Jack0468/ball_balance_video_controlled/host_software/ml_control/README.md

# ML Control

This directory contains experimental Machine Learning control policies, specifically focusing on Reinforcement Learning (RL) agents designed to balance the ball dynamically.

## Structure
- **`stm32_ctrl/`**: Work-in-progress code related to running inference or control loops on an STM32 microcontroller for ultra-low latency response.
