Jack0468/ball_balance_video_controlled/host_software/ml_jetson_vla/deployment/requirements-jetson-arm2-common.txt

# Arm 2 sweep, Jetson AGX Orin -- packages common to BOTH Arm 2 container images (2026-09-22, container
# pivot). Installed inside Dockerfile.arm2-transformers5 and Dockerfile.arm2-transformers4 (this
# directory), not a bare-metal venv -- see host_software/ml_jetson_vla/docs/JETSON_ARM2_SWEEP_LOCAL.md
# section 2. The earlier venv-based plan this file was originally written for is superseded: bare-metal
# wheel resolution failed repeatedly on-device this session (wrong wheel via --extra-index-url, a 20-30GB
# NGC image that exhausted disk), while `dustynv/l4t-pytorch:r36.4.0` gave a confirmed-working CUDA torch
# in one `docker run` with no bare-metal install at all. NOT a replacement for the root requirements.txt
# (never install that verbatim on the Jetson, see JETSON_ENV_SETUP.md); these packages are container-scoped
# and are not added to the root file either.
#
# NOT in this file, on purpose (each is handled by the Dockerfile itself, not a package list):
#   numpy              comes from the base image and is left exactly as it ships it. Each Dockerfile
#                      captures `pip freeze` of the base image as its first layer, BEFORE installing
#                      anything else, and installs everything below under that as a `-c` constraints file --
#                      pip can then only ADD packages, never silently upgrade numpy/torch/torchvision the
#                      way the bare-metal `lerobot` install once did (the ABI break in JETSON_ENV_SETUP.md).
#                      The old rule ("apt's python3-opencv needs numpy<2") was protecting a SHARED bare-metal
#                      host environment (Track 1's own numpy pin); that shared-environment risk does not
#                      exist inside an isolated container, so it is not reapplied verbatim here -- the real
#                      constraint, checked directly rather than assumed, is simply "don't move whatever
#                      numpy the base image already validated its CUDA torch build against."
#   torch/torchvision  already in the base image (confirmed: torch 2.4.0, `cuda.is_available()==True`, on
#                      this exact Jetson AGX Orin p3730, JetPack 6.2.3 / L4T r36.4). Neither this file nor
#                      either Dockerfile installs them.
#   opencv             NOT confirmed present in l4t-pytorch (a PyTorch-only image in the jetson-containers
#                      family; opencv is normally a separate stacked package there). Each Dockerfile checks
#                      for `cv2.aruco` first and pip-installs `opencv-contrib-python-headless` (under the
#                      base image's frozen numpy constraint, `--only-binary=:all:`) only if it's missing --
#                      see the Dockerfiles, not this file, for that step.
#
# HOW TO INSTALL: see Dockerfile.arm2-transformers5 / Dockerfile.arm2-transformers4 (this directory) and
# JETSON_ARM2_SWEEP_LOCAL.md section 2 for the exact build commands. Both Dockerfiles use the same
# `pip install -c <base image's own pip freeze> --only-binary=:all: -r <this file + the version-specific
# file>` form the old venv plan used -- the safety mechanism is unchanged, only the delivery vehicle is.
#
# Wheel availability, checked 2026-09-22 with `pip install --dry-run --report --python-version 3.10
# --implementation cp --abi cp310 --platform manylinux_2_17/2_28_aarch64 --only-binary=:all:` against PyPI
# (Ubuntu 22.04 = glibc 2.35): every package below, and every transitive dependency, resolves to a binary
# wheel for cp310 aarch64 -- av 17.x (manylinux_2_28, bundles ffmpeg), pandas 2.3.x (pandas 3 needs
# Python >= 3.11, so pip picks 2.3.x), pillow (manylinux_2_27/2_28), sentencepiece (manylinux_2_27),
# tokenizers / safetensors (abi3), psutil, PyYAML, regex, MarkupSafe. No --only-binary exception and no apt
# package is needed for any of them. (Wheel availability is not the same as "runs on the Orin": that is what
# the driver's probe/smoke stages are for.) Still expected to hold inside the container -- same aarch64
# cp310 target, same PyPI -- but not re-verified against the base image's exact pip/base-image date;
# `docker build` will fail loudly (not silently) if any wheel has since disappeared.

accelerate          # from_pretrained(device_map=...) for every candidate
qwen-vl-utils       # Qwen2.5-VL vision preprocessing (imports av + pillow + requests)
sentencepiece       # precautionary: Gemma tokenizer for PaliGemma2 (not proven strictly required)
av                  # PyAV: sequential rgb_video.mp4 decode (score_minimal_baseline_offline.read_frames_at_indices)
pandas              # telemetry.csv + result tables
pillow              # PIL.Image.fromarray in every backend

# torch's own runtime dependencies. The base image's torch build is expected to already carry these, but
# they are listed explicitly as a no-cost safety net (pip confirms-and-skips if already satisfied under the
# frozen constraints, installs from PyPI if genuinely missing). `pip check` at the end of each Dockerfile's
# install layer proves nothing is missing.
filelock
typing_extensions
sympy
networkx
jinja2
fsspec
