Jack0468/ball_balance_video_controlled/hardware/platform_templates/aruco_markers_00.pdf

Print at EXACTLY 100% scale. Do not ”Fit to Page”.

Cut along the outer black boundary (187.5 mm × 142.0 mm) and tape to the platform.
