Jack0468/ball_balance_video_controlled/host_software/ml_jetson_vla/docs/dependency_on_jetson_notes.md

## dependices on jetson download notes 

  Downloading transformers-5.3.0-py3-none-any.whl (10.7 MB)
     ━━━━━━━━━━━━━━━━━━━━━━━━━━━━━━━━━━━━━━━━ 10.7/10.7 MB 10.7 MB/s eta 0:00:00
  Downloading transformers-5.2.0-py3-none-any.whl (10.4 MB)
     ━━━━━━━━━━━━━━━━━━━━━━━━━━━━━━━━━━━━━━━━ 10.4/10.4 MB 11.9 MB/s eta 0:00:00
Collecting typer-slim
  Downloading typer_slim-0.24.0-py3-none-any.whl (3.4 kB)
Collecting transformers
  Downloading transformers-5.1.0-py3-none-any.whl (10.3 MB)
     ━━━━━━━━━━━━━━━━━━━━━━━━━━━━━━━━━━━━━━━━ 10.3/10.3 MB 8.3 MB/s eta 0:00:00
  Downloading transformers-5.0.0-py3-none-any.whl (10.1 MB)
     ━━━━━━━━━━━━━━━━━━━━━━━━━━━━━━━━━━━━━━━━ 10.1/10.1 MB 11.4 MB/s eta 0:00:00
  Downloading transformers-4.57.6-py3-none-any.whl (12.0 MB)
     ━━━━━━━━━━━━━━━━━━━━━━━━━━━━━━━━━━━━━━━━ 12.0/12.0 MB 11.8 MB/s eta 0:00:00
Collecting traitlets>=5.1
  Using cached traitlets-5.16.1-py3-none-any.whl (86 kB)
Collecting fastjsonschema>=2.15

  Downloading aiobotocore-2.6.0-py3-none-any.whl (73 kB)
     ━━━━━━━━━━━━━━━━━━━━━━━━━━━━━━━━━━━━━━━━ 73.4/73.4 KB 6.6 MB/s eta 0:00:00
  Downloading aiobotocore-2.5.4-py3-none-any.whl (73 kB)
     ━━━━━━━━━━━━━━━━━━━━━━━━━━━━━━━━━━━━━━━━ 73.4/73.4 KB 7.0 MB/s eta 0:00:00
INFO: pip is looking at multiple versions of s3fs to determine which version is compatible with other requirements. This could take a while.
Collecting s3fs>=2024.12.0
  Downloading s3fs-2025.10.0-py3-none-any.whl (30 kB)
  Downloading s3fs-2025.9.0-py3-none-any.whl (30 kB)

    Downloading s3fs-2025.2.0-py3-none-any.whl (30 kB)
  Downloading s3fs-2024.12.0-py3-none-any.whl (30 kB)
INFO: pip is looking at multiple versions of pyyaml-include to determine which version is compatible with other requirements. This could take a while.
INFO: pip is looking at multiple versions of python-xlib to determine which version is compatible with other requirements. This could take a while.
Collecting python-xlib>=0.17
  Downloading python_xlib-0.32-py2.py3-none-any.whl (181 kB)
     ━━━━━━━━━━━━━━━━━━━━━━━━━━━━━━━━━━━━━━━━ 181.9/181.9 KB 4.7 MB/s eta 0:00:00
  Downloading python_xlib-0.31-py2.py3-none-any.whl (179 kB)
     ━━━━━━━━━━━━━━━━━━━━━━━━━━━━━━━━━━━━━━━━ 179.0/179.0 KB 917.0 kB/s eta 0:00:00
INFO: pip is looking at multiple versions of python-multipart to determine which version is compatible with other requirements. This could take a while.
Collecting python-multipart>=0.0.26
  Downloading python_multipart-0.0.31-py3-none-any.whl (29 kB)
  Downloading python_multipart-0.0.30-py3-none-any.whl (29 kB)
INFO: pip is looking at multiple versions of pyperclip to determine which version is compatible with other requirements. This could take a while.
Collecting pyperclip>=1.9.0
  Downloading pyperclip-1.10.0-py3-none-any.whl (11 kB)
  Downloading pyperclip-1.9.0.tar.gz (20 kB)
  Preparing metadata (setup.py) ... done
INFO: pip is looking at multiple versions of pygments to determine which version is compatible with other requirements. This could take a while.
Collecting pygments>=2.7.2
  Downloading pygments-2.20.0-py3-none-any.whl (1.2 MB)
     ━━━━━━━━━━━━━━━━━━━━━━━━━━━━━━━━━━━━━━━━ 1.2/1.2 MB 1.6 MB/s eta 0:00:00
  Downloading pygments-2.19.2-py3-none-any.whl (1.2 MB)
     ━━━━━━━━━━━━━━━━━━━━━━━━━━━━━━━━━━━━━━━━ 1.2/1.2 MB 1.8 MB/s eta 0:00:00
INFO: pip is looking at multiple versions of pygit2 to determine which version is compatible with other requirements. This could take a while.
Collecting pygit2>=1.14.0
  Downloading pygit2-1.18.1-cp310-cp310-manylinux_2_27_aarch64.manylinux_2_28_aarch64.whl (5.8 MB)
     ━━━━━━━━━━━━━━━━━━━━━━━━━━━━━━━━━━━━━━━━ 5.8/5.8 MB 3.2 MB/s eta 0:00:00
  Downloading pygit2-1.18.0-cp310-cp310-manylinux_2_28_aarch64.whl (5.7 MB)
     ━━━━━━━━━━━━━━━━━━━━━━━━━━━━━━━━━━━━━━━━ 5.7/5.7 MB 3.5 MB/s eta 0:00:00
INFO: pip is looking at multiple versions of pydantic[email] to determine which version is compatible with other requirements. This could take a while.
Collecting pydantic[email]>=2.12.0
  Downloading pydantic-2.13.4-py3-none-any.whl (472 kB)
     ━━━━━━━━━━━━━━━━━━━━━━━━━━━━━━━━━━━━━━━━ 472.3/472.3 KB 12.4 MB/s eta 0:00:00
  Downloading pydantic-2.13.3-py3-none-any.whl (471 kB)
     ━━━━━━━━━━━━━━━━━━━━━━━━━━━━━━━━━━━━━━━━ 472.0/472.0 KB 12.4 MB/s eta 0:00:00
  Downloading pydantic-2.13.2-py3-none-any.whl (471 kB)
     ━━━━━━━━━━━━━━━━━━━━━━━━━━━━━━━━━━━━━━━━ 471.9/471.9 KB 12.6 MB/s eta 0:00:00
  Downloading pydantic-2.13.1-py3-none-any.whl (471 kB)
     ━━━━━━━━━━━━━━━━━━━━━━━━━━━━━━━━━━━━━━━━ 471.9/471.9 KB 12.2 MB/s eta 0:00:00
  Downloading pydantic-2.13.0-py3-none-any.whl (471 kB)
     ━━━━━━━━━━━━━━━━━━━━━━━━━━━━━━━━━━━━━━━━ 471.9/471.9 KB 14.4 MB/s eta 0:00:00
  Downloading pydantic-2.12.5-py3-none-any.whl (463 kB)
     ━━━━━━━━━━━━━━━━━━━━━━━━━━━━━━━━━━━━━━━━ 463.6/463.6 KB 13.4 MB/s eta 0:00:00
  Downloading pydantic-2.12.4-py3-none-any.whl (463 kB)
     ━━━━━━━━━━━━━━━━━━━━━━━━━━━━━━━━━━━━━━━━ 463.4/463.4 KB 13.5 MB/s eta 0:00:00
  Downloading pydantic-2.12.3-py3-none-any.whl (462 kB)
     ━━━━━━━━━━━━━━━━━━━━━━━━━━━━━━━━━━━━━━━━ 462.4/462.4 KB 14.6 MB/s eta 0:00:00
  Downloading pydantic-2.12.2-py3-none-any.whl (460 kB)
     ━━━━━━━━━━━━━━━━━━━━━━━━━━━━━━━━━━━━━━━━ 460.6/460.6 KB 14.3 MB/s eta 0:00:00
  Downloading pydantic-2.12.0-py3-none-any.whl (459 kB)
     ━━━━━━━━━━━━━━━━━━━━━━━━━━━━━━━━━━━━━━━━ 459.7/459.7 KB 12.3 MB/s eta 0:00:00
INFO: pip is looking at multiple versions of pydantic-settings to determine which version is compatible with other requirements. This could take a while.
Collecting pydantic-settings>=2.0.0
  Downloading pydantic_settings-2.14.2-py3-none-any.whl (61 kB)
     ━━━━━━━━━━━━━━━━━━━━━━━━━━━━━━━━━━━━━━━━ 61.7/61.7 KB 7.9 MB/s eta 0:00:00
INFO: pip is looking at multiple versions of s3fs to determine which version is compatible with other requirements. This could take a while.
INFO: pip is looking at multiple versions of pyyaml-include to determine which version is compatible with other requirements. This could take a while.
INFO: pip is looking at multiple versions of python-xlib to determine which version is compatible with other requirements. This could take a while.
INFO: pip is looking at multiple versions of python-multipart to determine which version is compatible with other requirements. This could take a while.
INFO: This is taking longer than usual. You might need to provide the dependency resolver with stricter constraints to reduce runtime. See https://pip.pypa.io/warnings/backtracking for guidance. If you want to abort this run, press Ctrl + C.
INFO: pip is looking at multiple versions of pyperclip to determine which version is compatible with other requirements. This could take a while.
  Downloading pydantic_settings-2.14.1-py3-none-any.whl (60 kB)
     ━━━━━━━━━━━━━━━━━━━━━━━━━━━━━━━━━━━━━━━━ 61.0/61.0 KB 5.1 MB/s eta 0:00:00
INFO: This is taking longer than usual. You might need to provide the dependency resolver with stricter constraints to reduce runtime. See https://pip.pypa.io/warnings/backtracking for guidance. If you want to abort this run, press Ctrl + C.
INFO: This is taking longer than usual. You might need to provide the dependency resolver with stricter constraints to reduce runtime. See https://pip.pypa.io/warnings/backtracking for guidance. If you want to abort this run, press Ctrl + C.
INFO: This is taking longer than usual. You might need to provide the dependency resolver with stricter constraints to reduce runtime. See https://pip.pypa.io/warnings/backtracking for guidance. If you want to abort this run, press Ctrl + C.
INFO: pip is looking at multiple versions of pygments to determine which version is compatible with other requirements. This could take a while.
  Downloading pydantic_settings-2.14.0-py3-none-any.whl (60 kB)
     ━━━━━━━━━━━━━━━━━━━━━━━━━━━━━━━━━━━━━━━━ 60.9/60.9 KB 5.2 MB/s eta 0:00:00
INFO: This is taking longer than usual. You might need to provide the dependency resolver with stricter constraints to reduce runtime. See https://pip.pypa.io/warnings/backtracking for guidance. If you want to abort this run, press Ctrl + C.
INFO: pip is looking at multiple versions of pygit2 to determine which version is compatible with other requirements. This could take a while.
  Downloading pydantic_settings-2.13.1-py3-none-any.whl (58 kB)
     ━━━━━━━━━━━━━━━━━━━━━━━━━━━━━━━━━━━━━━━━ 58.9/58.9 KB 5.5 MB/s eta 0:00:00
INFO: This is taking longer than usual. You might need to provide the dependency resolver with stricter constraints to reduce runtime. See https://pip.pypa.io/warnings/backtracking for guidance. If you want to abort this run, press Ctrl + C.
  Downloading pydantic_settings-2.13.0-py3-none-any.whl (58 kB)
     ━━━━━━━━━━━━━━━━━━━━━━━━━━━━━━━━━━━━━━━━ 58.4/58.4 KB 5.2 MB/s eta 0:00:00
  Downloading pydantic_settings-2.12.0-py3-none-any.whl (51 kB)
     ━━━━━━━━━━━━━━━━━━━━━━━━━━━━━━━━━━━━━━━━ 51.9/51.9 KB 4.3 MB/s eta 0:00:00
INFO: This is taking longer than usual. You might need to provide the dependency resolver with stricter constraints to reduce runtime. See https://pip.pypa.io/warnings/backtracking for guidance. If you want to abort this run, press Ctrl + C.
  Downloading pydantic_settings-2.11.0-py3-none-any.whl (48 kB)
     ━━━━━━━━━━━━━━━━━━━━━━━━━━━━━━━━━━━━━━━━ 48.6/48.6 KB 4.3 MB/s eta 0:00:00
INFO: pip is looking at multiple versions of pydantic[email] to determine which version is compatible with other requirements. This could take a while.
INFO: pip is looking at multiple versions of pydantic-settings to determine which version is compatible with other requirements. This could take a while.
  Downloading pydantic_settings-2.10.1-py3-none-any.whl (45 kB)
     ━━━━━━━━━━━━━━━━━━━━━━━━━━━━━━━━━━━━━━━━ 45.2/45.2 KB 3.9 MB/s eta 0:00:00
  Downloading pydantic_settings-2.10.0-py3-none-any.whl (45 kB)
     ━━━━━━━━━━━━━━━━━━━━━━━━━━━━━━━━━━━━━━━━ 45.2/45.2 KB 3.7 MB/s eta 0:00:00
  Downloading pydantic_settings-2.9.1-py3-none-any.whl (44 kB)
     ━━━━━━━━━━━━━━━━━━━━━━━━━━━━━━━━━━━━━━━━ 44.4/44.4 KB 3.6 MB/s eta 0:00:00
  Downloading pydantic_settings-2.9.0-py3-none-any.whl (44 kB)
     ━━━━━━━━━━━━━━━━━━━━━━━━━━━━━━━━━━━━━━━━ 44.3/44.3 KB 3.8 MB/s eta 0:00:00
  Downloading pydantic_settings-2.8.1-py3-none-any.whl (30 kB)
INFO: This is taking longer than usual. You might need to provide the dependency resolver with stricter constraints to reduce runtime. See https://pip.pypa.io/warnings/backtracking for guidance. If you want to abort this run, press Ctrl + C.
INFO: This is taking longer than usual. You might need to provide the dependency resolver with stricter constraints to reduce runtime. See https://pip.pypa.io/warnings/backtracking for guidance. If you want to abort this run, press Ctrl + C.
  Downloading pydantic_settings-2.8.0-py3-none-any.whl (30 kB)
  Downloading pydantic_settings-2.7.1-py3-none-any.whl (29 kB)
  Downloading pydantic_settings-2.7.0-py3-none-any.whl (29 kB)
  Downloading pydantic_settings-2.6.1-py3-none-any.whl (28 kB)
  Downloading pydantic_settings-2.6.0-py3-none-any.whl (28 kB)
  Downloading pydantic_settings-2.5.2-py3-none-any.whl (26 kB)
  Downloading pydantic_settings-2.5.1-py3-none-any.whl (26 kB)
  Downloading pydantic_settings-2.5.0-py3-none-any.whl (26 kB)
  Downloading pydantic_settings-2.4.0-py3-none-any.whl (23 kB)
  Downloading pydantic_settings-2.3.4-py3-none-any.whl (22 kB)
  Downloading pydantic_settings-2.3.3-py3-none-any.whl (22 kB)
  Downloading pydantic_settings-2.3.2-py3-none-any.whl (21 kB)
  Downloading pydantic_settings-2.3.1-py3-none-any.whl (21 kB)
  Downloading pydantic_settings-2.3.0-py3-none-any.whl (21 kB)
  Downloading pydantic_settings-2.2.1-py3-none-any.whl (13 kB)
  Downloading pydantic_settings-2.2.0-py3-none-any.whl (13 kB)
  Downloading pydantic_settings-2.1.0-py3-none-any.whl (11 kB)
  Downloading pydantic_settings-2.0.3-py3-none-any.whl (11 kB)
  Downloading pydantic_settings-2.0.2-py3-none-any.whl (11 kB)
  Downloading pydantic_settings-2.0.1-py3-none-any.whl (11 kB)
  Downloading pydantic_settings-2.0.0-py3-none-any.whl (11 kB)
Collecting pydantic>=2.9.2
  Downloading pydantic-2.14.0b2-py3-none-any.whl (484 kB)
     ━━━━━━━━━━━━━━━━━━━━━━━━━━━━━━━━━━━━━━━━ 484.6/484.6 KB 5.0 MB/s eta 0:00:00
INFO: pip is looking at multiple versions of pyasn1-modules to determine which version is compatible with other requirements. This could take a while.
Collecting pyasn1-modules>=0.2.1
  Downloading pyasn1_modules-0.4.1-py3-none-any.whl (181 kB)
     ━━━━━━━━━━━━━━━━━━━━━━━━━━━━━━━━━━━━━━━━ 181.5/181.5 KB 7.8 MB/s eta 0:00:00
  Downloading pyasn1_modules-0.4.0-py3-none-any.whl (181 kB)
     ━━━━━━━━━━━━━━━━━━━━━━━━━━━━━━━━━━━━━━━━ 181.2/181.2 KB 11.5 MB/s eta 0:00:00
  Downloading pyasn1_modules-0.3.0-py2.py3-none-any.whl (181 kB)
     ━━━━━━━━━━━━━━━━━━━━━━━━━━━━━━━━━━━━━━━━ 181.3/181.3 KB 11.2 MB/s eta 0:00:00
INFO: pip is looking at multiple versions of pyasn1-modules to determine which version is compatible with other requirements. This could take a while.
INFO: This is taking longer than usual. You might need to provide the dependency resolver with stricter constraints to reduce runtime. See https://pip.pypa.io/warnings/backtracking for guidance. If you want to abort this run, press Ctrl + C.
