Jack0468/ball_balance_video_controlled/host_software/ml_audio/docs/dataset_info_audio.md

## NOTES ON the SYNTHETIC+Real_image_dataset

OBSERVATION:
the dataset is corrupted

the following samples do not contain a full command:

e.g. "go"

en_US-lessac-medium__go_red__00071

e.g. does not have the completed signal of a label

"go re"
en_US-lessac-medium__go_red__00199
en_US-libritts_r-medium__go_red__00089
en_US-ryan-medium__go_red__00021
en_US-ryan-medium__go_red__00063

"red"

en_US-lessac-medium__go_red__00535
en_US-lessac-medium__go_red__00580

"empty clip"

real_speaker02__go_red__speaker02__go_red__001_018
real_speaker02__go_red__speaker02__go_red__002_002
real_speaker02__go_red__speaker02__go_red__002_006
