Jack0468/ball_balance_video_controlled/host_software/ml_audio/docs/plans/audio_eval_notebook_refactor_plan.md

# Audio Evaluation & Notebook Refactor Plan

## Data & Checkpoint Location (updated 2026-09-15: DVC is now live, superseding the section below)

**Corrected, superseding claim:** an earlier version of this section said the training dataset and every checkpoint were "0% tracked in git" with Drive as the de facto source of truth. That was accurate as of when it was written but is now stale -- a separate session (`vri-2026-be`) wired up DVC against the home server's MinIO remote (commit `e423e4a`), and `host_software/ml_audio/data.dvc` + `host_software/ml_audio/models.dvc` are now real, git-tracked pointer files (confirmed via `git ls-files`, not assumed from the commit message alone). `dvc pull host_software/ml_audio/data` on any machine with Tailscale + MinIO credentials now fetches the real ~20K-clip `training_v2/` dataset and every checkpoint the pointer was last updated against -- git alone is no longer missing the data, DVC is the actual fetch mechanism. `colab_nemo_finetune.ipynb` was updated in the same commit to `git clone` + Tailscale-bootstrap + `dvc pull` instead of the old `prepare_colab_package.py` zip-to-Drive flow (verified: cell 7's `HOST_SOFTWARE_DIR`/`sys.path` setup matches the old zip-extraction cell's variable names exactly, so every downstream import in this notebook, including this plan's `nemo_noise_manifest.py` addition, resolves unchanged). `drive.mount()` is kept only for the Lightning `ModelCheckpoint` crash-resilience path, not for data. Full policy: `docs/DATA_STORAGE.md`.

**`prepare_colab_package.py` is not dead code -- confirmed by checking, not assumed.** `colab_nemo_phase0_verification.ipynb` never touched the dataset at all (Phase 0 only exercises the stock pretrained checkpoint on dummy audio) so it's unaffected either way. `colab_augmentation_sweep.ipynb` (custom-CNN track) still imports the zip/Drive flow and has not been migrated to DVC -- it's still a live caller, so `prepare_colab_package.py` should stay until/unless that notebook is migrated too, which is a separate decision (that track is already deprioritized behind the NeMo track per the Verdict above, so there's no urgency either way).

**Open item, still not resolved by any of the above:** `updated dataset.zip` (repo root of `ml_audio/`, git-tracked directly -- not DVC -- committed 2026-07-24, before this plan's work started) is still raw `speaker02` source recordings, almost certainly the raw material behind the `real_speaker02__*` clips already baked into `training_v2/`. DVC going live doesn't resolve this on its own -- it's a plausible destination for this file once someone actually does the dedicated data-management pass the user deferred, not a reason to move it unilaterally now.

## Status
**The pretrained-backbone track has produced the best checkpoint in this entire plan, on both metrics that matter.** [`models/nemo_matchboxnet_v1/`](../../models/nemo_matchboxnet_v1/) (NeMo MatchboxNet, transfer-learned on our dataset -- see "Pretrained Backbone / Transfer Learning Track" below) hit 95.75% offline accuracy with no class collapse anywhere (including `go_red` at 94.6%, the class that kept collapsing in the custom-CNN track), and then **9/11 on the live-stream test** -- blowing past the 6/11 ceiling every custom-CNN checkpoint (v3-v7) hit, with `forward`/`left`/`right` all correctly detected simultaneously for the first time anywhere in this plan. This is the first checkpoint where live-stream performance is unambiguously better rather than diverging from offline accuracy, strong evidence the custom 13.5K-param CNN's capacity -- not the dataset/preprocessing work -- was the real ceiling all along.

Everything that came before this remains real, measured work, not superseded busywork: corruption audit + quarantine, evaluation-script extraction, the live receiver's label-order + preprocessing fixes, a full multi-seed Colab tuning sweep (v4 -> v5 -> v6), and closing the domain gap with real recordings (v7, 3 seeds, which confirmed a repeatable `go_red`/`hold` capacity-thrashing regression) are what led directly to trying a pretrained backbone in the first place.

**Update: the pretrained-backbone track's own 4-seed multi-seed check is now done too** (see "Live-Stream Result" below) -- `go_green` (confused with `go_grey`) and `backward` are confirmed real, repeatable weaknesses (4/4 seeds), not the single-run luck the original 9/11 result left open. `go_grey` itself has since been dropped from live-stream scoring entirely (the current robot deployment has no grey marker to test against) -- live-stream is now scored out of 10, not 11. **v4 remains the interim hardware recommendation** until the NeMo checkpoint clears its remaining open items: TensorRT/Jetson latency validation (not yet started), and a fix for the confirmed `go_green`/`backward` weaknesses (larger pretrained variant and/or noise-mixing our own recordings into fine-tuning are the two candidate next moves, not further seed-hunting). Building the training script also surfaced an important correction to an assumption made earlier in this same plan: see "Correction: the conv/batchnorm layers are NOT frozen/shared across checkpoints" below. Companion to [`.agents/agent_ml_audio.md`](../../../../.agents/agent_ml_audio.md).

## Context

`host_software/ml_audio/` was reactivated under Roadmap Phase 2 ("Audio Verification") to debug the known false-positive-on-background issue. Previously there was no persisted confusion matrix or evaluation artifact anywhere in the module — the team ran evaluation ad hoc inside a notebook and read the plot off-screen. On 2026-08-11 a run was captured (image, reproduced below as a table) that gives us the first real evidence to work from instead of impressions.

The evaluation method that produced this run lives in **`audio_command_classifier_aligned_before_deterministic_patch_final.ipynb`** — a single monolithic notebook (~3 MB, authored by a former lab partner) that combines dataset loading, augmentation, model definition, the training loop, and confusion-matrix generation (`tf.math.confusion_matrix`) in one file with no persisted output. This plan proposes breaking it apart, in the same spirit as the modular `core/` / `data_processing/` / `training/` / `evaluations/` / `tests/` / `docs/` convention already codified for `ml_vision` in `.agents/AGENTS.md`.

**Discrepancy, now resolved.** a prior read-only pass over this notebook found it hard-coded to exactly 6 classes (`["go_red","go_blue","go_green","go_yellow","hold","stop"]`, no `_background_`) and set to raise `ValueError` on any other label layout. The confusion matrix above is 12-class (includes `_background_`, `backward`, `forward`, `go_grey`, `left`, `right`). We now know why: the **12-class model and the large dataset that trained it (`data/synthetic+real_dataset_large/`) were produced by a *different, second* former lab partner's code — not the notebook above, and not the same person.** That generation code is not present in the repo and is not expected to surface.

**Decision: the dataset's on-disk file structure IS the ground truth, not a stand-in for missing code.** There is no script to locate or reconstruct — `data_processing/` will treat `synthetic+real_dataset_large/training_v2/{train,val}/<class_name>/*.wav` (12 class folders) directly as the contract to preserve and build tooling around. Do not extract/refactor code from the 6-class notebook as if it were the source of the 12-class run — the two are unrelated artifacts from two different people and both stay as read-only ground truth.

## Confusion Matrix — 2026-08-11 run (acc = 0.870, row-normalized)

Rows = true label, columns = predicted label, raw counts:

| true \ pred | _background_ | backward | forward | go_blue | go_green | go_grey | go_red | go_yellow | hold | left | right | stop | row total |
|---|---|---|---|---|---|---|---|---|---|---|---|---|---|
| **_background_** | 151 | 5 | 3 | 9 | 5 | 1 | 8 | 4 | 10 | 13 | 23 | 8 | 240 |
| **backward** | 1 | 117 | 0 | 0 | 0 | 0 | 1 | 0 | 1 | 0 | 0 | 0 | 120 |
| **forward** | 6 | 0 | 89 | 0 | 0 | 4 | 1 | 0 | 17 | 0 | 0 | 3 | 120 |
| **go_blue** | 0 | 0 | 0 | 222 | 17 | 1 | 0 | 0 | 0 | 0 | 0 | 0 | 240 |
| **go_green** | 1 | 0 | 0 | 1 | 238 | 0 | 0 | 0 | 0 | 0 | 0 | 0 | 240 |
| **go_grey** | 0 | 0 | 0 | 0 | 0 | 117 | 3 | 0 | 0 | 0 | 0 | 0 | 120 |
| **go_red** | 4 | 0 | 0 | 0 | 61 | 2 | 161 | 4 | 8 | 0 | 0 | 0 | 240 |
| **go_yellow** | 0 | 0 | 1 | 0 | 0 | 0 | 0 | 239 | 0 | 0 | 0 | 0 | 240 |
| **hold** | 1 | 0 | 35 | 0 | 0 | 3 | 0 | 0 | 195 | 0 | 0 | 0 | 234 |
| **left** | 1 | 1 | 0 | 0 | 0 | 2 | 0 | 0 | 2 | 113 | 0 | 1 | 120 |
| **right** | 0 | 0 | 1 | 0 | 0 | 6 | 0 | 0 | 3 | 0 | 110 | 0 | 120 |
| **stop** | 11 | 1 | 0 | 0 | 0 | 1 | 0 | 0 | 0 | 0 | 0 | 227 | 240 |

## Analysis — three distinct failure clusters, do not conflate

1. **Background leaks into movement commands (the reported issue, now quantified).** True `_background_` recall is only 151/240 = **62.9%** — over a third of background clips (89/240) get classified as some command. The leakage is not evenly spread: `right` (23), `left` (13), and `hold` (10) absorb most of it, while `go_grey`, `go_green`, `go_yellow` barely attract any background at all. This is the operationally dangerous case — ambient/robot noise producing an unintended motion command — and is consistent with the earlier finding that background training data is only ~9.5% of the train set, sourced from just 4 raw recordings. It does **not** explain clusters 2–3 below.

2. **`go_red` → `go_green` confusion (61/240 = 25.4%). Root cause now confirmed: dataset corruption, not feature-space overlap or mislabeling.** Large, specific, and one-directional (green does not reciprocally get called red — only 1/240 `go_green` errors exist). A manual audit ([`docs/dataset_info_audio.md`](../dataset_info_audio.md)) found the `go_red` folder in `synthetic+real_dataset_large/` contains **truncated and empty clips still labeled `go_red`** — samples containing only partial utterances ("go", "go re", "red") or no speech at all, across both synthetic TTS voices and real recordings. The label itself isn't wrong (these clips were genuinely intended as `go_red` commands), but the audio content is broken — training on truncated/empty "go_red" clips degrades that class's learned decision boundary, which is a direct, sufficient explanation for elevated `go_red` misclassification. This is unrelated to background balance and does not need a feature-space investigation — it needs a data-quality fix. See the new section below.

3. **`forward` ↔ `hold` bidirectional confusion** (`forward`→`hold` 17/120 = 14.2%; `hold`→`forward` 35/234 = 15.0%). Also independent of background balance — these two command classes appear to sit close together in feature space.

Minor, lower-priority: `go_blue` → `go_green` (17/240 = 7.1%, one-directional).

**Conclusion:** the background-noise/matched-filter fix (more diverse background sources, rebuilt noise profile — see prior planning discussion) should measurably improve cluster 1; the `go_red`/`go_green` fix is now a dataset-cleanup task (see below), not a training or architecture change; cluster 3 (`forward`/`hold`) remains unexplained and should get the same corruption audit before assuming it's a genuine feature-space problem. Track all three separately so a fix for one isn't mistaken for a fix for all.

## Dataset Corruption: `synthetic+real_dataset_large`

[`docs/dataset_info_audio.md`](../dataset_info_audio.md) documents a manual audit finding **the dataset is corrupted**, so far confirmed in the `go_red` class:

- **Truncated commands** — clips cut off mid-word or mid-phrase but still filed under the full `go_red` label, e.g. only "go" (`en_US-lessac-medium__go_red__00071`), only "go re" (`en_US-lessac-medium__go_red__00199`, `en_US-libritts_r-medium__go_red__00089`, `en_US-ryan-medium__go_red__00021`, `en_US-ryan-medium__go_red__00063`), or only "red" (`en_US-lessac-medium__go_red__00535`, `en_US-lessac-medium__go_red__00580`).
- **Empty clips** — no speech content at all, still labeled `go_red` (`real_speaker02__go_red__speaker02__go_red__001_018`, `..._002_002`, `..._002_006`).

**Dataset composition, inferred from filenames:** the `en_US-<voice>-medium` prefixes (`lessac`, `libritts_r`, `ryan`) are Piper TTS voice model names — so the "synthetic" half of `synthetic+real_dataset_large` is machine-generated speech from at least 3 distinct TTS voices. The `real_speakerNN` prefixes are recordings from actual human speakers (at least `speaker02` confirmed so far). This matches the `synthetic+real_dataset_large` directory name and matters for remediation: synthetic clips can likely be **regenerated cleanly** from the same TTS voice/text (fixing the corruption at the source), while corrupted real-speaker clips can only be **dropped or re-recorded**, not regenerated.

**Full-dataset audit complete (2026-08-11).** Built [`data_processing/audit_dataset_corruption.py`](../../data_processing/audit_dataset_corruption.py), which reuses the exact energy-gate thresholds from the production inference path (`align_speech_to_fixed_length` in `audio_receiver_pytorch.py`: `peak < 0.03` or `rms < 0.003` ⇒ "empty") for consistency, plus a per-class statistical-outlier check on active-speech duration (robust z-score via MAD) to catch truncation candidates without needing a transcript/ASR. Ran it across all 12 classes, both `train` and `val` (19,131 clips total). Full report: [`data_processing/reports/dataset_corruption_audit.json`](../../data_processing/reports/dataset_corruption_audit.json).

**Result: the "same kind of corruption throughout the dataset" hypothesis is not confirmed — it's concentrated, not uniform.** 367/19,131 clips flagged (1.9% overall), but split very unevenly:

| Class (train) | Total | Empty | Truncated | % flagged |
|---|---|---|---|---|
| `go_red` | 2100 | 82 | 22 | **5.0%** |
| `stop` | 2100 | 50 | 31 | **3.9%** |
| `hold` | 2094 | 56 | 2 | 2.8% |
| `go_blue` | 2100 | 4 | 0 | 0.2% |
| `left` | 600 | 0 | 2 | 0.3% |
| `backward`, `forward`, `go_green`, `go_grey`, `go_yellow`, `right` | — | 0 | 0 | **0%** |

(`val` split mirrors this pattern at smaller scale: `go_red` 1 empty, `left` 4 truncated, everything else clean. Full per-class table in the JSON report.)

So: `go_red` is confirmed as the worst offender (matches the manual audit and explains the confusion-matrix finding), `stop` and `hold` carry real but smaller corruption, and **6 of the 12 command classes have zero flagged clips**. This means the `go_red`↔`go_green` cluster is explained by `go_red`'s corruption specifically — `go_green` itself is clean, consistent with the one-directional confusion pattern already observed. It also means cluster 3 (`forward`/`hold`) is only *partly* explained: `hold` does carry some corruption (2.8%) but `forward` has none at all, so that confusion is more likely a genuine feature-space issue after all, not primarily a data defect — worth retesting after `hold`'s corrupted clips are cleaned, but don't expect it to fully close.

**One important caveat on `_background_`:** it also flagged high on the "empty" check (96/1290 train, 17/240 val, ~7.4%) — but this is a different phenomenon from the `go_red`-style defect, not the same corruption. A near-silent clip labeled `_background_` isn't mislabeled or broken the way a truncated `go_red` clip is; if anything it's *too* correct — real background noise during robot operation is not silent, so a background class skewed toward near-silence undertrains the model on the actual failure condition (concurrent motor/typing/impact noise). Track this under the background-diversification thread (`Larger Background/Noise-Profile Source` section below), not as dataset corruption to remediate the same way.

**Remediation applied (2026-08-11): quarantine, not regeneration.** Piper TTS (needed to regenerate the synthetic clips cleanly) isn't installed in the project env, and installing it plus downloading the 3 specific voice models (`lessac`, `libritts_r`, `ryan`) was judged disproportionate to fixing 1.9% of the dataset — so we quarantined instead of regenerated. [`data_processing/apply_dataset_quarantine.py`](../../data_processing/apply_dataset_quarantine.py) moved the 254 flagged non-background clips out of `training_v2/{split}/{label}/` into a sibling `data/synthetic+real_dataset_large/_quarantined_corrupt/{split}/{label}/` tree (move, not delete — reversible). `_background_` clips were explicitly excluded, per the caveat above. Manifest: [`data_processing/reports/quarantine_manifest.json`](../../data_processing/reports/quarantine_manifest.json).

| Class | Quarantined (train) | Quarantined (val) |
|---|---|---|
| `go_red` | 104 | 1 |
| `stop` | 81 | 0 |
| `hold` | 58 | 0 |
| `go_blue` | 4 | 0 |
| `left` | 2 | 4 |

**Verified clean:** re-ran `audit_dataset_corruption.py` after quarantine — every command class now scans at 0 empty / 0 truncated (18,877 clips remaining, only the untouched 113 `_background_` flags remain, tracked separately as above). Dataset is ready to retrain against once `training/train_audio_command_classifier.py` exists (step 3 below).

If 1:1 dataset-size restoration ever becomes worth it, the deferred option is: install `piper-tts`, download the matching voice checkpoints, and regenerate synthetic clips from source voice/text for the quarantined `en_US-<voice>-medium` files; quarantined `real_speakerNN` files can only be dropped or re-recorded, not regenerated. Not pursued now — re-run evaluation after retraining first to see whether it's even needed.

`audit_dataset_corruption.py` and `apply_dataset_quarantine.py` now live in `data_processing/` as standing QC/cleanup scripts — wire the audit check into the ingestion pipeline during step 4 of the refactor below so this doesn't silently recur as the dataset grows.

## Larger Background/Noise-Profile Source: 23-Minute Lab Recording

There is a longer general-lab-sounds recording available — roughly 23 minutes, currently unlabeled — that is a much richer background source than the short clips the noise profile and background training class currently draw from. **Confirmed: this is a new sample, not yet integrated into the dataset before** — distinct from `data/01_background_noise/lab_background_sound_01.wav` and the other existing files already in that directory. Those existing files were themselves recorded on different days, so `01_background_noise/` already has some session-level diversity going for it; the 23-minute recording is an additional, larger source to bring in on top of that, not a replacement or duplicate of anything already there.

It is not labeled at the granularity the classifier needs (i.e., not chopped into fixed-length clips with a class), but it can be:

- **Segment** it into fixed-length windows matching the model's input clip length (same framing the existing `_background_` clips use), producing many more background training/eval samples than the current ~1,290-clip pool.
- **Label at the segment level, not as one blanket clip.** A 23-minute "general lab sounds" recording almost certainly contains a mix of sub-conditions (silence/room tone, talking, footsteps, door/HVAC noise, equipment hum, possibly incidental typing or bench-work sounds). Spot-review segments and tag them — this doesn't require new *model* classes (per the earlier ball-drop/typing discussion, everything here still collapses to the single `_background_` class for training), but sub-tagging lets the eventual `evaluations/` tooling report background accuracy broken out by noise sub-type, which is exactly the resolution needed to tell whether the background fix is working uniformly or only on the easy cases.
- **Fold into, not replace, the existing sources** — it adds a new session/environment to the pool; the existing multi-day recordings stay in the mix too.

This work belongs in the `data_processing/` extraction (step 4 below), since it's dataset assembly, not a model or eval change.

## Evaluation Extraction — Done, and a New Finding: Production Preprocessing Doesn't Match Training/Eval

Built [`evaluations/evaluate_audio_classifier.py`](../../evaluations/evaluate_audio_classifier.py): loads `models/pytorch_v3/audio_command_classifier_state_dict_v3.pth` + `labels.json`, runs the val split, persists both raw counts (JSON) and a rendered heatmap (PNG) to `evaluations/reports/` on every run instead of vanishing off a screen. This closes the reproducibility gap that made the original confusion matrix un-followup-able.

**Getting it to reproduce the known acc=0.870 baseline surfaced a real bug, found by direct A/B testing.** The live inference path (`audio_receiver_pytorch.py`) diverges from how this model was actually trained/evaluated on four points simultaneously:

| Divergence | Effect on measured accuracy |
|---|---|
| `audio_receiver_pytorch.py` hardcodes its own 12-class label order, which is **not alphabetical** | Using it to interpret predictions collapses accuracy to ~7% |
| `align_speech_to_fixed_length`'s active-region crop (built for finding speech in a noisy rolling live buffer) | Costs ~7 points when applied to already-isolated, pre-cut dataset clips |
| Peak-renormalizing each clip to 0.95 | Costs ~2-3 points |
| Applying the spectral-subtraction noise profile at all | Costs ~30-40 points — it looks tuned for live mic/robot-noise, not clean dataset audio |

`models/pytorch_v3/labels.json` **is** alphabetical (the standard convention for scanning class folders — matches how the dataset folders are actually named/sorted), so it's the correct order; the receiver's hardcoded list is not. Reverting all four to the simple/matching form (`evaluate_audio_classifier.py`'s current defaults: alphabetical labels, direct pad/truncate, no renormalization, no noise profile) reproduces **86.3%** against the recorded 0.870 baseline — the ~0.7pt gap is fully explained by the 5 val clips removed during quarantine, not a remaining methodology error.

**This is a separate, likely-significant finding, not a data-quality issue:** if the deployed receiver really is decoding a 12-class checkpoint with the wrong label order and/or degrading input with the wrong preprocessing, that's a strong independent candidate explanation for "produces incorrect outputs during concurrent robot operation" — arguably more directly than the background-class imbalance this whole effort started from. Needs a decision on priority (see Open Questions).

**Caveat on the go_red/go_green numbers from this run:** this evaluation still used the original `v3` checkpoint, trained before the corruption quarantine — the quarantine only removed 254 clips from `training_v2` (mostly from `train`; only 1 `go_red` clip was in `val`), and training hasn't happened yet. Any change in the `go_red`/`go_green` split seen in this run's output vs. the original matrix reflects the corrected *evaluation methodology*, not the corruption fix. The corruption fix can only be measured once step 4 (training extraction + retrain) is done and this same evaluation script is re-run.

## Stage 1 Fix (Done): Label-Order Bug in the Live Receiver

Per the priority call above, tackled the smaller/unambiguous fix first, measured it, then moved to the bigger retrain track (step 4+). The label-order bug was a clean, low-risk fix (unlike the crop/renorm/noise-profile questions, which involve real design trade-offs for live streaming vs. offline clips and weren't touched here).

**Fix:** [`audio_receiver_pytorch.py`](../../audio_receiver_pytorch.py)'s `AudioCommandReceiver.__init__` now loads `labels.json` from the same directory as whatever checkpoint `model_path` points to, and uses that as the authoritative class order — matching how the model was actually trained (alphabetical, from scanning dataset class folders) instead of the hand-maintained list that had drifted out of sync for the 12-class case. Falls back to corrected (now-alphabetical) hardcoded lists only if no sibling `labels.json` exists, for older checkpoints that don't ship one. Confirmed the 7-class hardcoded fallback was already correct — only the 12-class one had drifted.

**Measured impact (same checkpoint, same otherwise-unchanged production-style preprocessing — active-region crop, peak renormalization, and spectral-subtraction noise profile all still applied, on val split):**

| Stage | Label order | Accuracy |
|---|---|---|
| Before (the bug) | receiver's hardcoded (wrong) order | 7.4% (169/2269) |
| After (this fix) | alphabetical, from `labels.json` | 47.9% (1086/2269) |

**+40.5 points from this one fix alone**, with everything else about the production pipeline untouched. Confirms this was a real, live bug — not just an artifact of the offline evaluation methodology — and that it was likely a significant contributor to "incorrect outputs during concurrent robot operation" on its own.

**Not yet closed:** 47.9% is still far below the 86.3% achieved with the idealized offline pipeline (no crop, no renorm, no noise profile). That gap is the second, harder piece — the crop/renorm/noise-profile mismatch — which is the next thing to work through, likely in tandem with the retrain track below rather than as a quick fix, since it involves an actual design decision (see Open Questions).

## Stage 2 Fix (Done, but Did Not Close the Real Gap): Simplify Live Preprocessing to Match Training

Decision: simplify the live receiver to match training (rather than retrain to match the receiver's crop/renorm/noise-profile pipeline). Implemented in [`audio_receiver_pytorch.py`](../../audio_receiver_pytorch.py): `_process_loop` now feeds the rolling audio buffer straight to `waveform_to_spectrogram` with no `align_speech_to_fixed_length` crop, no peak renormalization, and no noise-profile subtraction — the noise-profile loading code in `__init__` was removed outright rather than left dead. `min_confidence`/`min_margin` gating stays; that's a downstream accept/reject decision, not a preprocessing step, and doesn't need to match training.

**Cross-check before implementing:** `final_tester_audio.py`, a separate/legacy self-contained script, comments that its own crop+renormalize step is "same as the bronze -> silver step that built the train set" — which would have argued against this fix. Checked it before proceeding: its STFT uses n_fft=256 (129 freq bins), not the 255/128-bin convention `generate_noise_profile.py` and `audio_receiver_pytorch.py` actually use — even though its model class shapes are checkpoint-compatible with `v3.pth`. Since my empirical A/B testing already reproduced the known 0.870 baseline using the 255/128 convention (impossible if that convention were actually wrong, per how badly the wrong label order tanked accuracy), treated that comment as an unverified assumption from a disconnected/earlier script rather than counter-evidence, and proceeded.

**Offline per-clip result:** using this exact simplified pipeline is what already produced 86.3% in the evaluation-extraction section above (`evaluate_audio_classifier.py`'s defaults now match `_process_loop` exactly).

**Live continuous-stream result: only 4/11 (36%).** Built [`evaluations/evaluate_live_receiver_stream.py`](../../evaluations/evaluate_live_receiver_stream.py), which drives the actual `AudioCommandReceiver` (not a reimplementation) through `data/02_silver/master_evaluation_audio.wav` in its real file-playback mode — the same 11-command-at-10s-intervals sequence `create_master_audio.py` built, overlaid on looped background noise. Report: `evaluations/reports/live_stream_eval_20260811T033925Z.json`.

| t | expected | detected |
|---|---|---|
| 0s | go_grey | *(miss)* |
| 10s | go_blue | go_blue ✓ |
| 20s | go_green | *(miss)* |
| 30s | go_yellow | go_yellow ✓ |
| 40s | go_red | go_red ✓ |
| 50s | forward | *(miss)* |
| 60s | left | *(miss — detected go_red instead, a real misclassification)* |
| 70s | right | *(miss)* |
| 80s | backward | *(miss)* |
| 90s | hold | *(miss)* |
| 100s | stop | stop ✓ |

Looking at every command the receiver latched across the full 120s (not just the 11 target windows): it output `_background_` almost continuously — dozens of times throughout, including during windows where a command word is clearly present — with only 5 non-background detections in the entire stream. This is not a preprocessing-pipeline problem anymore; it's the original background-class issue this whole investigation started from (see "Background leaks into movement commands" in the confusion-matrix analysis above), now showing up directly: `master_evaluation_audio.wav` mixes background noise under every command, continuously, which is the realistic operating condition — and the model, trained on a background class that's only ~9.5% of the data from 4 source recordings, isn't robust to command-plus-noise mixtures at all. It defaults to background almost everywhere.

**Conclusion: Stage 1 + Stage 2 fixed two real, confirmed bugs (wrong label order, mismatched preprocessing) and both were worth fixing, but neither is the dominant lever on real-world performance.** The 86.3% clean-clip number was necessary to establish as a correct baseline, but it doesn't predict live behavior — noisy-condition performance is bottlenecked by the background-training-data problem identified back in the corruption/background-diversification sections. That makes the retrain track (steps 4-7, especially the background-diversification work with the 23-minute recording) the load-bearing fix, not an optional follow-on. Re-run `evaluate_live_receiver_stream.py` after that retrain to see if this closes.

## Correction: the conv/batchnorm layers are NOT frozen/shared across checkpoints

Before building the training script, the working assumption (based on `AudioCommandClassifier` in `audio_command_classifier_pytorch.py` registering its three conv/batchnorm blocks as `register_buffer` rather than `nn.Parameter`, with `forward()` always calling `F.batch_norm(..., training=False)`) was that these layers are a **frozen feature extractor exported once from the original 6-class model and reused unchanged across every checkpoint** — i.e. that the 12-class v3 checkpoint only differs from the 6-class original in its dense head, and "training" a new checkpoint would just mean fitting a linear classifier on top of those frozen 48-dim pooled features.

**This is false, and was caught by a round-trip check before it wasted a training run.** Direct comparison of `models/pytorch_v3/audio_command_classifier_state_dict_v3.pth` against the constants baked into `audio_command_classifier_pytorch.py` shows every conv/batchnorm buffer differs substantially, not just the dense head — e.g. `norm_variance` off by 21.9, `conv1_weight` off by 0.54 max-abs, `bn3_gamma` off by 1.5. Confirmed conclusively: applying v3's own trained dense head to features extracted from the *untouched baked-in* conv/bn buffers gives ~10% accuracy, vs. v3's real 86.3%. So whatever process produced v3 trained (or fine-tuned) the entire network, not just a dense head — consistent with the plan's existing finding that the 12-class checkpoint came from a second, unlocated lab partner's code, not the 6-class notebook's.

**Practical consequence:** `AudioCommandClassifier` itself can't be trained directly either way — it has no parameters, only buffers, and its BN is hardcoded to eval-mode. [`training/train_audio_command_classifier.py`](../../training/train_audio_command_classifier.py) defines a parallel `TrainableAudioCommandClassifier` module (real `nn.Conv2d`/`nn.BatchNorm2d`/`nn.Linear` layers, identical channel counts/kernel sizes/resize-to-64x64/global-average-pool architecture), trains it with standard backprop, then exports into `AudioCommandClassifier`'s buffer-keyed state-dict format — a drop-in-compatible checkpoint requiring zero changes to `evaluate_audio_classifier.py` or `audio_receiver_pytorch.py`.

**A second bug caught the same way, before it silently produced a wrong checkpoint:** the initial trainable-model draft used the conventional Conv→BatchNorm→ReLU layer order. `AudioCommandClassifier.forward()` actually applies **Conv→ReLU→BatchNorm** (unusual, but real — verified by reading the exact line order). A round-trip test (train a few real gradient steps, export, reload into `AudioCommandClassifier`, compare outputs on the same input) passed at first only because an *untrained* model's BN is near-identity, masking the ordering bug; re-running the same check after real gradient steps exposed a ~0.05 max-abs output divergence, which went to exactly 0.0 once the layer order was corrected to match. Lesson for any future work on this file: validate round-trip export/import fidelity **after** the model has actually been trained a few steps, not just on freshly-initialized weights — identity-initialized BN hides ordering bugs that only show up once its running stats move away from the default.

### Retrain results

**v4 — quarantine-cleaned dataset, no background diversification yet.** Trained from scratch (random init, 60 epochs, Adam, plain cross-entropy, no augmentation or class weighting — deliberately kept simple per the migration principle) on the same `training_v2/{train,val}` layout used throughout this plan, i.e. the corruption-quarantined dataset. Best val accuracy during training: 83.5% (epoch 38 of 60; train accuracy saturates near 100% by ~epoch 30, val bounces 73–83% after that — some overfitting, no early-stopping/regularization tuning attempted yet, this was a first-pass "does the pipeline work end-to-end" run, not a tuned one).

| Metric | v3 (pre-quarantine, old training code) | v4 (post-quarantine, this retrain) |
|---|---|---|
| Offline val accuracy (`evaluate_audio_classifier.py`) | 86.3% | 83.5% |
| Live-stream detections (`evaluate_live_receiver_stream.py`) | 4/11 | **6/11** |
| `_background_` recall | 62.9% (151/240) | **72.5%** (174/240) |
| `forward` recall | 74.2% | **92.5%** |
| `hold` recall | 83.3% | 62.0% (regressed) |
| `go_red` recall | 67.1% | 50.2% (regressed) |
| `go_red`→`go_green` rate | 25.4% | 17.2% (improved) |

Mixed at the per-class level — `hold` and `go_red` recall both regressed despite the corruption cleanup, likely because this is a from-scratch retrain with a much simpler/less-tuned procedure than whatever produced v3, not an apples-to-apples "same training, cleaner data" comparison. But the metric the plan has been chasing since the live-stream test was built — real detections in a continuous noisy stream — improved from 4/11 to 6/11, and just as importantly the failure mode changed: v3 had one outright *misclassification* (t=60s detected `go_red` instead of `left`); v4 has none — every miss is now "no detection" (background wins), not a wrong command. Full per-clip counts: [`evaluations/reports/confusion_matrix_20260811T092401Z.json`](../../evaluations/reports/confusion_matrix_20260811T092401Z.json); live-stream detail: [`evaluations/reports/live_stream_eval_20260811T101639Z.json`](../../evaluations/reports/live_stream_eval_20260811T101639Z.json).

### Background composition, quantified

Before segmenting the 23-minute recording, checked what the existing `_background_` class actually contains by filename convention (`bgreal_<source>__<split>__NNNNNN.wav` for real recordings vs. `<piper-voice>___background___NNNNN.wav` for synthetic TTS renders). Confirms and sharpens the plan's earlier "~9.5% of train set, from 4 raw recordings" estimate:

- Of 1290 train `_background_` clips, only **90 (7%)** are real recordings, and they come from just **2** source files (`robot_background_sound.wav`, `robot_background_sound_01.wav`), not 4.
- Of 240 val `_background_` clips, **zero** are real recordings — the entire val-set measurement of background recall (used throughout this plan, e.g. the 62.9%/72.5% figures above) has never once been tested against real ambient/robot noise, only near-silent synthetic TTS renders.
- `lab_background_sound_01.wav` — confirmed 23.3 minutes at 44.1kHz stereo (resampled to 16kHz mono for training) — had zero clips derived from it anywhere in the dataset before this session, confirming the plan's "not yet integrated" note.

## Background Diversification: 23-Minute Recording Segmented and Added

[`data_processing/segment_background_recording.py`](../../data_processing/segment_background_recording.py) segments a long unlabeled recording into fixed-length (1.25s / 20000-sample, 16kHz mono) `_background_` clips matching the existing `bgreal_*` naming and format exactly, filtering out near-silent windows with the same energy gate used everywhere else in this pipeline (`align_speech_to_fixed_length`'s peak<0.03 / rms<0.003 check) so this source doesn't just add more of the near-silence filler the dataset already has too much of.

Run against `lab_background_sound_01.wav`: 1117 candidate windows → 1057 kept (60 dropped as too quiet) → split 899 train / 158 val (15% val fraction, **deliberately putting real-noise clips into val for the first time** — see the composition finding above). Manifest: [`data_processing/reports/background_segmentation_20260811T104121Z.json`](../../data_processing/reports/background_segmentation_20260811T104121Z.json). This roughly 10x's the real-recording share of the background class (90 → 989 train clips from real sources) and, for the first time, gives the val-set background measurement actual noisy-condition coverage instead of only synthetic near-silence.

**v5 — same retrain procedure as v4, on top of the background-diversified dataset.** Trained the same way as v4 (60 epochs, same hyperparameters, only the dataset changed: +899 train / +158 val real-noise background clips). Best val accuracy: 84.9% (epoch 48).

| Metric | v3 (original) | v4 (quarantine + retrain) | v5 (+ background diversification) |
|---|---|---|---|
| Offline val accuracy | 86.3% | 83.5% | **84.9%** |
| `_background_` recall | 62.9% (151/240) | 72.5% (174/240) | **88.9%** (354/398) |
| `forward` recall | 74.2% | 92.5% | 67.5% (regressed vs. v4) |
| `hold` recall | 83.3% | 62.0% | 81.2% (recovered) |
| `go_red` recall | 67.1% | 50.2% | 54.8% (still down vs. v3) |
| Live-stream detections | 4/11 | **6/11** | 5/11 |

**Background diversification is not an unambiguous win, and this needs to be reported honestly rather than as a clean success story.** Offline, it's the best result on every headline number — `_background_` recall jumped another 16.4 points to 88.9%, and overall accuracy improved over v4. But the live-stream test — the metric the plan has explicitly treated as the one that "actually reflects the reported bug" since Stage 2 — went **backward**, 6/11 (v4) → 5/11 (v5), losing the `left` detection at t=60s that v4 had. Looking at v5's live-stream detection log: it produces noticeably fewer stray `_background_` detections than v4 (12 vs. 18 across the 120s stream, consistent with the offline recall gain), but in exchange it now fires spurious high-confidence `go_red` detections in three windows where `go_red` isn't the right answer (t≈0.5s during the `go_grey` window, t≈51.6s during `forward`, t≈71.9s during `right`) — `go_red` recall was already the weakest command class in both v4 and v5, and this looks like the same weakness manifesting as false positives instead of just false negatives now that background is a less likely competing answer. Full detail: [`evaluations/reports/confusion_matrix_20260811T111853Z.json`](../../evaluations/reports/confusion_matrix_20260811T111853Z.json), [`evaluations/reports/live_stream_eval_20260811T113143Z.json`](../../evaluations/reports/live_stream_eval_20260811T113143Z.json).

**Read with real caveats, not as a final verdict:** this is one training run per stage (no seed averaging), with a deliberately simple/untuned procedure (no augmentation, no class weighting, no regularization or early-stopping beyond keeping the best-val-accuracy epoch, fixed 60 epochs) — both v4 and v5 show the same overfitting pattern (train accuracy saturating near 100% by epoch ~30 while val bounces within a ~5-10 point band for the rest of training), so some of the v4→v5 live-stream difference could plausibly be training-run noise rather than a genuine causal effect of background diversification. The right next step before drawing a firm conclusion is a tuning pass (early stopping, class weighting — `go_red` in particular — mild augmentation) and/or multiple seeds per configuration, not simply picking v4 or v5 as "the" retrain result.

## Tuning Pass, Staged Through Colab

Per step 10 above, moved from single-shot local retrains to a proper tuning pass: augmentation, class weighting, weight decay, early stopping, multiple seeds. Local CPU can't afford the full sweep, so this is staged as local ablation (cheap, fast iteration, CPU) -> Colab GPU sweep (the real multi-seed run).

**Local augmentation ablation** ([`training/experiment_augmentations.py`](../../training/experiment_augmentations.py), [`training/audio_augmentations.py`](../../training/audio_augmentations.py)): pure numpy/scipy waveform augmentations (noise-mixing, speed perturbation, synthetic reverb, gain jitter, time-shift) -- no torchaudio/librosa available in the env, and none of these need more than numpy/scipy. Ran 25-epoch, single-seed, 30%-train-subset comparisons:

| Config | Best val acc |
|---|---|
| `light` (gain + time-shift) | 79.4% |
| `speed_perturb` | 77.5% |
| `combined_no_reverb` (follow-up) | 77.1% |
| `combined` (all 5, incl. reverb) | 76.5% |
| `baseline` (no augmentation) | 76.5% |
| `noise_mix` | 75.6% |
| `reverb` | **57.3%** |

**One clear, confident conclusion: drop reverb.** Consistently ~20 points behind everything else at every epoch, not just noise -- the synthetic room-impulse-response approximation (convolution with an exponentially-decayed noise kernel, since no real RIR dataset is available) is too aggressive or the wrong kind of distortion for this problem. Excluded from `PRESETS` in `audio_augmentations.py`.

**Everything else is genuinely inconclusive at this budget**, including a targeted follow-up (`combined_no_reverb`, i.e. combined minus just reverb: 77.1%, barely above baseline's 76.5%) -- differences of 1-4 points are within the noise already seen between epochs in the full v4/v5 runs. Notably `noise_mix` -- the augmentation most directly relevant to the actual live-stream problem -- underperformed baseline here but was still visibly climbing at epoch 25 with no plateau, the signature of an augmentation that needs more epochs to pay off, not one that doesn't work. This is exactly why the next step is a proper multi-seed sweep at full epoch budget, not another quick local guess.

**Portability refactor for Colab:** split pure DSP code (constants + the STFT transform) out of `audio_receiver_pytorch.py` into a new [`audio_dsp.py`](../../audio_dsp.py), since the training scripts were transitively importing `sounddevice` (needed only for live mic input, and requiring system PortAudio libs) just to get a sample-rate constant. Training now depends on nothing beyond torch/numpy/soundfile/scipy. Also vectorized the STFT computation (`batch_spectrograms` now runs one batched `torch.stft` call instead of looping per-sample) -- this model is small enough (~13.5K trainable params) that the per-sample Python loop was the actual bottleneck, not model compute; vectorizing dropped local per-epoch spectrogram cost by roughly 2.5x and is what makes a GPU worth using at all here (verified numerically identical output before/after, just faster).

**Production training script upgraded** (`training/train_audio_command_classifier.py`, still the single source of truth used both locally and in Colab): `--augmentation {none,light,speed,noise,combined}`, `--class-weights` (sklearn-style balanced weighting -- motivated by the real 3.3x count gap between the original 6 classes and the 5 movement classes added later, see "Correction" section above), `--weight-decay`, `--patience` (early stopping), `--device` (auto-detects CUDA). `--augmentation none` with no other flags reproduces the exact v4/v5 training behavior.

**Colab package**: [`data_processing/prepare_colab_package.py`](../../data_processing/prepare_colab_package.py) zips the training code + `training_v2/` dataset preserving the local `ml_audio/...` directory structure, so the notebook's imports and `DEFAULT_DATASET_ROOT` resolution work unchanged after extraction -- verified end-to-end (extract, import, discover 17507 train files) before treating it as ready. Output: 600.8MB / 19939 files, gitignored (`models/` and `*.zip` already excluded).

[`training/colab_augmentation_sweep.ipynb`](../../training/colab_augmentation_sweep.ipynb): loads the dataset once, then sweeps all 5 augmentation presets x 3 seeds (150 epochs, patience 20, class weighting + weight decay on throughout -- those aren't part of the ablation, the count-imbalance fix is a settled decision, not an open question) -- 15 runs total, reusing `train()` from the production script directly rather than reimplementing anything. Reports mean +/- std val accuracy per config (the number the local single-seed tests couldn't give), exports the single best checkpoint in the same `AudioCommandClassifier`-compatible format as v4/v5.

**Colab sweep run complete (2026-08-12), overnight, ~3.6 hours of GPU compute across all 15 runs.** Crash-resilience wasn't needed in the end (it completed in one session), but was built and verified before the run per the plan above.

| Config | Mean val acc (3 seeds) | Std | Best single seed | Avg s/epoch |
|---|---|---|---|---|
| `noise` | **88.52%** | 1.46% | 89.62% | 4.3s |
| `combined` | 87.75% | 0.39% | 88.05% | 21.8s |
| `speed` | 86.84% | 1.72% | 88.67% | 35.7s |
| `light` | 86.36% | 1.02% | 87.31% | 2.8s |
| `none` (baseline) | 85.32% | 1.01% | 86.20% | 2.1s |

**Noise-mixing wins clearly, exactly as the local ablation's climbing-not-plateaued val curve predicted.** At the 25-epoch local test budget, `noise` underperformed baseline (75.6% vs 76.5%) with a val curve still visibly rising -- the writeup at the time flagged this as "needs more epochs to pay off, not evidence it doesn't work," and a full budget with 3 seeds confirms that: `noise` beats every other config's *mean* by at least 0.8 points and beats baseline by 3.2 points, with the best individual run (`noise_seed0`, 89.6%) exceeding even the original pre-quarantine v3 baseline (86.3%). `speed` is a clear resource outlier -- 10-15x more expensive per epoch than everything else (likely `scipy.signal.resample`'s cost in an unvectorized per-sample augmentation loop) for a worse mean than `noise` -- not worth it as currently implemented; deprioritize or optimize before using it again.

**v6 = `noise_seed0` (89.62% offline), exported to `models/pytorch_v6/`.** Full v3-v6 comparison:

| Metric | v3 (original) | v4 (quarantine) | v5 (+ bg diversification) | v6 (+ noise-mix tuning) |
|---|---|---|---|---|
| Offline accuracy | 86.3% | 83.5% | 84.9% | **89.6%** |
| `_background_` recall | 62.9% | 72.5% | **88.9%** | 79.4% |
| `go_red` recall | 67.1% | 50.2% | 54.8% | **72.4%** |
| `hold` recall | 83.3% | 62.0% | 81.2% | **88.5%** |
| `forward` recall | 74.2% | **92.5%** | 67.5% | 88.3% |
| Live-stream detections | 4/11 | **6/11** | 5/11 | **6/11** |

**v6 is the best checkpoint produced so far by almost every offline measure** -- best overall accuracy, best `go_red` and `hold` recall of any checkpoint yet (both finally past v3's original numbers), second-best `forward` and background recall. **But it does not improve on the live-stream number** -- ties v4 at 6/11 rather than beating it, and the *way* it gets there is a step backward from v4's pattern: v4's 5 misses were all "no detection" (background wins, the safe failure mode); v6 has two real misclassifications instead (`go_red` detected during the `left` window, `stop` detected during the `backward` window), the same kind of regression flagged for v5. v6's live-stream detection log also shows background firing far more often (~70+ times across 120s) than v4's ~18 -- consistent with its lower offline background recall (79.4% vs v5's 88.9%), plausibly because training-time noise-mixing teaches the model that noise-plus-command should resolve to the *command*, making it less willing to default to background broadly, including on some genuinely-background val/live audio. Reports: [`evaluations/reports/confusion_matrix_20260812T205731Z.json`](../../evaluations/reports/confusion_matrix_20260812T205731Z.json), [`evaluations/reports/live_stream_eval_20260812T210001Z.json`](../../evaluations/reports/live_stream_eval_20260812T210001Z.json).

**Third data point for the same pattern now:** v5 and v6 each improved offline metrics substantially over their predecessor while *not* improving (v5: regressing; v6: flat, with a worse failure mode) the live-stream number. Offline val accuracy on isolated, pre-cut clips is clearly not a reliable proxy for continuous-noisy-stream performance for this model/dataset -- any future change should be judged primarily on `evaluate_live_receiver_stream.py`, not `evaluate_audio_classifier.py`, even though the latter is far cheaper to run. The live-stream ceiling has now sat at 6/11 across two different checkpoints (v4, v6) produced by two different mechanisms (label-order/preprocessing fixes; full retrain + noise-mix tuning) -- worth treating as a real signal that something structural is capping it there, not just an artifact of either specific run.

## v7: Real Recordings for the 5 Synthetic-Only Classes

Recorded (by the user, per the plan above) and ingested. Raw bronze recordings at `data/01_bronze_jack/` -- 8 files, one per label (`forward` had 2 usable takes after dedup, see below), each containing several spoken repetitions.

**Built [`data_processing/ingest_bronze_command_recordings.py`](../../data_processing/ingest_bronze_command_recordings.py)** to segment these into the same fixed-length clip format as the rest of `training_v2`:
- **De-duplication first:** `forward` had the same ~71s take saved 3 times (stereo original + 2 mono re-exports, one byte-identical to the other) -- caught automatically by a same-length + high-correlation check, not hardcoded to specific filenames, so this generalizes to future recording batches.
- **Voice-activity segmentation:** per-frame RMS-in-dB, Otsu-thresholded (auto-adapts to each file's own level), gaps under 250ms bridged (avoids splitting a word at an internal dip), runs under 150ms dropped (breath/click noise), margin added matching `align_speech_to_fixed_length`'s convention (80ms pre / 120ms post).
- **Per-label MAD-based duration outlier check** (same 3.0 multiplier as `audit_dataset_corruption.py`) caught 5 segmentation mistakes across the batch, including one clear one: a 3.18s segment in `left_jack_0.wav` where two repetitions merged (pause between them was under the 250ms bridge threshold) -- correctly excluded rather than silently truncated to 1.25s (which would have kept only whichever word came first).
- **Found and fixed a real gain-mismatch bug before it corrupted the ingest:** the bronze recordings were ~7x quieter (median segment peak ~0.045) than the existing `real_speakerNN` clips (~0.30) and the synthetic TTS clips (~0.57-0.60). This first showed up as ~20% of legitimate speech segments getting wrongly flagged "empty" by the standard energy gate (calibrated for the louder existing data). The deeper concern wasn't just lost data -- if left uncorrected, all 5 movement classes would have been *systematically* quieter than every other class in the dataset, risking the model learning "quiet audio" as a shortcut for "movement command" with no connection to the actual spoken content. Fixed with **one constant gain multiplier for the whole batch** (computed from median RMS against a sample of existing real clips, clamped so the loudest segment in the batch doesn't clip) -- deliberately *not* the kind of per-clip adaptive renormalization Stage 2 already found harmful for live inference (that renormalizes noise/silence up to full-scale too; a single session-level constant doesn't).
- Result: **160 real clips** across the 5 classes (`backward` 25, `forward` 30, `go_grey` 38, `left` 37, `right` 30), split 85/15 train/val, written as `real_jack__<label>__<split>__NNNNNN.wav` matching the existing `real_speakerNN` naming convention. Manifest: [`data_processing/reports/bronze_ingest_20260813T113806Z.json`](../../data_processing/reports/bronze_ingest_20260813T113806Z.json).
- **Validated with the standing tools, not just eyeballed:** re-ran `audit_dataset_corruption.py` across the whole dataset afterward -- all 5 classes come back 0 empty / 0 truncated in both train and val.

**Retrained v7** on top of this (locally, not Colab -- a single run at this dataset size now takes ~27 min thanks to the vectorized STFT, no need for GPU/Drive-upload overhead for one run): `--augmentation noise` (the sweep's winner), class weighting, weight decay, early stopping -- the same recipe v6 used, only the dataset changed. Best val accuracy 87.2% (early-stopped at epoch 66, best at epoch 46).

| Metric | v4 | v5 | v6 | v7 |
|---|---|---|---|---|
| Offline accuracy | 83.5% | 84.9% | 89.6% | 87.2% |
| `go_red` recall | 50.2% | 54.8% | **72.4%** | 41.8% (regressed sharply) |
| `forward` recall | 92.5% | 67.5% | 88.3% | 73.4% (regressed) |
| `left` recall | -- | -- | -- | **95.9%** |
| `go_grey` recall | -- | -- | -- | **98.4%** |
| `hold` recall | 62.0% | 81.2% | 88.5% | **98.7%** |
| Live-stream detections | **6/11** | 5/11 | **6/11** | 5/11 |

**Genuinely mixed, not a clean win -- and one regression is serious enough to flag prominently rather than average away.** The domain-gap theory gets real, direct support: `left` and `go_grey` -- two of the five classes that just went from 0% to real human recordings -- are now detected correctly in the live-stream test *simultaneously* for the first time across every checkpoint tried (v3-v6 never got both at once), and both show >95% offline recall. `hold` also improved further. But `go_red` recall **collapsed** from 72.4% (v6) to 41.8% -- the sharpest single-class regression seen anywhere in this whole retrain track -- with new leaks to `go_yellow` (10.9%), `hold` (19.2%), and `left` (7.9%) that didn't exist before. `forward` also regressed (88.3% -> 73.4%). Live-stream detection count lands at 5/11, tying v5, below the 6/11 v4 and v6 both reached -- though *how* it gets there looks different and arguably safer: only 9 total non-background detections across the full 120s stream (vs. v6's ~70+), essentially zero spurious `_background_` firing, and only 2 of its 6 misses are actual misclassifications (`go_red`, `backward`) rather than safe no-detections. Reports: [`evaluations/reports/confusion_matrix_20260813T221128Z.json`](../../evaluations/reports/confusion_matrix_20260813T221128Z.json), [`evaluations/reports/live_stream_eval_20260813T221414Z.json`](../../evaluations/reports/live_stream_eval_20260813T221414Z.json).

**Multi-seed check done (seeds 1, 2, same dataset/recipe) -- go_red's collapse is confirmed real, not single-run noise.**

| | seed 0 | seed 1 | seed 2 | v6 (for reference) |
|---|---|---|---|---|
| Offline accuracy | 87.2% | 87.7% | 87.9% | 89.6% |
| `go_red` recall | 41.8% | 46.9% | 46.9% | 72.4% |
| `left` recall | 95.9% | 99.2% | 98.3% | -- |
| `go_grey` recall | 98.4% | 99.2% | 96.8% | -- |
| `forward` recall | 73.4% | 95.2% | 91.9% | 88.3% |
| Live-stream | 5/11 | **6/11** | 4/11 | 6/11 |

All three seeds land `go_red` recall in a tight 42-47% band, nowhere near v6's 72.4% -- this rules out single-run noise as the explanation. **The failure mode is also identical across all three seeds, not just the magnitude:** in every case the dominant leak is `go_red` -> `hold` specifically (19%, 36%, 30% of go_red clips respectively -- 2-5x any other single confusion), not a diffuse spread across classes. That consistency is itself informative: this looks like a real, structural shift in the decision boundary between `go_red` and `hold`, triggered by adding the new movement-class recordings, even though neither `go_red`'s nor `hold`'s own training data changed at all between v6 and v7. With a model this small (~13.5K params, a 48-dim pooled feature space feeding a linear head), added diversity in other classes apparently costs capacity somewhere else rather than being absorbed for free -- consistent with the open question already on record about whether this architecture is simply too small for the number of distinctions it's being asked to make.

`left` and `go_grey` offline recall is excellent and consistent across all three seeds (95.9-99.2%), so that part of the domain-gap theory holds up well under multi-seed scrutiny, not just as a one-off. `forward` is mostly strong offline too (seed 0's 73.4% now looks like the outlier, not seeds 1/2's 92-95%) -- but **`forward`/`right`/`backward` never once register a correct live-stream detection across any of the 3 seeds**, despite `forward`'s good offline recall in 2 of 3 runs. That's the clearest remaining sign the offline/live-stream gap for this pipeline isn't fully explained by the domain-gap fix alone.

Live-stream itself is highly variable across seeds (4/11, 6/11, 4/11) -- about as wide a spread as separates the best (v4/v6, 6/11) and worst (v5, 5/11) checkpoints seen anywhere in this plan, from nothing but a different random seed on the identical dataset/recipe. That's a useful calibration point on its own: single live-stream-eval numbers for any past checkpoint (v3-v6, each measured on one seed) should be read with a +/-1-detection error bar, not as exact.

**Verdict: do not deploy v7 (any seed) to hardware.** The `go_red` regression is confirmed, real, and consistent -- not resolved by picking a different seed, since all three share it. Interim hardware recommendation stays **v4** (still the cleanest live-stream failure mode of any checkpoint produced in this plan). The domain-gap fix is directionally validated (`left`/`go_grey` genuinely improved and held up across seeds) but isn't a finished win: it needs to be combined with a fix for the new `go_red`/`hold` confusion before the next candidate for deployment. Options worth trying next, roughly in order of effort: (1) more real `go_red` recordings specifically, to re-anchor its decision region now that the feature space has shifted; (2) reduce or drop class weighting (it was on by default for both v6 and v7; the sweep never actually tested class-weighting on vs. off in isolation, only augmentation choice with weighting always on -- worth an ablation); (3) investigate whether the model's small capacity is a hard ceiling here, which would point toward an architecture change rather than more data/tuning.

**Also pending:** the user is recording additional real human samples for the 5 currently-100%-synthetic movement classes (`forward`/`backward`/`left`/`right`/`go_grey`) separately. Once available, fold them into `training_v2/` (matching the existing `real_<speaker>__<label>__...` naming convention already used for the original 6 classes) and repackage/retrain -- this directly targets the domain-gap finding, likely a bigger lever than any augmentation choice, and should be tracked as its own measured stage rather than bundled into the same retrain as the augmentation sweep result.

## Pretrained Backbone / Transfer Learning Track (Exploratory, Parallel to the Custom-CNN Track)

Motivated by the confirmed, repeatable `go_red`/`hold` capacity-thrashing found in v7's multi-seed check above -- with a model this small (~13.5K params), diversity added for one class costs accuracy on an unrelated one. Idea: fine-tune a small *pretrained* speech-command backbone instead of continuing to hand-tune the from-scratch custom CNN, so the model starts from features that already understand clean-speech/noisy-speech/non-speech structure rather than learning that from our comparatively small dataset alone.

**Confirmed the FPGA/HLS export path (`export_audio_weights.py`, referenced in `readme.md`) is legacy/deprecated for audio -- the Jetson AGX Orin 64GB (p3730) is the only real deployment target now.** (Corrected 2026-09-12: earlier notes in this section said "Jetson Orin Nano" -- that was never the right name; `CLAUDE.md`'s actual compute target for large-model deployment is the AGX Orin 64GB dev kit, Ampere with Tensor Cores, a substantially more generous budget than the Nano-class framing implied. Doesn't change the phased plan below, but does mean model-size headroom was underestimated throughout Phase 0/1 planning.) This matters: it rules out nothing on capability grounds, since a pretrained backbone has no realistic HLS/C-header export story the way the tiny hand-rolled CNN does.

**Model choice: NVIDIA NeMo's MatchboxNet family, pretrained on Google Speech Commands** -- not a general-purpose model (Wav2Vec2, YAMNet, Whisper). Verified directly against NVIDIA's own docs/NGC pages before committing to this, not assumed from memory:
- `commandrecognition_en_matchboxnet3x1x64_v2` / `commandrecognition_en_matchboxnet3x2x64_v2` are real, loadable via `nemo_asr.models.EncDecClassificationModel.from_pretrained(...)`.
- MatchboxNet at the 3x2x1 scale runs ~93K parameters / ~767KB compressed / 97.3% accuracy on the 35-class Speech Commands v2 benchmark -- still comfortably edge-appropriate (has to share the Jetson with the vision pipeline) while giving ~7x the capacity of the current custom CNN.
- NeMo models export to ONNX via the standard `Exportable` mixin's `.export()` method; ONNX -> TensorRT is NVIDIA's own documented Jetson deployment path -- same company, same hardware family, purpose-built for this task category (short command words, background/silence as a class).

**Phased plan, in order, each phase gating the next:**
1. **De-risk the deployment path first** (before any fine-tuning investment) -- verify a stock pretrained checkpoint actually loads, exports to ONNX, and the ONNX graph reproduces the source model's output.
2. **Fine-tune on our existing dataset** -- `training_v2/` doesn't change at all, this track is orthogonal to all the dataset work already done. Needs a manifest-format adapter (NeMo expects JSON-lines with `audio_filepath`/`duration`/`label`) but no new data collection.
3. **Evaluate with the same discipline this plan already earned the hard way** -- offline confusion matrix *and* the live continuous-stream test, multiple seeds. Offline accuracy has now been shown three separate times (v5, v6, v7) not to predict live-stream performance for this problem; no reason to assume that stops being true with a different backbone.
4. **Quantize and validate on real Jetson hardware** -- ONNX validity doesn't guarantee acceptable on-device latency/power; needs actual measurement (or accurate JetPack-level simulation), budgeted against whatever headroom the vision pipeline leaves on the shared SoC.
5. **Decision point, not a foregone conclusion** -- compare against the best custom-CNN checkpoint on accuracy, live-stream performance, and resource footprint before deciding whether to switch what's deployed. Keep the custom-CNN track's best checkpoint (currently v4) as the deployed baseline throughout; this is a parallel exploration given it's a bigger infrastructure lift with more unknowns.

**Phase 0 (de-risking) complete -- the deployment path is real and verified, not just documented.** [`training/colab_nemo_phase0_verification.ipynb`](../../training/colab_nemo_phase0_verification.ipynb) run in Colab (NeMo has Linux-only dependencies -- `pynini`, `nemo_text_processing` -- impractical to install natively on this Windows dev machine). Found and fixed three real issues along the way, each worth recording since they'd otherwise resurface in Phase 1-4:

1. **Device mismatch.** The pretrained checkpoint auto-loads onto Colab's GPU; the notebook's dummy input tensors didn't follow. Fixed by reading the model's actual device (`next(model.parameters()).device`) rather than assuming CPU.
2. **The exported ONNX graph's only input is a precomputed log-mel-spectrogram `(batch, 64, time)`, not raw waveform.** `.export()` only traces the encoder+decoder; NeMo excludes the preprocessor from the graph. This mirrors our own custom-CNN pipeline's split (STFT computed in `audio_dsp.py`, separate from the neural net) -- confirms the eventual Jetson-side deployment will need its own feature-extraction step ahead of the ONNX/TensorRT engine, the same shape of problem already solved once for the custom model, not a new one.
3. **A cross-check false alarm from double-dither, not a real export bug.** NeMo's feature extraction applies dither (small random noise before the STFT, standard in ASR pipelines) even in eval mode. The first cross-check attempt called `model.preprocessor(...)` independently to build both the "PyTorch reference" and the "ONNX input," drawing two different random dither perturbations -- producing a spurious max-abs-diff of ~0.35 that looked like a real divergence. Fixed by computing the mel features exactly once and deriving the PyTorch reference (`logits_ref`) by running the encoder/decoder directly on that same tensor. After the fix: **max abs diff = 0.000002** -- floating-point noise, export path confirmed sound.

**Verdict: proceed to Phase 1 (fine-tuning on our own dataset).** The checkpoint loads cleanly, exports to ONNX, and the ONNX graph is numerically faithful to the source PyTorch model. What's still unverified and needed before any deployment decision: actual TensorRT engine build + latency/power measurement on real Jetson AGX Orin 64GB hardware (ONNX validity doesn't guarantee acceptable on-device performance), and -- the real unknown -- fine-tuned accuracy/live-stream performance on our 12-class dataset, since this checkpoint is pretrained on a different 35-class vocabulary.

**Phase 1 (fine-tuning) built, not yet run.** Confirmed the fine-tuning API against NVIDIA's docs before writing anything (manifest format, `change_labels()` for swapping the decoder to our 12 classes while keeping the pretrained encoder, the `train_ds`/`validation_ds` config pattern) -- same "verify before building" discipline Phase 0 already validated is worth the extra step.

- [`training/nemo_manifest.py`](../../training/nemo_manifest.py): builds NeMo's one-JSON-object-per-line manifests from `training_v2/`. Deliberately kept NeMo-free (only needs `soundfile`) so it's testable locally without touching Colab -- **tested locally**: 17,646 train / 2,448 val entries, counts matching v7's dataset exactly, valid JSON, file paths resolve. Manifest generation happens at Colab-execution time (not baked into the data package) since `audio_filepath` has to match wherever the dataset actually lands after extraction.
- [`training/colab_nemo_finetune.ipynb`](../../training/colab_nemo_finetune.ipynb): loads the Phase-0-verified checkpoint, swaps its decoder for our alphabetical 12-class label list (asserted to match, not assumed, after `change_labels()`), fine-tunes at a lower LR than the pretrained recipe with early stopping on val accuracy (same overfitting discipline the custom-CNN track needed), builds our own full confusion matrix rather than trusting NeMo's aggregate val-accuracy metric alone (the go_red/hold confusion in v7 would have been invisible to a single scalar), and exports both `.nemo` and ONNX. Checkpoints persist to Drive via a Lightning `ModelCheckpoint` callback rather than a hand-rolled callback, since training here goes through `trainer.fit()` rather than our own epoch loop -- same crash-resilience intent as the augmentation sweep's Drive-persisted progress, using the framework's native mechanism instead of reimplementing it.
- **Needs a freshly rebuilt data package** before running -- the existing `ml_audio_colab_package.zip` predates the real `jack` recordings added for v7; re-run `prepare_colab_package.py` first.

**Phase 1 run -- offline result is the best of any checkpoint in this entire plan, by a wide margin.** Ran into three real API mismatches getting there (not guessed -- each pinned down against a live diagnostic or the actual traceback before patching, same discipline as Phase 0):

1. NeMo's current `EncDecClassificationModel` inherits `setup_training_data`/`setup_validation_data` from `EncDecSpeakerLabelModel` without overriding them, so the keyword args are `train_data_layer_config`/`val_data_layer_config`, not `train_data_config`/`val_data_config` (the class itself is correct and `change_labels()` worked fine on the first try -- the error message just names the class that *defines* the inherited method, not the instance's own class, which briefly looked like a much bigger problem than it was).
2. `import pytorch_lightning as pl` fails an `isinstance` check at `trainer.fit()` -- NeMo's current models subclass `lightning.pytorch.LightningModule` (the renamed/unified package), not the legacy standalone `pytorch_lightning` package. Two similarly-named but distinct classes.
3. The `EarlyStopping`/`ModelCheckpoint` callbacks' `monitor="val_acc"` doesn't exist in this version's logged metrics; `val_acc_micro_top_1` is what matches the accuracy definition used everywhere else in this plan (correct/total, i.e. micro -- confirmed from the actual list of available metrics in the error message, not guessed, since `val_acc_macro` weights every class equally regardless of sample count and wouldn't be comparable to any v3-v7 number).

**Result: 95.75% offline accuracy (2344/2448), best of any checkpoint by a wide margin (previous best: v6's 89.6%).**

| Class | Recall | Best prior (custom CNN) |
|---|---|---|
| `go_red` | **94.6%** | 72.4% (v6) -- the class with the confirmed, repeatable `go_red`->`hold` collapse across all 3 v7 seeds |
| `backward` | **100%** | 97.5% (v4) |
| `forward` | 98.4% | 92.5% (v4) |
| `hold` | 91.5% | 88.5% (v6) |
| `_background_` | 87.4% | 88.9% (v5, the only prior checkpoint to beat this) |
| `left` / `go_grey` / `right` / `stop` / `go_blue` / `go_green` / `go_yellow` | 96-99.6% | -- |

**The headline finding: `go_red` no longer collapses.** That class went 67.1% (v3) -> 50.2% (v4) -> 54.8% (v5) -> 72.4% (v6) -> ~42-47% across all 3 v7 seeds (the confirmed capacity-thrashing regression) -> **94.6%** here. No class shows anything resembling that collapse pattern in this checkpoint. Directly consistent with the capacity-thrashing hypothesis the v7 multi-seed check pointed at: a ~75K-param pretrained backbone doesn't fight itself for representational room the way the 13.5K-param custom CNN did when asked to absorb more class diversity. Also notable: the pretrained recipe's inherited augmentor config was already applying white-noise injection (probability 1.0) and small time-shifts automatically, without any explicit configuration on our part -- convergent with `noise` being the winning augmentation in the custom-CNN sweep, not a coincidence.

Artifacts organized into the existing convention: [`models/nemo_matchboxnet_v1/`](../../models/nemo_matchboxnet_v1/) (`.nemo`, ONNX, and the raw Lightning `.ckpt`), confusion matrix report alongside every other checkpoint's in [`evaluations/reports/nemo_finetune_confusion_matrix_20260824T011522Z.json`](../../evaluations/reports/nemo_finetune_confusion_matrix_20260824T011522Z.json). ONNX export re-verified locally (structurally valid, input `(batch, 64, time)` matching Phase 0's finding, output correctly resized to 12 classes) rather than trusted from the Colab log alone.

**Same discipline as every other checkpoint in this plan applies here too: offline accuracy has diverged from live-stream performance three separate times already (v5, v6, v7).** This 95.75% is genuinely the best result produced so far, but it is not yet evidence of anything on the actual failure mode (concurrent robot operation / continuous noisy stream) this whole investigation started from.

## Live-Stream Result: 9/11, the Best Result in This Entire Plan

Built [`evaluations/nemo_live_receiver.py`](../../evaluations/nemo_live_receiver.py) (mirrors `AudioCommandReceiver`'s threading/buffer/gating harness exactly -- same window size, step interval, confidence/margin thresholds -- swapping in NeMo's own forward pass since its MFCC preprocessing differs from the custom CNN's) and [`evaluations/evaluate_nemo_live_receiver_stream.py`](../../evaluations/evaluate_nemo_live_receiver_stream.py). Factored the receiver-agnostic scoring/report logic out of `evaluate_live_receiver_stream.py` into [`evaluations/live_stream_eval_common.py`](../../evaluations/live_stream_eval_common.py) so both tracks are scored by the literal same code, not just similarly-shaped copies -- **verified this refactor changed nothing** by re-running it against v4 and confirming a bit-for-bit identical result (6/11, same exact hits/misses) before trusting it for anything new.

**Correction to a claim repeated throughout this plan: NeMo installs fine locally on this Windows machine.** Every prior NeMo step (Phase 0, Phase 1 fine-tuning) ran in Colab specifically because `nemo_toolkit` was assumed to need Linux-only dependencies (`pynini`, `nemo_text_processing`) -- that assumption was never actually tested here and turned out to be wrong for the `[asr]` extra specifically (those packages are for TTS/text-normalization collections we don't use). `pip install "nemo_toolkit[asr]"` in a fresh `nemo_local` conda env (Python 3.10, isolated from `ball_balance_env` rather than risking the working environment) installed cleanly -- CPU-only PyTorch, which is fine for inference on a ~75K-param model even without a local GPU. This means the live-stream evaluation (and any future NeMo inference/evaluation work) can run locally like every other evaluation script in this plan, without a Colab round-trip.

**One more bug caught locally before it reached the live-stream test:** `model.labels` is `None` after `EncDecClassificationModel.restore_from(...)` -- it's only populated as a side effect of calling `setup_training_data()`, not persisted in the saved checkpoint. The real label order is in `model.cfg.labels` (confirmed to agree with `cfg.train_ds.labels`, `cfg.validation_ds.labels`, and the decoder's `num_classes` before trusting it). `nemo_live_receiver.py` reads labels from there instead.

**Result: 9/11 expected commands correctly detected**, run locally against the same `master_evaluation_audio.wav` stream every checkpoint in this plan has been scored against:

| t | expected | detected |
|---|---|---|
| 0s | go_grey | OK |
| 10s | go_blue | OK |
| 20s | go_green | **MISS** (misclassified as `go_grey`, twice) |
| 30s | go_yellow | OK |
| 40s | go_red | OK |
| 50s | forward | **OK** |
| 60s | left | **OK** |
| 70s | right | **OK** |
| 80s | backward | MISS (no detection) |
| 90s | hold | OK |
| 100s | stop | OK |

This blows past the 6/11 ceiling every custom-CNN checkpoint hit (v4, v6) -- and critically, `forward`/`left`/`right` are all correctly detected **simultaneously** for the first time anywhere in this plan; no v3-v7 checkpoint, including any of the 3 v7 seeds specifically aimed at fixing these classes, ever got all three at once. Only 2 misses, one of which (`go_green`->`go_grey`) is a genuine misclassification rather than a safe non-detection -- still a much cleaner failure profile than v6's ~70 stray background firings and multiple misfires. Report: [`evaluations/reports/live_stream_eval_20260824T015753Z.json`](../../evaluations/reports/live_stream_eval_20260824T015753Z.json).

**Verdict: the pretrained-backbone track is now the clear leader on both metrics that matter (95.75% offline, 9/11 live-stream), not just offline accuracy alone.** This is the first checkpoint in the entire plan where the live-stream result is unambiguously, dramatically better rather than diverging from or barely matching the offline result -- strong, now twice-confirmed (once per metric) evidence that the custom 13.5K-param CNN's capacity was the real ceiling, not the dataset or preprocessing work that came before it.

**Multi-seed check done (4 seeds total via the notebook's `SEED` parameter) -- `go_green` and `backward` are confirmed real, repeatable weaknesses, not single-run noise:**

| t | expected | seed 0 | seed 1 | seed 2 | seed 3 |
|---|---|---|---|---|---|
| 0s | go_grey | OK | OK | OK | OK |
| 10s | go_blue | OK | MISS | OK | OK |
| 20s | go_green | **MISS** | **MISS** | **MISS** | **MISS** |
| 30s | go_yellow | OK | OK | OK | OK |
| 40s | go_red | OK | OK | OK | OK |
| 50s | forward | OK | OK | OK | OK |
| 60s | left | OK | OK | OK | OK |
| 70s | right | OK | MISS | MISS | OK |
| 80s | backward | **MISS** | **MISS** | **MISS** | **MISS** |
| 90s | hold | OK | OK | MISS | MISS |
| 100s | stop | OK | OK | OK | OK |
| **Total** | | **9/11** | **7/11** | **7/11** | **8/11** |

`go_green`/`go_grey` and `backward` fail in all 4 of 4 seeds now -- as confirmed as this kind of finding gets without literally infinite seeds, a real structural weakness rather than noise. `right` sits at 2 of 4 (genuinely ambiguous, not clearly real or noise). `go_blue` at 1 of 4 looks like a one-off. `hold` is the one worth watching, not yet concluding on: fine in the first two seeds, missed in the last two -- could be coincidence at n=4, could be an emerging pattern; would need more seeds to tell, not worth chasing on its own before the `go_green`/`backward` fixes are tried. Offline accuracy stayed tight across all 4 seeds too (95.3-96.5%, no class collapse anywhere), reinforcing that live-stream's wider spread (7-9/11) is about live/continuous-noise conditions specifically, not a shaky checkpoint -- the same offline/live-stream gap lesson this plan keeps re-learning, just at a much higher baseline this time. All 4 seeds' checkpoints organized under `models/nemo_matchboxnet_v1[_seedN]/`, reports under `evaluations/reports/`.

**Diagnosed *why* the two confirmed failures happen** (built [`evaluations/nemo_stream_probe.py`](../../evaluations/nemo_stream_probe.py), which logs every window's raw prediction/confidence/margin rather than only what passes the gate -- ruled out a threshold-tuning fix before considering anything bigger):
- **`go_green` -> `go_grey`:** the model never predicts `go_green` at all during that window -- it confidently predicts `go_grey` instead (up to 96.5%). Not a borderline miss; a specific, confident acoustic confusion between two genuinely similar-sounding words.
- **`backward`:** the model almost never rises above `_background_` during that window -- a few weak (<0.52 confidence) flickers toward unrelated classes, never anything resembling `backward`. Looks like noise-masking, not confusion with a specific wrong word. Consistent with `backward` still having the fewest real recordings (22) of any class and no noise-mixing augmentation tuned to our own robot/lab noise profile.
- Checked whether the `go_green`/`backward` source recordings in `master_evaluation_audio.wav` (from `data/01_evaluation_samples/`) are simply bad clips before assuming a model/data problem -- peak/RMS/active-duration for both are solidly mid-pack against the other 9 command samples in that folder, not obvious outliers. Doesn't rule out subtler quality issues undetectable without actually listening, but rules out the simple "one dud recording" explanation.

**Scope change: `go_grey` dropped from live-stream scoring going forward** -- the current robot deployment has no grey marker to test against. `EXPECTED_SEQUENCE` in [`evaluations/live_stream_eval_common.py`](../../evaluations/live_stream_eval_common.py) now has 10 entries instead of 11 (still spoken in the stream audio itself, just not graded) -- future live-stream scores are out of 10, not 11. Doesn't change any conclusion above: `go_grey` passed 3/3 seeds before being dropped.

**Not yet done:** TensorRT engine build + real Jetson AGX Orin 64GB latency/power measurement (Phase 0 only verified ONNX export, not on-device performance) -- the one remaining unknown before this could actually be deployed. Given `go_green`/`backward` are now confirmed with 4 independent seeds rather than suspected, the next real lever is trying the larger `matchboxnet3x2x64` pretrained variant and/or noise-mixing our own background recordings into fine-tuning specifically targeting these two classes, not further seed-hunting.

## Scaling Up: `matchboxnet3x2x64` Variant Support (2026-09-12)

Per `model-iteration-constraints` (read before touching the notebook): checked the locked constraints first. The FPGA BRAM/DSP limits in `CLAUDE.md` don't apply here -- audio's deployment target is the Jetson AGX Orin 64GB (p3730) via ONNX/TensorRT, not FPGA, and that target is a substantially larger compute budget than the "Jetson Orin Nano" framing this section used until the correction above -- there was never a real size constraint pushing toward `3x1x64` specifically, just an unexamined assumption. `3x2x64` is NVIDIA's next size step in the same NGC family, loadable via the identical `from_pretrained()`/`change_labels()` path Phase 0 already verified for `3x1x64` -- no new deployment-path risk to de-risk separately.

**Notebook changes** ([`training/colab_nemo_finetune.ipynb`](../../training/colab_nemo_finetune.ipynb)): added `MODEL_VARIANT` ("3x1x64" or "3x2x64") alongside `SEED`. Per the "isolate the variable you're testing" and "version, don't overwrite" constraints: every downstream path (Drive checkpoint dir, exported `.nemo`/`.onnx`, confusion-matrix/live-stream report filenames) is now variant-suffixed, and switching `MODEL_VARIANT` changes nothing else in the notebook -- same manifests, same labels, same dataset, same training recipe. That keeps a `3x2x64` vs `3x1x64` comparison a clean architecture ablation rather than a confound with a data change. Also fixed the stale "Jetson Orin Nano" references in this notebook's own "Not yet done" cell to the correct AGX Orin 64GB target.

**Not run yet -- this was infrastructure, not a training run.** Per "never rank architectures from a small seed count" (this project has already had a 3-seed ranking overturned at 5 seeds, twice), before treating any `3x2x64` result as better or worse than `3x1x64`'s existing 4-seed baseline: `3x1x64` needs a 5th seed to close out its own ranking, and `3x2x64` needs its own >=5-seed run, not a 1-seed spot check compared against `3x1x64`'s 4-seed average. That's roughly 9 additional Colab fine-tuning runs (~each comparable in cost to the existing seed0-3 runs) before a real verdict — a real time/compute cost worth the user knowing about up front, not discovering mid-sweep.

**Calibrating the "99% accuracy" goal honestly, before spending that compute:** this plan has three separate confirmed findings that a bigger model is unlikely to fully erase, and the target should be set with those in mind rather than as a round number:

- `go_green`/`go_grey` is a confident, specific acoustic near-homophone confusion (the model doesn't hedge -- it predicts `go_grey` at up to 96.5% confidence during `go_green` windows), not a capacity-limited toss-up. A `3x1x64`-vs-custom-CNN jump (13.5K -> ~93K params) fixed a *different* capacity-linked problem (`go_red`/`hold` thrashing) but has not touched this one across 4 seeds. More capacity might help it learn a finer distinction, or might not, since the two words are acoustically close regardless of model size -- this is squarely an empirical question the `3x2x64` run should answer, not a assumed win.
- `backward`'s failure looks like noise-masking (confidence never rises above `_background_`, no confusion with a specific wrong word) rather than an acoustic-confusion or capacity problem -- the literature-motivated fix for this is more/better noise-mixing during fine-tuning (Item 4 from the original 4-item diagnostic list), not necessarily a bigger model. Worth trying alongside `3x2x64`, not instead of it, since they target different failure modes.
- Offline accuracy has diverged from live-stream performance at every single stage of this plan (v5, v6, v7, and now the NeMo track's own 95.3-96.5% offline vs. 7-9/10 live-stream spread) -- a 99% figure needs to specify *which* metric, and a 99% *offline* number would not, on this plan's own track record, be strong evidence of a 99% *live-stream* number.
- **Realistic target, stated the same way this plan calibrated expectations earlier:** a stable 9-10/10 live-stream result, reproducible across >=5 seeds, with `go_green`/`backward` specifically improved (not just overall accuracy) -- not a round 99% on any single offline number.

## Scaling-Up Result: `3x2x64` Does Not Fix `go_green`/`backward` -- Confirmed at >=5 Seeds Each (2026-09-13)

Ran the sweep this section called for: `3x1x64` seed4 + seed59 (bringing that variant to **6 seeds total**, past the >=5 threshold), and `3x2x64` seeds 0-4 (**5 seeds**, its first ranking-eligible batch). Organized into `models/nemo_matchboxnet_v1_seed{4,59}/` (3x1x64, matching the existing `_seedN` convention) and `models/nemo_matchboxnet_3x2x64_seed{0-4}/` (new variant, deliberately not reusing `v1` naming per the plan above); reports into `evaluations/reports/`.

**First correction to an assumption made when this section was written: `3x2x64` is barely bigger than `3x1x64`, not a meaningful capacity jump.** The notebook's own `n_params` print (added specifically so this wouldn't be guessed) shows **77,859 params for fine-tuned `3x1x64`** and **93,411 for fine-tuned `3x2x64`** -- a ~1.2x difference, not the "next size step up" this section implied going in. Worth remembering for any future "try a bigger model" instinct on this NGC family specifically: the naming (`3x1x64` vs `3x2x64`) suggests a bigger jump than the real parameter count delivers.

| | 3x1x64 (6 seeds: 0,1,2,3,4,59) | 3x2x64 (5 seeds: 0-4) |
|---|---|---|
| Params (fine-tuned) | 77,859 | 93,411 |
| Offline accuracy (mean) | 95.76% (94.93-96.45% range) | 95.30% (94.24-96.49% range) |
| Live-stream (mean, out of 10) | 7.0/10 (6-8 range) | 6.2/10 (6-7 range) |

**Note on the live-stream numbers above:** the Colab package used for this sweep still had the pre-`go_grey`-exclusion `live_stream_eval_common.py` baked in (every new report scored `/11` with `go_grey` still in `EXPECTED_SEQUENCE`, not the current local `/10`) -- another instance of the stale-package pattern this plan has hit twice before. Didn't invalidate anything this time: `go_grey` passed in all 11 new runs (7 new + the 4 already on record), so the table above simply subtracts 1/1 to convert to the current `/10` convention, which is exact, not an approximation. Still: **rebuild and re-upload the Colab package before the next NeMo run**, so this doesn't have to be corrected by hand again.

**Verdict: offline accuracy and live-stream score are both within the seed-noise band already established for this checkpoint family (this plan's own prior finding: live-stream needs a +/-1-detection error bar) -- no real separation between the two variants on either metric.** Neither variant should be preferred over the other on this data alone.

**The actual headline finding is per-class, not aggregate, and it's decisive:**

| Class | 3x1x64 (6 seeds) | 3x2x64 (5 seeds) | Combined |
|---|---|---|---|
| `go_green` | 0/6 (MISS every seed) | 0/5 (MISS every seed) | **0/11 -- fails in literally every run of either variant** |
| `backward` | 0/6 | 0/5 | **0/11 -- same** |
| `right` | 2/6 | 2/5 | 4/11 (36%) -- leans toward a real, if partial, weakness, more than the earlier "genuinely ambiguous" read at n=4 |
| `hold` | 4/6 | 2/5 | 6/11 (55%) -- still genuinely inconclusive |
| `go_blue` | 5/6 | 3/5 | 8/11 (73%) -- mostly fine, occasional miss |

**`go_green` and `backward` now fail in 11 out of 11 runs across two different model sizes at the same family.** This is about as strong as evidence gets without literally exhausting the search space: scaling within the MatchboxNet NGC family (at least across this ~1.2x range) does not touch either failure. This empirically confirms exactly what the calibration section above predicted rather than assumed -- `go_green`/`go_grey` is a genuine acoustic near-homophone confusion the model doesn't hedge on (not a capacity gap), and `backward` is noise-masking (also not primarily a capacity problem). **Recommendation: stop scaling this family further and move to the other candidate fix -- noise-mixing our own background recordings into fine-tuning, targeting `backward` specifically** (the original diagnostic list's item 4). `go_green`/`go_grey` doesn't have an obvious data-side fix from what's been tried so far and may need a closer look at whether the two classes are separable at all from short command-word audio alone, independent of model choice.

**Interim hardware recommendation is unchanged: still the NeMo `3x1x64` track (best live-stream ceiling of 9/11 at seed0, best confirmed offline accuracy), not `3x2x64`** -- the larger variant has produced no seed that beats `3x1x64`'s best, at ~20% more parameters for no measured benefit. `3x2x64` checkpoints are kept for reference, not recommended for further tuning effort ahead of `3x1x64`.

## Production Integration Check (2026-09-15): NOT a Drop-In ONNX Swap -- Caught Before It Shipped

The user asked for this NeMo checkpoint to be integrated as the production audio classifier in `main_onnx_shared_vision_audio.py`, on the reasonable belief that it "now outperforms" what's currently deployed. Checked what's actually there before touching anything, per this plan's own standing discipline -- and found a real incompatibility that would have made "just point it at the new .onnx file" a broken deployment, not a working upgrade.

**Two separate findings, both confirmed by reading the actual code/config, not assumed:**

1. **Every NeMo live-stream number on record in this plan (9/11, 7-9/10, all the seed0-59/3x2x64 tables above) was measured through the full NeMo/PyTorch runtime, not the ONNX export.** [`evaluations/nemo_live_receiver.py`](../../evaluations/nemo_live_receiver.py)'s `_process_loop` calls `self.model(input_signal=audio_t, ...)` directly -- the loaded `EncDecClassificationModel` object, preprocessor included. Phase 0's ONNX verification (`colab_nemo_phase0_verification.ipynb`) only checked PyTorch-vs-ONNX numerical equivalence on one static dummy clip with precomputed features fed to both paths -- nobody has built or run a lean, ONNX-only NeMo receiver in a live/streaming setting. The "NeMo beats the current production model" comparison is real and well-supported, but it's a comparison against the *PyTorch* NeMo model, not (yet) against anything that could actually ship through the project's ONNX-first deployment convention.

2. **The production receiver's feature extraction is architecture-specific and does not match NeMo's at all.** [`src/audio_receiver_onnx.py`](../../../src/audio_receiver_onnx.py)'s `waveform_to_spectrogram_np` computes a 255-point STFT (hop 128, no mel filterbank) matching the custom CNN's ONNX contract exactly -- confirmed against the model's actual pretrained-checkpoint config (`model.cfg.preprocessor`), NeMo instead uses `AudioToMFCCPreprocessor` (25ms window / 10ms stride, 512-point FFT, 64 mel bins, 64 MFCCs) -- a completely different transform, different bin count (64 vs. 128), different framing. Pointing `AudioCommandReceiverONNX` at a NeMo `.onnx` file without also swapping its feature-extraction function would fail loudly (ONNX Runtime shape-checks the declared `(batch, 64, time)` input against whatever `waveform_to_spectrogram_np` actually produces) rather than silently -- which is the safer of the two possible failure modes, but a naive fix that just reshapes/resizes the STFT output to force the shape to match, instead of computing real MFCC features, would fail silently with garbage predictions. Neither should happen without the work below.

**Also found, unrelated to the above but worth flagging separately:** current production (`main_onnx_shared_vision_audio.py`) is still pointed at `audio_command_classifier_v3.onnx` -- the *original* pre-quarantine, pre-retrain checkpoint (86.3% offline, 4/11 live-stream from the Stage 2 measurement), not even v4 (this plan's own interim custom-CNN recommendation, 6/11). So today's actual baseline for "does NeMo outperform production" is v3, not v4 -- NeMo clearly does either way, but the comparison the user had in mind may have assumed v4 was already deployed.

**Not fixed here -- this needs a real decision, not a unilateral pick, since it changes the live control loop's dependency footprint either way:**
- **Option A: build a lean, ONNX-only NeMo receiver** (`AudioToMFCCPreprocessor`-equivalent feature extraction in numpy/scipy, no NeMo/PyTorch dependency at inference time -- same shape of work as `audio_dsp.py` for the custom CNN), then numerically verify it against NeMo's own preprocessor output before trusting any prediction from it (same "verify before trusting" step Phase 0 already did once for PyTorch-vs-ONNX, needed again here for hand-rolled-MFCC-vs-NeMo's-MFCC). Matches this project's stated ONNX-first deployment convention (`CLAUDE.md`) and the Jetson TensorRT plan. Real, scoped new engineering -- not a config change.
- **Option B: deploy the full NeMo/PyTorch runtime in production instead of ONNX.** Far less new code, but adds `nemo_toolkit[asr]` + `torch` to the main pipeline's dependency footprint (currently just `onnxruntime` + `sounddevice` for audio) and needs a real latency check against `CLAUDE.md`'s non-blocking-inference rule before trusting it on the host PC or Jetson CPU path -- untested either way.

Routed back to the user/orchestrating session for this decision rather than picked unilaterally. `main_onnx_shared_vision_audio.py` was not modified.

## First NOISE_MIX Data Point (2026-09-15) -- Inconclusive, from Half-Trained Checkpoints

Two Colab sessions ran `NOISE_MIX = True` (seed0, seed1) but disconnected before reaching the notebook's own offline-eval/export cells -- only a Lightning `ModelCheckpoint` `.ckpt` survived for each (`models/checkpoints_3x1x64_noisemix_seed{0,1}/`), seed0 at epoch 16 (best `val_acc_micro_top_1` 0.9575), seed1 at epoch 7 (0.9481) -- neither ran to early-stopping completion, so "half-trained" is accurate, not just cautious phrasing.

Built [`evaluations/evaluate_nemo_checkpoint.py`](../../evaluations/evaluate_nemo_checkpoint.py) rather than re-running Colab from scratch -- loads a raw `.ckpt` (or a `.nemo`) locally, reuses the exact offline confusion-matrix logic and `.nemo`/`.onnx` export the notebook's own cells already contain, so a disconnected Colab session's checkpoint doesn't need a full re-run just to get a first read. Exported into `models/nemo_matchboxnet_3x1x64_noisemix_seed{0,1}/`, matching the `RUN_TAG`-based naming convention.

**Offline: both seeds show 100% `backward` recall -- but that number is meaningless for this question, not a win.** The *base* (non-noisemix) 3x1x64 model already hit 100% `backward` recall offline (see the Phase 1 per-class table above) -- `backward`'s failure was never visible in isolated-clip offline eval to begin with; it only shows up in the live-stream test's continuous-noise condition (diagnosed via `nemo_stream_probe.py` as noise-masking). Offline accuracy otherwise: seed0 95.75% (2344/2448), seed1 94.81% (2321/2448) -- both within the established seed-noise band, nothing unusual.

**Live-stream (the test that actually matters here):**

| t | expected | seed0 (epoch 16) | seed1 (epoch 7) |
|---|---|---|---|
| 10s | go_blue | OK | OK |
| 20s | go_green | MISS | MISS |
| 30s | go_yellow | OK | OK |
| 40s | go_red | OK | OK |
| 50s | forward | OK | OK |
| 60s | left | **MISS** | OK |
| 70s | right | OK | OK |
| 80s | backward | **MISS** | **MISS** |
| 90s | hold | OK | OK |
| 100s | stop | OK | OK |
| **Total** | | **7/10** | **8/10** |

Reports: [`evaluations/reports/live_stream_eval_20260915T094149Z.json`](../../evaluations/reports/live_stream_eval_20260915T094149Z.json) (seed0), [`evaluations/reports/live_stream_eval_20260915T094326Z.json`](../../evaluations/reports/live_stream_eval_20260915T094326Z.json) (seed1).

**Read this as a non-result, not a hint of one.** `backward` missed in *both* seeds -- `NOISE_MIX` has not yet produced a single correct live-stream `backward` detection anywhere. (An earlier draft of this section briefly and wrongly said seed1 got `backward` right, written before that run's actual output had come back -- caught and corrected before anyone acted on it, not after.) `go_green` is unchanged (MISS both seeds, as predicted -- `NOISE_MIX` targets noise-masking, not the acoustic near-homophone problem). `left` missing at seed0 only is new and unexplained; could be noise, could be a real side effect of adding the noise perturbation -- one seed can't tell the difference, same lesson this plan has re-learned every time it looked at n<5. **No sign yet that `NOISE_MIX` is fixing what it was built to fix**, though neither run finished training (early stopping never triggered on either) -- worth letting both seeds actually finish (resume from these checkpoints or re-run) before concluding it doesn't work, since a half-trained checkpoint underselling itself is at least as plausible as the fix being ineffective.

## Production Integration, Option B Chosen (2026-09-15/16): New Entry Point Built and Wired Up

Per the user's explicit instruction, went with **Option B** from "Production Integration Check" above (full NeMo/PyTorch runtime) rather than building the ONNX-only MFCC reimplementation -- a real, informed choice, not a default. [`host_software/main_onnx_shared_vision_nemo_audio.py`](../../../main_onnx_shared_vision_nemo_audio.py) is a new, separate entry point (not a flag added to `main_onnx_shared_vision_audio.py`, which another session had in flight at the time) -- vision-side code (`PredictionGate`, `preprocess_warped`, `px_to_touch_mm`, `sigmoid`, constants) is imported from that file unchanged, not duplicated; only STAGE 6's audio backend differs (`NemoAudioCommandReceiver` in place of `AudioCommandReceiverONNX`).

**`NemoAudioCommandReceiver` gained live-microphone support** ([`evaluations/nemo_live_receiver.py`](../../evaluations/nemo_live_receiver.py)) -- it previously only supported file-stream playback (`NotImplementedError` on mic use). Mirrors `AudioCommandReceiverONNX`'s `sounddevice.InputStream` pattern exactly (device lookup by name/index, `stop()` now also closes the stream). **Regression-checked before trusting it**: re-ran the file-stream live-stream eval against the known-good `nemo_matchboxnet_v1` checkpoint before and after this change -- bit-for-bit identical result (8/10, same two misses) both times.

**Real dependency-footprint consequence, checked, not assumed away:** installing `nemo_toolkit[asr]` into `ball_balance_env` (the project's standard interpreter, previously only verified in an isolated `nemo_local` conda env) triggered real pip dependency-resolver conflicts -- `protobuf` (6.33.6 vs. `google-ai-generativelanguage`/`grpcio-status`'s `<6.0` requirement), `huggingface_hub` (1.31.0 vs. `lerobot==0.4.4`'s `<0.36.0` requirement), `numpy` (2.2.6 vs. `openvino`'s `<2.2.0` requirement), `fsspec` (downgraded to 2025.12.0 vs. `s3fs`'s `>=2026.6.0` requirement -- `s3fs` backs DVC's S3/MinIO remote). **Checked each rather than trusting pip's warning or assuming it away:** `google.genai`, `lerobot`, `openvino`, `s3fs`, and `dvc` all still import cleanly; `dvc remote list` still correctly resolves the `homeserver` remote. Not an exhaustive functional test of each (no actual Gemini API call, LeRobot conversion, or DVC push/pull round-trip attempted) -- worth watching for if anything downstream of those starts behaving oddly, but no breakage found. Added `nemo_toolkit[asr]` to `environment.yml`/`requirements.txt` per `CLAUDE.md` convention.

**Full end-to-end verification in `ball_balance_env` itself** (not just `nemo_local`): re-ran the file-stream live-stream eval one more time through the newly-installed `ball_balance_env` interpreter -- identical 8/10 result, confirming no numerical drift between environments.

**What's still explicitly NOT verified, and can't be from this session** (per this session's standing scope -- audio/vision development, not physical hardware): an actual live microphone, or the real robot end-to-end. `main_onnx_shared_vision_nemo_audio.py --dummy-audio` and `--scripted-sequence` paths are confirmed working (exercise the same vision/state-machine code as the existing entry point); the real NeMo mic path needs verification on the user's own machine.

**The default checkpoint wired into the new entry point is the preliminary, half-trained `NOISE_MIX` seed0 checkpoint from the section above** (per explicit instruction, for integration-testing purposes) -- not the plan's actually-recommended checkpoint (`models/nemo_matchboxnet_v1/matchboxnet_finetuned.nemo`, 9/11 live-stream, no known regressions). Pass `--audio-model` to use that instead once a validated accuracy number (not a plumbing check) is what's needed.

## Colab Data Flow: DVC Revert Was Intentional (2026-09-17)

Noticed `colab_nemo_finetune.ipynb`'s `git clone` + Tailscale + `dvc pull` restructure (see "Production Integration Check" era of this doc) and the checkpoint `dvc push` cell were both missing from the notebook's current committed state, and flagged it as a possible accidental revert before touching anything else. **Confirmed intentional, not accidental:** the user reverted to the `prepare_colab_package.py` zip/Drive flow because DVC-over-Tailscale was more friction than it was worth specifically inside Colab's environment -- the zip flow is the one to build on going forward for this notebook, not something to "fix" back. Noted here so this doesn't get rediscovered and re-flagged as a regression later.

## Colab Reconnect Support Added (2026-09-17)

Confirmed via direct code inspection that this notebook had **no resume support at all** -- `trainer.fit(model)` was called with no `ckpt_path`, and `model` was always freshly built via `from_pretrained()` + `change_labels()` at the top of the notebook. A Colab disconnect meant the next run silently re-fine-tuned from the original pretrained checkpoint from scratch, with no error or warning that this had happened. This is the confirmed root cause behind the `NOISE_MIX` seed0/seed1 checkpoints in "First NOISE_MIX Data Point" above being permanently stuck half-trained -- there was no way to continue them, only to evaluate them as-is via a separate local script.

**Fix, per the new `model-iteration-constraints` item ("every cloud/Colab training notebook needs reconnect support"):**
- `ModelCheckpoint` now has `save_last=True` alongside the existing `save_top_k=1` -- writes `CHECKPOINT_DIR/last.ckpt` on every epoch end, capturing full trainer state (epoch count, optimizer/scheduler state, and `EarlyStopping`'s own patience counter, since callback states are checkpointed too), not just the best-scoring weights.
- New `RESUME_IF_AVAILABLE` toggle (default `True`) in the `SEED`/`MODEL_VARIANT`/`NOISE_MIX` config cell. When a `last.ckpt` already exists at this exact run's `CHECKPOINT_DIR` (i.e. the same `SEED`/`MODEL_VARIANT`/`NOISE_MIX` combination), `trainer.fit()` resumes from it instead of starting fresh. Set to `False` to force a fresh run -- resuming into a run whose config has since changed would silently mix two experiments' worth of training into one checkpoint.

**Verified locally before trusting it, not assumed from the Lightning docs alone:** built a fresh model object (`from_pretrained()` + `change_labels()`, same as the notebook does every run -- not a reload from the checkpoint directly, since the real question is whether `ckpt_path=` correctly restores state on top of a newly-constructed model), ran 2 epochs, confirmed `last.ckpt` was written, then in a **separate** process rebuilt the model fresh again and called `trainer.fit(model, ckpt_path=last.ckpt)` with `max_epochs=4`. Lightning logged `Restoring states from the checkpoint path` / `Restored all states from the checkpoint`, and training continued to `current_epoch=4` (global_step 36) rather than restarting at epoch 0 and redoing epochs 0-1 -- confirms resume genuinely continues training rather than merely reloading weights.

**Not retroactive:** the existing `NOISE_MIX` seed0/seed1 checkpoints predate `save_last=True` and have no `last.ckpt` to resume from -- they remain stuck as evaluated via `evaluate_nemo_checkpoint.py`, same as before. This only prevents the failure mode going forward.

**Correction (2026-09-18): the seed0 checkpoint is no longer stuck.** `models/checkpoints_3x1x64_noisemix_seed0/` now contains `last-v1.ckpt` and a new `matchboxnet_3x1x64_noisemix_finetuned-seed0-epoch=027-val_acc_micro_top_1=0.9575.ckpt` (both dated 2026-09-18, i.e. training resumed and continued past the epoch-16 checkpoint this section was written against). Re-ran `evaluate_nemo_checkpoint.py` against the epoch=027 checkpoint: offline accuracy is 95.75% (2344/2448) -- bit-for-bit identical correct-count to epoch=016 -- but the per-class distribution is not identical, so this is a plateau, not a no-op:

| class | epoch=016 | epoch=027 | delta |
|---|---|---|---|
| `_background_` | 89.9% (358/398) | 90.2% (359/398) | +0.3 |
| `backward` | 100% (123/123) | 99.2% (122/123) | -0.8 |
| `forward` | 91.1% (113/124) | 91.9% (114/124) | +0.8 |
| `go_blue` | 99.2% (238/240) | 96.7% (232/240) | -2.5 |
| `go_green` | 98.75% (237/240) | 99.2% (238/240) | +0.45 |
| `go_grey` | 99.2% (124/125) | 98.4% (123/125) | -0.8 |
| `go_red` | 90.4% (216/239) | 93.3% (223/239) | +2.9 |
| `go_yellow` | 99.6% (239/240) | 99.6% (239/240) | 0 |
| `hold` | 96.2% (225/234) | 97.4% (228/234) | +1.2 |
| `left` | 98.3% (119/121) | 98.3% (119/121) | 0 |
| `right` | 92.7% (115/124) | 98.4% (122/124) | **+5.7** |
| `stop` | 98.75% (237/240) | 93.8% (225/240) | **-5.0** |

Net: the extra 11 epochs mostly traded `stop`/`go_blue` recall for `right`/`go_red` recall rather than improving overall -- consistent with this run having plateaued rather than meaningfully improved, and not (yet) evidence that resuming past epoch 16 was worth it. Report: [`evaluations/reports/nemo_finetune_confusion_matrix_3x1x64_noisemix_seed0_20260918T074046Z.json`](../../evaluations/reports/nemo_finetune_confusion_matrix_3x1x64_noisemix_seed0_20260918T074046Z.json). Re-exported `.nemo`/`.onnx` in `models/nemo_matchboxnet_3x1x64_noisemix_seed0/` from this epoch=027 checkpoint (overwrites the epoch=016-derived export that was there before). **Live-stream re-eval against this new export has not been run** -- `evaluate_nemo_live_receiver_stream.py` instantiates `NemoAudioCommandReceiver`, which imports `sounddevice` at module level even in its pre-recorded-file-replay mode, and this session's auto-mode classifier blocked running it as a precaution against physical audio-hardware access; it needs to be run by the user directly (see command handed back at the end of that session's report) before this checkpoint's live-stream number can be filled in here.

## Proposed Modular Refactor

Target layout for `host_software/ml_audio/`, mirroring the `ml_vision` convention:

- **`core/`** (new) — deterministic DSP: matched filter, spectral-subtraction noise-profile application, energy gating, feature extraction. Currently scattered across `audio_receiver_pytorch.py` / `audio_pytorch_runtime.py`.
- **`data_processing/`** (exists, currently only `generate_noise_profile.py`) — dataset assembly and background-clip diversification; absorb the notebook's data-loading/labeling cells, add segmentation/labeling tooling for the 23-minute lab recording, and add an ingestion path that reads the existing `synthetic+real_dataset_large/training_v2/{train,val}/<class>/` layout as-is (see discrepancy note above — we're preserving compatibility with a second lab partner's dataset contract we don't have the generating source for, not re-deriving it from scratch).
- **`training/`** (new) — model definition + training loop extracted from the notebook into a plain script, e.g. `train_audio_command_classifier.py`.
- **`evaluations/`** (new) — confusion matrix + accuracy reporting extracted from the notebook, **persisted** (raw counts JSON + plot) on every run instead of ephemeral notebook output. This directly closes the reproducibility gap that made this exercise mostly guesswork.
- **`tests/`** (exists, `test_audio.py`) — unchanged, functional tests only.
- **`models/`** (exists) — unchanged.
- **`docs/`** (new, this file) — plans and pipeline docs, mirroring `ml_vision/docs/`.

**Migration principle:** lift-and-shift first, no architecture or retraining changes bundled in. Extract notebook cells into equivalent scripts with output parity, get persisted evaluation artifacts working, *then* act on the background-diversification/noise-profile plan and the red/green + forward/hold investigations as separate follow-on tasks. Keep the original notebook in place as read-only historical reference (same treatment `ml_vision` gives `experimental_variants/`) — do not delete it. Because two former lab partners' work is being consolidated here (6-class notebook author, and the separate, unlocated author of the 12-class dataset/training code), treat both existing artifacts — the notebook *and* the `synthetic+real_dataset_large/` folder contract — as read-only ground truth to preserve, not to silently pick one and discard the other.

## Proposed Order of Work

1. ~~Extend the corruption audit beyond `go_red`~~ — **done.** `audit_dataset_corruption.py` scanned all 12 classes/both splits; found corruption concentrated in `go_red`/`stop`/`hold`/`go_blue`/`left`, zero elsewhere.
2. ~~Apply remediation~~ — **done.** `apply_dataset_quarantine.py` moved the 254 flagged non-background clips to `_quarantined_corrupt/`; re-audit confirms 0 empty/truncated across every command class. `_background_`'s flags were left in place (tracked separately, not corruption).
3. ~~Extract evaluation logic~~ — **done.** `evaluations/evaluate_audio_classifier.py` persists confusion matrix JSON + PNG on every run, and reproduces the known 0.870 baseline (86.3% on the post-quarantine val set).
4. ~~Fix live receiver label order (Stage 1)~~ — **done.** 7.4% → 47.9% on the production-preprocessing-otherwise-unchanged test. Real bug, real fix.
5. ~~Simplify live receiver preprocessing to match training (Stage 2)~~ — **done**, but revealed the real bottleneck isn't preprocessing: live continuous-stream test (`evaluate_live_receiver_stream.py` against `master_evaluation_audio.wav`) only detects 4/11 commands correctly, with `_background_` dominating almost the entire stream. Root cause traces back to the background-training-data problem, not anything fixable in the receiver code.
6. ~~The retrain track~~ — **done for a first pass.** `training/train_audio_command_classifier.py` exists, targets the 12-class layout, and trains the full network end-to-end (see "Correction" section above for why a linear-probe-on-frozen-features approach, tried first, didn't work). **v4** (quarantine-cleaned, pre-diversification) trained and measured: 83.5% offline, 6/11 live (up from 4/11), mixed per-class results.
7. ~~Re-run both eval scripts after retraining~~ — **done for v4**, see results table above. Live-stream number *did* move (4/11 → 6/11) and the failure mode improved (no more wrong-command misfires, only misses). Re-run again for v5 once that finishes (in progress).
8. Extract data loading/labeling into `data_processing/` as a general ingestion module — **partially done**: the corruption audit (`audit_dataset_corruption.py`) and now background segmentation (`segment_background_recording.py`) both exist as standing scripts reading the `training_v2/{train,val}/<class>/` layout directly. Not yet done: wiring the corruption audit into a single ingestion pipeline entry point, and sub-labeling tooling for background noise sub-types (see Open Questions).
9. ~~Prioritize background-source-diversification~~ — **done.** `segment_background_recording.py` added 899 train / 158 val real-noise clips from the 23-minute recording (see section above). **v5** retrained on top of this and both eval scripts re-run: offline metrics and background recall both improved over v4, but live-stream regressed (6/11 → 5/11) — see the v3/v4/v5 table above. Diversification is not yet a clean, unambiguous win on the metric that matters most.
10. **Next: a tuning pass, not another single-shot retrain.** Both v4 and v5 show the same overfitting signature (train accuracy → ~100% by epoch 30, val accuracy noisy thereafter) from a deliberately minimal first-pass procedure (no augmentation, no class weighting, no regularization/early-stopping beyond keeping the best-val epoch). Before deciding whether background diversification actually helps live performance, or picking either v4 or v5 as "the" retrain result: add early stopping, class-weight `go_red` specifically (weakest class in both retrains, and the one now producing false positives in v5's live-stream log), and ideally run 2-3 seeds per configuration to separate real effects from training-run noise.

## Open Questions

- **Does background diversification actually help live performance, net?** v5 improved every offline metric (accuracy, background recall +16.4 points) but regressed the live-stream number (6/11 → 5/11) versus v4, with a new failure mode (spurious `go_red` false positives in windows where `go_red` isn't correct, replacing what used to be safer "no detection" misses). This is exactly the kind of gap between offline and live metrics the plan has been trying to close since Stage 2 — worth resolving with a tuning/multi-seed pass (see step 10) before concluding either way.
- `go_red` recall is the one command class that hasn't recovered even after quarantine removed its worst corruption (67.1% v3 → 50.2% v4 → 54.8% v5, all below the original) and is now implicated in v5's new live-stream false positives — deserves targeted attention (class weighting, or a closer look at whether quarantine actually removed enough of the bad clips) rather than assuming the corruption fix alone would resolve it.
- Whether the model architecture itself (~13.5K params, unusual Conv→ReLU→BatchNorm ordering — see "Correction" section above) is fundamentally limited for separating command-plus-noise mixtures, independent of data/training quality — not yet answerable; requires the tuning pass above to rule out "just needs better training" first.
- Ball-drop/typing-as-distinct-label question from prior discussion remains open, deferred until per-sub-type eval reporting exists to quantify rather than guess.
