Jack0468/ball_balance_video_controlled/host_software/ml_audio/evaluations/reports/confusion_matrix_20260811T031039Z.png

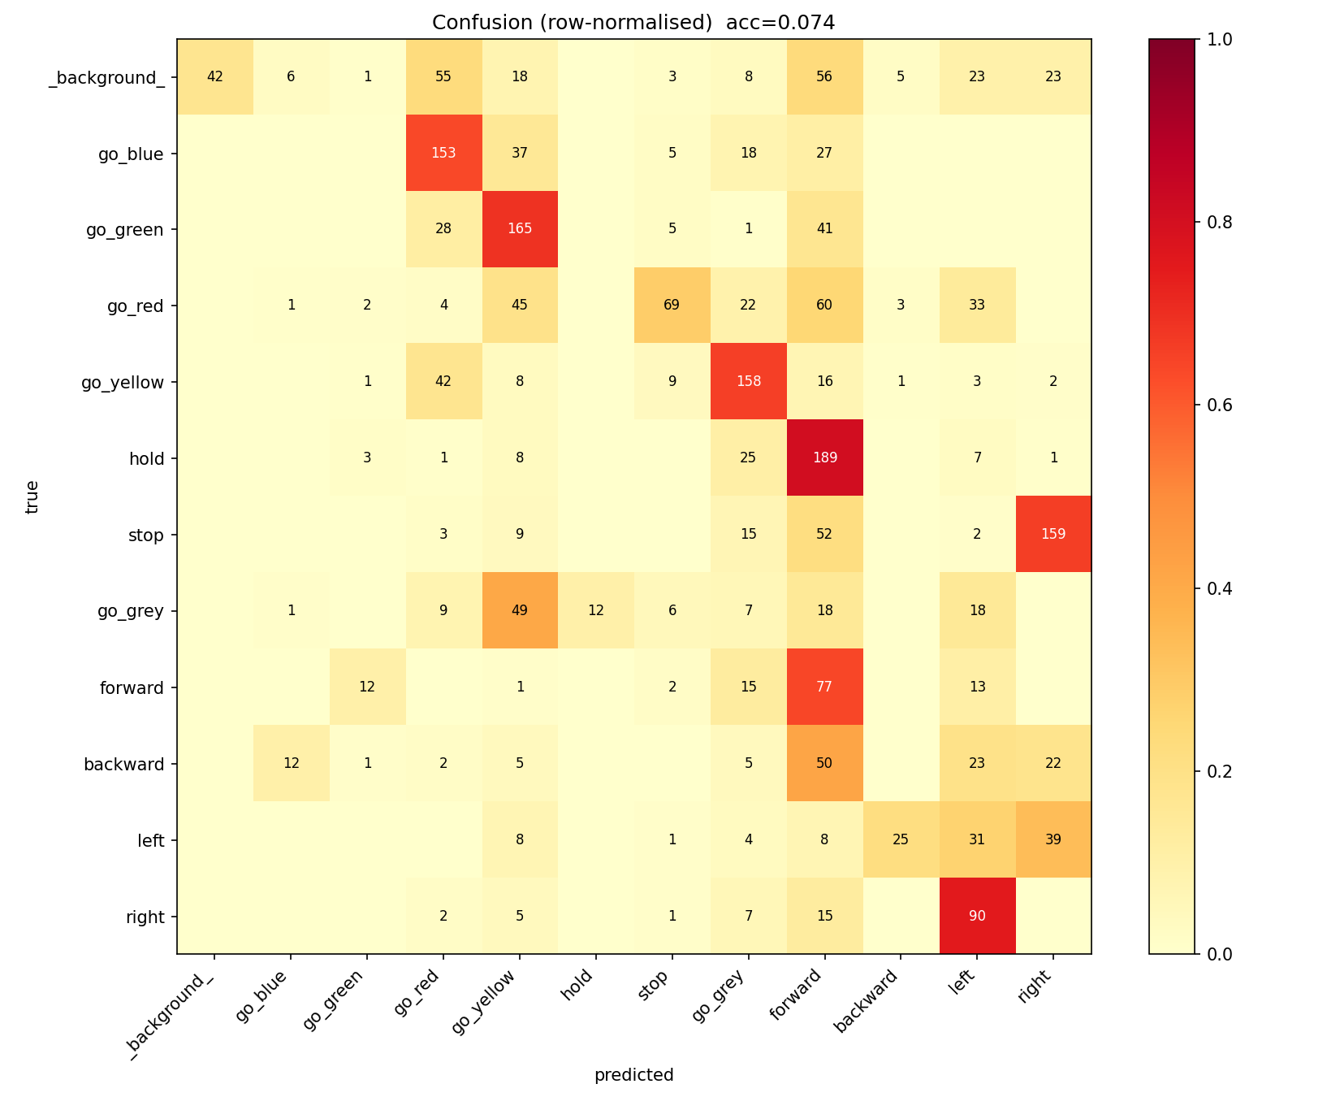
host_software/ml_audio/evaluations/reports/confusion_matrix_20260811T031039Z.png
