Jack0468/ball_balance_video_controlled/hardware/cad/Parts/ov7670-cuiisw-1.snapshot.2/OV7670 cuiisw.png

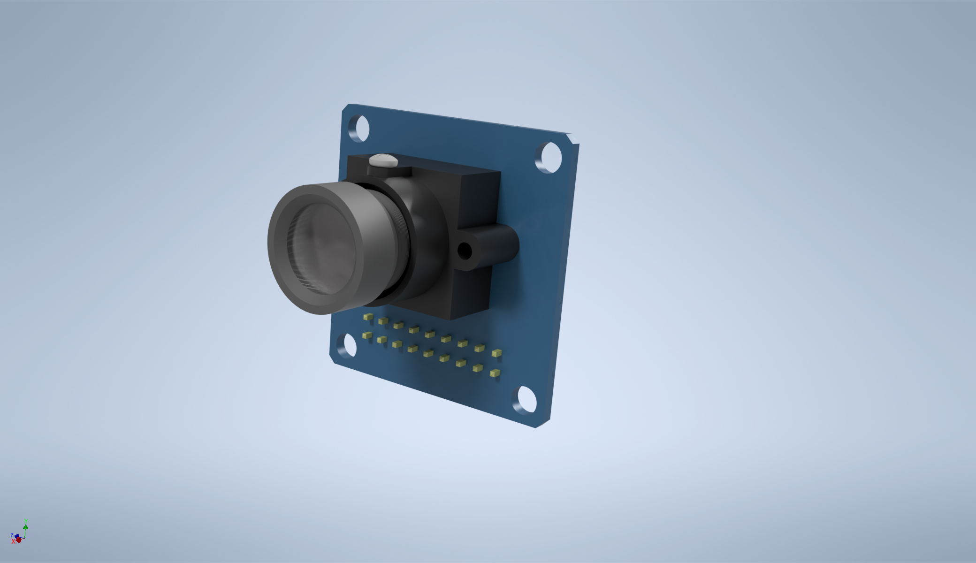
hardware/cad/Parts/ov7670-cuiisw-1.snapshot.2/OV7670 cuiisw.png
