Jack0468/ball_balance_video_controlled/hardware/cad/parts_labeled/1.png

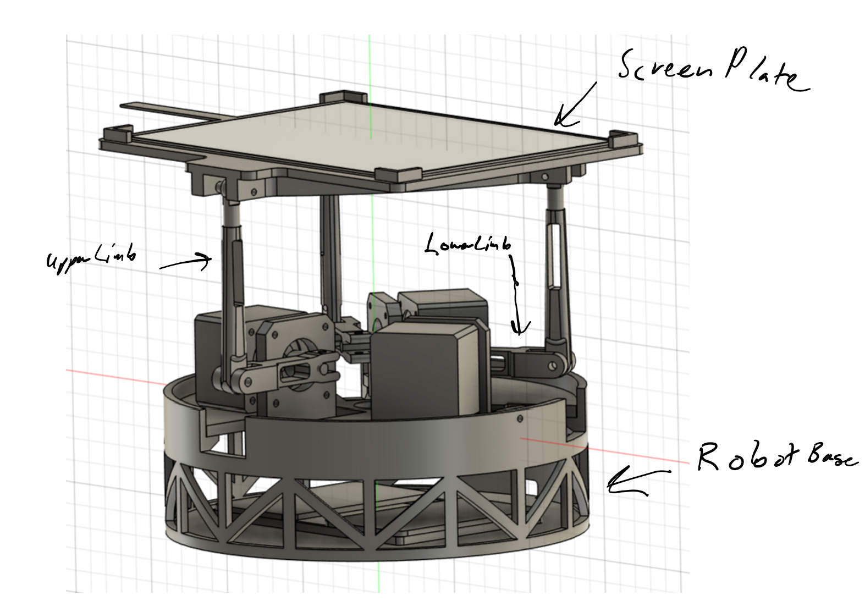
hardware/cad/parts_labeled/1.png
