Jack0468/ball_balance_video_controlled/hardware/cad/parts_labeled/Screenshot 2026-06-26 093134.png

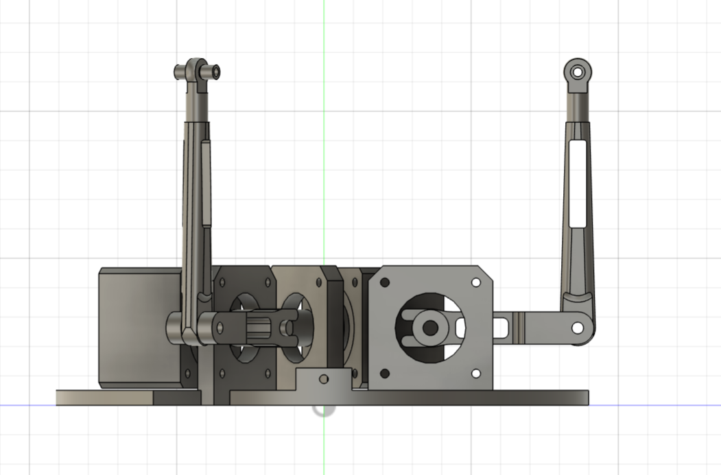
hardware/cad/parts_labeled/Screenshot 2026-06-26 093134.png
