Jack0468/ball_balance_video_controlled/hardware/cad/Robot Full Assem.SLDASM

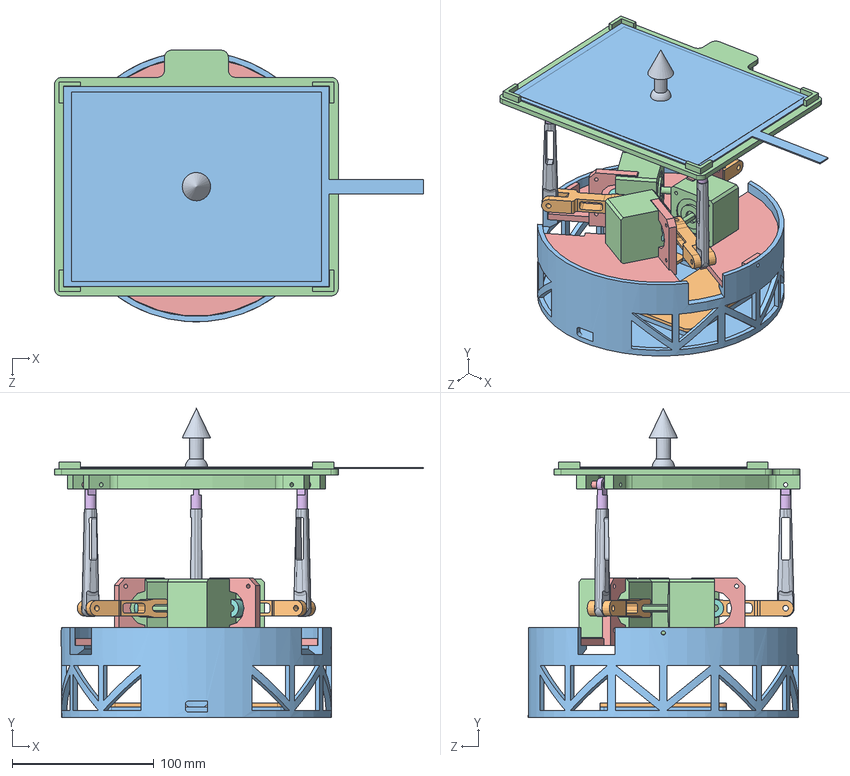
[picture p20: CAD file, 2026-07-02]
hardware/cad/Robot Full Assem.SLDASM
260.0 x 217.9 x 191.5 mm
Redesigned MotorPlate
6627T91_Stepper Motor x 3
RobotBase
LowerLimbNew x 3
UpperLimb x 3
Shaft Spacer x 3
TieRod Ball x 3
TieRod Base x 3
M3 Spacer x 6
ScreenPlate
LCD Screen
template_breadboard x 2
NormalVector
