Jack0468/ball_balance_video_controlled/hardware/cad/Parts/LowerLimb.SLDPRT

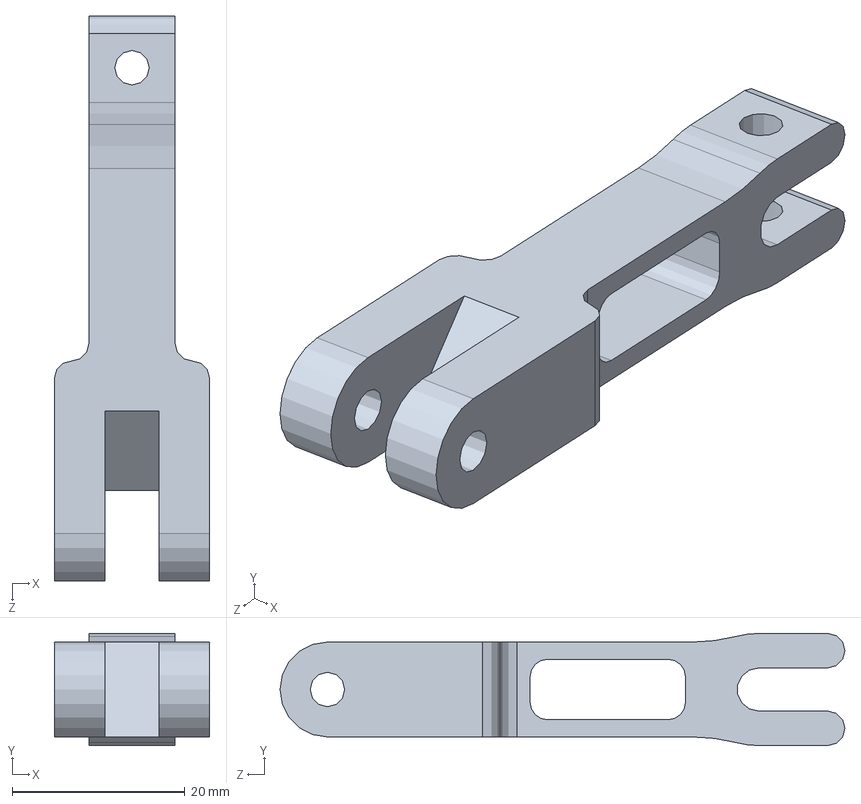
[picture p21: CAD file, 2026-07-13]
hardware/cad/Parts/LowerLimb.SLDPRT
18.0 x 13.0 x 65.5 mm
