Jack0468/ball_balance_video_controlled/hardware/cad/Parts/ov7670-cuiisw-1.snapshot.2/OV7670 CUIISW.stp

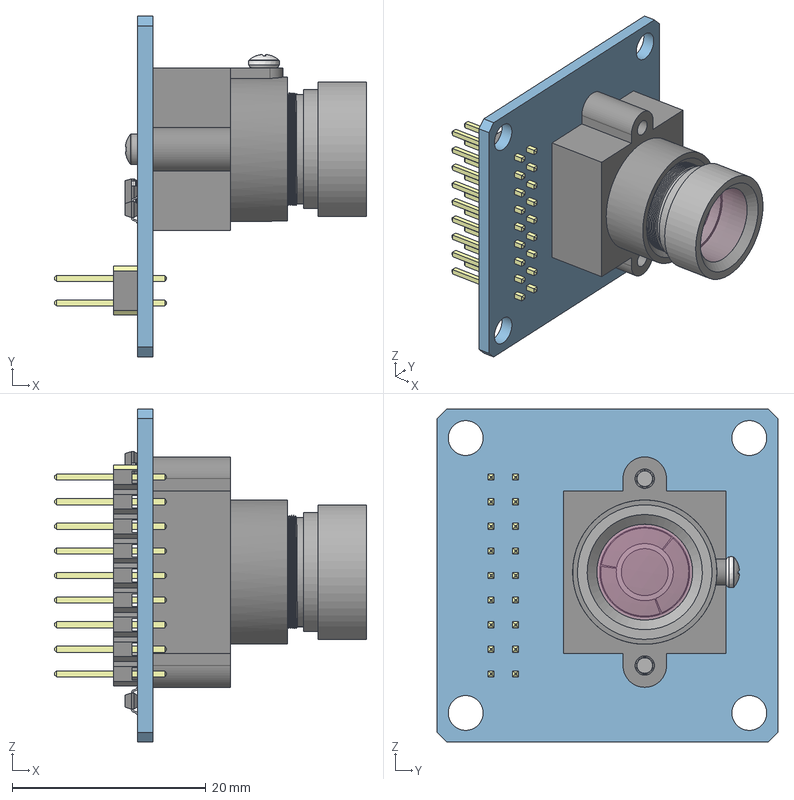
[picture p22: CAD file, 2026-07-13]
hardware/cad/Parts/ov7670-cuiisw-1.snapshot.2/OV7670 CUIISW.stp
32.2 x 35.2 x 34.4 mm
OV7670 cuiisw house
OV7670 cuiisw pcb
OV7670 cuiisw lens unit
92000A001_Passivated 18-8 Stainless Steel Pan Head Phillips Screws
pan head cross recess screw_iso x 2
PLS (DS1021-2xN)
TRANS_2SB852K_ROM x 2
