Jack0468/ball_balance_video_controlled/hardware/cad/STLs/ScreenPlate (1) updated version final.stl

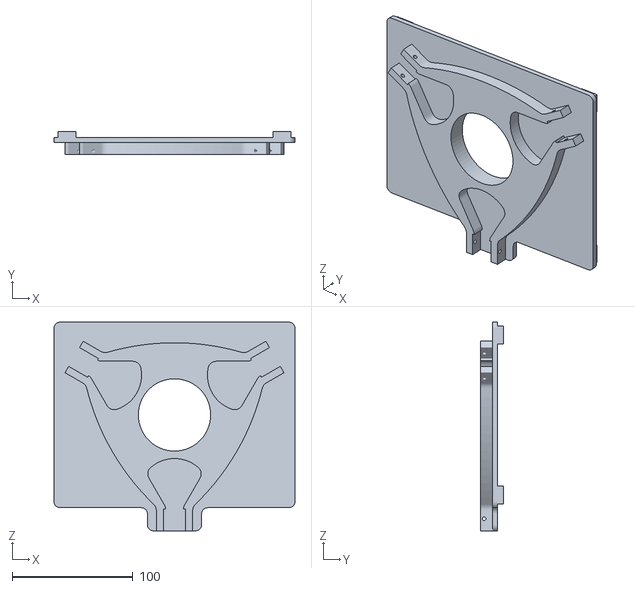
[picture p23: CAD file, 2026-07-13]
hardware/cad/STLs/ScreenPlate (1) updated version final.stl
200.0 x 19.0 x 173.2
