Jack0468/ball_balance_video_controlled/hardware/cad/Parts/StepperMotor.SLDPRT

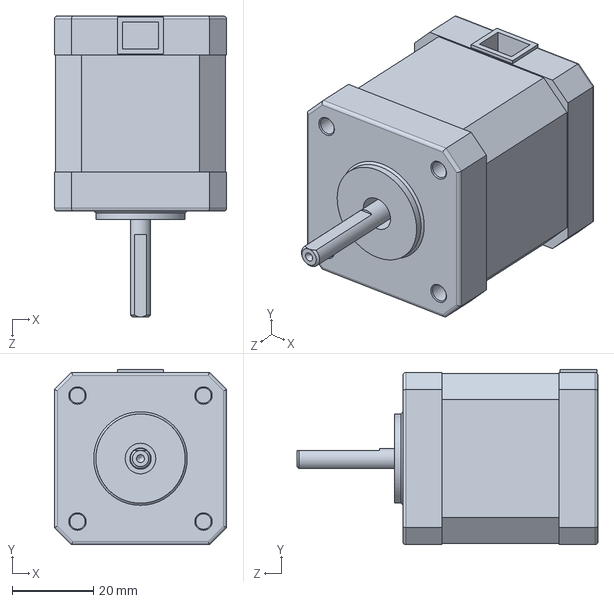
[picture p24: CAD file, 2026-07-13]
hardware/cad/Parts/StepperMotor.SLDPRT
42.4 x 43.2 x 74.0 mm
