Jack0468/ball_balance_video_controlled/hardware/cad/STLs/ball_balance_USYDthinkspace.3mf

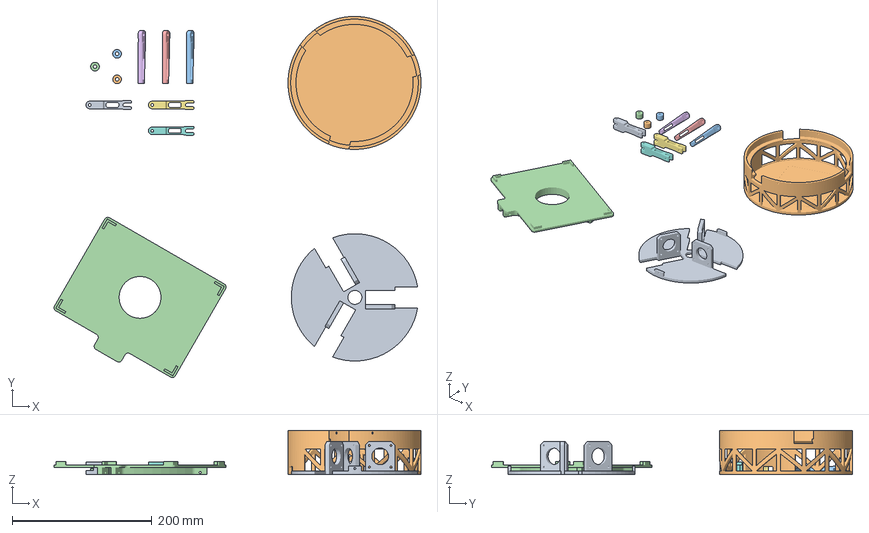
[picture p25: CAD file, 2026-07-02]
hardware/cad/STLs/ball_balance_USYDthinkspace.3mf
525.7 x 517.3 x 63.5 mm
MotorPlate.STL
RobotBaseNew.stl
UpperLimb.STL x 3
ScreenPlate.STL
LowerLimb.STL x 3
ShaftSpacer.STL x 3
