Jack0468/ball_balance_video_controlled/hardware/cad/STLs/RobotBaseNew.stl

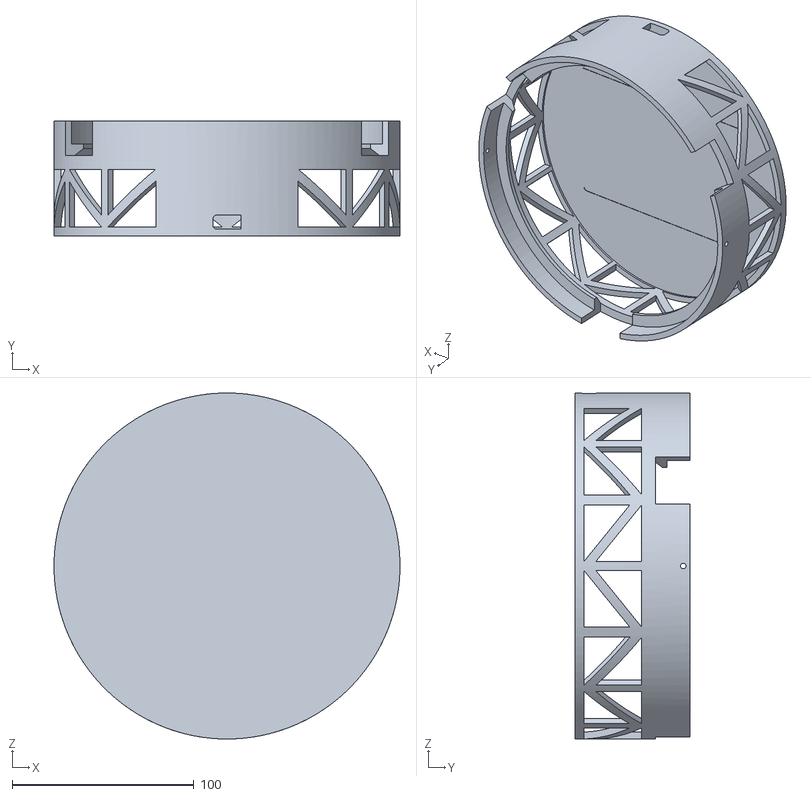
[picture p26: CAD file, 2026-07-02]
hardware/cad/STLs/RobotBaseNew.stl
190.5 x 63.5 x 190.5
