Jack0468/ball_balance_video_controlled/hardware/cad/Parts/M3 Spacer.SLDPRT

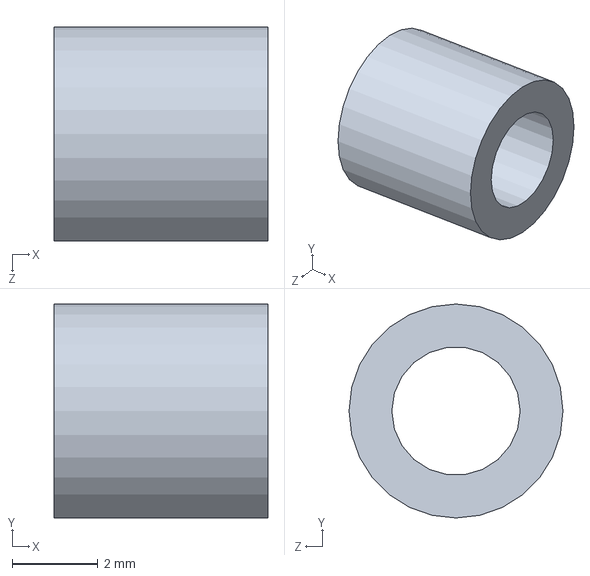
[picture p27: CAD file, 2026-07-13]
hardware/cad/Parts/M3 Spacer.SLDPRT
5.00 x 5.00 x 5.00 mm
