Jack0468/ball_balance_video_controlled/hardware/cad/Parts/enclosure_camera1.stl

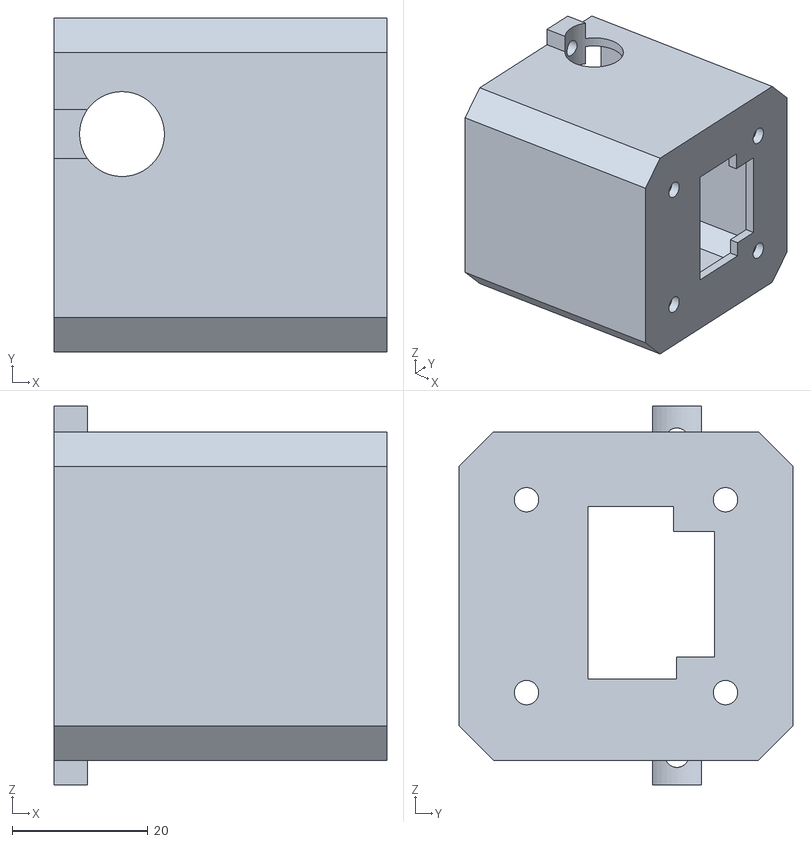
[picture p28: CAD file, 2026-07-13]
hardware/cad/Parts/enclosure_camera1.stl
49.0 x 49.2 x 55.8
