Jack0468/ball_balance_video_controlled/hardware/cad/Parts/TieRod Base.SLDPRT

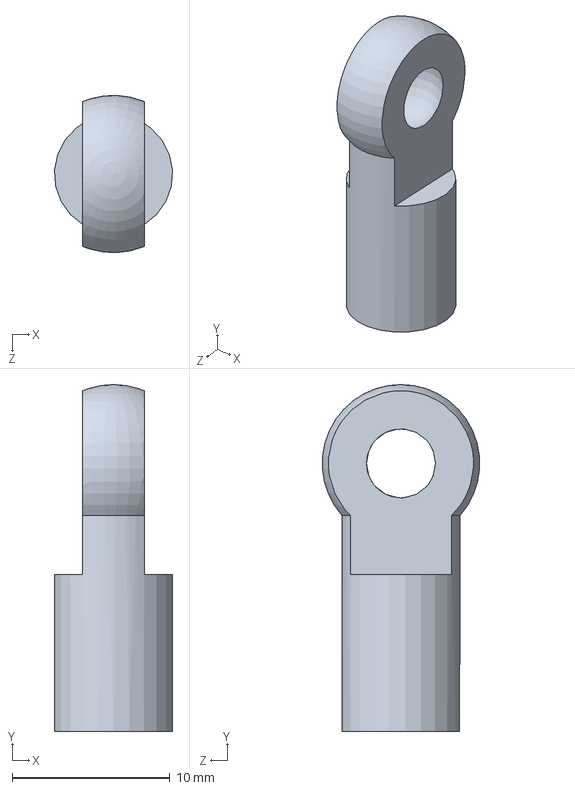
[picture p29: CAD file, 2026-07-13]
hardware/cad/Parts/TieRod Base.SLDPRT
7.48 x 22.0 x 9.97 mm
