Jack0468/ball_balance_video_controlled/hardware/cad/Parts/LCD Screen.SLDPRT

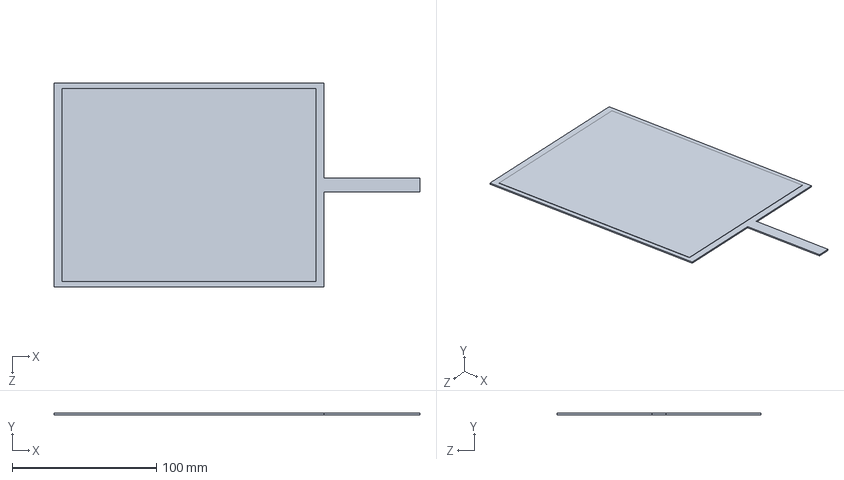
[picture p30: CAD file, 2026-07-13]
hardware/cad/Parts/LCD Screen.SLDPRT
253.5 x 1.58 x 141.0 mm
