Jack0468/ball_balance_video_controlled/hardware/cad/Parts/NormalVector.SLDPRT

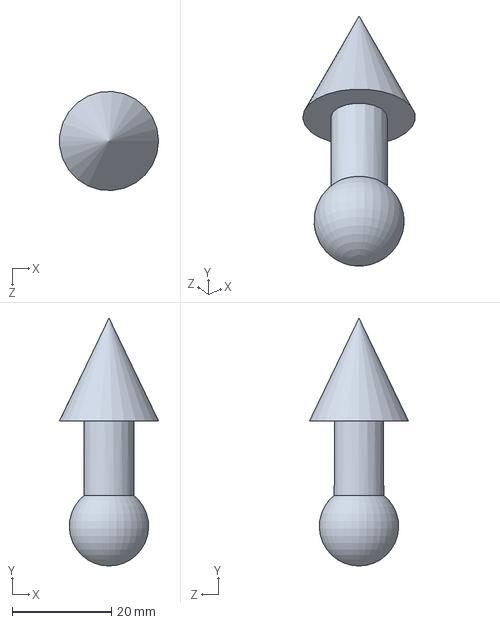
[picture p31: CAD file, 2026-07-13]
hardware/cad/Parts/NormalVector.SLDPRT
20.0 x 50.0 x 20.0 mm
