Jack0468/ball_balance_video_controlled/hardware/cad/Parts/Shaft Spacer.SLDPRT

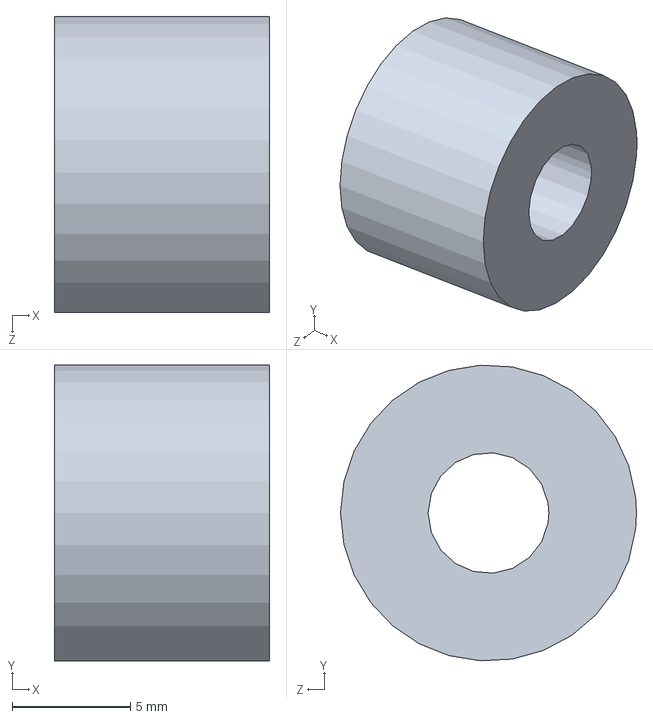
[picture p32: CAD file, 2026-07-13]
hardware/cad/Parts/Shaft Spacer.SLDPRT
9.10 x 12.5 x 12.5 mm
