Jack0468/ball_balance_video_controlled/hardware/cad/Parts/Redesigned MotorPlate.SLDPRT

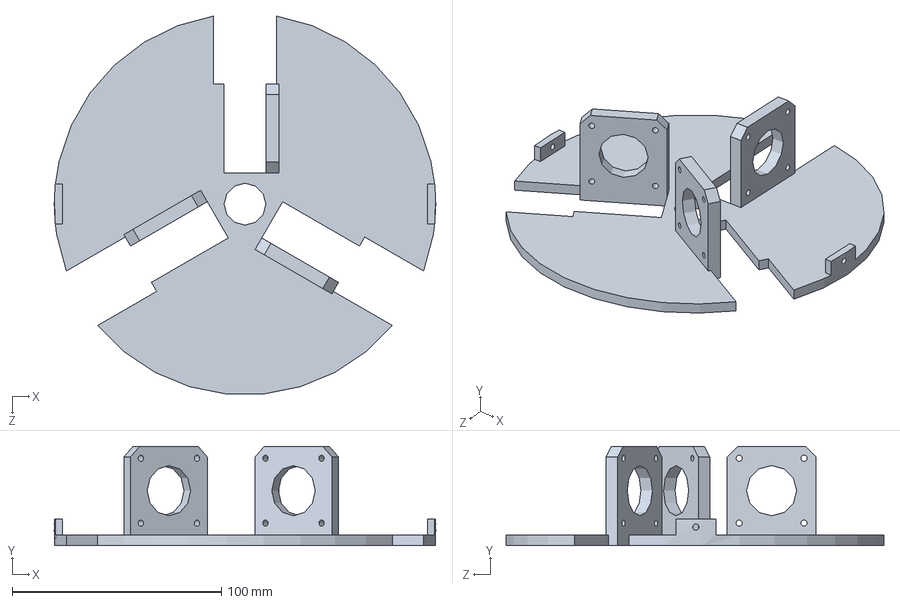
[picture p33: CAD file, 2026-07-13]
hardware/cad/Parts/Redesigned MotorPlate.SLDPRT
182.3 x 47.5 x 180.6 mm
