Jack0468/ball_balance_video_controlled/hardware/cad/Parts/BreadboardPlaceholder.SLDPRT

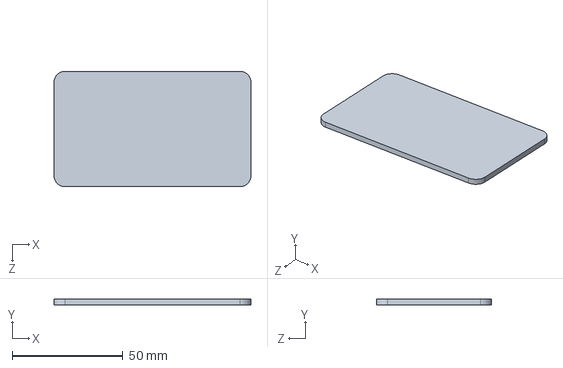
[picture p34: CAD file, 2026-07-13]
hardware/cad/Parts/BreadboardPlaceholder.SLDPRT
88.9 x 2.50 x 52.1 mm
