Jack0468/ball_balance_video_controlled/hardware/cad/Parts/Stepper Motor NEMA 17.SLDPRT

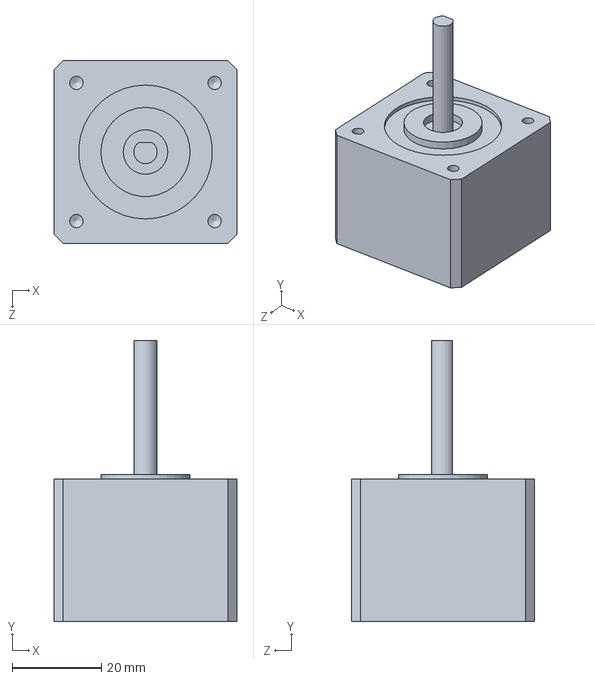
[picture p35: CAD file, 2026-07-13]
hardware/cad/Parts/Stepper Motor NEMA 17.SLDPRT
41.0 x 63.0 x 41.0 mm
