Jack0468/ball_balance_video_controlled/hardware/cad/Parts/OV7670_enclosure.stl

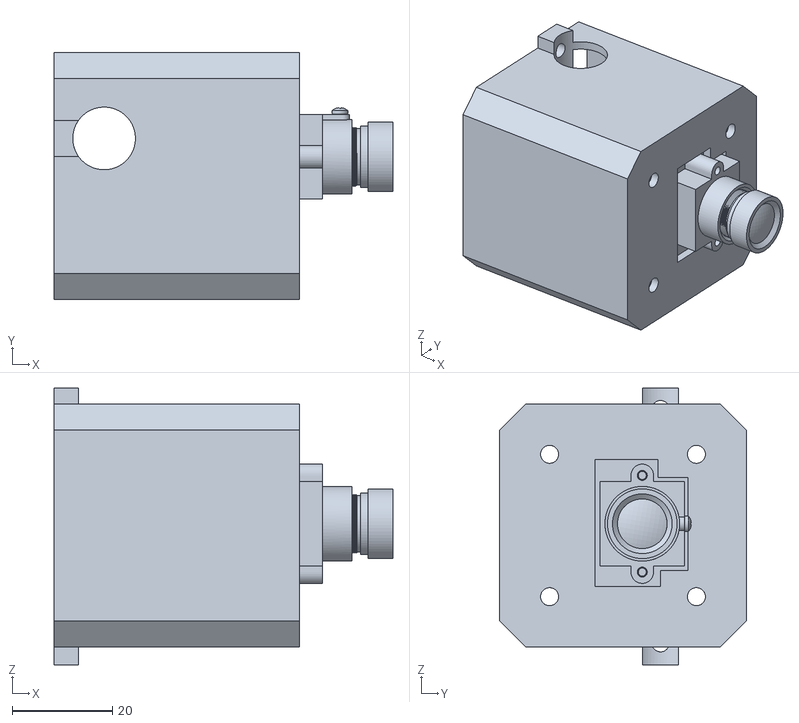
[picture p36: CAD file, 2026-07-13]
hardware/cad/Parts/OV7670_enclosure.stl
67.6 x 49.2 x 55.2
