Jack0468/ball_balance_video_controlled/hardware/cad/Parts/UpperLimb.SLDPRT

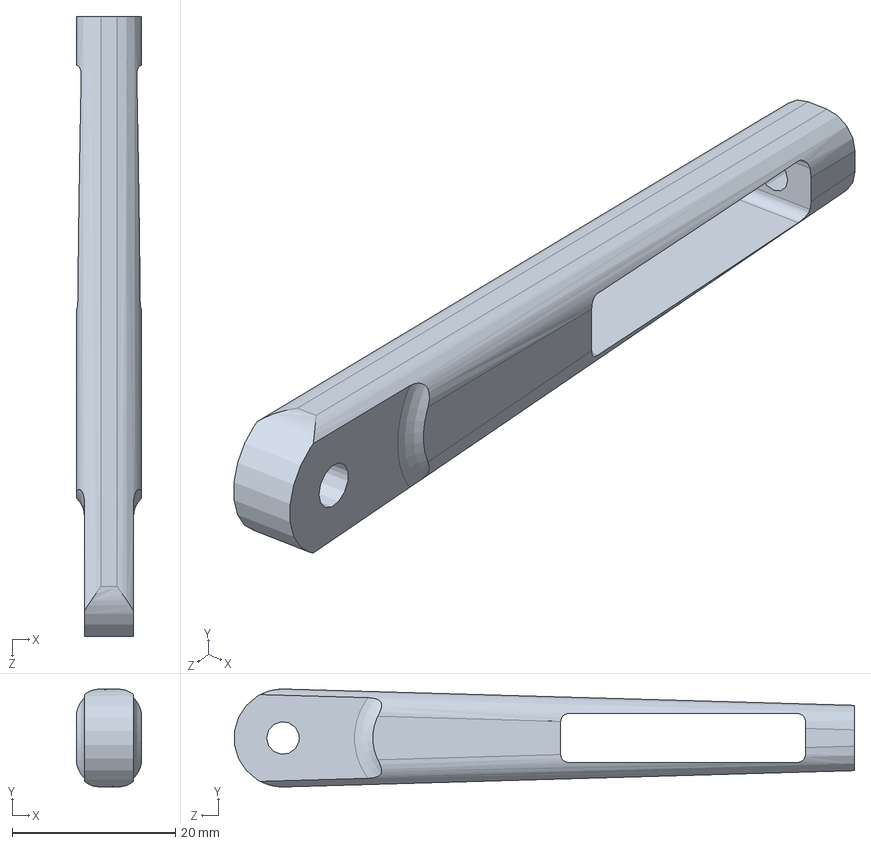
[picture p37: CAD file, 2026-07-13]
hardware/cad/Parts/UpperLimb.SLDPRT
8.00 x 12.0 x 75.9 mm
