Jack0468/ball_balance_video_controlled/hardware/cad/Parts/TieRod Ball.SLDPRT

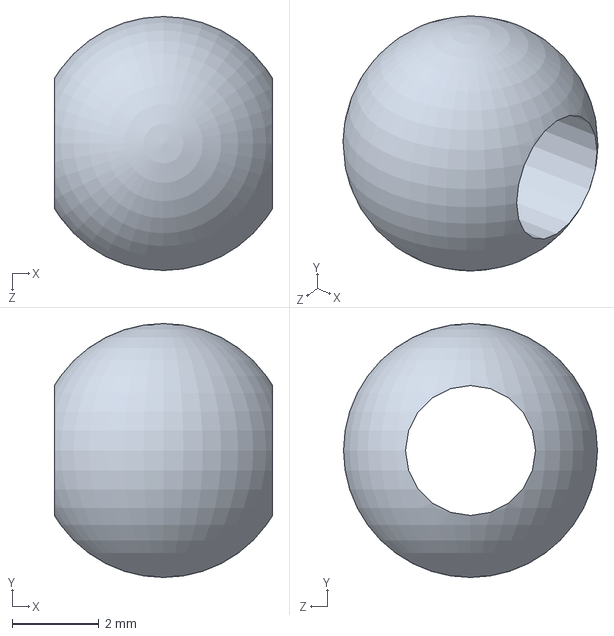
[picture p38: CAD file, 2026-07-13]
hardware/cad/Parts/TieRod Ball.SLDPRT
5.03 x 5.86 x 5.86 mm
