Jack0468/ball_balance_video_controlled/(list of files, cad)

Other CAD files:
hardware/cad/Parts/ScreenPlate.SLDPRT
hardware/cad/Parts/RobotBase.SLDPRT
hardware/cad/STLs/LowerLimb.STL
hardware/cad/STLs/MotorPlate.STL
hardware/cad/STLs/RobotBase.STL
hardware/cad/STLs/ScreenPlate.STL
hardware/cad/STLs/ShaftSpacer.STL
hardware/cad/STLs/UpperLimb.STL
