Jack0468/ball_balance_video_controlled/firmware/ExpertEvaluationFirmware/readme.txt

added main2.py
added touch_logger.py in src (logs data collected)
all files in here have been adjusted for compiling on stm32
