Jack0468/ball_balance_video_controlled/host_software/ml_vision/experiments/results/ANALYSIS_2026-08-13.md

# Decoder Trial (ConvTranspose2d vs. Upsample+Conv2d) — Analysis (2026-08-13)

Hard data and results only. For narrative on what was built/fixed and why, see `docs/PROJECT_LOGBOOK.md` (13/08/2026 entry).

Motivation: `ConvTranspose2d` requires a custom hls4ml layer for FPGA deployment; `Upsample`+`Conv2d` uses two natively-supported hls4ml layers. Comparing accuracy and parameter cost to inform that choice. All runs: `trial_decoder_upsample_vs_transpose.py`, 600-row stratified subset of Dataset 8, 8 epochs, `TrialSharedVisionBackbone` (encoder/ball_head identical to production; only `mask_head`/`heatmap_head` decoder swapped).

---

## Run 1 — 3-seed average (seeds 42-44), production loss weights (mask=0.5, heatmap=0.1)

| Decoder | Ball px error (mean ± std) | Mask IoU (mean ± std) | Mask Dice | Heatmap MSE | Params |
|---|---|---|---|---|---|
| transpose | 33.2 ± 2.3px | 0.639 ± 0.087 | 0.740 | 0.030 | 64,260 |
| upsample_conv | 36.6 ± 9.6px | 0.797 ± 0.072 | 0.871 | 0.055 | 91,140 |

Per-seed (this run only — see Run 2 for the corrected 5-seed picture):

| Seed | Decoder | Ball px error | Mask IoU |
|---|---|---|---|
| 42 | transpose | 30.97 | 0.648 |
| 42 | upsample_conv | 29.31 | 0.843 |
| 43 | transpose | 33.06 | 0.721 |
| 43 | upsample_conv | 47.42 | 0.715 |
| 44 | transpose | 35.60 | 0.547 |
| 44 | upsample_conv | 33.00 | 0.834 |

## Run 2 — 5-seed average (seeds 42-46), production loss weights (mask=0.5, heatmap=0.1)

| Decoder | Ball px error (mean ± std) | Mask IoU (mean ± std) | Mask Dice | Heatmap MSE | Params |
|---|---|---|---|---|---|
| transpose | 36.2 ± 7.3px | 0.440 ± 0.153 | 0.516 | 0.035 | 64,260 |
| upsample_conv | 34.5 ± 7.3px | 0.819 ± 0.060 | 0.879 | 0.059 | 91,140 |

Per-seed:

| Seed | Decoder | Ball px error | Mask IoU |
|---|---|---|---|
| 42 | transpose | 29.36 | 0.612 |
| 42 | upsample_conv | 28.24 | 0.847 |
| 43 | transpose | 46.91 | 0.592 |
| 43 | upsample_conv | 31.82 | 0.712 |
| 44 | transpose | 32.04 | 0.383 |
| 44 | upsample_conv | 38.67 | 0.833 |
| 45 | transpose | 32.44 | 0.275 |
| 45 | upsample_conv | 28.44 | 0.851 |
| 46 | transpose | 40.40 | 0.339 |
| 46 | upsample_conv | 45.08 | 0.850 |

## Run 3 — 5-seed average, reduced loss weights (mask=0.25, heatmap=0.05)

| Decoder | Ball px error (mean ± std) | Mask IoU (mean ± std) | Mask Dice | Heatmap MSE | Params |
|---|---|---|---|---|---|
| transpose | 31.5 ± 1.2px | 0.414 ± 0.230 | 0.477 | 0.042 | 64,260 |
| upsample_conv | 32.4 ± 2.8px | 0.665 ± 0.146 | 0.743 | 0.074 | 91,140 |

## Run 4 — 5-seed average, low loss weights (mask=0.1, heatmap=0.02)

| Decoder | Ball px error (mean ± std) | Mask IoU (mean ± std) | Mask Dice | Heatmap MSE | Params |
|---|---|---|---|---|---|
| transpose | 31.6 ± 1.7px | 0.380 ± 0.112 | 0.425 | 0.043 | 64,260 |
| upsample_conv | 31.5 ± 1.7px | 0.680 ± 0.122 | 0.760 | 0.058 | 91,140 |

---

## Interpretation

- **Run 1 (3 seeds) was misleading on ball-tracking variance.** It showed `upsample_conv` with a ~4x higher ball-error std than `transpose` (9.6 vs 2.3px), driven entirely by one seed (43). Run 2 (5 seeds, same weights) shows the two decoders' ball-error std is statistically indistinguishable (7.3 vs 7.3px) — the apparent instability was small-sample noise, not a decoder-specific property. Same lesson as the augmentation trial's Run 2 (`ANALYSIS_2026-08-11.md`): a single seed's ranking can flip on noise alone; this project's default should be >=5 seeds before trusting a ranking, not 3.
- **Mask/heatmap loss weight has a large, consistent effect on ball-tracking variance, for both decoders.** Ball-error std drops from ~7.3px (weights 0.5/0.1) to ~1.2-1.7px (weights 0.25/0.05 and 0.1/0.02) for both `transpose` and `upsample_conv` — consistent with shared-encoder gradient competition between the ball task and the mask/heatmap tasks (the risk `ml_system_parameter_budget.md`'s Option A section anticipated). Reducing mask/heatmap weight resolves it symmetrically; it is not a lever that favors one decoder over the other.
- **`upsample_conv`'s mask IoU advantage over `transpose` holds at every weight setting tested**, 15 seed-runs per decoder across Runs 2-4: +0.379 IoU (weights 0.5/0.1), +0.251 IoU (0.25/0.05), +0.300 IoU (0.1/0.02). `transpose`'s mask IoU is also considerably less consistent across seeds at every weight setting (std 0.11-0.23 vs `upsample_conv`'s 0.06-0.15), including three individual seeds landing at 0.275-0.383 in Run 2.
- **At the lowest loss weights (Run 4), ball-tracking is statistically tied between decoders (31.5 vs 31.6px) while `upsample_conv` still holds a large mask IoU lead (0.680 vs 0.380).** This is the strongest evidence in the trial: once the ball-tracking instability is controlled for via loss reweighting, `upsample_conv` no longer costs anything on the ball-tracking axis and keeps most of its mask-quality advantage.
- Parameter cost is consistent across all runs: `upsample_conv` uses 91,140 params vs `transpose`'s 64,260 (+42%, +~53KB at 16-bit) — both comfortably inside the 612.5KB FPGA BRAM budget on their own.
