Jack0468/ball_balance_video_controlled/host_software/ml_vision/experiments/results/ANALYSIS_2026-08-11.md

# Augmentation Strategy Trial — Analysis (2026-08-11)

Hard data and results only. For narrative on what was built/fixed and why, see `docs/PROJECT_LOGBOOK.md` (11/08/2026 entry).

---

## Dataset 8 density / data quality

- Total rows: 52,772.
- Coverage at the 10-samples/cell floor: 100% (192/192 cells).
- Real per-cell density: min 50, P25 228, median 274, mean 246.7, P75 283.2, max 284, std 52.8.
- Rows with `ball_x_px`/`ball_y_px` outside the `[0,128]`px frame: 19/52,772 (0.036%). Extremes: one row at `ball_y_px = 284.9`.

---

## Run 1 — single-seed, 600-row subset, 8 epochs, 6 variants

| Rank | Variant | Ball px error | Ball loss | Mask loss | Heatmap loss | Total loss |
|---|---|---|---|---|---|---|
| 1 | photometric | 27.8px | 0.0146 | 0.2734 | 0.0249 | 0.1538 |
| 2 | autoaugment_proxy | 31.5px | 0.0185 | 0.2712 | 0.0246 | 0.1566 |
| 3 | geometric_jitter | 33.2px | 0.0203 | 0.2748 | 0.0255 | 0.1603 |
| 4 | shadow | 34.8px | 0.0213 | 0.2764 | 0.0244 | 0.1620 |
| 5 | combined | 38.0px | 0.0250 | 0.2728 | 0.0238 | 0.1638 |
| 6 | baseline | 52.4px | 0.0454 | 0.2735 | 0.0244 | 0.1845 |

## Run 2 — 5-seed average, 200-row subset, 3 epochs, 8 variants

| Rank | Variant | Ball px error (mean ± std) | Total loss (mean ± std) |
|---|---|---|---|
| 1 | combined | 41.5 ± 1.9px | 0.367 ± 0.047 |
| 2 | shadow | 42.0 ± 4.1px | 0.369 ± 0.045 |
| 3 | autoaugment_proxy | 42.2 ± 2.5px | 0.369 ± 0.046 |
| 4 | photometric | 46.5 ± 6.2px | 0.374 ± 0.050 |
| 5 | baseline | 50.0 ± 10.2px | 0.384 ± 0.037 |
| 6 | blur | 51.3 ± 5.3px | 0.386 ± 0.048 |
| 7 | occlusion | 52.9 ± 8.1px | 0.389 ± 0.041 |
| 8 | geometric_jitter | 54.4 ± 9.8px | 0.395 ± 0.047 |

## Run 3 — `geometric_jitter` re-run at full scale, 600-row subset, 8 epochs, single seed

| Variant | Ball px error | Total loss |
|---|---|---|
| geometric_jitter | 32.8px | 0.156 |

---

## Interpretation

- Run 2's top cluster (combined, shadow, autoaugment_proxy, photometric) beats its bottom cluster (baseline, blur, occlusion, geometric_jitter) consistently across all 5 seeds. Within each cluster, the spread is smaller than 1 std dev — no strict ordering is supported within a cluster.
- `geometric_jitter`: 33.2px (Run 1, full scale) vs. 54.4px ± 9.8 (Run 2, reduced scale) vs. 32.8px (Run 3, full scale repeat). Run 3 confirms Run 1, not Run 2 — the poor Run 2 showing is a training-budget artifact (200 rows / 3 epochs insufficient for this variant to converge), not evidence of a weak augmentation.
- At full training scale (600 rows / 8 epochs), the ranking is: photometric < autoaugment_proxy < geometric_jitter < shadow < combined < baseline (best to worst by ball px error). Photometric-only and shadow-containing variants are the most consistently strong performers across both scales tested.
- `baseline` (no augmentation) is the clear worst performer at full scale (Run 1: 52.4px, ~1.6-1.9x every augmented variant), but only mid-pack at reduced scale (Run 2: 50.0px ± 10.2, high variance) — augmentation's benefit is more pronounced with more training budget in this data.
