Jack0468/ball_balance_video_controlled/fpga/camera_i2c/test_frame.png

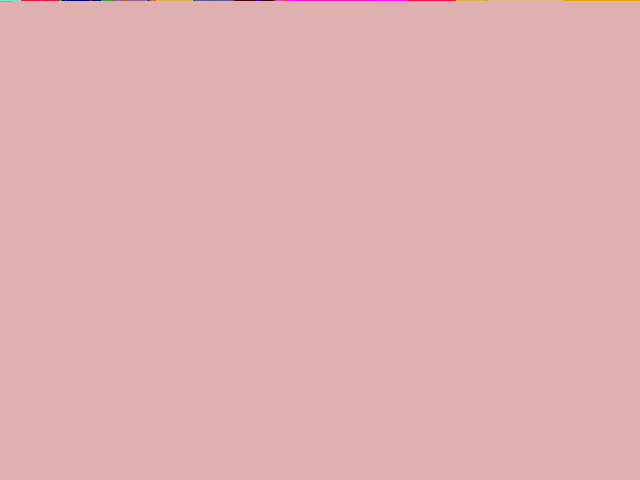
fpga/camera_i2c/test_frame.png
