Jack0468/ball_balance_video_controlled/host_software/evaluations/pid_baseline/trajectory_plot.png

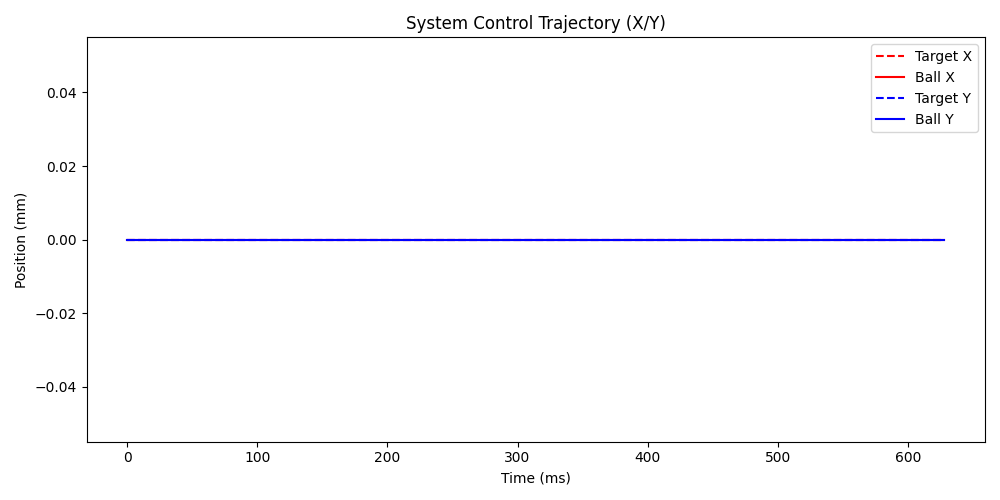
host_software/evaluations/pid_baseline/trajectory_plot.png
