Jack0468/ball_balance_video_controlled/host_software/ml_vision/evaluations/laptop_camera_telemetry_coverage_plot.png

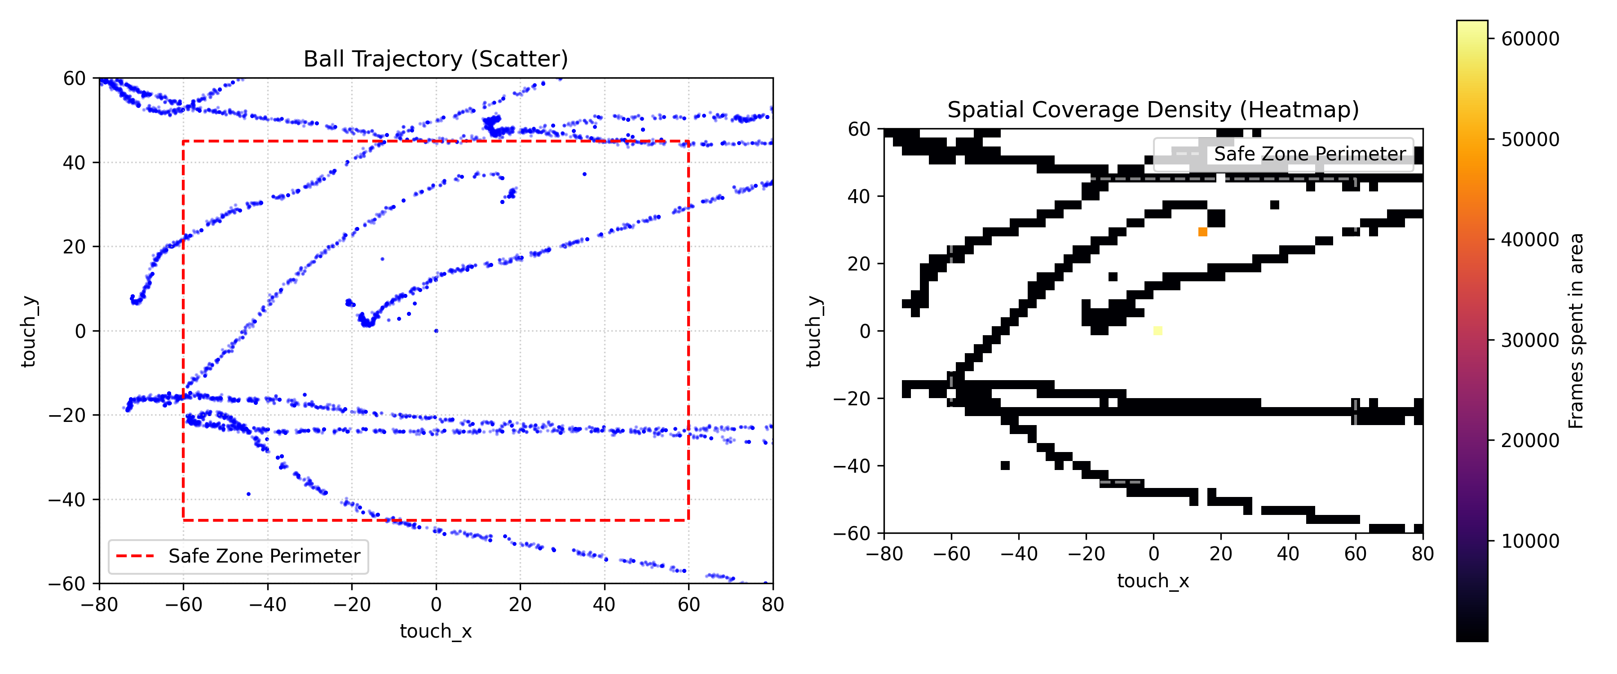
host_software/ml_vision/evaluations/laptop_camera_telemetry_coverage_plot.png
