Jack0468/ball_balance_video_controlled/host_software/ml_vision/evaluations/model_comparisons_all_models.png

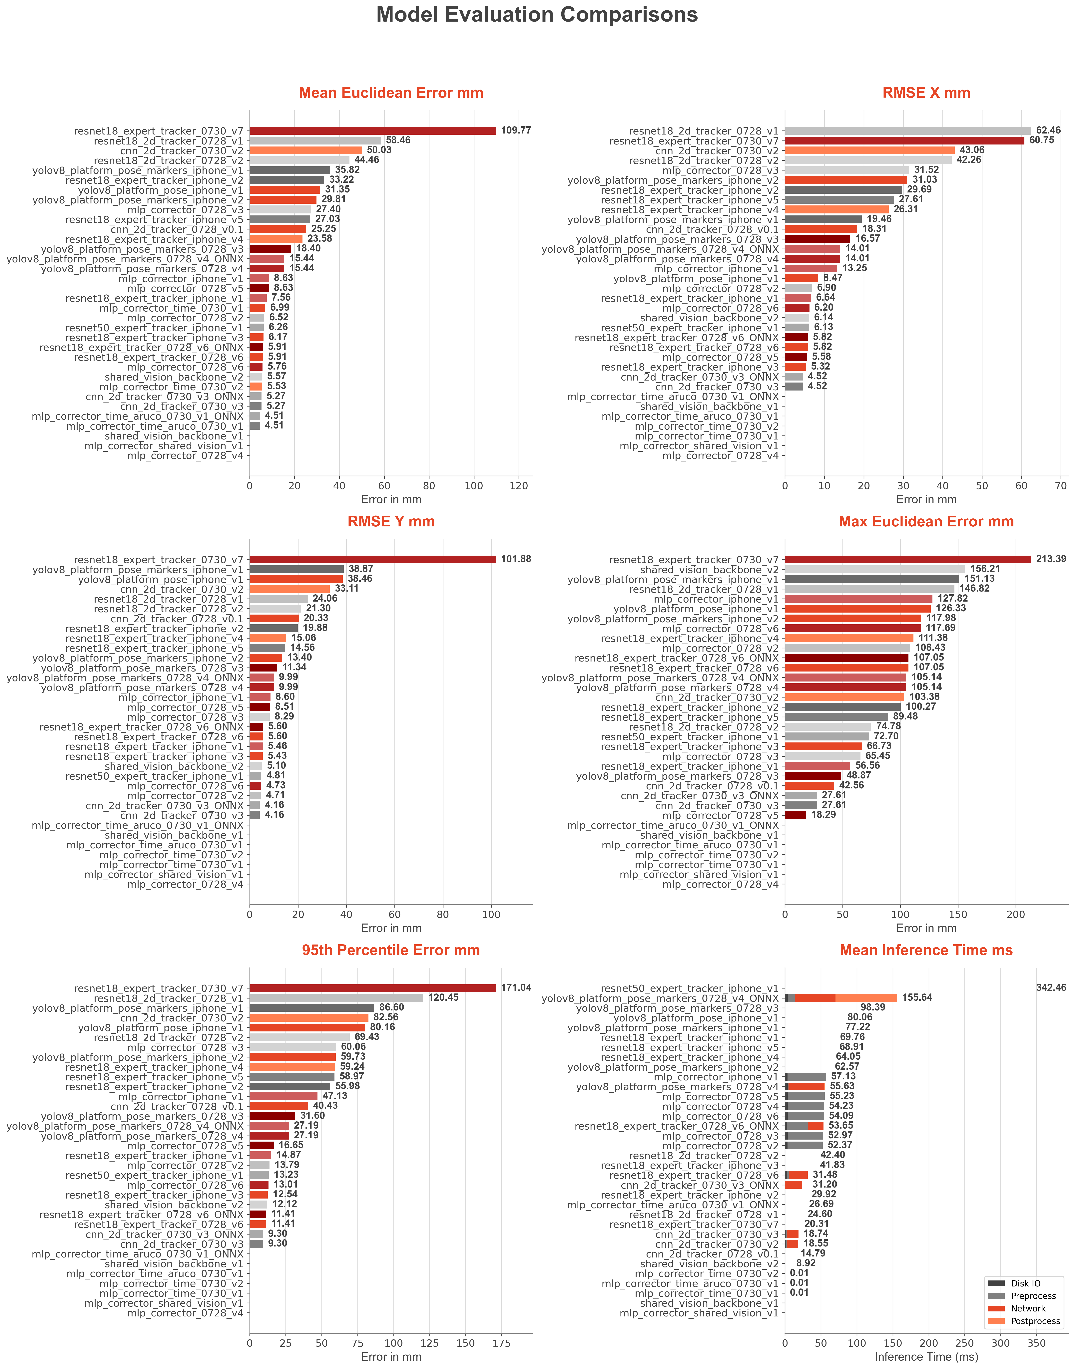
host_software/ml_vision/evaluations/model_comparisons_all_models.png
