Jack0468/ball_balance_video_controlled/host_software/ml_vision/evaluations/model_comparisons_mlp.png

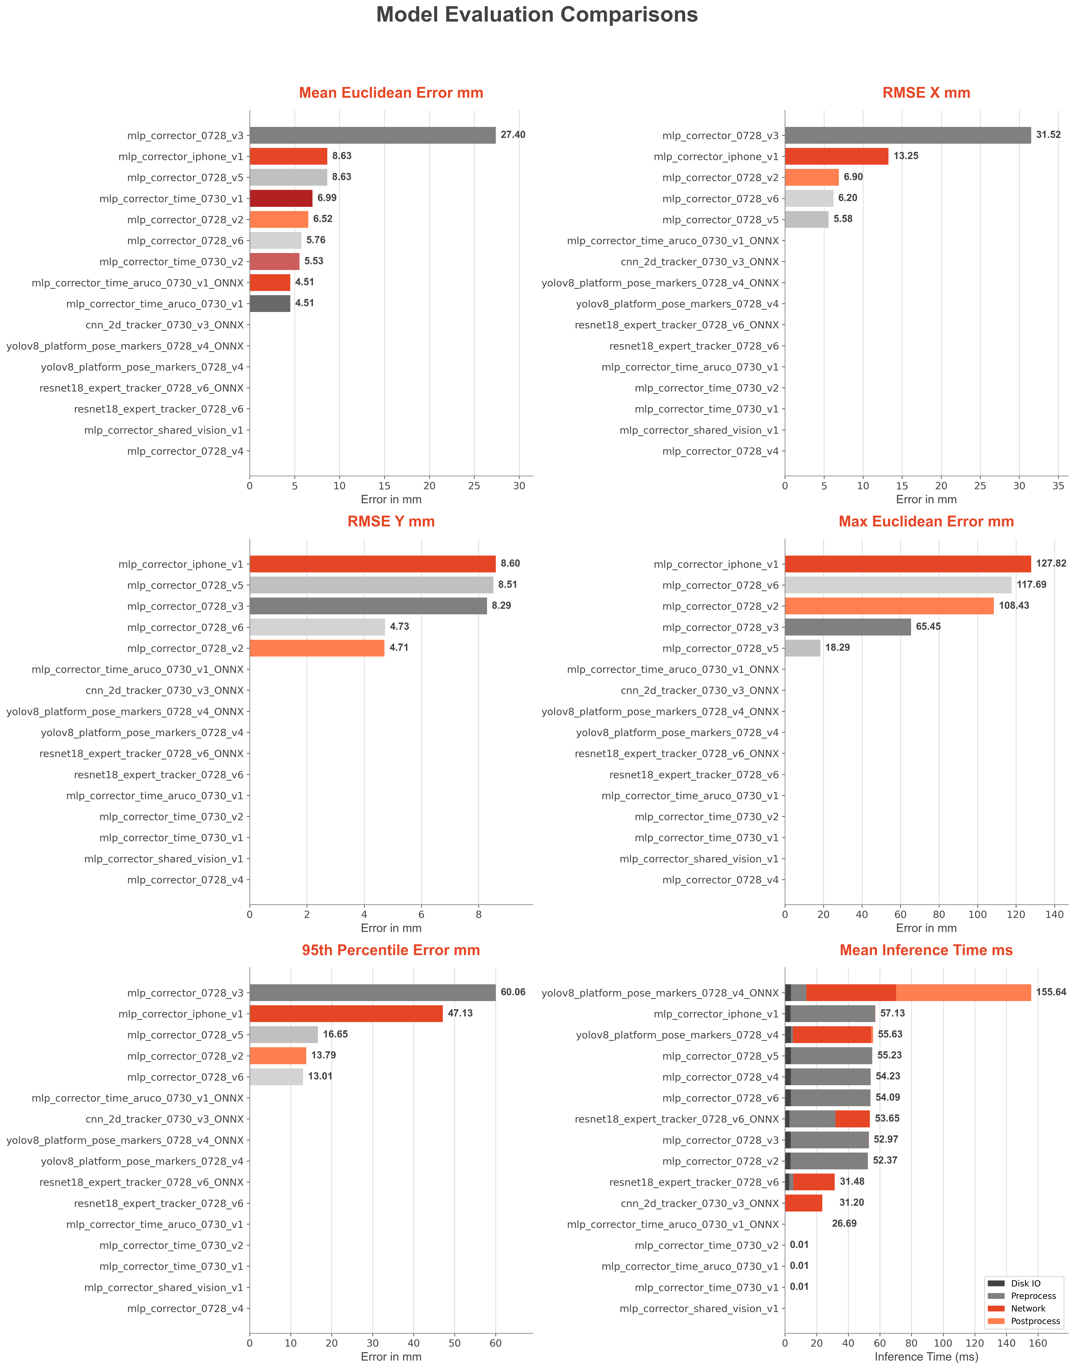
host_software/ml_vision/evaluations/model_comparisons_mlp.png
