Jack0468/ball_balance_video_controlled/host_software/ml_vision/evaluations/model_comparisons_yolo.png

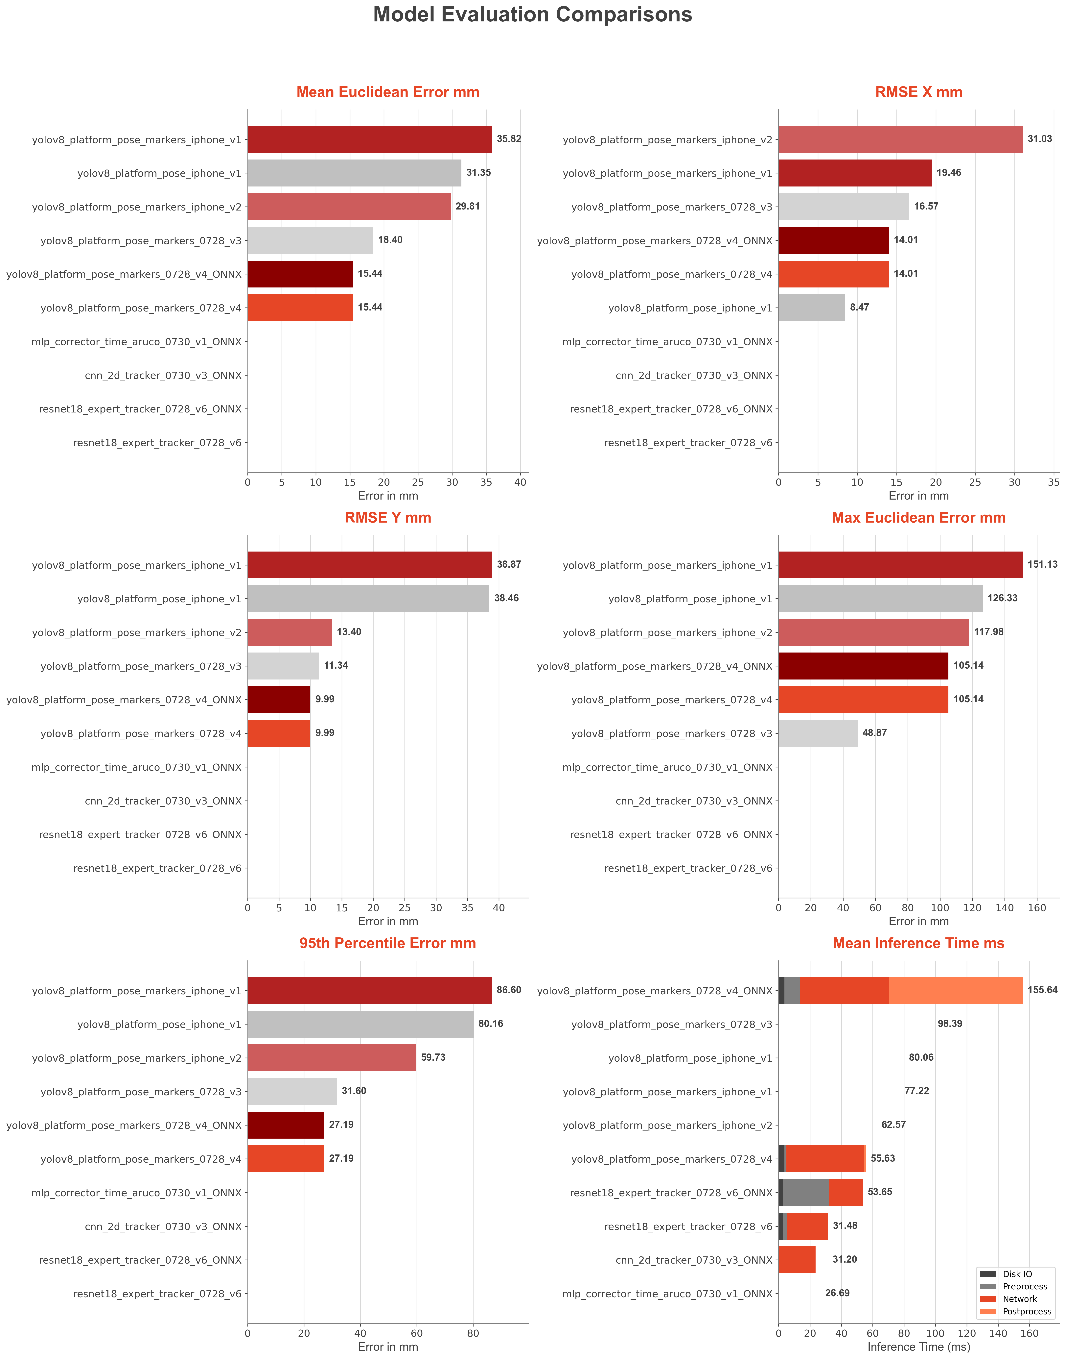
host_software/ml_vision/evaluations/model_comparisons_yolo.png
