Jack0468/ball_balance_video_controlled/host_software/ml_vision/evaluations/pipeline_performance_dashboard.png

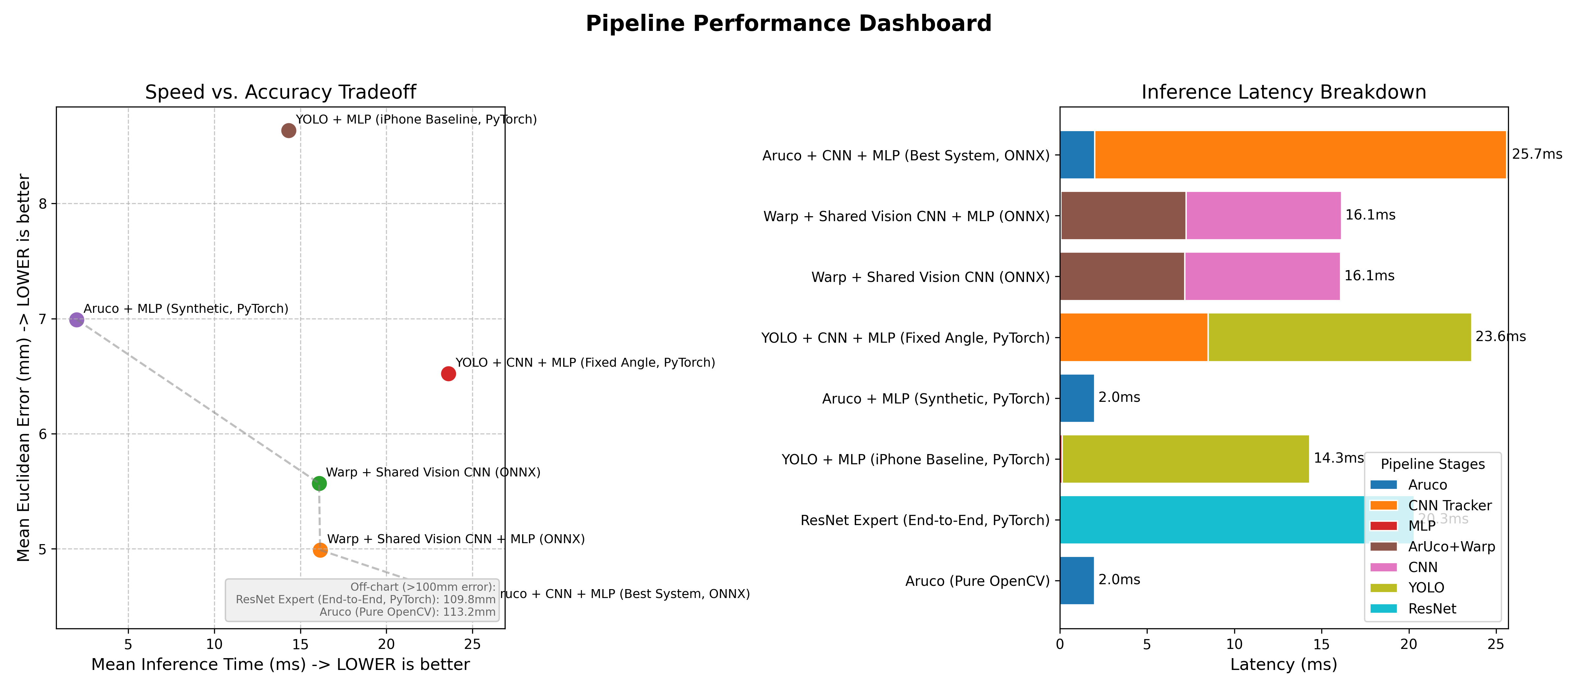
host_software/ml_vision/evaluations/pipeline_performance_dashboard.png
