Jack0468/ball_balance_video_controlled/host_software/ml_vision/evaluations/quick_eval_visual.png

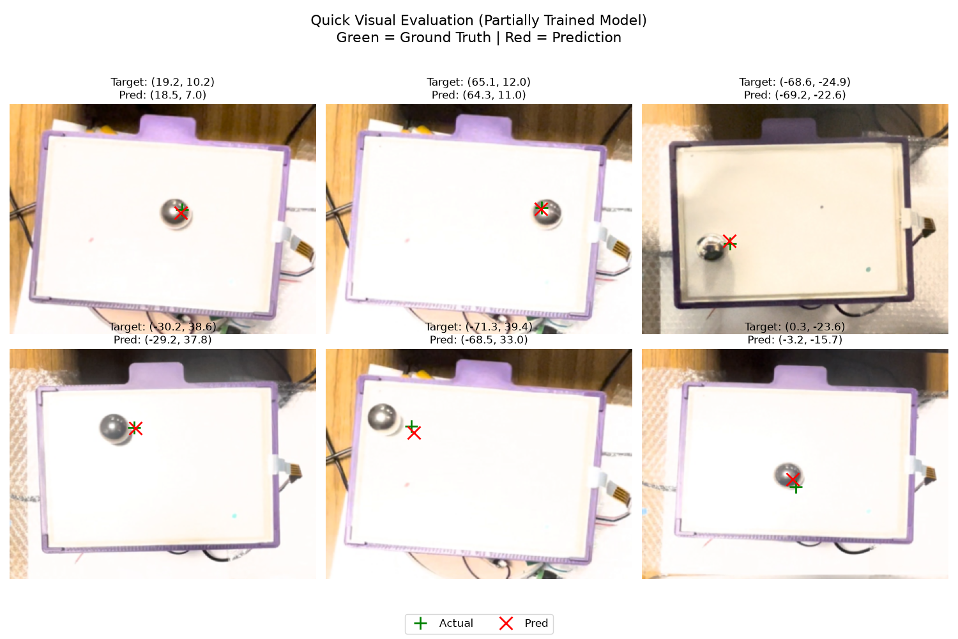
host_software/ml_vision/evaluations/quick_eval_visual.png
