Jack0468/ball_balance_video_controlled/host_software/ml_vision/evaluations/reports/shared_vision_v2_offline_inference_dryrun_verification.png

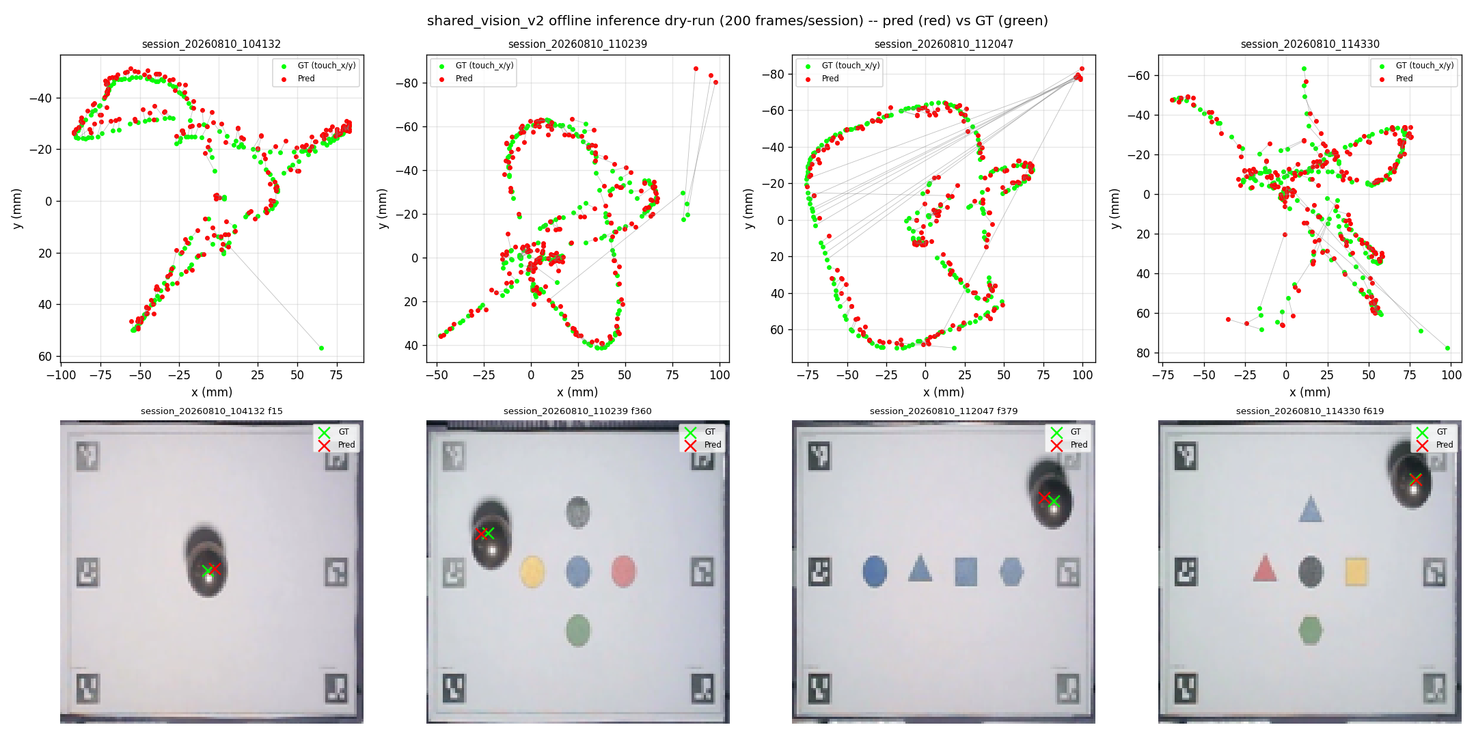
host_software/ml_vision/evaluations/reports/shared_vision_v2_offline_inference_dryrun_verification.png
