Jack0468/ball_balance_video_controlled/host_software/ml_vision/evaluations/sync_verification.png

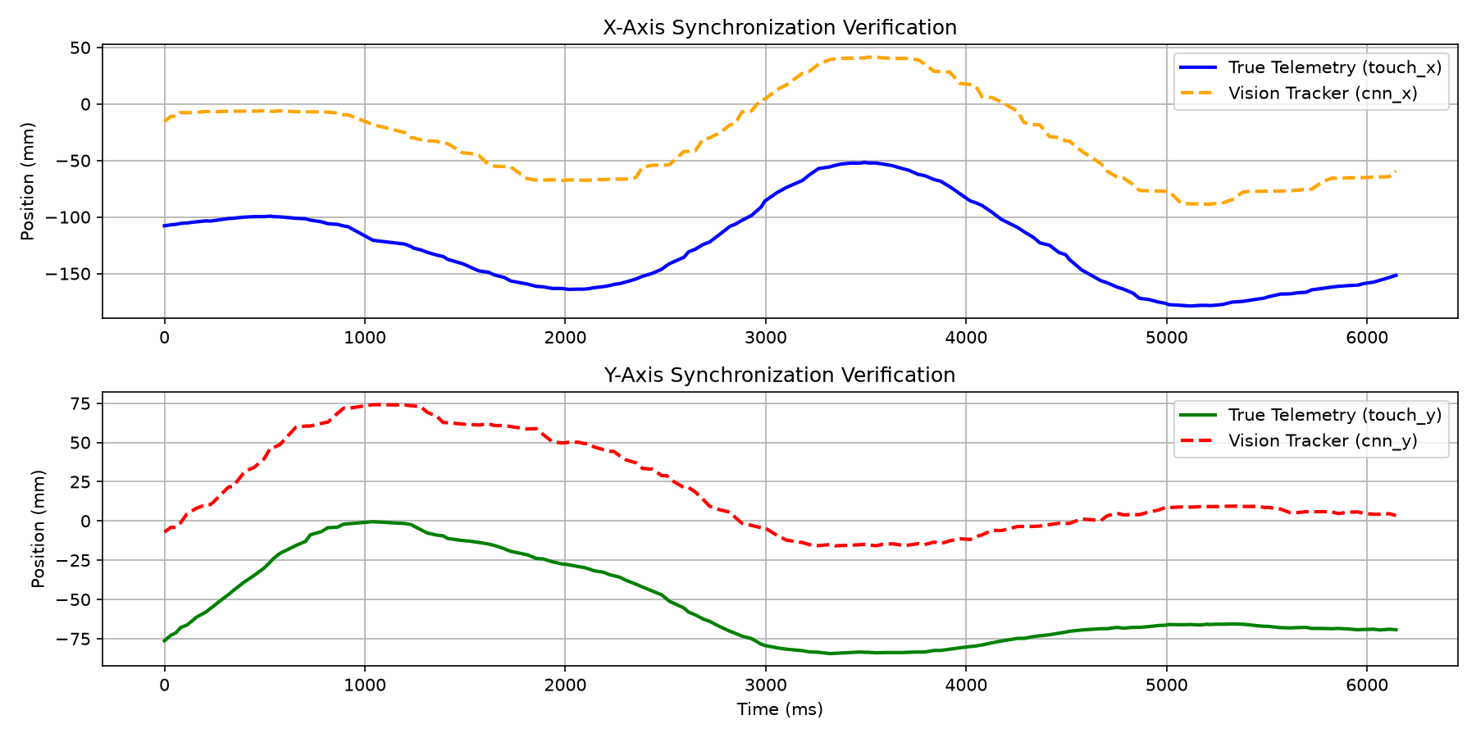
host_software/ml_vision/evaluations/sync_verification.png
