Jack0468/ball_balance_video_controlled/host_software/ml_vision/experiments/results/activation_trial_multiseed_20260811_212427.png

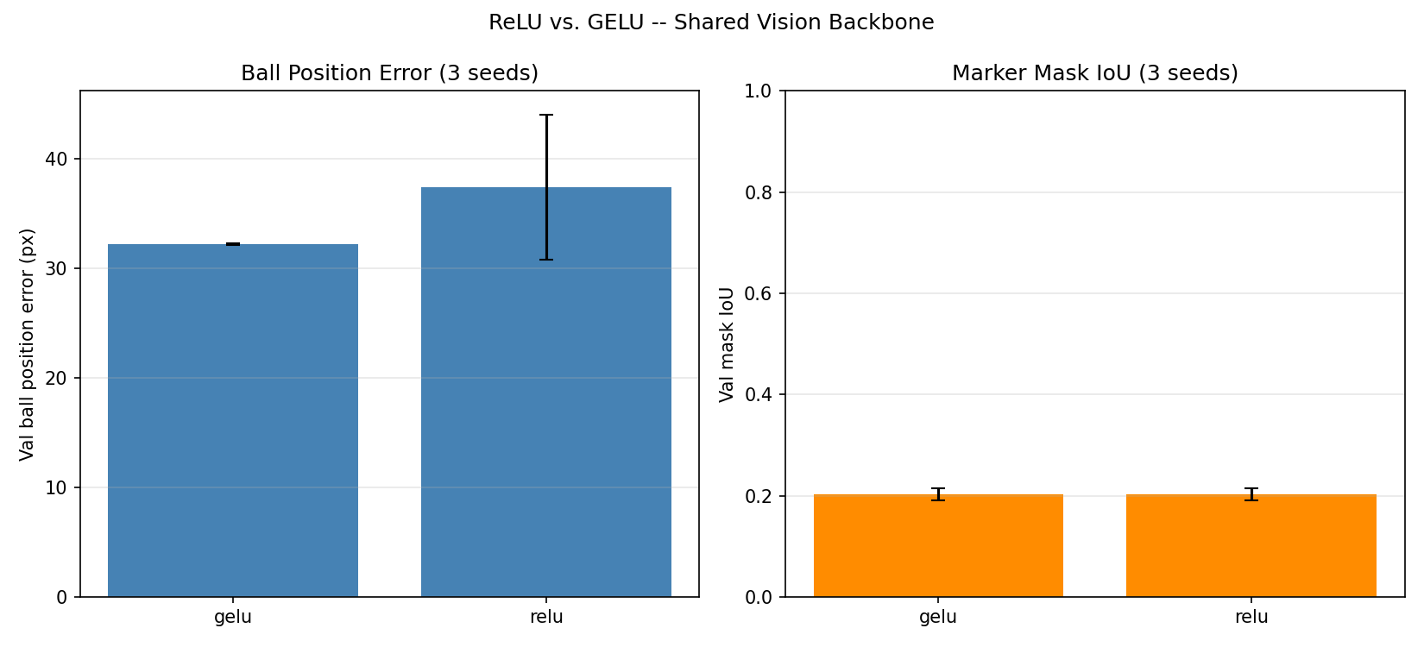
host_software/ml_vision/experiments/results/activation_trial_multiseed_20260811_212427.png
