Jack0468/ball_balance_video_controlled/host_software/ml_vision/experiments/results/augmentation_trial_multiseed_20260811_125753.png

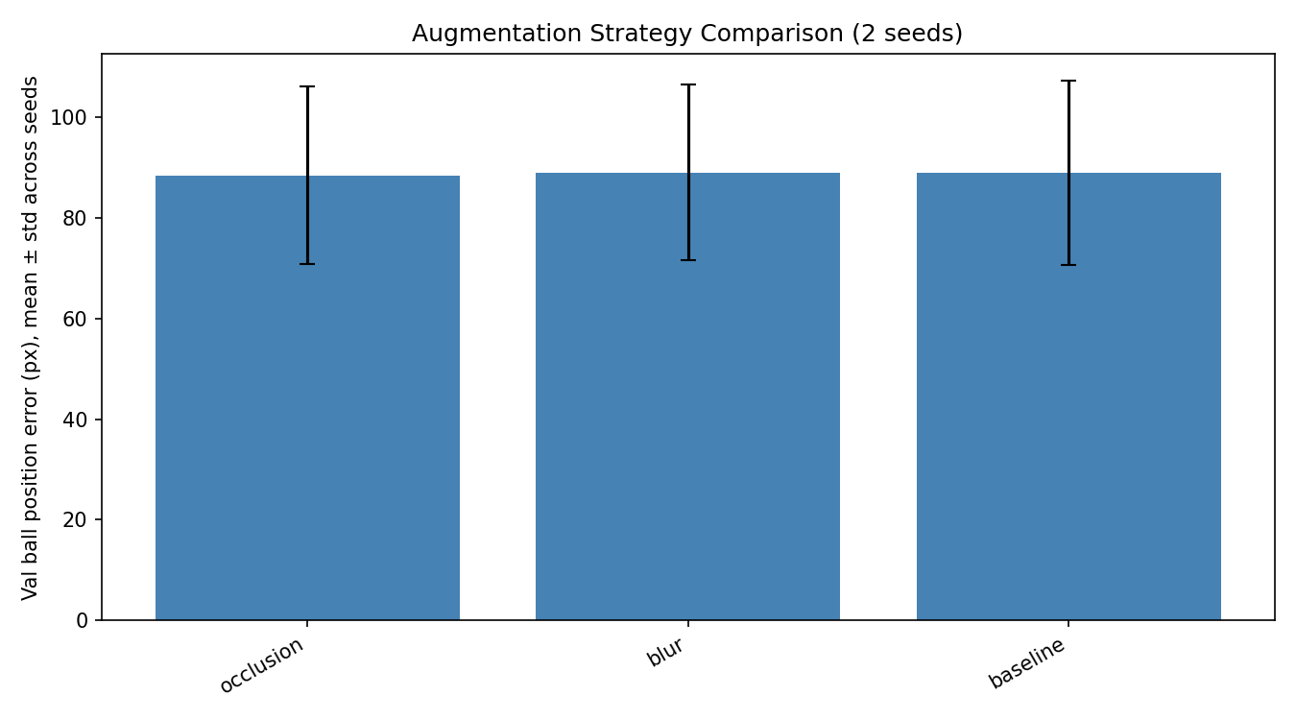
host_software/ml_vision/experiments/results/augmentation_trial_multiseed_20260811_125753.png
