Jack0468/ball_balance_video_controlled/host_software/ml_vision/experiments/results/decoder_trial_multiseed_20260813_080530.png

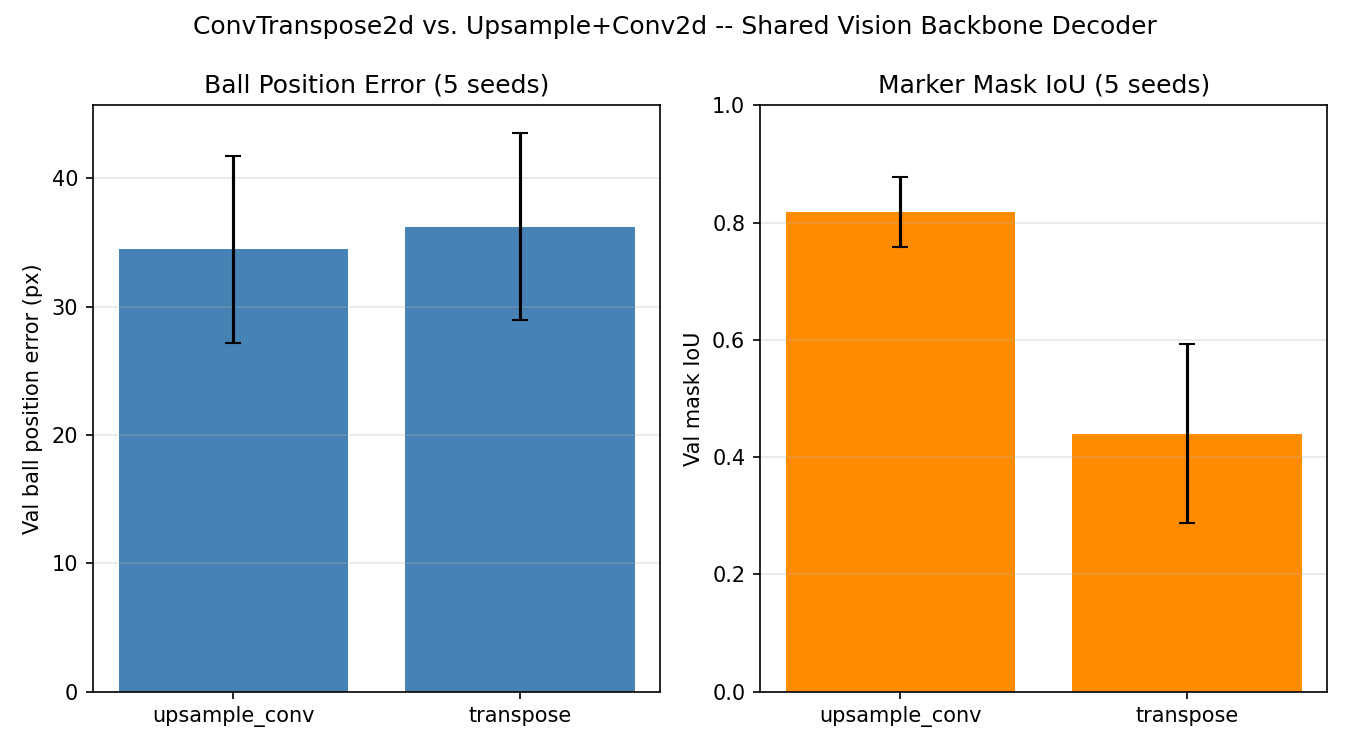
host_software/ml_vision/experiments/results/decoder_trial_multiseed_20260813_080530.png
