Jack0468/ball_balance_video_controlled/host_software/ml_vision/experiments/results/dryrun_fixed_point_trial_20260811_220501.png

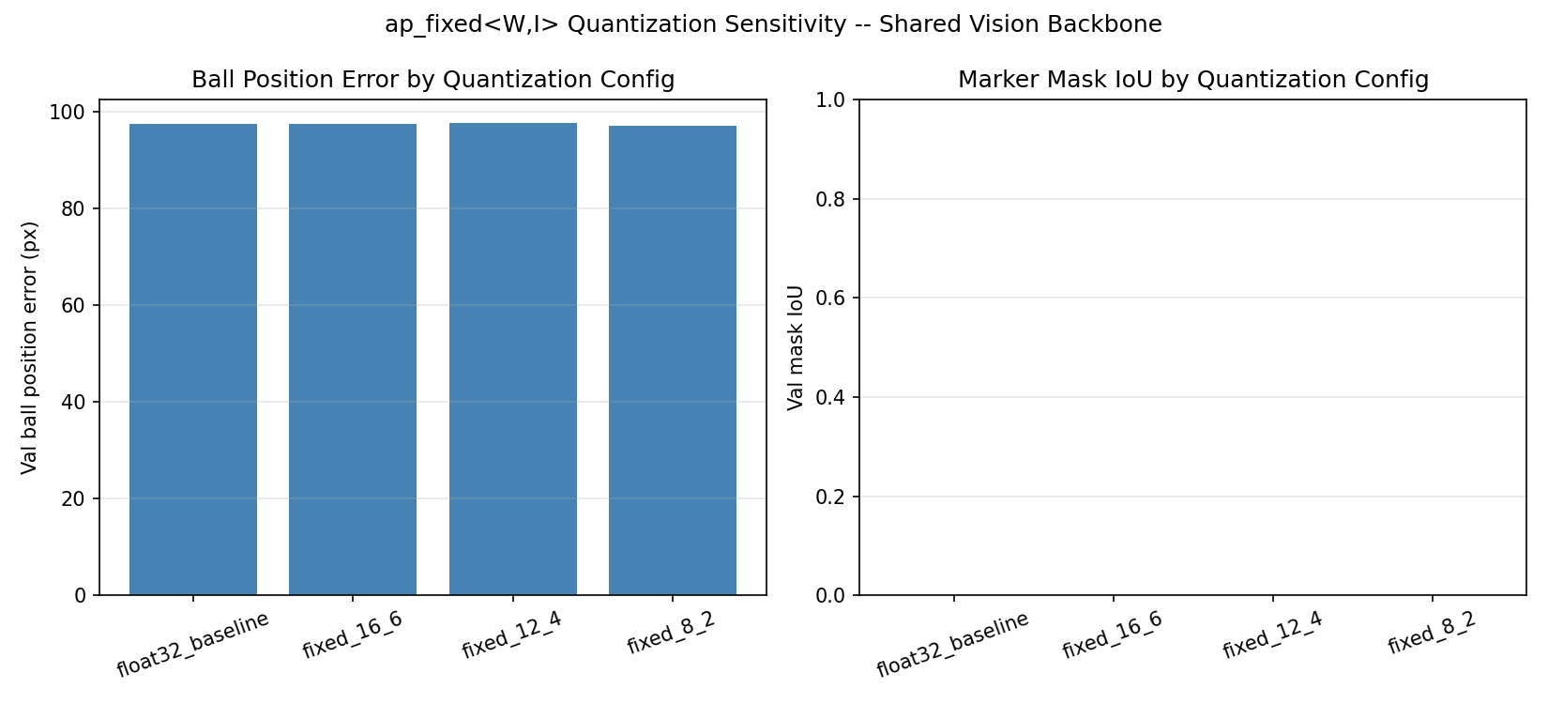
host_software/ml_vision/experiments/results/dryrun_fixed_point_trial_20260811_220501.png
