Jack0468/ball_balance_video_controlled/host_software/ml_vision/experiments/results/fixed_point_trial_20260812_091740.png

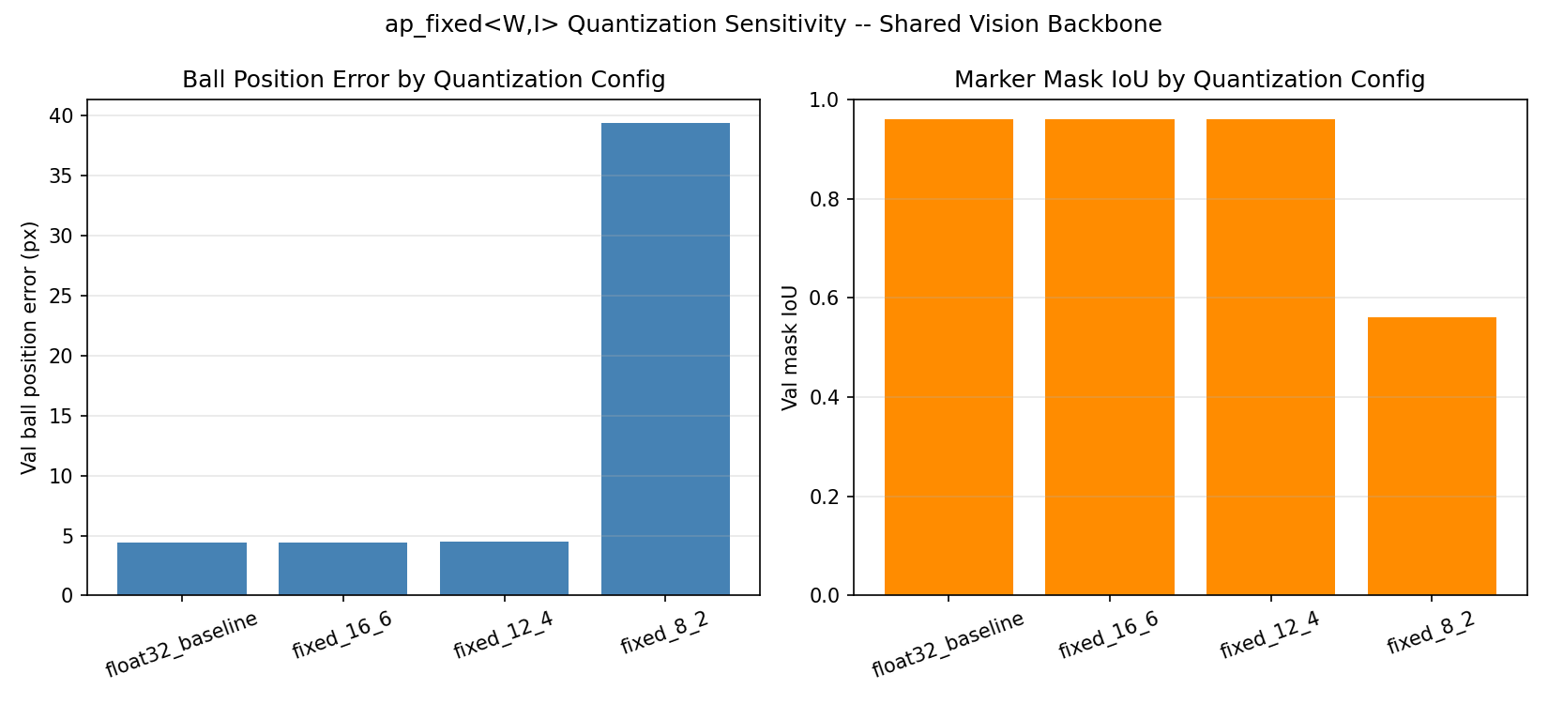
host_software/ml_vision/experiments/results/fixed_point_trial_20260812_091740.png
