Jack0468/ball_balance_video_controlled/host_software/ml_vision/tests/detect_test.jpg

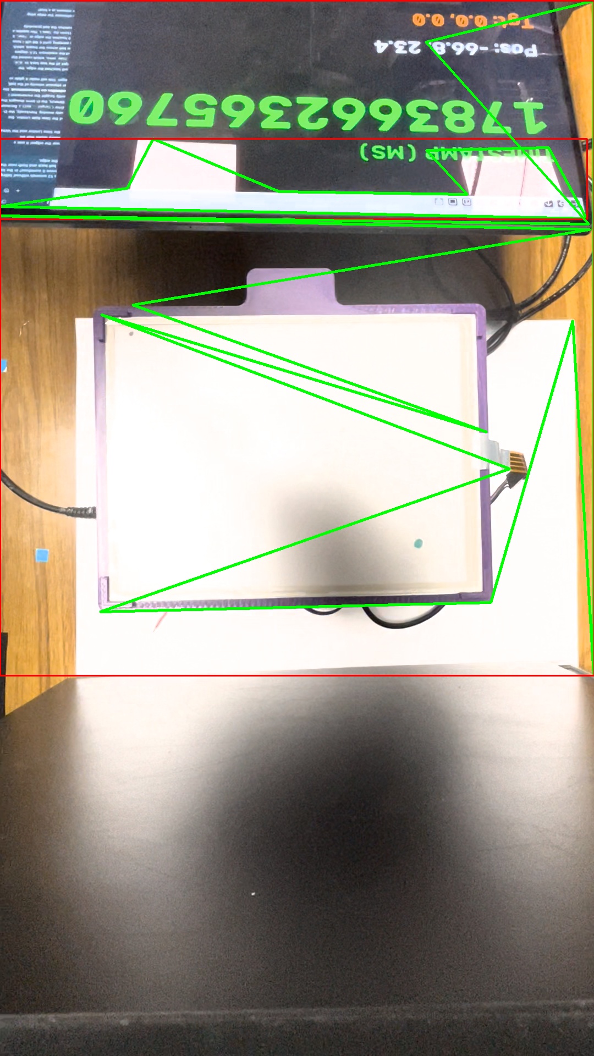
host_software/ml_vision/tests/detect_test.jpg
