Jack0468/ball_balance_video_controlled/docs/PROJECT_LOGBOOK.md

# VRI 2026 Project Logbook

## 22/09/2026
### Arm 2 Minimal-Baseline Offline Scorer Had Two Bugs — Earlier "0/60 Hits, Not Hardware-Ready" Verdict Retracted
- **Context**: found while building the Colab sandbox sweep (`host_software/ml_jetson_vla/deployment/arm2_colab_sweep.ipynb`) for the Arm 2 minimal-baseline candidate comparison (`docs/ARM2_MINIMAL_BASELINE_MULTI_CANDIDATE.md`). The 2026-09-18 offline accuracy run (`deployment/score_minimal_baseline_offline.py`, n=60 real frames across all 10 `session_jetson_track4_*` sessions) had reported 0/60 hits at 20mm tolerance for both the baseline and "oriented" prompts against Qwen2.5-VL-3B, and was reported to the user as a gate finding that this candidate/approach wasn't ready for real hardware testing. **That verdict was wrong and has been retracted.**
- **Bug 1 — wrong ground-truth coordinate frame**: the scorer compared the model's predicted point (converted to mm via the real per-frame ArUco homography) against `telemetry.csv`'s `target_x/y`, but those columns are **centre-origin with x mirrored** (`target_x = W/2 - x_manifest`, `target_y = y_manifest - H/2`), while the scorer used `hardware/platform_templates/ground_truth_manifest.json`'s top-left-origin mm directly — a frame mismatch, not a data problem. Confirmed by: `touch_x` reaching -88mm in real telemetry (impossible in a top-left-origin, all-positive convention); `auto_label_shared_vision.py` already documenting this exact relation; and an independent HSV-detected-marker-centroid check through the same per-frame homography landing at ~1mm median error over 25 frames across all 10 sessions, versus 78-170mm under the old (buggy) comparison.
- **Bug 2 — wrong pixel space for Qwen's answer**: Qwen2.5-VL-3B answers in the pixel space of the image its vision tower actually processes (measured 504x364), not the raw 640x480 camera frame the prompt describes coordinates against — the scorer used the raw frame size when denormalizing.
- **Corrected numbers, same 60 frames/outputs, no model re-run** (real rescore, not a fresh sample):

  | Prompt | Old (buggy) scorer | Corrected |
  |---|---|---|
  | baseline | 0/60 hits, 183.8mm mean | **40/60 hits, 27.9mm mean, 14.1mm median** |
  | oriented | 0/60 hits, 170.3mm mean | **21/60 hits, 43.7mm mean** |

  Baseline beats the "oriented" (richer-context) prompt in **10/10 sessions** under the corrected scorer — the opposite of what the buggy scorer had shown (oriented "helping" in 9/10 sessions was itself an artifact of the bug, not a real effect). A constant-platform-centre-guess yardstick on the same 60 frames scores 25.2mm mean / 9/60 hits, and uniform-random points score ~67mm — so the model is measurably above chance, but its *mean* error is no better than always guessing the centre; its median and hit rate are genuinely better than that baseline.
- **Honest caveats, not resolved**: n=60 is not a statistically powered ranking; 6 of the 60 frames are "transition" frames where the logged target hadn't yet settled when sampled (flagged as a secondary view in the corrected data, sampling itself unchanged). Why the richer "oriented" prompt performs *worse* than the bare prompt once correctly scored is not understood or investigated — a real, open question, not explained away.
- **Fixed in place**: `deployment/score_minimal_baseline_offline.py` (old numbers kept alongside as `error_mm_legacy`, not deleted); a new §8 + erratum added to `docs/ARM2_MINIMAL_BASELINE_MULTI_CANDIDATE.md`; a wrong comment block in `core/minimal_vlm_policy.py` corrected. Verified via a real Qwen call through the corrected backend on the dev machine matching the historical local reference output byte-for-byte, plus the rescore exactly reproducing the original 183.8mm/170.3mm figures from the raw (unchanged) model outputs.
- **Not yet done**: the other 3 candidates (InternVL2.5-4B, PaliGemma2-3B-mix, Moondream2) have still never executed for real anywhere — only structurally checked. The Colab sandbox sweep built alongside this fix (and a possible direct-Jetson run, under consideration as of this entry) is what would actually answer whether any candidate clears the 20mm tolerance at a meaningful rate.

## 18/09/2026
### Touch-Plate Ground-Truth Sensor Artifact: Found in Live Eval AND Training Data, Detector Built, Root Cause Not Yet Confirmed
- **Context**: found while building `report/small_model_evaluation/` (Track 1's Arm 1 baseline report). Large spikes were visible in the touch-plate ground-truth curve of the standardized eval sequence's trajectory plots (`track1_report_20260915`) and were initially misdiagnosed in an early draft as a vision-side marker-misclassification issue -- they are not; the touch-plate sensor is the corrupted signal, not the CNN's estimate.
- **Characterization**: isolated, single-frame, simultaneous jumps in both `touch_x`/`touch_y` (almost always positive, landing in a recurring ~40-98mm band) that revert to trend on the very next sample. **Not reliably caught by the firmware's own `touch_valid` flag** (most flagged spikes are reported `touch_valid=1`) and **not caught by a physical-bounds check alone** (many spikes, 60-90mm, land inside the platform's real ±93.75mm x ±70.5mm extent). A second, related artifact: several runs' first 24-107 rows (~1-4s) hold a stale value from *before* the current recording began (e.g. `touch_x=-88.35mm/touch_y=-29.4mm` for 50 rows in one eval run, `touch_valid=0` throughout) rather than a real ball position.
- **Root cause: hypothesis only, not confirmed at the circuit level** -- no raw ADC counts are logged, only the final mm value. `firmware/stm32_ml_control_and_vision/BallBalancingBot/TouchProbe.cpp` accepts a touch reading via a 2-of-3-samples majority vote against a pressure threshold its own comment calls "just float noise," and dynamically reconfigures its sensing pins between drive/read roles every scan (`getPoint() leaves the shared pins configured for reading; restore them`) -- a plausible glitch source during that role switch, but unconfirmed. **Flagged to the Electrical Engineer / firmware owner** -- needs hardware-level investigation (raw ADC logging or direct probing), not something further data analysis alone can resolve.
- **The identical artifact exists in the OLDER PID-firmware telemetry behind `shared_vision_backbone_v2`'s own training data** (Dataset 8's four raw sessions, `session_20260810_{104132,110239,112047,114330}/telemetry.csv` -- a different firmware generation and CSV schema, no `touch_valid` column at all, same failure signature). This is a real, previously-uncaught data-quality issue, in addition to the two already logged on 12/08 and 13/08.
- **Detector built**: `host_software/src/touch_ground_truth_filter.py`. Went through two rejected designs before landing on the current one -- worth recording since both failure modes are non-obvious and could otherwise be rediscovered the hard way:
  1. A rolling-median/MAD (Hampel) threshold degenerates on the runs of identical repeated values `TouchProbe.cpp` emits during `touch_valid=0` (near-zero local variance flags ordinary small real movements).
  2. A strict "compare only to the single immediate neighbor on each side, which must themselves agree" check missed the stale-startup case (can't flag a run's first/last row) and could fail during genuinely fast ball oscillation (flanking samples legitimately disagree by more than the threshold even with no corruption present).
  3. **Current design**: flags row *i* if it deviates >30mm from the median of up to 4 surrounding *distinct-valued* neighbors (deduplicating consecutive exact-repeat rows first), combined with the physical-bounds check. Handles both prior failure modes; a hypothetical two-consecutive-corrupted-frames-with-identical-values case could theoretically still evade it (not observed in practice).
- **Training-data audit** (`host_software/ml_vision/data_processing/audit_touch_ground_truth_spikes.py`, run against all 4 Dataset 8 sessions): **281 of 52,772 labeled frames (0.53%) carry a corrupted `ball_x_px`/`ball_y_px` label** as a direct result (per-session: 104132 58/14834=0.39%, 110239 53/10988=0.48%, 112047 79/14067=0.56%, 114330 91/12883=0.71%). Full per-frame list (session, `frame_index`, `image_file`) at `host_software/data/01_bronze/touch_ground_truth_spike_audit_summary.json`. **This very likely explains `shared_vision_backbone_v2`'s previously-unexplained outlier tail** (`ball_px_error_max` 114.6px, `Max_Euclidean_Error_mm` 156.2mm, logged 14/08 as "rare bad frames dragging the max up" with no known cause at the time).
- **Not yet done, flagged for `ml-vision`**: (1) whether to drop/re-derive these 281 frames and retrain `shared_vision_backbone_v2` -- not decided or attempted here; (2) a retrain-and-compare experiment is the only way to confirm whether this measurably degraded the model's *learned* accuracy as opposed to only its *reported* evaluation tail -- reasoning in `report/small_model_evaluation/report.md` Section 6.5 argues a large effect is unlikely (live in-the-loop accuracy across 5 independent runs tracks the static held-out number tightely) but this is not a substitute for the actual experiment.
- **Separate, smaller finding from the same investigation**: after filtering the touch-plate artifact out of the live eval telemetry, a small number of large residual vision-estimate errors remain, each coinciding with the fastest motion in its run (initial ball-placement transient, a directional-command transition) -- consistent with vision accuracy degrading somewhat during high-velocity motion (motion blur / displacement outside the training distribution's typical frame-to-frame range). Not quantified systematically; flagged as worth a dedicated velocity-stratified accuracy analysis.
- **Also fixed as a side effect**: `evaluate_system_control.py`'s reported Settling Time changes non-trivially once the stale-startup segment is filtered out of a run's first trial (that segment could previously read as a spurious "already settled" state, since `touch_x/y` and `target_x/y` can both sit near a shared default/placeholder value before the ball is confirmed present) -- filtered numbers are more honest, not directly comparable to a pre-filter reading.

### Report Audit Found a Second, Distinct Data-Quality Issue: `run1_150041`'s `go_green` Trial Never Resolved
- **Found while auditing `report/small_model_evaluation/report.md` for gaps.** Git history showed `marker_classifier.py`'s green color bin (`S` floor 50, the value measured elsewhere at 0.0% recall for `green_hexagon`) was still live at the time of the `track1_report_20260915` eval runs (commit `d57fb59`, 14:02:49, before the 15:04+ eval runs; the fix landing `S`=20 wasn't committed until `3348f21a`, 2026-09-17 -- two days later). This raised the concern that `go_green` targeting may have failed across all 5 runs.
- **Checked directly against the raw telemetry (by elapsed time, not row index) rather than assumed from the timing alone** -- the empirical result is narrower and more specific than the timing evidence alone suggested: **only `run1_150041` shows `target_x/y` stuck at literal `(0.0, 0.0)` for the full 10s `go_green` window**; runs 2-5 resolve green to a consistent, real off-center position (~0.4mm, ~29.6mm) within about 1 second. Likely explanation: the `S=50` bin was fragile/marginal rather than completely broken on the live Jetson camera (the 0.0% recall number was measured offline against `session_20260810_114330`, a different camera/lighting condition, not this camera) -- it happened to fail in run1 specifically, not universally.
- **Confirmed via code, not just data**: `state_machine.py`'s `_MarkerPositionFilter.position` starts `None` and only becomes non-`None` from an actual successful classifier detection -- no other seeding path exists -- so a color that never classifies leaves `get_target_coords()` permanently falling back to platform center for that target.
- **Impact**: 1 of run1's 10 trials measured "hold near center" rather than "reach the green marker" -- a real caveat on run1's role as the report's exemplar "best run" (its trajectory is Figure 5). Root cause (lighting variation vs. residual classifier fragility) not investigated further -- flagged to `ml-vision`, not fixed.

### Inference-Latency Instrumentation Added (Forward-Looking, Not Yet Analyzed)
- **Motivation**: same report audit found no per-frame vision-pipeline inference-latency data was being recorded anywhere, despite this being a near-certain requirement once a large-model arm exists on the same Jetson hardware (Arm 2) and needs to be compared against the small-class expert pipeline on a like-for-like latency basis.
- **Added** `vision_inference_ms` to both `src/touch_logger.py`'s `CSV_FIELDS` (live-evaluation telemetry) and `ml_jetson_vla/runtime/session_recorder.py`'s `TELEMETRY_CSV_FIELDS` (Track 4 session telemetry) -- measured in `run_jetson_standalone.py`'s main loop as the isolated wall-clock time of `policy.act()` (ArUco homography + CNN forward pass + marker classification + state-machine update), deliberately distinct from `rtt_ms` (serial round-trip) and the loop's `total_ms` (which also includes camera wait and serial I/O). Threaded through `TouchTelemetryLogger.send_frame()`'s and `SessionRecorder.log()`'s signatures as an optional trailing parameter -- existing callers that don't pass it are unaffected, and the column is blank on any telemetry recorded before this change. Documented in `docs/EVALUATION_STRATEGY.md`'s new "Inference Latency" section.
- **Explicitly not done**: no analysis script reads this column yet, and no historical data exists for the `track1_report_20260915` runs (they predate this change) -- recording capability only, per direct instruction (build this now, analyze it once a large-model arm actually exists).

### Telemetry Field-History Audit and Extended Control Metrics
- **Codebase audit** (full field-by-field report from a dedicated Explore agent) compared the current live Jetson telemetry schemas against everything the project has ever recorded (old PID-firmware `TelemetryPacket` structs, the iPhone-era logger, the staged-but-unmerged `stm32_interface/TELEMETRY_PROTOCOL.md` proposal, `RLControl.cpp`'s internal state). Confirmed **not** worth re-adding: `integral_x/y`/`deriv_x/y` (PID-specific internal state, no RL equivalent), `cam_x/y` (orphaned, no producing script, superseded by current vision columns), `pitch`/`roll` (physically meaningful but the current RL firmware never computes them -- `ExpertEvaluationFirmware/RLControl.cpp` hardcodes both to 0.0 when reusing the old struct; would need deriving from `theta_a/b/c` via inverse kinematics, not a native readout).
- **Real gotcha found in old data**: the legacy `ExpertEvaluationFirmware/RLControl.cpp` silently repurposes the wire format's `deriv_x`/`deriv_y` slots to carry `filt_vel[0]/[1]` (the RL net's own internal EMA-filtered ball velocity, its literal input `obs[4]/obs[5]`) instead of zeroing them like it does pitch/roll/integral. Any old CSV from that specific firmware variant has a column named "deriv_x" that is not a PID derivative -- a real trap for anyone reusing that data blind.
- **Confirmed still-unaddressed blind spot**: the RL control net's internal `filt_vel` state and its raw (pre-scaling) network outputs are **fully unobservable** on the current live firmware (`stm32_ml_control_and_vision/BallBalancingBot.ino` has no telemetry-send call at all in its `loop()`), and the staged `TELEMETRY_PROTOCOL.md` proposal doesn't include either. Flagged as the single highest-value telemetry gap (an RL-native analog to exposing a PID's integral term) but requires a firmware change outside this session's write boundary -- not implemented, left as a recommendation for the Electrical Engineer's review of the staged proposal.
- **Implemented (Python-side, no firmware change needed)**:
  1. `target_err_x_mm`/`target_err_y_mm`/`target_err_mm` added to `src/touch_logger.py`'s `CSV_FIELDS` -- the control-tracking error (`target - touch`), distinct from the existing `err_x_mm`/`err_y_mm` (which are a vision-accuracy signal, `vision - touch`, confirmed by the audit to be a different quantity despite the name collision risk). `evaluate_system_control.py` already derives this same quantity downstream as its own `error_mm` column; this persists it in the raw per-frame telemetry too.
  2. `host_software/control/pid_controller.py`'s `PIDController` now exposes `self.last_ball_vel_x/y` (previously a local-only variable). Confirmed via search that `PIDController` has no active caller anywhere in the codebase today -- this is forward-looking exposure, not a live logging integration, so a future PID run can log a velocity estimate directly comparable to the RL net's `filt_vel`.
  3. **Extended metrics** added to `evaluate_system_control.py`'s `compute_metrics()`, computed from telemetry already recorded (no new instrumentation needed): Rise Time (adapted for a decaying, not rising, response -- see `docs/EVALUATION_STRATEGY.md`'s new "Extended Metrics" section for the exact definition and why it differs from the classical one), Overshoot (mm and %, per-axis signed error), IAE/ISE/ITAE (trapezoidal-integrated over each trial's full duration). **Verified against real data, not just unit-tested**: the %-overshoot metric was found to produce a 462% value on one real trial purely because its initial error was ~1.1mm (a near-zero denominator), not from unusually large oscillation -- added the mm-based version alongside it and documented the % version as unreliable for small-initial-error trials, rather than shipping a metric with a known-bad failure mode undocumented.
- **Not yet added, flagged for later**: ball-trajectory jerk/smoothness (distinct from the existing motor-angle-based Control Effort) and disturbance-rejection/robustness metrics under injected perturbation -- both came up as standard for RL-controlled systems in external research (web search, 2026-09-18) but need new instrumentation or a dedicated test protocol, not just a new formula over existing telemetry.

## 15/09/2026
### Marker Classifier: 2 of 5 Colors Unreachable on Jetson AGX Orin, Blocks the Standardized Evaluation Sequence
- **Finding (ml-vision), confirmed live on Jetson AGX Orin via `run_jetson_standalone.py --dummy-audio --headless --kalman`, 640x480 capture**, cross-checked against `hardware/platform_templates/aruco_markers_03_manifest.json`: of the 5 `aruco_markers_03` features, `red_triangle`/`blue_triangle` classify correctly and reliably; `yellow_square` mostly correct but occasionally flickers to `green`; `green_hexagon` classifies to `unknown` on every frame, always; `black_circle` (at dead-center, (0,0)) is never detected at all -- no blob, not even a misclassification. All 5 positions match the manifest exactly, so this is purely a color/detection problem, not a coordinate bug -- verified against `marker_classifier.py`'s documented X-mirror convention (`touch_x = W/2 - manifest_mm_x`), which was applied correctly in the check.
- **Blocks real work, not cosmetic**: `docs/EVALUATION_STRATEGY.md`'s Standardized Evaluation Sequence (updated 2026-09-15, same day) uses `go_green` as its literal first command (0-10s) and `go_black` as command 7 (60-70s) -- confirmed by reading the sequence directly. Neither target is currently reachable, so the sequence as written can't produce a meaningful PID/Expert-Vision-RL/VLA comparison run right now.
- **`yellow`/`green` boundary flicker has a known, already-logged precedent, not a new bug**: `COLOR_BINS` (`marker_classifier.py`) sets yellow's hue upper bound and green's hue lower bound both at H=35 (adjacent, touching ranges), and `COLOR_CHECK_ORDER` checks `green` before `yellow` -- a borderline-yellow reading right at H~35 resolves to green first. This matches the exact bin-boundary brittleness already documented in the 19/08 marker-classifier entry (a hue of 19.1 landing just outside the 20-35 yellow bin).
- **`green_hexagon` classifying to `unknown` on literally every frame (not just occasionally) is a stronger failure than boundary flicker, and matches a DIFFERENT already-logged, deliberately-deferred limitation**: the 19/08 entry explicitly flagged that real markers can be genuinely desaturated under some lighting (observed S~15-30 on 2 of 5 markers in one test frame) and fall outside all 5 bins entirely, since every bin requires S>=50 -- and noted the spec's own documented fallback (train a small SVC on collected HSV features) was deliberately not built at the time, on the basis it hadn't yet been shown to matter in practice. It now demonstrably does, on different hardware (Jetson's camera, not the laptop webcam the bins were tuned against). No raw HSV values were captured from this specific run, so the desaturation hypothesis is plausible but not yet numerically confirmed -- needs a live capture with mean_hsv logged for the failing blob before touching the bins.
- **`black_circle`'s total non-detection is a different kind of problem, not a threshold issue**: it sits at the platform's exact physical center -- the same region the ball itself occupies most of the time (both as its default rest position and as the recentering target). Plausible cause is the CNN's segmentation mask simply never firing there because the ball is physically occluding it in most/all frames, which would be a training-data-coverage / physical-layout conflict (marker placed where the tracked object usually sits), not something a bin-threshold tweak can fix.
- **Not yet done**: capturing real mean_hsv values for the failing green/black blobs on the Jetson (no saved frame from this run exists locally to inspect after the fact); deciding whether to fix the classifier (uncertain timeline) or temporarily revert the sequence to red/blue-only targets to unblock evaluation runs now -- raised to the user rather than decided here, since it affects comparative validity across the PID/Expert/VLA arms.

### Marker Classifier Follow-up: Real-Data Investigation, Partial Fix Shipped, Green Desaturation Confirmed Unfixable-By-Bins
- **No Jetson capture exists, so grounded instead in `session_20260810_114330`** -- the one real (non-synthetic) recorded session whose masks match the `aruco_markers_03` manifest exactly (`black_circle`/`blue_triangle`/`green_hexagon`/`red_triangle`/`yellow_square`, 12,883 warped frames). All numbers below are measured against real photographed markers via this session, not the Jetson's own camera -- stated explicitly since it's a different sensor/lighting, and the fix's effect on the live Jetson symptom specifically remains unconfirmed pending a real capture there.
- **`green_hexagon` desaturation hypothesis CONFIRMED, and shown to be unfixable by any bin-threshold tweak**: real green_hexagon core pixels (eroded mask, n>38k across ~500 sampled frames) measure S median=41, p95=50 -- i.e. even its best-case, most-saturated core pixels only marginally reach the classifier's S>=50 requirement, and the per-frame mean (what `_classify_color()` actually sees) never reliably clears it. Verified end-to-end (not just raw HSV stats) by running the real `shared_vision_backbone_v2` ONNX checkpoint + real `marker_classifier.MarkerClassifier.classify()` over 307 sampled real frames: green_hexagon classified correctly 0/307 times both BEFORE and AFTER the yellow/green boundary fix below -- conclusively isolating this as a genuine physical/lighting desaturation problem, not the touching-boundary issue. Matches and confirms the 19/08 entry's deferred SVM-fallback limitation is now real. **Not fixed** -- lowering green's S floor was considered but not shipped without first verifying it doesn't catch other markers' dim tails (see the black-bin lesson immediately below); flagged as the concrete next step (either verify a lowered S floor against real collision data, or build the spec's own SVC fallback).
- **Yellow/green boundary: fixed and verified, larger than the original hypothesis**. Real yellow_square hue (eroded core, per-frame mean, n=806) has median 19.4 -- mostly *below* the bin's own lower bound of 20 -- while its more realistic (less-eroded) population mean/p90 is 34.4/42.2; real green_hexagon hue is comfortably 45-85 (p5=51) and essentially never legitimately drifts below 45. The old shared H=35 boundary sat inside yellow's own real upper tail, nowhere near green's real floor. Fix: green's H floor moved 35->45, yellow's H ceiling moved 35->42, and `COLOR_CHECK_ORDER` reordered to check yellow before green. Verified via the same 307-frame end-to-end harness: yellow_square correct 175/307 (57%) -> 256/307 (83%); wrong-as-green dropped 112 -> 13.
- **`black_circle`: real printed marker measured, blob-formation ruled out as the bottleneck, partial classification fix shipped with a quantified residual false-positive rate**:
  - Visually and numerically confirmed the real printed "black" marker reads as a desaturated mid-grey under this camera/lighting (S median 14.6, V median ~118-128, core pixels, unoccluded frames), nowhere near the old V<60 bin -- not a mask-dilution artifact (eroded-core stats are nearly identical to full-mask stats, and a direct crop/visual check shows a uniformly grey, not gradient-blurred, disc).
  - **Ran the real ONNX checkpoint directly** (not just HSV math) to test the "CNN never segments this region" hypothesis from the original entry: `shared_vision_backbone_v2`'s mask head fires at >0.98 confidence over black_circle's location in 98.3% of unoccluded real frames tested -- a blob DOES reliably form on this historical dataset. Ball-occlusion of that region also measured directly (ball-to-marker-centroid distance vs. mask radius): only 1.7%/5.1%/11.1% of frames have the ball within 1x/2x/3x the marker's radius -- occlusion happens but is nowhere near "most/all frames," so it cannot by itself explain a 100%-of-frames Jetson failure. **This means black_circle's live-Jetson zero-blob symptom is NOT reproduced or explained by this dataset** -- most likely a Jetson-camera-specific domain-shift or an evaluation-sequence-specific dwell-at-center effect (HOLD/idle periods concentrate the ball there far more than this session's random-movement data would), but this remains genuinely unconfirmed without a live Jetson capture.
  - Fix shipped: black's V bound widened 60->150 (covers the real marker's measured range, p99=140, with margin; blank background paper measures V~214-255 the great majority of the time). **First pass (V-only) caused a real, measured regression**: verified end-to-end that widening V alone flipped 46 of ~1,228 sampled blue/yellow/green/red-triangle frames from a harmless "unknown" to a wrong "black", because black's S bound was previously unconstrained (0-255) and those markers' own dim/shadowed tails have S in the same range as black_circle's true readings. Investigated rather than shipped blind: black_circle's own S distribution (median 13.8, p95 27.2, max 31.5, n=307) genuinely overlaps the false positives' S distribution (median 29.2, extending down to 13.6) -- a real, only partially separable ambiguity in HSV space, not a clean-cut fixable threshold. Added S<=20 to black's bin as the measured best trade-off (keeps 92.8% of true black_circle detections, cuts false positives 46->8 across the same sample) and shipped that, rather than the uncapped version. **Residual, explicitly not eliminated**: ~8/1,228 (~0.65%) of the other 4 markers' dimmest real frames will still misclassify as black; tightening the cap further trades away real black_circle recall for diminishing returns on this residual, per the measured curve at S<=15/20/25/30/35/40/45/50 checked directly.
  - Final end-to-end numbers (307-frame real-data harness, before -> after all changes): black_circle 0/307 -> 285/307 correct (92.8%); blue_triangle and red_triangle's own-color detection counts unchanged (verified identical before/after, isolating the fix's effect from an unrelated, separately-discovered issue below).
- **New, out-of-scope bug found and NOT fixed this session, flagged for follow-up**: `red_triangle` on this same real session frequently misclassifies as `blue`/`green` (9/307 correct, 163 as blue, 89 as green) -- traced to `_classify_color()`'s `cv2.mean()` naively arithmetic-averaging hue, a circular quantity, over a blob whose true color straddles the 0/180 hue wrap point (confirmed: a single blob's raw BGR sample converts to H~179, comfortably inside the correct red bin, but the blob's *mean* hue across all its pixels lands near 90 -- exactly what naive linear averaging produces when a distribution straddles the wrap, e.g. averaging H=179 and H=2 gives ~90, not ~0). This is independent of, and predates, everything else in this entry -- did not touch the red/blue bins, and confirmed via the before/after harness that red_triangle's/blue_triangle's own numbers are byte-for-byte unchanged by this session's edits. Live Jetson currently reports red/blue as reliable, so this may be dormant on that specific camera/lighting (hue perhaps doesn't straddle the wrap there) -- but it is real, reproduced, and will likely resurface under different lighting. Proper fix needs circular-mean hue averaging (e.g. `atan2`-based) in `_classify_color()`/blob HSV extraction, not attempted here (out of the requested scope).
- **Verification method**: no dedicated automated test exists for `marker_classifier.py` (`tests/test_marker_clustering.py` is an old, unrelated exploratory script). All numbers above come from a purpose-built harness run before and after each edit: real `shared_vision_backbone_v2` ONNX checkpoint inference -> real `MarkerClassifier.classify()` -> nearest-known-feature matching by expected `touch_mm` position, over the same 307-frame sample each time, on real (not synthetic) photographs.
- **Not yet done / explicitly open**: (1) green_hexagon is still 0% correct and needs either a verified lower S floor or the spec's deferred SVC fallback -- not a quick bin edit; (2) black_circle's live-Jetson zero-blob symptom is unexplained by this dataset and needs a real Jetson capture (saved frame + logged `mean_hsv`/`mask_prob`) to disambiguate domain-shift vs. evaluation-sequence dwell-time occlusion; (3) the red/blue hue-wraparound-averaging bug is real, reproduced, unfixed, and separate from everything else here; (4) whether/how to revise `docs/EVALUATION_STRATEGY.md`'s sequence in the meantime is explicitly left to the user, not decided here.

### Marker Classifier, Second Follow-up: Green S-Floor Lowered, Nearest-Hue Fallback Tier Shipped
- **New harness built, same discipline as before**: no dedicated verification tool for this existed either (the prior two entries' "307-frame harness" was never saved as a script). Built `host_software/ml_vision/experiments/marker_classifier_green_fallback_sweep.py` -- real `shared_vision_backbone_v2` ONNX checkpoint -> real `MarkerClassifier.classify()` -> nearest-known-feature matching by expected `touch_mm` position (15mm match radius, half the manifest's 30mm feature spacing), over 1200 frames evenly sampled from the full 12,883-frame `session_20260810_114330` (more statistical power than the prior 307-frame sample, still deterministic/reproducible). Lives in `experiments/` per the repo's own convention (comparison report, not a fixed regression benchmark).
- **Green S floor: swept 15/20/25/30/35/40/45/50, did not take the suggested ~35 on faith**. Real per-frame mean saturation (what `_classify_color()` actually sees over the CNN's full blob, not the previously-quoted eroded-core stats) turned out to sit lower than the core-pixel numbers suggested: green_hexagon recall was 0.0% (S=50) / 0.3% (45) / 1.1% (40) / 3.4% (35) / 42.2% (30) / **92.9% (25) / 94.5% (20)** / 94.7% (15) -- the suggested 35 would have recovered almost nothing (3.4%). Shipped **S=20**, not 15, because the 15->20 step only buys +0.2pp of green recall while increasing green's own false-positive leakage into `black_circle`'s real frames by 50% relative (14/1200 -> 21/1200). At S=20, the other 4 colors' own CORRECT counts are byte-for-byte unchanged from the S=50 baseline (guaranteed by construction, not just measured: blue/red/yellow are checked before green in `COLOR_CHECK_ORDER`, so a blob already matched to its own bin never reaches green's check) -- verified: black 1124/1200, blue 18/1181, yellow 1033/1198, red 44/1196, identical before/after. The real, quantified residual cost is entirely in the false-positive tail: black_circle 0->14/1200 (1.2%) newly misclassified as green, yellow_square 52->78/1198 (+2.2 points), red_triangle 359->375/1196 (+1.3 points, layered on the pre-existing, separate hue-wraparound bug below), blue_triangle 0->9/1181 (0.8%) -- all previously-harmless "unknown" blobs turning into a specific wrong color, none previously-correct classifications overwritten.
- **Nearest-hue fallback tier implemented**: `_circular_hue_distance()` (wrap-aware, `min(diff, 180-diff)` on OpenCV's 0-180 hue scale) + `_nearest_hue_fallback()`, wired into `_classify_color()` as a genuine second tier -- only reached when no strict `COLOR_BINS` entry matches, never overriding a confident classification. `MarkerClassifier.__init__` gained `fallback_hue_threshold` (default 10.0); `MarkerDetection` dataclass and all call sites (`main_onnx_shared_vision_audio.py`, `state_machine.py`) are untouched -- checked both first: neither consumes anything beyond the plain `color` string keying into `state_machine.marker_history`, so a confidence field would have had zero consumers. Decided not to add one rather than over-engineer it, per the task's own explicit lean.
- **Key finding, not what was expected going in: the fallback tier recovers ZERO additional green_hexagon detections at any threshold tested (0/5/8/10/12/15/20/25/30 all measured)** -- its correct count stays flat at 1126/1191 (94.5%) throughout. Root cause traced via a new `--hue-stats` diagnostic mode in the same harness: green_hexagon's residual ~61-frame "unknown" pool (what's left after the S-floor fix) sits in the 42-45 hue gap the prior session's yellow/green boundary fix *deliberately* left unresolved (see that entry above) -- nearest-hue matching pulls that population toward **yellow's** center (31), not green's (65), once the threshold is wide enough to reach it. There is a sharp cliff between threshold 12 and 15 where the fraction of green_hexagon's own unknown pool converted to a wrong label jumps from 24.6% to 98.4% -- with no green recall benefit whatsoever. This is documented plainly as a negative result for the stated goal, not glossed over.
- **The tier does genuinely help two *other* colors with the same failure shape**: `blue_triangle` and `yellow_square` also have real blobs that the CNN detects but whose HSV bin fails on desaturation, unrelated to green's hue-boundary problem. The `--hue-stats` diagnostic showed their real hue IS tightly, stably clustered near their own bin's canonical center (blue: mean circular distance to center 10.4 +-4.6; yellow: 6.8 +-7.7; n=1181/1198) -- unlike black (see below), so a small fallback threshold correctly recovers them: blue_triangle 1.5% -> 50.2% correct, yellow_square 86.2% -> 86.6%.
- **Threshold chosen (10.0) by the same trade-off discipline as the black S-cap**: swept 0/5/8/10/12/15/20/25/30 end-to-end. 10 sits safely below the 12->15 cliff (keeps green's own harmless-unknown safety net mostly intact -- only 19.7% of its residual unknown pool converted to a wrong label at threshold=10, vs. 98.4% at 15) while still capturing most of blue's real recovery. Quantified cost at threshold=10: `black_circle` gains 15/1200 (1.25%) new false labels versus fallback-off (10 as blue, 5 as yellow) -- `black_circle`'s and `red_triangle`'s own CORRECT counts are unaffected (1124/1200 and 44/1196, unchanged from fallback-disabled).
- **"Should black participate in the fallback tier?" -- decided against, and confirmed by data, not assumed**: the `--hue-stats` diagnostic measured `black_circle`'s real hue at mean=116.6, std=16.3 (n=1200) -- far from the "unconstrained scatter across the full 0-180 range" hypothesized going in, but *worse* in a different way: it sits almost on top of **blue's** canonical hue center (120, circular distance ~3.4), meaning black's real detections are themselves at elevated, threshold-scaling risk of being nearest-hue-matched to "blue" by this tier (false-black-as-blue: 0 at threshold<5, 10 at threshold=10, 17 at 15, 45 at 30) -- the dominant reason not to push the threshold any higher than 10 for marginal extra blue/yellow recall. `COLOR_HUE_CENTERS` excludes "black" entirely (only blue/red/yellow/green participate as fallback candidates); black keeps its existing dedicated S/V bin as its only tier.
- **First live-Jetson result with today's fix deployed (single frame, all 5 features visible)**: `black_circle` and `green_hexagon` now correctly detected (`black=(-0,+0)`, `green=(+0,+30)`, matching the manifest) -- the first live confirmation either fix transfers off the laptop-webcam historical dataset they were tuned against. `red_triangle`/`yellow_square` still correct. `blue_triangle` (manifest position (0,-30)) read as `unknown` this frame -- reported as a possible regression, but the mechanism doesn't support that: `blue` is checked first in `COLOR_CHECK_ORDER` (unchanged today) and its own bin (`H:90-150,S:50-255,V:50-255`) was never edited -- first-match-wins means no change to black's/green's bins can steal a blob that blue's own bin would have matched. More telling: this same session's historical-dataset harness already measured `blue_triangle` at only 18/1181 (1.5%) correct under this exact, untouched bin -- i.e. blue's classification was already marginal/lighting-dependent independent of anything shipped today, it just happened to read as fully reliable on every prior live-Jetson observation until this one frame. Read as probable pre-existing marginal behavior surfacing, not a caused regression -- **not acted on from a single frame**; next step is confirming persistence (a short live run, not one snapshot) before touching blue's bin. Does not block `docs/EVALUATION_STRATEGY.md`'s sequence either way (uses green/red/yellow/black only, never blue).
- **Live-hardware verification still outstanding -- this is the actual remaining blocker on `docs/EVALUATION_STRATEGY.md`'s sequence, not the classifier code itself.** Every number in all three 2026-09-15 entries comes from `session_20260810_114330` (laptop webcam, historical), never the Jetson's own camera/lighting that produced the original bug report. Attempted direct SSH access to the Jetson (`jetson-orin@192.168.55.1`) from this environment to check live myself -- reachable at the network layer, but no passwordless key is set up, so direct verification isn't possible from here. No local diagnostic script exists for live per-blob HSV/mask-confidence logging (the two prior entries' harnesses only ever ran against saved historical frames), and writing new live-capture instrumentation without any way to test it before handing it to real hardware would repeat the exact "shipped blind" mistake this session's own black-S-cap lesson was about -- not done. Next step: re-run the same command that produced the original report (`run_jetson_standalone.py --dummy-audio --headless --kalman`), plus a non-headless VNC session (`host_software/ml_jetson_vla/docs/JETSON_VNC_DEBUG_ACCESS.md`) specifically to visually distinguish "no blob forms" from "blob forms, wrong/unknown label" at `black_circle`'s and `green_hexagon`'s locations -- the existing status line only prints already-detected colors, so it can't tell those two failure modes apart on its own.
- **Final end-to-end before/after (1200-frame harness, old S=50/no-fallback vs. new shipped defaults S=20/threshold=10)**: black_circle 1124/1200 (93.7%) -> 1124/1200 (93.7%, unchanged); blue_triangle 18/1181 (1.5%) -> 593/1181 (50.2%, improved -- side effect of the fallback tier, not this session's primary target); yellow_square 1033/1198 (86.2%) -> 1038/1198 (86.6%, improved); **green_hexagon 0/1191 (0.0%) -> 1126/1191 (94.5%)** -- the primary goal; red_triangle 44/1196 (3.7%) -> 44/1196 (3.7%, unchanged). No regression on any of the four previously-working/partially-working colors' own correct-detection counts.
- **Confirms, does not fix, the same out-of-scope red/blue hue-wraparound bug**: red_triangle's own numbers are unchanged by every edit this session (44/1196 correct throughout), and the new `_circular_hue_distance()` function is deliberately NOT used to fix `cv2.mean()`'s pre-existing linear-average hue bug in blob extraction -- it only fixes the *new* fallback tier's own center-distance calculation, per explicit scope.
- **Not yet done / open**: (1) `blue_triangle`'s own strict-bin S/V bounds were never re-tuned this session (its recovery here comes entirely from the fallback tier as a side effect) -- a direct S-floor-style fix for blue, analogous to green's, is a plausible follow-up but wasn't asked for and wasn't done; (2) the red/blue hue-wraparound bug remains real, reproduced, and unfixed; (3) `black_circle`'s live-Jetson zero-blob symptom from the first entry above is still unexplained by any dataset checked so far and still needs a real Jetson capture; (4) `docs/EVALUATION_STRATEGY.md` was not touched, per explicit instruction -- still the user's call.

### Marker Target Jump-Gate: `state_machine.py`'s Averaging Had No Outlier Rejection, Fixed With a Static-Position Model (Not a PredictionGate Port)

- **Bug, already confirmed real before this entry**: `TargetStateMachine.get_target_coords()` arithmetic-averaged `marker_history[color]` (a plain `deque(maxlen=10)` fed by `update_markers()` with whatever `{color: (x, y)}` the marker classifier reported that frame) with zero jump/outlier rejection -- unlike `PredictionGate` (`main_onnx_shared_vision_audio.py`), which already gates the ball's own position with an EMA/Kalman anchor, a jump threshold, consecutive-jump rejection, and a seed window. `evaluate_system_control.py`'s own `MIN_TRIAL_DURATION_MS` comment (shipped earlier the same day) already documents the symptom this causes: a sustained ~0.5-1s marker-classifier misclassification burst (this session's earlier yellow/green boundary-flicker findings) rides straight through the average and reaches 29.6mm on real data -- large enough to be mistaken for a genuine command transition.
- **Why this is a new design, not a copy of `PredictionGate`**: the ball genuinely moves and can be lost/reacquired elsewhere, which is why `PredictionGate` needs a motion model (EMA or Kalman) and an `AWAITING_BALL`/lost-and-reseed escape valve. A color marker is a static physical object glued to the printed sheet for the life of one session -- `docs/EVALUATION_STRATEGY.md`'s 2026-09-15 update confirms marker positions are only movable *between* setups, by hand, never mid-recording. So the right model is simpler: the current smoothed estimate is the best guess of a fixed true value; anything far from it is noise, reject it outright (don't blend it in, don't count it toward a "lost" reset), and let more accepted samples only sharpen the estimate. Implemented as `_MarkerPositionFilter` in `host_software/src/state_machine.py`, one independent instance per color (blue/green/red/yellow/black), replacing `marker_history`'s plain deque:
  - No velocity/Kalman term -- there is nothing moving to model.
  - No "lost"/reseed escape valve -- a burst of rejected candidates is not evidence the marker moved, so the anchor holds through the *entire* burst (this is the actual fix: with the old plain mean, a burst lasting >= the window size (10 samples) could fully replace the window and swing the average by close to the raw jump distance; the new gate rejects the burst's first sample against the pre-burst anchor and never updates, so every subsequent sample in the same burst is rejected too, not just the first one).
  - A color going undetected for a while (occlusion, ball sitting on the marker, a transient classifier miss) simply isn't fed an `update()` call that frame -- not gated, not decayed, not reset. The estimate holds at its last accepted value indefinitely, which is correct precisely because the true position hasn't changed.
  - A `seed_window`/`seed_consistency_mm` phase (5 mutually-consistent detections within 10mm before the estimate is trusted at all, mirroring `PredictionGate`'s seed rationale) protects against a noisy first-ever detection for a color. `jump_threshold_mm=15.0` sits between normal same-marker jitter (a few mm, comparable to the ball's own ~5.6mm mean error) and the sheet's real 30mm inter-marker spacing (derived from `aruco_markers_03_manifest.json`'s `center_mm` via the standard `touch_x = W/2 - manifest_x`, `touch_y = manifest_y - H/2` convention), so a same-marker reading is accepted and a different-marker misclassification is rejected.
  - Synthetic smoke test before touching real data: seeded green at (0, 30), then fed 20 consecutive frames at yellow's real position (-30, 0) (exactly the yellow-flickers-to-green failure shape) -- target stayed at (0.1, 29.9) throughout, unmoved; a legitimate small-jitter update immediately afterward was still accepted normally. The old plain-mean code, fed the same 20-frame burst, would have fully replaced its 10-slot window and reported essentially (-30, 0) -- a ~42mm error instead of ~0.
- **Validated against the three real CSVs named in the bug report** (`ground_truth_jetson_20260915_{150041,150729,151627}.csv`), via a new script, `host_software/ml_vision/experiments/marker_target_jump_gate_eval.py` (comparison report, not a fixed benchmark, per this project's `experiments/` convention -- none of the existing `experiments/` scripts covered this). **Real limitation stated plainly**: these recordings log `get_target_coords()`'s OLD, already-averaged OUTPUT every frame, not the raw per-color detections that fed it -- no raw per-color log exists for these runs, so a byte-for-byte replay of the new gate (which runs pre-average, on raw candidates) isn't possible against this data. The script instead identifies each recording's real go_green/go_yellow/go_red/go_black dwell phases (merged segments matched against the sheet's known touch-mm marker positions -- green (0,30), yellow (-30,0), red (30,0), black (0,0); black is disambiguated from the coincident (0,0) "center" default by requiring it to occur after at least one green/yellow/red phase, since a real `go_black` necessarily follows those in the Standardized Evaluation Sequence) and replays each phase's recorded trajectory through a fresh `_MarkerPositionFilter(history_size=10)` (matching `TargetStateMachine`'s actual default exactly) as the closest available proxy, comparing frame-to-frame step-size stats before/after.
  - **Real numbers**: across the 3 recordings' 18 total labeled marker-following phases, max single-frame step dropped by 79-96% in every phase that wasn't a cold-start (e.g. file `150041` go_black: 1.1mm -> 0.2mm; file `150729` go_red: 0.5mm -> 0.1mm; file `151627` go_yellow: 0.7mm -> 0.1mm; file `150729` go_yellow: 0.5mm -> 0.1mm). No phase's max step got worse.
  - **The two 29.6mm spikes reported in `evaluate_system_control.py`'s own comment were reproduced exactly** (file `150729` rows 0:112, file `151627` rows 0:141) and showed 0% reduction in this specific harness -- investigated rather than left unexplained: both land within the first 5 frames of that recording's green history (i.e. the color's very first-ever detection that session), during the seed window. This is not a gap in the fix; it is the harness's own stated limitation cutting the other way here: the OLD code (being replayed as the "before" signal) had zero minimum-sample requirement and returned a single raw detection immediately as the target, which is the actual mechanism behind a wrong first-ever reading snapping the target hard on frame 1 -- exactly what these two spikes are. The NEW code cannot reproduce this failure at all: `get_target_coords()` returns the `center` fallback (0, 0) for any color with no confirmed `_MarkerPositionFilter.position` yet (`filt.position is None`), never a single unvetted raw sample, so a bad first detection is invisible to the state machine until 5 mutually-consistent readings confirm it. The harness's frame-by-frame replay (which falls back to passing the raw sample through pre-seed, purely to keep the before/after arrays directly comparable) understates the real fix here rather than overstating it.
  - **Genuine transitions checked, not just assumed prompt**: switching `current_target_name` (a real `go_<color>` edge) is untouched by this change -- `get_target_coords()` reads whichever color's own already-established filter position is current the instant the target name changes, exactly as before. Every segment boundary in the merged segmentation (`evaluate_system_control.py`'s own `segment_by_target`, reused read-only, not modified) is by construction an instantaneous step in both the old and new signal; nothing in this fix adds a delay at a color switch, only to the smoothing of a single held color's own reported position while it stays active -- confirming the "near-zero added lag" expectation from the static-target model, not just asserting it.
- **`evaluate_system_control.py` -- left alone entirely, confirmed rather than assumed compatible**: its `MIN_TRIAL_DURATION_MS` merge is a separate, still-valid mitigation for its own bookkeeping (trial segmentation), operates purely on already-recorded `target_x/y` columns, and doesn't call `state_machine.py` at all. Read it read-only (for its `segment_by_target`/`load_telemetry` reuse in the new experiment script above) but did not edit it, per explicit instruction.
- **`SessionRecorder` (`host_software/ml_jetson_vla/runtime/session_recorder.py`) -- checked, not assumed, needs no change**: traced its call site in `run_jetson_standalone.py` (`ExpertPolicy.step()`, line ~267): `target_x, target_y = self.state_machine.get_target_coords()` feeds directly into the returned `PolicyCommand`, and the main loop's `session_recorder.log(...)` call (line ~508-516) passes `cmd_out.target_x_mm, cmd_out.target_y_mm` -- i.e. exactly that same `get_target_coords()` return value, with nothing in between. `SessionRecorder` never reads `marker_history`/`marker_filters` or calls into the state machine itself; it only logs whatever value it's handed. Confirms the bug report's expectation exactly: fixing `get_target_coords()` at the source fixes every consumer, `SessionRecorder` included, with no direct edit needed there.
- **Packaged Jetson deployment copy deliberately NOT touched**: `jetson_package_track1/host_software/src/state_machine.py` is a generated copy (`host_software/ml_jetson_vla/deployment/package_for_jetson.py`'s `shutil.copy2` file list explicitly includes `host_software/src/state_machine.py`), not a hand-maintained fork -- edited only the source of truth under `host_software/src/`; the packaged tree picks up the fix next time that script runs.
- **Not yet done / open**: (1) `TargetStateMachine.maybe_auto_hold()` still reads the CURRENT FRAME's raw `marker_coords[self.current_target_name]` directly (not the new filtered `_MarkerPositionFilter.position`) for its "close enough to auto-latch" distance check -- a separate mechanism from `get_target_coords()`, out of the reported bug's explicit scope, but the same kind of single-frame-noise exposure in principle; flagged, not fixed. (2) `host_software/ml_multimodal/evaluations/run_eval_expert.py` calls both `state_machine.update_markers(marker_coords)` AND `state_machine.get_target_coords(marker_coords)` on the same frame with the same dict, double-feeding each frame's detection into the new per-color filter (pre-existing behavior, harmless with the old plain mean since it just duplicated an identical value, and still harmless here since a rejected candidate is rejected identically both times against the same not-yet-updated anchor -- but it does mean each accepted frame's sample is double-weighted in the rolling window, a minor precision/lag quirk) -- not fixed, out of this task's file-boundary scope (only `state_machine.py` was cleared for edits). (3) `jump_threshold_mm`/`seed_window`/`seed_consistency_mm`/`history_size` were chosen from the sheet's known 30mm marker spacing and the ball's own established ~5.6mm error scale, not swept against a labeled dataset the way the marker-classifier bins were -- a real per-color raw-detection log (not just the final averaged output) would allow a tighter, data-driven sweep of these constants; flagged as a follow-up, not blocking.

### Kalman Filter: Laptop-vs-Jetson Transfer Check (Requested by Orchestrating Peer Session)
- **Ask**: whether the Kalman filter's R/Q (fit entirely from laptop-webcam recordings -- see 20/08/2026 entries -- most recently `kalman_params_20260820_savgol.json`) transfers as-is to the Jetson's different camera/timing, rather than assuming it does.
- **Frame-cadence/timing: not a concern, Jetson is if anything a better match than the laptop was.** Measured real inter-frame `dt` via `host_send_ts` across the 3 live Jetson recordings named in the jump-gate entry above vs. the 2 laptop recordings the shipped `Q` was fit from: Jetson median dt 40.4-40.7ms (tight spread, p10-p90 ~39-45ms, max stall only 85-87ms) vs. laptop median dt 46.8-47.0ms (wider spread ~31-53ms, max stall 245-259ms from the previously-documented camera-focus-loss stalls). `Q`'s baked-in `dt_med=40.0ms` actually comes from the STM32 touch telemetry's own ~25Hz sampling rate (`TouchProbe.cpp`), not vision timing at all -- coincidentally, Jetson's real vision cadence lands closer to that figure than the laptop's own vision cadence does.
- **Raw measurement noise (R): informal check only, looks comparable-to-tighter on Jetson, not yet rigorously validated there.** No Jetson recording has the laptop protocol's dedicated pre-motion "still" window (`docs/EVALUATION_STRATEGY.md`'s sequence starts moving at 0s), so a like-for-like R re-estimate isn't possible from existing data. As a rough proxy, checked the sequence's `HOLD` phase (52-60s, 2s settle margin) in the same 3 Jetson files: `raw_err_x/y_mm` std ~2-3.4mm across all three (n=132-144 valid rows each), tighter than the laptop-derived pooled R's ~5.7mm/4.5mm std. No sign Jetson's ball-tracking noise is worse than the laptop's, despite the marker *classifier* (a separate HSV-based pathway) needing real recalibration for this same camera earlier today -- the ball-position regression head apparently isn't hit the same way by whatever lighting/camera differences affected marker HSV. One consistent signal worth a closer look later: a small +2.4 to +3.9mm Y-axis bias appeared in all 3 Jetson runs (vs. near-zero on the laptop's own cleaner still-phase data) -- much smaller than the 5-10mm biases found on the marker-classifier side, not investigated further here. **Caveat stated plainly**: `HOLD` deliberately interrupts mid-transit per the eval sequence's own design, not a clean settled hold, and this is an ~8s-per-file indicative check, not the full protocol -- don't treat this as a real R estimate, only as evidence against "Jetson is obviously worse."
- **Structural fragility found, applies to both platforms, not urgent**: `KalmanFilter2D.predict()` (`kalman_filter.py:56-64`) scales `F` by the real per-call `dt_s`, but adds `self.Q` as a fixed matrix regardless of that `dt_s` -- so `Q`'s magnitude is implicitly calibrated for whatever `dt_med` was present during estimation, not the live per-frame timing. Not currently causing a problem on either platform, since both real cadences already sit close to the ~40ms assumption (see above), but a proper fix (scale `Q` by the actual `dt_s` at each `predict()` call, e.g. via the same van-Loan-style formula `estimate_kalman_noise_params.py` already uses to build `Q` in the first place, evaluated at runtime `dt` instead of a fixed `dt_med`) would remove this fragility if either platform's timing ever drifts further from that figure.
- **Outcome, per the user's response relayed through the orchestrating session**: recommendation accepted as-is -- keep using the current laptop-derived R/Q on Jetson; no dedicated Jetson `--scripted-sequence` recording being prioritized right now. This entry is that documentation, logged as routine (not blocking anything), per that same response.

## 20/08/2026
### Kalman Filter: Raw-Signal Logging Fix, Implementation, and First Real R/Q Estimate
- **Data-quality bug found before trusting any prior recording for filter design**: `touch_logger.send_frame()` was always called with `final_x, final_y` (the fully processed output -- post-EMA/jump-gate/dead-band/MLP), never the raw CNN estimate. Every `err_x_mm`/`err_y_mm` column in every recording taken before this fix characterizes the *current smoothing stack's residual*, not raw sensor noise -- useless as an R (measurement noise) estimate for a filter meant to replace that stack. Fixed: added `raw_vision_x_mm`/`raw_vision_y_mm`/`raw_err_x_mm`/`raw_err_y_mm`/`raw_err_mm` to `touch_logger.py`'s `CSV_FIELDS`, threaded `raw_x`/`raw_y` through `send_frame()`'s signature and the STAGE 7 call site in `main_onnx_shared_vision_audio.py`, updated `estimate_kalman_noise_params.py`'s `estimate_r()` to read the new columns (with an explicit 0-row warning for recordings that predate this fix).
- **`KalmanFilter2D` implemented**: `host_software/ml_vision/core/kalman_filter.py`, standard constant-velocity predict/update (state `[x, y, vx, vy]`, `F`/`H`/`Q`/`R` as derived in-session). Wired into `PredictionGate` as an optional drop-in replacement for the EMA (`--kalman`, `--kalman-params <json>`) -- jump-gate/seed/no-ball/dead-band logic is unchanged, only the "what's the current smoothed estimate" step switches between EMA-blend and Kalman predict+update. `reset_smoothing()` (stall recovery) now also deinitializes the Kalman filter so a post-stall reading is accepted directly instead of being jump-gated against a stale state, matching the existing EMA-reset behavior. `estimate_kalman_noise_params.py` gained `--output-json` to write `{"r": ..., "q": ...}` directly in the format `--kalman-params` consumes.
- **Verified before hardware**: a synthetic-trajectory smoke test (seed, smooth drift, outlier rejection, stall-reset, dead-band, EMA-mode regression -- all 5 pass) confirmed the integration is correct and, notably, that the Kalman filter tracks a steady 1mm/frame drift with ~5x less lag than the EMA would at a comparable noise-suppression level (1mm behind after 20 frames vs. an EMA's ~5.7mm steady-state lag at alpha=0.15) -- the concrete mechanism behind why this should reduce control latency, not just noise.
- **First real R/Q estimate, from `ground_truth_20260820_102744.csv` (107.8s, genuine `--scripted-sequence` run -- confirmed via `target_x/y_mm` holding at (0,0) for the first 30s then moving to two distinct scheduled targets)**: `R = [[78.6, 15.9], [15.9, 34.0]]` mm², `Q` per the discretized constant-velocity formula (`accel_x std=5410 mm/s²`, `accel_y std=1966 mm/s²` at dt=40ms). **Caveat, not yet resolved**: the nominal "still" phase (target held at center) shows `touch_x/y_mm` std of 17.6mm/14.8mm and an x-bias of +9.4mm -- the ball was demonstrably NOT stationary during this window, meaning R is still contaminated by real motion (not pure sensor noise), consistent with the user's report that control is never fully achieved without the MLP corrector engaged. Both R and Q from this recording should be read as *conservative* (they overstate true noise, which makes the filter trust measurements less / lean on the motion model more) rather than *wrong* -- safe to test on hardware, but a recording where the ball genuinely holds still during the R-estimation window (once control is stable enough to produce one) would give a tighter, more trustworthy R. Written to `host_software/data/01_bronze/evaluation/kalman_params_20260820_102744.json`.
- **Not yet done**: live hardware test of `--kalman --kalman-params ...` against the existing EMA+dead-band baseline and against the MLP corrector, to see whether it actually improves control stability -- this is the next concrete step, at the user's explicit direction.

### Kalman Filter: First Live Test, Refit With Genuinely-Still Data
- **First live test (`--kalman`, no `--mlp`) produced 3 short recordings (`ground_truth_20260820_105648/105711/105756.csv`)**: no crash, no NaN/Inf, jump-gate/reset-on-stall logic all behaved correctly (verified by tracing every large single-frame transmitted jump back to a `send_dt_ms > 100ms` stall event -- one of which was a genuine ~4.1s freeze, likely Windows console QuickEdit Mode pausing the process on a click/selection, not a code fault). But real control instability was present (ball repeatedly out past 80mm from center, motor std up to ~55) -- expected, since this test omitted `--mlp` and the user had already established control isn't achieved without it regardless of smoothing method. Not a Kalman regression, just an unfair (filter-only) comparison.
- **A later run (`ground_truth_20260820_135139.csv`, 103s, target continuously varying -- live marker-tracking, not `--scripted-sequence`) was qualitatively the best result yet**: zero stalls (max `send_dt_ms`=87ms), transmitted-vs-raw correlation 0.987/0.986, 0% of frames within 80mm of the platform edge, motor std down to 18-23. Exact flags used (in particular whether `--mlp` was also on) weren't captured -- worth confirming and logging properly.
- **Refit R/Q from two follow-up `--scripted-sequence --kalman` recordings taken once the filter was visibly holding the ball steady**: `ground_truth_20260820_135916.csv` and `_140309.csv` both show still-phase touch position std of ~7-11mm, versus ~15-20mm in the pre-Kalman data used for the first R estimate -- direct confirmation the contamination problem (real motion masquerading as measurement noise) is resolving now that the filter itself helps hold the ball still. (A third recording, `_140113.csv`, was a short/aborted run with worse still-phase std (~25-31mm) and excluded from the refit rather than let it drag the pooled estimate back toward the old numbers.)
  - Pooled result (`estimate_kalman_noise_params.py --csv <135916> <140309> --output-json kalman_params_20260820_refined.json`): `R = [[32.2, 1.0], [1.0, 23.2]]` mm² (down from `[[78.6, 15.9], [15.9, 34.0]]`) -- the cross-covariance term dropping from 15.9 to ~1.0 is the clearest signal, since independent-axis sensor noise shouldn't correlate; that correlation was mostly the clock-skew-during-motion contamination, now largely gone. x-bias also dropped (+9.4mm -> +5.4mm) but didn't vanish -- a small residual CNN/touch coordinate-frame calibration offset may still exist, not investigated further this session. `Q` accel-noise std moved from (5411, 1966) to (3466, 2265) mm/s^2 -- x tightened notably, y roughly comparable.
  - **Bug caught and fixed while pooling**: `estimate_kalman_noise_params.py --csv` now accepts multiple recordings (`nargs="+"`), but pooling must NOT simply concatenate raw rows across files before Q's differentiation step -- `mcu_ms` is a per-recording MCU clock that resets each session, so sorting a naive concatenation by `mcu_ms` would interleave two unrelated timelines and produce garbage acceleration samples at the seam between recordings. Fixed by differentiating each recording's moving-phase rows independently, then pooling only the resulting acceleration *samples* (`estimate_q()` now accepts a DataFrame or a list of them). `estimate_r()` pools safely either way, since each row's `raw_err_x/y_mm` is independent with no cross-row timing involved.
- **Not yet done**: live hardware test of the refined params (`kalman_params_20260820_refined.json`), and confirming/logging exactly which flags produced the good `135139` run so it can be reproduced deliberately rather than incidentally.

### Kalman Filter: Third Recording, Persistent X-Bias Finding, Savitzky-Golay Q Fix
- **Third clean still-phase recording (`ground_truth_20260820_141130.csv`)** pooled in alongside `135916`/`140309`: `estimate_kalman_noise_params.py --csv` already supported multi-file pooling from the prior refit, so this was a direct re-run, no code change needed. Result (`kalman_params_20260820_refined2.json`): `R = [[32.3, -1.9], [-1.9, 20.0]]` mm^2 from 1406 pooled still-phase rows.
- **X-axis bias confirmed real, not noise**: raw_err_x_mm's mean was +5.4mm (2-recording pool), +10.6mm (this run alone, despite its still-phase touch std being the tightest yet at ~3.8mm), +7.1mm (3-recording pool) -- a bias that doesn't shrink toward zero as sample count grows, unlike genuine measurement noise would. Y-axis bias stays near zero throughout (+1.0mm pooled). Points at a real, likely fixable coordinate-frame calibration offset between the CNN's output and the touch sensor's ground truth, isolated to X -- not yet investigated (candidates: `px_to_touch_mm()`'s calibration, or a physical ArUco/touchpad mounting offset). Flagged for follow-up, not fixed this session; R's diagonal is still absorbing it as if it were variance, which is a real but currently-accepted approximation.
- **Q's differentiation noise addressed via Savitzky-Golay pre-smoothing**: `estimate_q()` swung between accel_x std of 3466-5411 mm/s^2 run to run despite similar underlying motion -- confirmed as noise-amplification from double-differentiating raw, unsmoothed `touch_x/y_mm`, not genuine signal instability. Added a Savitzky-Golay filter (`scipy.signal.savgol_filter`, window=9 samples/~360ms at ~25Hz, polyorder=3, clamped safely for short recordings) applied to position before the velocity/acceleration differentiation step. Window chosen well below the multi-second cadence of scripted target nudges, so it suppresses jitter without flattening genuine motion. Effect on the same pooled 3-recording moving-phase data: accel_x std 4293 -> 1348 mm/s^2 (~3.2x), accel_y std 2987 -> 606 mm/s^2 (~4.9x), Q's velocity-variance terms (`q[2,2]`/`q[3,3]`) dropped roughly 10x accordingly. R is unaffected (it doesn't touch position differentiation). New params: `kalman_params_20260820_savgol.json`.
- **Not yet done**: live hardware test of the Savitzky-Golay-refined params; investigating the x-axis calibration bias at its source.

### Agent Context Consolidation: `.agents/*.md` → `CLAUDE.md` + Native Subagents + Skills
- **Problem found, not assumed**: `.agents/AGENTS.md` used the Codex/OpenAI-style filename convention, not `CLAUDE.md` — Claude Code never auto-loaded any of it (confirmed: no `CLAUDE.md`, no `.claude/agents/`, no `.claude/skills/` existed anywhere in the repo before this). Every one of the 6 `.agents/*.md` files was pure manual-read overhead (~21K tokens combined to read all of them), and two had drifted while duplicating `AGENTS.md`: `agent_main.md` still said "Jetson Nano" nine days after `AGENTS.md` corrected this to the Jetson AGX Orin 64GB (p3730); `agent_ml_vision.md` and `agent_ml_audio.md` (both last touched 2026-08-11) predated almost everything currently real in their own domains (ArUco homography, the Shared Backbone CNN, the Phase 2 audio failure-cluster breakdown).
- **Fix**: moved always-relevant, current-only content into `CLAUDE.md` (repo root, auto-loads every session) — hard constraints, locked architecture decisions, the coordinate-mm contract, coding conventions, a repo-structure pointer map, current MCP tool status. Converted the four `agent_*.md` files into native subagents (`.claude/agents/fpga.md`, `ml-vision.md`, `ml-audio.md`, `ml-multimodal.md`) that load on demand via the Agent tool instead of costing tokens in every session — refreshing `ml-vision.md` and `ml-audio.md` against current project state in the process, not just reformatting the stale versions. Extracted five cross-cutting procedures into skills (`.claude/skills/`): `fpga-pipeline` (verification-first sequence + the clocking/CDC/hls4ml pitfalls this project has hit more than once — GCLK routing, dual-rank CDC synchronizers, PLL VCO range, ap_fixed calibration), `data-pipeline-verification` (dry-run + visual-overlay + row-count-invariant checks before trusting a changed labeling/sync script), `dataset-integrity-check` (leakage/corruption/coverage audit of a dataset already at rest), `model-iteration-constraints` (resource budget + hls4ml-compatibility + the "≥5 seeds, isolate data-vs-architecture" methodology this project's decoder-trial and vision-class-comparison work already had to learn twice), and `data-processing-pipeline` (shared Medallion-tier contract + per-module ground-truth method for vision/audio/multimodal).
- **Old files kept, not deleted**: each `.agents/*.md` now holds a short pointer stub to where its content moved, so nothing that still references the old paths breaks silently. `.agents/codev_mcp.py` (referenced by `.mcp.json`) is unaffected.
- **Not yet done**: no live session has yet exercised auto-delegation to the new subagents or an on-demand skill load — the restructuring is confirmed correct by direct inspection (file contents, cross-references), not yet by an end-to-end "Claude picks the right subagent/skill unprompted" test.

## 19/08/2026
### Ground-Truth Telemetry: Throughput Collapse Diagnosed and Fixed
- **Symptom**: with `TouchTelemetryLogger` (ground-truth CSV logging, wired up 18/08) enabled, the bot lost control of the ball entirely. With `--log-csv off`, control returned to the same mild-oscillation baseline seen before any of the telemetry work -- i.e. the underlying, still-unsolved oscillation problem from 18/08 was untouched either way; the CSV logger was an independent, much more severe *additional* failure mode layered on top of it.
- **Root cause, confirmed from real recorded telemetry, not assumed**: the vision loop's sustained throughput collapses from the benchmarked ~95-107 FPS (no logger) to a median ~20-25 FPS with the logger active -- confirmed by computing inter-send gaps from `host_send_ts` across three real recordings (`host_software/data/01_bronze/evaluation/ground_truth_*.csv`), after first catching and correcting a measurement bug of my own (naively using row-count/total-time as "FPS" measures the firmware's 60Hz `TouchProbe` echo cadence, not the vision send rate -- each echo repeats whatever vision frame the firmware last received whenever vision is slower than 60Hz, so raw row timestamps are heavily duplicated). The on-screen status line's own FPS number was misleadingly showing 80-110 throughout, because it only times work *after* frame capture -- any stall further upstream (camera read, serial I/O) is invisible to it.
- **Suspected mechanism**: the original design had the main thread call `ser.write()` directly while a separate background thread read from the same `pyserial.Serial` handle -- either GIL contention between the two threads' Python-level work, or contention at the OS/driver level from two threads touching one handle concurrently (not fully disambiguated, but the fix below addresses both).
- **Fix**: redesigned `host_software/src/touch_logger.py`'s `TouchTelemetryLogger` so its single worker thread owns *all* serial I/O -- both directions. The main thread (`main_onnx_shared_vision_audio.py`) no longer calls `ser.write()`/`ser.read()` at all; it only calls `send_frame(seq, x, y, target_x, target_y)` (registers the pending frame for echo-joining and enqueues the outgoing bytes) or `send_raw(b"L\n")` (lost-ball marker), both just pushing onto a `queue.Queue` -- no serial access, no lock needed for the hand-off. The worker thread drains the outgoing queue before each read attempt, so writes are never delayed behind more than one read-timeout window. CSV persistence is now an independent, optional feature of the same object (`csv_path=None` runs the thread purely for its I/O-consolidation benefit, with `--log-csv off` no longer meaning "the thread doesn't exist," just "it doesn't write rows") -- previously CSV logging and single-thread serial ownership were the same on/off switch, which was never the actual intent.
- **Complementary firmware change**: `TouchProbe.cpp`'s `TOUCH_RATE_HZ` lowered 60 -> 25, since 60Hz was producing several duplicate echo records per distinct vision frame once the host's real throughput was known to be ~20-25 FPS -- pure wasted read/parse volume on the host side for no benefit. Still comfortably above Nyquist for the ~1-5Hz oscillation frequencies actually relevant to the diagnostic.
- **Verified**: an isolated smoke test against a mock serial object (`send_frame`/`send_raw` correctly enqueue and get written by the worker thread, incoming echoes correctly join back to their pending frame, CSV persistence correctly toggles on/off independent of the thread's existence) -- both passed. Real hardware re-test (does control survive with `--log-csv` on now) still pending, not yet run on the physical rig.

### Live-Deployment Jitter Diagnosis: `main_onnx_shared_vision_audio.py`
- **Symptom**: on real hardware (STM32 RL control build, `firmware/stm32_ml_control_and_vision/`), the ball would reach center and hold for 2-5s, then drift again in a non-periodic, "random" (not oscillatory) way. Toggling `--mlp` made no visible difference, and the debug tracking dot looked visibly jittery in all configurations.
- **Root cause, found by tracing the actual code path (not assumed)**: `PredictionGate._handle_tracking()` (copied unchanged from `main_onnx_aruco_audio.py`) computed `self._ema` on every accepted frame but only used it internally for the *next* frame's jump-distance check -- the accept branch returned the raw `candidate` itself, and `_hold()` returned `self._last_good` (also raw). So the gate only ever filtered out large single-frame outliers; every value that passed (the large majority of frames) was relayed completely unfiltered, MLP-corrected or not -- explaining why `--mlp` toggling was invisible (the debug dot is drawn from `px_x/px_y`, computed immediately after the raw CNN forward pass, upstream of the gate and the MLP entirely).
- **Why this hits harder on the current firmware than it might have historically**: the currently-active RL control build has no position-side filtering of its own -- it EMA-filters *velocity* (finite difference of raw position, alpha=0.35) but consumes raw `ball x, y` and `error to target` directly in its 9-element observation. Differentiation amplifies high-frequency noise before the velocity filter ever sees it, and the position terms get no filtering at all. This is unlike the older PID/data-collection build (`firmware/BallBalancingBot/`), which had an EWMA settling filter, slew-rate limiter, and derivative-on-measurement specifically built to handle a noisy position sensor (the original resistive touchscreen) -- see 20/07/2026 and 10/07/2026 entries. None of that infrastructure carried over to the RL build's serial-fed vision input path. A neural policy also doesn't have a PID's clean periodic-oscillation failure mode when fed noise outside its training distribution, which plausibly explains why the drift looked "random" rather than patterned like earlier PID-era testing.
- **Fix**: `PredictionGate` now returns `self._ema` (the smoothed value) instead of the raw candidate on every return path (`_handle_tracking()`'s accept branch and `_hold()`), while `_last_good` still anchors the jump-gate's own accept/reject comparison to the true last-observed raw point (unchanged). The RL network's weights are fixed (`weights_best_so_far1.h`), so retraining wasn't an option here -- this smooths the signal before transmission instead, using the existing `--gate-ema-alpha` (no new CLI flag). Explicitly a live A/B experiment at the user's request ("we will revert back if it makes it worse"), not yet confirmed to fix the drift on hardware.

### Laptop Inference Integration for `shared_vision_backbone_v2`
- **New entry point**: `host_software/main_onnx_shared_vision_audio.py`. Structural scaffolding (audio receiver, `TargetStateMachine`, `PredictionGate`, serial transmission @ 2,000,000 baud) reused wholesale from `main_onnx_aruco_audio.py`; preprocessing replaced with the training-matching perspective warp (`estimate_homography_from_aruco()` + `warp_to_platform()` from `auto_label_shared_vision.py`) instead of the old axis-aligned bbox crop. Confirmed the ArUco fiducial layout (ids 0-5) is identical across every printed sheet -- `ground_truth_manifest.json` vs `aruco_markers_01_manifest.json` diff to identical `aruco_markers` lists, only `features` differs -- so the live homography lookup is built once from the base manifest regardless of which sheet is physically mounted.
- **Bug found and fixed (px->mm conversion)**: while building `run_shared_vision_inference_on_dataset.py` (offline batch inference, needed to produce a training set for a new MLP corrector -- see below), a dry-run sanity check on 200 frames/session showed a suspiciously large 51mm mean error against ground truth, vs. the model's documented 4-5mm accuracy. Root cause: converting the model's px output to `touch_x`/`touch_y` (the firmware/PID mm convention) is NOT a simple centering subtraction -- confirmed by re-deriving the inverse of `auto_label_shared_vision.py`'s already-fixed ball-label formula (`ball_x_mm = W/2 - touch_x`, `ball_y_mm = H/2 + touch_y`; see 12/08/2026, "ball label point-reflection bug"). The X axis needs `touch_x = W/2 - manifest_mm_x`, not `manifest_mm_x - W/2` as first written. After the fix, dry-run mean error dropped to 7.1mm (in line with expectations); verified visually via `host_software/ml_vision/evaluations/reports/shared_vision_v2_offline_inference_dryrun_verification.png` before committing to the full run. Same corrected formula is used in both the offline script and the new live entry point.
- **New: live marker detection**, previously nonexistent in any entry point. `host_software/ml_vision/core/marker_classifier.py` implements Component 5 of `implementation_plan_shared_backbone_cnn.md`: `cv2.connectedComponentsWithStats` on the CNN's thresholded `mask_head` output, per-blob HSV-bin color classification and circularity/`approxPolyDP` shape classification (circle/triangle/square/hexagon), soft-argmax centroid refinement using the `heatmap_head` output within each blob. Feeds a `{color: (x_mm, y_mm)}` dict into `state_machine.py`'s `update_markers()`/`maybe_auto_hold()`, which existed but were never called with real data by any prior entry point.
  - Tried eroding each blob's mask before averaging HSV (to reduce edge anti-aliasing diluting saturation on these small, ~100px blobs) -- measurably increased saturation readings, but also shifted one marker's mean hue just past the yellow bin's lower bound (H 21.2 -> 19.1, bin is 20-35), turning a previously-correct classification into "unknown". Reverted: net negative on a 5-frame real-image smoke test, and exactly the kind of bin-boundary brittleness Component 5's own spec already anticipates via its "SVM Fallback" note -- not worth chasing with more manual threshold tuning right now.
  - **Known limitation, left as-is**: real markers can be genuinely desaturated under some lighting (observed mean HSV down to S~15-30 on 2 of 5 markers in one test frame) and fall outside all 5 color bins ("unknown"). One case was a true "grey" marker, which Component 5's bin table doesn't cover at all (grey was in the old, unused `MarkerTracker`'s bins but was dropped from the current 5-color spec). Not fixed now -- matches the spec's own documented fallback path (train a small SVC on collected HSV features) if this proves to matter in practice.
- **`state_machine.py`**: added a `"black"` key to `marker_history` (previously only blue/green/red/yellow, despite `black` being a valid audio target) -- one-line fix, makes `go_black` usable end-to-end now that the classifier can actually detect black markers.
- **New MLP time corrector, trained and validated (not just reused)**: the existing `mlp_corrector_time_aruco_0730_v1` was trained on the old model's raw full-camera-frame pixel output (`/320.0`, `/240.0` normalization) -- a different geometric space than this model's output (normalized over the warped 128x128 platform frame), so it can't be reused as-is. Built `run_shared_vision_inference_on_dataset.py` to run `shared_vision_backbone_v2` over all 52,772 rows of Dataset 8 (`shared_vision`) and capture its raw predictions (`shared_vision_v2_inference_predictions.csv`, mean/median Euclidean error 8.28mm/4.61mm across train+val, consistent with the dry-run check). Built `train_mlp_corrector_shared_vision.py` (adapted `TimeWindowDataset`/`MLPCorrectorTime` pattern, correct mm-based normalization, per-session-aware windowing so sequences never cross session boundaries, `temporal_split()`-based held-out slice instead of one global sequential cut) and `evaluate_mlp_corrector_shared_vision.py`.
  - **Result**: the new corrector (`mlp_corrector_shared_vision_v1`) genuinely helps -- held-out mean Euclidean error drops from 7.70mm (raw) to 4.99mm (corrected), a 35.2% reduction; median 4.25mm -> 4.11mm; p95 11.36mm -> 10.35mm (improvement concentrated in trimming higher-error frames, as expected of temporal smoothing). This is a real, validated result, not an assumption -- gates the new entry point's `--mlp` flag (default off) to actually have a working, checkpoint-backed option rather than a stub.
- **Verification**: full pipeline (ArUco homography -> warp -> ONNX inference -> sigmoid -> marker classification -> `state_machine`) smoke-tested end-to-end against real raw camera frames (session_20260810_110239, pre-warp `images/`, not the pre-warped training images) -- no exceptions, plausible marker positions recovered (~30mm from center on 2 axes, matching the sheet's quincunx layout), `state_machine.marker_history` confirmed to include all 5 colors. Live hardware (camera + STM32 + physical platform) was not available to test this session -- the loop itself (frame acquisition, serial transmission) is untested beyond this synthetic smoke test.

### Jetson AGX Orin Port Kicked Off (4-Track Plan) -- `host_software/ml_jetson_vla/`
Phase 6's major goal (small/medium/large model classes compared on a shared Jetson AGX Orin 64GB, p3730) had no concrete implementation yet -- `ml_jetson_vla/` was just `core/control_net.py` + an architecture doc. Planned and started a 4-track effort this session; full plan at `C:\Users\Admin\.claude\plans\cozy-wishing-swan.md` (session-local, may go stale), durable status kept in `host_software/ml_jetson_vla/docs/ARCHITECTURE.md`.

- **Track 1 (small-class expert pipeline on Jetson, CPU) -- built, not yet hardware-tested**: `runtime/run_jetson_standalone.py` ports `main_onnx_shared_vision_audio.py`'s pipeline (reuses its `PredictionGate`/`preprocess_warped`/etc. by import, not copy-paste, to avoid the two entry points drifting apart) to Linux/Jetson -- camera backend, ONNX `CPUExecutionProvider`, and the wire protocol to the STM32 are all unchanged; only the serial-port default and sys.path bootstrap (this file is nested one level deeper than the laptop entry point) differ. `core/policy_interface.py` adds the `Policy`/`PolicyCommand` interface named in `ARCHITECTURE.md`'s module layout but never built. **Phase A only**: the STM32 still runs its own control net (`RLControl.cpp`) -- this script only sends `ball_x,ball_y,target_x,target_y` over `SerialCoords.cpp`, same as the laptop version. Verified so far: full import chain resolves cleanly (`--help` exercises every import without needing hardware); the actual camera/STM32/on-platform validation ladder in the plan has not been run -- no Jetson or STM32 access in this environment.
- **Track 2 (STM32 telemetry-back, proposal only) -- revised after finding real prior art**: `SerialCoords.cpp` (what Track 1 uses) turns out to have **no telemetry-back at all** on the current source-of-truth firmware (`stm32_ml_control_and_vision/BallBalancingBot.ino`) -- `evaluate_system_control.py`'s `theta_a/b/c` columns are unreachable from a Jetson-hosted Track 1 run without this. Drafted a `Telemetry.cpp/.h` proposal in `ml_jetson_vla/stm32_interface/` (staged, not merged -- `firmware/` is outside this agent's write boundary), then found `firmware/MLVisionPIDControl/PIDControllers.cpp` already implements exactly this (a packed `TelemetryPacket` + `0xAABBCCDD`-style sync header, gated by `enable_binary_telemetry`) -- **a previously-uncatalogued 7th firmware duplicate**, missed by the existing "six `BallBalancingBot.ino` copies" audit (`.agents/AGENTS.md`) because it's named `MLVisionPIDControl.ino`, not `BallBalancingBot.ino`. Revised the proposal to match that precedent's struct/sync-header conventions instead of diverging from it. **Open discrepancy flagged for the firmware owner, not resolved here**: `RLControl.cpp` treats `motorX.currentPosition()` (real, lagged) as the control net's `actual_steps`; `PIDControllers.cpp`'s own telemetry instead logs `steps_to_angle(pos[i])` (the commanded-target buffer) -- a real inconsistency between firmware variants worth checking, not a typo assumed away.
- **Track 3 (medium class, GPU/TensorRT) -- ONNX export done and verified**: `run_eval_expert.py`'s pipeline (`yolov8_platform_pose_markers_iphone_v1` + `mlp_corrector_iphone_v1`) had never been exported to ONNX. First attempt wrote a standalone exporter inside `ml_jetson_vla/` -- corrected mid-session on user direction ("we already have code within each sub directory to make onnx models... just call what we need into here"): added `export_corrector_mlp_iphone_v1()` to `ml_vision/training/export_to_onnx.py` itself (mirroring its existing `export_mlp_corrector()` pattern; `CorrectorMLP` had no exporter yet) plus an item-6 call for both checkpoints, and reduced `ml_jetson_vla/deployment/export_medium_class_onnx.py` to a thin caller. Both `.onnx` files now sit next to their source checkpoints in `ml_vision/models/...`, matching every other exported model in this repo. **Verified, not just written**: numeric parity vs. PyTorch (~7.6e-6 max diff on the MLP corrector), onnxruntime CPU load-and-infer on both. **Finding**: the YOLO export landed at the requested opset 12; the MLP corrector's export silently landed at opset 18 instead (torch 2.12's dynamo-based exporter couldn't downgrade, fell back rather than erroring) -- numerically fine, but check the target JetPack's supported opset range before assuming it loads there unmodified. GPU-provider runtime code itself not yet written (needs Jetson hardware to verify raw-ONNX YOLO-pose post-processing/NMS decode correctness before trusting it, per this session's verify-before-trust approach).
- **Track 4 (large VLA, research spike) -- findings only, no build**: none of `AGENTS.md`'s 3 surveyed candidates (Octo-small ~5-8Hz, Qwen2.5-VL-3B few tok/s, OpenVLA ~2Hz) meet the ~30Hz control-loop requirement -- expected, not a survey gap, since no single-rate monolithic VLA in published work does. User's own reading of the FASTER and VOTE papers plus a same-session repo check (`github.com/PKU-SEC-Lab/Jetson-PI`) converged on a **dual-rate architecture** (slow VLM grounding + fast action-expert, matching NVIDIA Isaac GR00T N1's own System-2/System-1 production pattern) as the right shape. Jetson-PI is the strongest lead found -- unlike the paper-only LiteVLA-H/VOTE, it's built on Physical Intelligence's real, downloadable π0.5/OpenPI (Apache 2.0) and directly targets the FASTER paper's own critique (perception-execution misalignment) via a future-correction world model. Training-data strategy resolved: log Track 1's real closed-loop Jetson runs as the inner tier's primary training set (mirrors `ml_multimodal/train_vla.py`'s existing BC-from-expert-pipeline pattern) rather than scripted straight-to-marker runs, which the user correctly flagged as insufficiently diverse (no recovery/disturbance coverage) on their own. Full writeup: `host_software/ml_jetson_vla/docs/LARGE_VLA_RESEARCH_SPIKE.md`.

## 14/08/2026

### First Successful `shared_vision_backbone_v2` Training Run
- **Result**: full 50-epoch run completed on Colab (Tesla T4, ~5.3 hr total, resumed once after a mid-run Colab disconnect at epoch 42 -- `--resume` worked exactly as designed). Per-session held-out ball px error: 3.7-4.6px across all sessions (real and synthetic) -- the first trustworthy number on this model, since v1's was computed against the point-reflected ball labels (see 12/08/2026 entry) and no full run had completed since the mask-size/shape/heatmap-degeneracy fixes or the decoder swap.
- **Loss curve reviewed**: no overfitting signature (train/test loss move together throughout; test loss tracks at or below train loss, expected given train-only augmentation and running-loss timing, not a red flag). Big gains through ~epoch 20, long flat plateau after -- early stopping (patience 10) never triggered, implying still-marginal genuine improvement rather than a dead plateau.
- **Bug found**: `torch.onnx.export` failed at the very end of the (otherwise fully successful) run with `ModuleNotFoundError: No module named 'onnxscript'` -- recent PyTorch versions moved to a dynamo-based ONNX exporter that depends on the separate `onnxscript` package, which the notebook's `pip install` line never included. Training, checkpointing, and `per_session_eval.csv` all completed and saved before this step runs, so nothing was lost -- but the traceback made a fully-successful run look crashed.
- **Fixes**: added `onnx onnxscript` to the Colab notebook's setup cell. Also wrapped the ONNX export block in `train_cnn_2d_tracker_marker.py` in a try/except -- export failures now print a warning instead of raising, since by that point in the script everything that actually matters (checkpoints, per-session eval) is already saved; export is best-effort, not required for training to be considered successful.
- **Also shipped this session**: per-epoch and cumulative wall-clock training time, now logged to `training_log.csv` (`Epoch_Time_Sec`/`Cumulative_Time_Sec` columns) and printed per-epoch, resume-safe (persisted in the checkpoint). Directly useful here -- confirms ~370-445s/epoch on a T4, ~5+ hours for a full 50-epoch run, i.e. longer than a single typical Colab session, which is exactly the scenario `--resume` exists for.
- **Final real evaluation** (`evaluate_shared_vision_backbone.py` against `shared_vision`, Dataset 8, 100% real, 10,556 held-out samples -- fully isolated from the training mix, per the eval-isolation design from the 13/08 Dataset 9 entry): checkpoint downloaded to `host_software/ml_vision/models/shared_vision_backbone_v2/`.

  | Metric | v1 (flawed labels, pre-fix) | v2 (this run) |
  |---|---|---|
  | ball_px_error_mean | 4.42px | **4.04px** |
  | ball_px_error_median | -- | 3.32px |
  | ball_px_error_p95 | 9.40px | 8.74px |
  | Mean_Euclidean_Error_mm | -- | 5.57mm |
  | 95th_Percentile_Error_mm | -- | 12.12mm |
  | mask_iou_mean | 0.960 | **0.969** |
  | mask_dice_mean | 0.976 | 0.980 |
  | heatmap_mse | 0.00144 | **0.000144 (10x lower)** |
  | fps_estimate (Colab T4) | 3221 | 1783 |

  v1's numbers were never meaningful comparisons (computed against point-reflected ball labels, undersized/circle-only masks, and a degenerate heatmap target -- see 12/08 and 13/08 entries), but the fact that v2 matches or beats v1 on every metric *while being evaluated against the corrected, stricter ground truth* is a real signal, not a coincidence: the decoder swap, the loss reweighting, the mask size/shape fix, and the heatmap multi-peak fix all pulling in the same direction rather than trading off against each other. The 10x heatmap MSE drop is the most direct confirmation that the heatmap-degeneracy fix (13/08 entry) worked as intended -- v1's heatmap head was trained against an almost-constant target and could never have scored this well on a real, position-varying one.
  Qualitative grid (`evaluation_visual_grid.png`) confirms visually: mask contours now correctly distinguish circle/triangle/square/hexagon per marker (not collapsed to circles), and predicted ball position lands on the ground truth in nearly every sampled frame. One sampled frame (idx 7539) is the known blank/placeholder-label edge case flagged earlier in the dataset (pre-existing, not a new issue).
  Outliers exist (`ball_px_error_max` 114.6px, `Max_Euclidean_Error_mm` 156.2mm) but the tight percentiles (p95 8.7px / 12.1mm) show these are rare bad frames dragging the max up, not a systemic problem.
- **Status**: this closes out the full arc from the 12/08 ball-label bug through today -- `shared_vision_backbone_v2` is the first fully-corrected, fully-trained, fully-evaluated checkpoint, with all artifacts (`.pt`, `.onnx`, eval metrics/plots) in `host_software/ml_vision/models/shared_vision_backbone_v2/`. Ready to hand to the FPGA side: `fpga_target_architecture.py` and `trial_fixed_point_quantization.py` (flagged as needing updates for the decoder swap back in the 13/08 "Decoder Trial Result Shipped to Production" entry) can now target a real checkpoint instead of blocking on one existing.

## 13/08/2026
### Heatmap Target dtype Bug (Double vs Float) — Found via First Real Colab Run
- **Symptom**: first actual GPU training attempt on the shipped architecture crashed at `scaler.scale(loss).backward()` with `RuntimeError: Found dtype Double but expected Float`. Did not reproduce locally during the earlier smoke test (CPU-only machine, and `torch.cuda.amp.autocast(enabled=device.type=="cuda")` is a no-op on CPU, which tolerated the mixed dtype that GPU autocast/`GradScaler` strictly reject).
- **Root cause**: `SharedVisionDataset._make_multi_peak_heatmap()` (2026-08-12 heatmap-degeneracy fix) unpacked `cx, cy = centroids[label]` from `cv2.connectedComponentsWithStats()`, whose `centroids` output is always `float64`. Subtracting a `numpy.float64` scalar (not a plain Python `float`) from the `float32` coordinate grid in `_make_gaussian_heatmap()` triggers numpy's type-promotion rules, silently upcasting the whole Gaussian computation -- and therefore `heatmap_target` -- to `float64` for any frame with at least one visible marker.
- **Fix**: cast `centroids[label]`'s components to plain Python `float` before use (avoids the numpy-scalar promotion), plus explicit `.astype(np.float32)` on both `_make_gaussian_heatmap()`'s return value and the final combined array as defence in depth. Verified directly: `SharedVisionDataset[...]` now returns `heatmap_target` as `torch.float32` for a real multi-marker frame (previously would have been `float64`).
- **Scope check**: the overnight decoder trial (13/08 entries above) also uses `SharedVisionDataset` and was therefore also affected -- but all 30 of those runs used `device="cpu"` (confirmed by each run's own `Device: cpu` printout), so the same CPU/autocast tolerance that hid this bug in the local smoke test also means the trial's `ball_px_error`/`mask_iou` results (which don't depend on heatmap dtype) are unaffected; `heatmap_mse` values may have been computed at accidentally-higher float64 precision, a numerically negligible difference, not a validity issue. No re-run needed.
- **Not yet verified on actual GPU hardware** -- this machine has no CUDA device, so the fix is confirmed at the root-cause/dtype level but not by reproducing the original crash-and-recovery on GPU. Next Colab run is the real test.

### Decoder Trial Result Shipped to Production
- Applied the locked decision (below) to `train_cnn_2d_tracker_marker.py`'s `SharedVisionBackbone`: `mask_head`/`heatmap_head` now use `Upsample(scale_factor=2, mode="nearest")` + `Conv2d(3x3, padding=1)` instead of `ConvTranspose2d`. Verified param count matches the trial's `upsample_conv` variant exactly (91,140). `--mask-loss-weight`/`--heatmap-loss-weight` CLI args added (defaults changed 0.5/0.1 -> 0.1/0.02, threaded through both the training loop and `evaluate_per_session()`'s `total_loss` column for consistency). Encoder, `ball_head`, `forward()` signature, and I/O shapes are all unchanged.
- Smoke-tested against real data (small per-session subset of `shared_vision_synthetic_mix`, 2 epochs): training loss decreases normally (0.14->0.10 train, 0.16->0.07 test), `per_session_eval.csv` and ONNX export both succeed.
- **FPGA-side impact**: `fpga_target_architecture.py` and `trial_fixed_point_quantization.py` still hardcode the old `ConvTranspose2d` structure and will need updating to match before they can run against a checkpoint trained on this. Flagged to the FPGA agent. No new custom hls4ml layer needed for the decoder itself now (GELU remains the only one, already built/verified) -- dropping `ConvTranspose2d` removes that requirement rather than adding one.
- Not yet trained at full scale -- this is the architecture the *next* Colab training run will use, not a retrained checkpoint. `shared_vision_backbone_v2` still doesn't exist yet.

### Decoder Trial: ConvTranspose2d vs. Upsample+Conv2d (FPGA hls4ml Layer Decision)
- **Motivation**: `ConvTranspose2d` (current `mask_head`/`heatmap_head` decoder) requires a custom hls4ml layer for FPGA deployment (`ml_system_parameter_budget.md` §5.9 step 3); `Upsample`+`Conv2d` uses two natively-supported hls4ml layers. Raised by the FPGA agent as worth testing in parallel with the main retrain, not after, given a warm Colab session was imminent — built `trial_decoder_upsample_vs_transpose.py` (same `TrialSharedVisionBackbone` local-copy pattern as `trial_activation_functions.py`) and ran it locally instead, once the corrected-mask dataset reprocessing (same-day, see below) landed, since mask IoU is directly part of what's being compared and the pre-fix masks would have confounded it.
- **Run 1 (3 seeds, production loss weights) was misleading**: showed `upsample_conv` with ~4x higher ball-tracking variance than `transpose` (std 9.6px vs 2.3px), driven entirely by one seed. Read initially as a real architectural instability risk to the ball-tracking control signal.
- **Run 2 (5 seeds, same weights) overturned that reading**: ball-error std became statistically indistinguishable between decoders (7.3px vs 7.3px) — the apparent instability was small-sample noise, not a `upsample_conv`-specific failure mode. Same lesson the 11/08 augmentation trial already taught this project (`ANALYSIS_2026-08-11.md`): don't trust a 3-seed ranking. Meanwhile `transpose`'s mask IoU, not `upsample_conv`'s ball tracking, turned out to be the less reliable metric across seeds (mean dropped from 0.64 to 0.44, three individual seeds landing at 0.28-0.38).
- **FPGA agent's follow-up hypothesis (reweighting) confirmed**: the ball-tracking variance is explained by shared-encoder gradient competition between the ball task and mask/heatmap tasks — exactly the risk `ml_system_parameter_budget.md`'s Option A section flagged going in ("the two tasks might interfere during training"). Ran 2 additional 5-seed sweeps at reduced mask/heatmap loss weights (0.25/0.05 and 0.1/0.02): ball-error std for BOTH decoders drops from ~7.3px to ~1.2-1.7px as weight decreases -- confirming the interference is real and symmetric, not decoder-specific. At the lowest weight setting, ball tracking is statistically tied between decoders (31.5 vs 31.6px) while `upsample_conv` still holds a large, consistent mask IoU lead (0.680 vs 0.380) -- a lead that held at all 3 weight settings tested (15 seed-runs per decoder).
- **Net reading**: the original case for keeping `ConvTranspose2d` specifically to protect ball-tracking stability doesn't hold up -- both decoders benefit equally from loss reweighting, and once that's controlled for, `upsample_conv` costs nothing on ball tracking while keeping most of its mask-quality advantage. Remaining real cost: +42% params (91,140 vs 64,260, both comfortably inside the 612.5KB BRAM budget). Full numbers: `host_software/ml_vision/experiments/results/ANALYSIS_2026-08-13.md`. Final architecture decision (and any writeup in `agent_fpga.md`/the budget doc) left to the FPGA agent/user -- this entry documents the measurement, not the decision.
- **Also added this session**: `--mask-loss-weight`/`--heatmap-loss-weight` CLI overrides to the trial script (used for the reweighting sweeps above, default unchanged at 0.5/0.1 to match production).

## 12/08/2026
### Shared Vision Backbone: Ball Label Point-Reflection Bug, Fix, and Re-label
- **Bug Found**: `evaluate_shared_vision_backbone.py`'s qualitative prediction grid (built earlier this session) showed the shared_vision_backbone_v1 model's predicted ball position landing nowhere near the visible ball, while marker/mask predictions (IoU 0.96) were pixel-perfect -- and the model's own reported ball_px_error was only 4.4px, ruling out a training/prediction bug (a genuinely wrong prediction against a correct label would show a large error, not a tiny one against the wrong label).
- **Root Cause**: `auto_label_shared_vision.py`'s `ball_x_mm`/`ball_y_mm` formula (`touch_x + W/2`, `H/2 - touch_y`) had the sign backwards on BOTH axes relative to the MCU/PID telemetry's actual coordinate convention. Verified quantitatively: found the true ball centroid via image thresholding (excluding the corner ArUco fiducials, which a naive dark-blob search picks up as false positives) across a sample spanning all 4 sessions, and confirmed `true_position ≈ (128 - label_x, 128 - label_y)` to within 1-5px on 10/12 sampled frames (the other 2 were a placeholder `(0,0)` label and a detector miss, not counterexamples). Feature/marker masks were unaffected because they're derived from the manifest's own mm positions, not from `touch_x`/`touch_y`.
- **Fix**: Two-line sign fix in `auto_label_shared_vision.py` (`ball_x_mm = W/2 - touch_x`, `ball_y_mm = H/2 + touch_y`). Re-ran `auto_label_shared_vision.py` against all 4 raw `01_bronze` sessions (~14 min, ~53k frames) -- identical row counts to before (14834/10988/14067/12883), confirming only the ball position values changed, not which frames get labeled. Re-ran `merge_shared_vision_sessions.py --overwrite` to regenerate `03_gold/shared_vision/labels.csv` (52,772 rows, verified: no missing images/masks, no filename collisions).
- **Verification**: Built `verify_shared_vision_labels.py` (new, permanent tool -- overlays `ball_x_px`/`ball_y_px` and the marker mask directly on the source image, no trained model needed) and spot-checked 6 frames per session (24 total). Every single sample now has the label landing exactly on the visible ball.
- **Coverage Plots**: Regenerated `plot_coverage.py` output for all 4 sessions + the merged dataset. Combined-dataset numbers (99.93%, 3070/3072 cells) are byte-identical to the pre-fix numbers already in `dataset_info.md` -- expected, since `touch_x`/`touch_y` (what the coverage plot is based on) were never wrong, only the derived pixel projection was. Also brought Datasets 4-7's `dataset_info.md` entries off a stale pre-overhaul metric (10mm/10-sample grid) onto the current one (2.5mm/1-sample, matching Dataset 8's existing entry).
- **Model Impact**: `shared_vision_backbone_v1` learned the flipped target well (can't be fixed by patching the deployed model -- its weights point at the wrong place) and must be retrained from the corrected labels. Bumped the Colab notebook's `VERSION` to `v2` so the retrain lands in a new Drive folder rather than overwriting `v1`, which stays for reference. Training re-run intentionally deferred to Colab, not this machine.

### Dataset 9: Synthetic Marker Composites (Shape/Color Extension of the 60/40 Plan)
- **Scope**: Implements `docs/plans/implementation_plan_shared_backbone_cnn.md`'s Component 3 (60% synthetic composites on the blank-platform session / 40% real sheets, to stop the model memorizing hard-coded marker positions), extended per user request to also vary shape/color, not just position -- teaching appearance generalization too. Real sheets (Datasets 5/6/7) cover only 11/20 possible (shape, color) combinations (recomputed directly from the 3 manifests, correcting an initial "8/20" estimate); the missing 9 (`triangle-{black,green,yellow}`, `square-{black,red,green}`, `hexagon-{black,red,yellow}`) are biased toward (75% sampling probability) during synthetic generation.
- **Second, unrelated bug found and fixed en route**: `session_20260810_104132` (Dataset 4, blank platform)'s `masks/` directory (18,576 files) contained stale per-ArUco-fiducial mask blobs (4-11px, centred at the 4 image corners) left over from `auto_label_shared_vision.py`'s very first version (commit `d2ec645`, which looped over ArUco markers instead of `features`). The script itself was already correct (features=[] for this sheet means it writes zero mask files today), but the old files were never cleared and `merge_shared_vision_sessions.py`'s generic mask-indexing regex silently pulled them into every blank-platform frame's Dataset 8 mask. Cleared and re-merged (still 52,772 rows, verified clean); confirmed visually via `verify_shared_vision_labels.py` that blank-platform frames now show genuinely empty masks.
- **Process note**: the earlier ball-label re-label run above (same day) passed `ground_truth_manifest.json` (features=`[]`) for all 4 sessions uniformly, including sessions 01/02/03. This was harmless -- ball-position derivation (`touch_x`/`touch_y` -> mm -> px) and image warping only use a manifest's `aruco_markers`/`platform_width_mm`/`platform_height_mm` fields, which are identical across all 4 manifests, never `features` -- so it just meant those 3 sessions' masks weren't regenerated that run (zero new files written, none deleted), leaving their already-correct historical masks untouched. Confirmed via file counts (54,940/56,268/64,415 mask files, consistent with 5/4/5 markers per sheet) and the visual grid.
- **New tooling**: `generate_synthetic_marker_composites.py` (composites 1-5 shapes per frame onto Dataset 4's base images; placement avoids the ball + its shadow via darkness thresholding in a local ROI -- not just a fixed-radius circle around the label point, since a shadow can extend asymmetrically -- the 6 ArUco fiducials via fixed pixel exclusion zones computed once from the manifest, and other placed markers via incremental footprint accumulation, not just centre-to-centre distance) and `combine_shared_vision_training_mix.py` (physically merges synthetic + Datasets 5/6/7 at a stratified-sampled 60/40 ratio, reusing `merge_shared_vision_sessions.py`'s `process_session()` for the real half rather than reimplementing it).
- **Results**: 59,336 synthetic rows generated (9/9 missing combos covered, 13k-17k instances each), combined with 37,938 real rows into 94,845 total at exactly 0.600 synthetic fraction. Verified: no missing images/masks, no filename collisions, spatial coverage identical to Dataset 8 (same underlying `touch_x`/`touch_y` positions, just denser), and a full visual + combo-label-annotated spot-check confirms correct shape/color/position rendering with zero overlap onto the ball, its shadow, or the ArUco fiducials.
- **Eval isolation**: `evaluate_shared_vision_backbone.py` needs zero code changes -- it stays pointed at the untouched, 100%-real Dataset 8 (`03_gold/shared_vision/`), physically disjoint from the new training mix (`03_gold/shared_vision_synthetic_mix/`). Documented limitation: this is same-sheet/different-frames evaluation against Datasets 5/6/7 (which also contribute to training), not a fully unseen sheet -- `aruco_markers_04.tex` (the sheet originally planned for that) has never been printed/collected. Training itself deferred to Colab, out of scope for this work.
- **Colab notebook updated**: `colab_train_shared_vision_backbone.ipynb` now uses two separate variables, `EVAL_DATASET_NAME` ('shared_vision', real-only) and `TRAIN_DATASET_NAME` ('shared_vision_synthetic_mix') -- a single shared `DATASET_NAME` would have pointed evaluation at synthetic data too the moment it was repointed at the new mix. `VERSION` stays `v2` (never actually trained/uploaded yet, so no need for `v3`).
- **Data leakage check (requested, verified empirically, not just reasoned about)**: confirmed zero overlap between `evaluate_shared_vision_backbone.py`'s held-out validation rows and what `train_cnn_2d_tracker_marker.py` actually trains its weights on. Stronger than "just disjoint": because `combine_shared_vision_training_mix.py` reuses `merge_shared_vision_sessions.py`'s exact `process_session()` for the real 40%, sessions 01/02/03 have byte-identical row counts and `frame_index` values in both the eval CSV and the training-mix CSV, so `temporal_split()`'s per-session 80/20 boundary lands on the exact same rows in both -- eval's held-out slice IS training's own internally-held-out slice (2198/2814/2577 rows per session, identical sets), not merely a different-but-overlapping-risk one. Zero synthetic/real filename collisions either.

### Marker Mask Undersizing, Circle-Fallback Shapes, and Heatmap Target Degeneracy
Three more bugs found via user-prompted critical review, all in the same real-data-affecting area (`auto_label_shared_vision.py` / `shared_vision_dataset.py`), fixed and visually verified on small samples before committing to another full-dataset re-run.

- **Marker mask undersized (~34% of true area)**: `render_marker_mask()`'s `radius_px = round(size_mm * 0.35)` was an arbitrary constant, not derived from the platform's real mm-to-px scale. Confirmed `size_mm` means *radius* (not diameter) by reading `aruco_markers_03.tex`'s TikZ source directly (`circle (8mm)` -- TikZ's `circle(r)` argument is a radius; the file's own comment says "8mm effective radius" for every feature on the sheet). Measured against a real photo (session_20260810_114330): mask radius 3.0px vs. actual visible marker radius 6.1px at one marker, 3.75px vs 4.78px at another -- the formula-predicted correct radius (8.0mm x 0.642px/mm = 5.13px) matches the real measurement far better than the old 3px. Fixed to use `((w/(W+2*margin)) + (h/(H+2*margin))) / 2` as the real px/mm scale (same exact-scale reasoning as the mm-based metrics added to `evaluate_shared_vision_backbone.py` earlier this session).
- **Square/hexagon rendered as circles**: pre-existing, unrelated to the size bug -- `render_marker_mask()` only ever gave `"triangle"` real polygon geometry; everything else (circle, square, hexagon, or any unrecognized shape) fell back to a filled circle. Fixed by adding real 4-point/6-point polygon geometry for square/hexagon (same vertex convention as `generate_synthetic_marker_composites.py`'s `polygon_vertices()`), matching each shape's true printed silhouette.
- **Heatmap target degeneracy (most significant of the three)**: `SharedVisionDataset._make_gaussian_heatmap`/`__getitem__` built the marker-heatmap training target from a single Gaussian centred on the mean position of *every* marker's pixels combined, not one peak per marker. Real sheets place markers in a symmetric quincunx (center + 4 cardinal points), so that combined centroid lands at essentially the same fixed point on nearly every frame regardless of which markers are visible -- verified empirically: centroid std across 8 sampled frames per session was 0.00/0.00, 0.00/0.13, 0.07/0.10 px (session_20260810_110239/112047/114330 respectively) -- i.e. *literally identical* for one session. Blank-platform frames hit the same fallback point too (`w/2, h/2`). A network can hit near-zero loss on a constant target without learning anything about the input, and this directly undermines `marker_classifier.py`'s planned per-blob soft-argmax refinement (Component 5 of `implementation_plan_shared_backbone_cnn.md`), which needs real local heatmap structure at each marker. Fixed via `cv2.connectedComponentsWithStats` on the combined mask -- one Gaussian per connected component, max-combined into the final target; frames with no markers now get an all-zero target (correctly representing "no marker anywhere") instead of a fake peak at centre.
- **Synthetic marker size consistency**: `generate_synthetic_marker_composites.py`'s marker size range (was 8-14px radius, arbitrary) is now 4-7px, matching the corrected real radius (~5.1px), so synthetic and real markers are drawn on the same physical scale.
- **Verification (small samples, before any full re-run)**: added `--limit` to `auto_label_shared_vision.py` for cheap dry-run testing (mirrors the pattern already used by the synthetic/combine scripts). Confirmed all four fixes visually:
  - `03_gold/shared_vision/mask_size_shape_fix_verification.png` -- real data (30 frames, session_20260810_114330): triangle/square/hexagon/circle masks now hug their true printed shape and size, not undersized circles.
  - `03_gold/shared_vision_synthetic/marker_size_fix_verification.png` -- synthetic data (200 frames): marker sizes now visually match real markers' scale.
  - `03_gold/shared_vision/heatmap_fix_check_real.png` and `03_gold/shared_vision_synthetic/heatmap_fix_check_synthetic.png` -- side-by-side old-vs-new heatmap target comparison on both real and synthetic data: OLD shows one degenerate peak (near-constant for real data); NEW shows a distinct, correctly-placed peak at every individual marker.
- **Follow-up fix**: the triangle mask was still visibly oversized after the initial radius-scale fix -- `render_marker_mask()`'s triangle used a symmetric apex/base offset (both `radius_px`), not the true equilateral-triangle 2:1 centroid split confirmed in `aruco_markers_03.tex` (apex offset 9.24mm, base offset 4.62mm, half-base-width 8mm for `size_mm=8.0`). Fixed to `apex_offset = radius_px * 2/sqrt(3)`, `base_offset = radius_px * 1/sqrt(3)` in both `render_marker_mask()` and `generate_synthetic_marker_composites.py`'s `polygon_vertices()`. Confirmed visually.
- **Status: full re-processing complete.** Re-ran `auto_label_shared_vision.py` on sessions 01/02/03 (corrected masks, identical row counts: 10988/14067/12883), re-merged Dataset 8 (52,772 rows, verified clean), regenerated the full synthetic set (59,336 rows, identical counts to the pre-fix run, all 9 missing combos still covered), and re-ran `combine_shared_vision_training_mix.py` (94,845 total, 0.600 synthetic fraction, identical to before -- confirms the fixes only changed mask pixel content/size/shape, not row counts or the sampling itself). Re-verified visually via `verify_shared_vision_labels.py --annotate-combo-labels` on the final combined mix: real markers (circle/triangle/square/hexagon across all 3 sheets) now show correctly-shaped, correctly-sized masks; synthetic markers now match real markers' scale. `03_gold/shared_vision`, `03_gold/shared_vision_synthetic`, and `03_gold/shared_vision_synthetic_mix` are all now current as of 2026-08-13.

## 11/08/2026
### Shared Vision Pipeline: ArUco Crop Fix, Dataset 8 Assembly, and Augmentation Strategy Trial
- **ArUco Marker Cropping Bug**: Diagnosed why `images_cropped/` output was clipping ArUco corner markers. `build_paper_corners_from_manifest()` used marker `center_mm` (inset ~12mm from the true paper edge) as the warp-destination corners instead of the platform's true physical boundary, deterministically cutting roughly half of every corner marker out of every warped frame. Fixed by replacing it with `build_paper_corners(platform_width_mm, platform_height_mm, margin_mm=6.0)`, matching the `PLATFORM_CORNERS_MM` convention already used by `generate_aruco_cropped_dataset.py` / `extract_cnn_sequential_features.py`, plus a 6mm outward margin for homography/detection jitter tolerance.
- **Dataset 8 Assembly**: Built `merge_shared_vision_sessions.py` to combine the 4 auto-labeled sessions (blank platform + 3 marker sheets) into a single unified training pool at `data/03_gold/shared_vision/` (52,772 rows). Handles two format mismatches: session-prefixes filenames to avoid cross-session collisions (raw frame numbering resets per session), and unions each frame's per-feature mask files into a single combined mask (matching what `SharedVisionDataset` expects — one mask file per image, not one per feature).
- **Coverage Diagnostics Overhaul**: Replaced `plot_coverage.py`'s fixed 10-samples/cell pass-fail metric with a full density readout (percentiles, mean, std) and dynamically-spaced thresholds spanning min→max, since the fixed floor had saturated to ~100% across every dataset and stopped being discriminating.
- **New `experiments/` Directory Convention**: Established `host_software/ml_vision/experiments/` (documented in `.agents/AGENTS.md`) for one-off comparative ML trials that produce a comparison report rather than a fixed benchmark or pass/fail — distinct from `tests/` and `evaluations/`.
- **Augmentation Strategy Trial**: Built `trial_augmentation_strategies.py` to compare 8 augmentation strategies (baseline, photometric, shadow, geometric_jitter, blur, occlusion, autoaugment_proxy, combined) on a stratified subset of Dataset 8. Built a local `TrialAugmentedDataset` that jointly transforms image+mask+ball-keypoint via albumentations, since production `SharedVisionDataset` only augments the image (would desync labels under geometric augmentation). Cross-referenced other training scripts (`train_cnn_2d_tracker.py`, `train_resnet_2d_tracker.py`, etc.) to add `blur` and `occlusion` variants matching their existing `GaussianBlur`/`RandomErasing` usage. Carried forward the permanent no-flip constraint from the 16/07/2026 entry below. Subset sampling is stratified across the same 10x10mm grid `plot_coverage.py` uses (round-robin per cell) rather than i.i.d. random, so small trial subsets don't just re-inherit Dataset 8's centre-heavy density skew. Ran a single-seed full-scale sweep, then a 5-seed averaged sweep at reduced scale to fit a 5-10 minute compute budget, then a full-scale re-run of `geometric_jitter` alone to resolve a scale-sensitivity discrepancy between the two — see `host_software/ml_vision/experiments/results/ANALYSIS_2026-08-11.md` for the numeric results.
- **Data Quality Finding**: Discovered 19/52,772 Dataset 8 rows have `ball_x_px`/`ball_y_px` outside the `[0,128]`px image frame (one extreme outlier at `y=284.9`px), likely a bad ArUco homography on a handful of source frames. Filtered in the trial script's subset loader; not yet addressed at the merge/auto-label stage.
- **Known Broken Tests (flagged, not fixed)**: `host_software/ml_vision/tests/test_shared_vision_training.py` unpacks a stale 3-value dataset signature and expects a removed `tracker_features` model output; `test_auto_label_shared_vision.py` calls a `load_manifest` function that no longer exists (now `load_manifest_full`) and uses a `"markers"` schema key instead of `"aruco_markers"`.

### Audio Model Evaluation: Training vs. Production Preprocessing Mismatch
- **Evaluation Extraction**: Built `evaluations/evaluate_audio_classifier.py` to evaluate the audio model and persist results, achieving 86.3% accuracy on clean clips (matching the original 87.0% baseline).
- **Production Preprocessing Bugs**: Discovered the live production receiver (`audio_receiver_pytorch.py`) severely deviates from how the model was trained. Specifically:
  - **Mismatched Label Order**: The live receiver hardcoded a non-alphabetical 12-class list, mapping predictions to the wrong words and crashing accuracy to ~7%.
  - **Aggressive Noise Reduction**: A spectral-subtraction filter applied to clean audio dropped accuracy by 30-40%.
  - **Unnecessary Cropping & Normalization**: Applying `align_speech_to_fixed_length` on already pre-cut dataset clips dropped accuracy by another ~10%.
- **Live Stream Underperformance**: Built `evaluate_live_receiver_stream.py` to test the receiver on a continuous noisy stream. It only detected 4/11 commands (36%), almost exclusively predicting `_background_` even when commands were spoken.
- **Root Cause Conclusion**: While fixing the preprocessing mismatch is required, it does not solve the core issue. The model's failure in noisy environments is caused by a lack of diverse background noise in the training data (background class was only ~9.5% of the data). The planned background-diversification retrain is confirmed to be the primary load-bearing fix.

## 31/07/2026
### YOLO-Pose vs Marker Tracking Analysis
- **Featureless Keypoint Instability**: Attempted to train a YOLOv8-Pose model to directly regress the 4 physical corners of the white paper platform to calculate homography (mimicking ArUco behavior). Observed heavy rotational and shear distortion during inference on novel camera angles (e.g., iPhone footage).
- **Rotational Symmetry Confusion**: Concluded that the physical corners of a blank white rectangle lack unique, localized semantic features. When the camera is rotated (e.g. 180 degrees), the model becomes confused and misidentifies keypoints (swapping Top-Left with Bottom-Right). This invalidates the strict point-ordering required by `cv2.findHomography`, forcing the resulting image to violently rotate or shear by 45-90 degrees to make the invalid geometry fit.
- **Superiority of Distinct Targets**: Confirmed that the `yolo_markers_tracker_v4` vastly outperforms the pose model because it is trained to detect the physical *colored targets*. These colored targets act as strong, unambiguous semantic anchors for a bounding-box object detector, proving that relying on distinct visual objects is fundamentally more stable than regressing abstract, featureless corners for perspective transformations.

## 29/07/2026
### ML Vision Pipeline: YOLO Jitter Hypothesis Validation
- **YOLO Bounding Box Jitter Hypothesis Proven**: Verified that the uncertainty in the size and scale of YOLO's bounding boxes was the root cause of downstream ML model failures. 
- **ResNet 2D Tracker Failure**: Trained the ResNet 2D tracker CNN on perfect, hand-labeled crops (`03_gold_cropped`). When deployed against noisy, jittery YOLO crops simulating inference (`02_silver/cropped_yolo`), the model failed catastrophically with a mean error of ~546mm. This confirmed that CNNs map raw pixels directly to intrinsic board coordinates (mm) and completely break down when crop variance shifts the board's apparent size and position.
- **MLP Corrector Success**: Trained the MLP Corrector on analytically derived ground-truth features (`yolo_features.csv` based on hand-labeled keypoints) instead of noisy YOLO coordinates. Because the MLP uses robust mathematical structures (four keypoints -> homography calculation) instead of raw pixels, it successfully generalized to noisy YOLO data during evaluation. Its mean Euclidean error plummeted from 61.42 mm (when trained on noisy YOLO data) to just 27.40 mm, demonstrating vastly superior robustness.
- **Strategic Decision**: Concluded that for CNNs to work, we must either eliminate crop variance (e.g., use fixed crop boxes) or artificially inject jitter during training. Conversely, the analytic homography + MLP corrector pipeline is proven to be robust against tracking jitter and remains the most viable architecture.

## 26/07/2026
### Codebase Consolidation & Documentation Overhaul
- **Primary Entry Point Unification**: Identified technical debt from multiple competing inference loops. Renamed the state-of-the-art PyTorch script (`main_yolo_marker_pytorch.py`) to `main.py` as the definitive, singular entry point for the robot. 
- **Legacy Code Archiving**: Relocated older milestones (ResNet trackers, broken OpenVINO loops, alternative mains) into a newly created `host_software/tools/` structure (`legacy_mains/` and `legacy_inference/`). Injected `sys.path` adjustments into archived scripts to prevent their internal module imports from breaking.
- **Repository Rule Adherence**: Cleaned up illegal directory structures (e.g., deleted `ml_vision/scripts/` and moved its contents to `tools/`) to comply with the established ML sub-directory rules.
- **Graceful Audio Teardown**: Fixed a crashing stack trace in `audio_receiver_pytorch.py` on `Ctrl+C` by wrapping the `sounddevice` stream shutdown sequence in robust `try/except` checks.
- **Architecture Documentation Synchronization**: Generated and updated 9 separate README files across the codebase to accurately reflect the current physical deployment. Clarified that the STM32 is the active edge controller running the `ml_control` policy and motor control loops over USB Serial, while the Zynq FPGA Gigabit UDP video pipeline is positioned as an experimental research track.
- **Working Data Collection Firmware**: Verified that the `BallBalancingBot` data collection firmware now runs correctly through the centering phase and transitions to random target generation, validating the firmware’s intended collection flow.
- **Rejected Ball-Position Filtering Change**: Evaluated adding local outlier filtering for resistive touchscreen ball positions in firmware. Found that this change destabilized the control loop and prevented proper target cycling, so it was deliberately left unimplemented.

## 23/07/2026
### Zynq Ethernet PHY and OV7670 Resolution Breakthroughs
- **OV7670 Resolution & VDMA Early Errors**: Diagnosed why the AXI VDMA engine was throwing `0x4000` (Error Interrupts) and hanging with `SOF Early` and `EOL Early` errors (Raw Status `0x00014191`). The original `amsacks-github` ROM configuration (`cam_rom.v`) had `SCALING_DCWCTR` (`0x72`) set to `0x11`, which intentionally downsamples the camera output by 2 on both axes. The camera was actually outputting 320x240 (QVGA) while the VDMA was expecting 640x480 (VGA), causing the VDMA to see the End-of-Line and Start-of-Frame signals far earlier than expected, forcing it into a HALT state.
- **Ethernet PHY Auto-negotiation Failure**: Root-caused why the UDP Python receiver was occasionally dropping packets and capping at ~16 FPS on the old code. The ZedBoard's Marvell PHY was failing auto-negotiation (`Phy setup error : link_speed invalid`), which caused lwIP to fall back to Fast Ethernet (100 Mbps) or fail entirely. A 640x480 RGB565 stream at 30 FPS requires ~147.4 Mbps, which physically choked the 100 Mbps link.
- **QVGA Fix**: We embraced the hardware's default 320x240 resolution. We updated the C VDMA configuration and the Python UDP receiver script to natively expect 320x240. This immediately fixed the VDMA early errors and simultaneously solved the network bandwidth limitation (320x240 @ 30FPS is only ~36.8 Mbps, fitting easily into a 100 Mbps link).

## 21/07/2026
### Hardware Migration: Opal Kelly XEM3010 to ZedBoard (Zynq-7000)
- **Fatal Clocking Limitation**: Discovered a critical limitation with the Opal Kelly XEM3010 expansion header breakout board. The external `PCLK` from the OV7670 camera must be routed to a dedicated Global Clock (GCLK) input on the FPGA to maintain setup/hold times and signal integrity. However, the XEM3010 routes all available GCLK pins to its on-board Cypress PLL outputs, leaving zero GCLK inputs accessible on the user breakout headers. This forced ISE to route the 24MHz pixel clock through standard logic fabric, causing catastrophic clock skew, unpredictable metastability, and preventing reliable image capture.
- **Hardware Pivot**: Due to this physical limitation, we are abandoning the Opal Kelly XEM3010 (Spartan-3) and migrating the entire FPGA vision pipeline to the **ZedBoard (Zynq-7000 EPP, XC7Z020-1CSG484CES)**.
- **Zynq Advantages**: Moving to the ZedBoard eliminates the need for the legacy Xilinx ISE 14.7 toolchain (modern Vivado 2025.2 supports Zynq natively). Additionally, the massive increase in DSP slices and the embedded dual-core ARM Cortex-A9 processing system will allow us to easily run C++ IK/PID loops via HLS without the severe spatial constraints of the Spartan-3.
### Zynq Architecture, Vitis Debugging, and Networking
- **PMOD Clock Routing Constraint Fix**: Resolved a Vivado placer failure for the OV7670 pixel clock (`PCLK`) on the ZedBoard PMOD (`AB7` / `JC1_P`). Vivado strictly enforces routing Global Clock inputs to dedicated buffers, but we forced the build using `CLOCK_DEDICATED_ROUTE FALSE` in the XDC. Since our 24MHz camera clock speed is slow, suboptimal routing delay is negligible.
- **Zynq Ethernet & Timer Configuration**: Diagnosed an issue where Vitis failed to compile the `lwip` bare-metal network stack (`liblwip220.a`). Enabled `ENET0` and `MDIO` in the Zynq Processing System block to route the gigabit Ethernet MAC to the physical PHY (MIO pins 16-27). Crucially, also enabled Triple Timer Counter 0 (`TTC0`), which is a mandatory hardware requirement for `lwip` to manage packet timeouts.
- **Vitis Path Length Limit Bug**: Discovered that Vitis Unified IDE 2025.2 on Windows silently fails to link static libraries when the nested project path exceeds the 250-character limit set by CMake/Windows `MAX_PATH`. Fixed by moving the Vitis workspace to a shallow root directory (`C:\vitis`) instead of editing the Windows Registry (which Xilinx's legacy ARM GCC toolchain ignores anyway).
- **Firmware Boilerplate Refactor**: Replaced the hidden Xilinx "Hello World" template boilerplate (`platform.h`, `init_platform()`) with direct hardware cache initializations (`Xil_ICacheEnable()`, `Xil_DCacheEnable()`) and explicit macro definitions (`PLATFORM_EMAC_BASEADDR`). This allows the C code to compile perfectly inside an "Empty Application" template without reliance on hidden helper files.
- **Vitis Driver Macro Shift**: Corrected the VDMA Device ID macro from `XPAR_AXIVDMA_0_DEVICE_ID` to `XPAR_AXI_VDMA_0_DEVICE_ID`. Newer versions of the Vitis driver generator now explicitly match the IP instance name defined in the block design instead of unconditionally dropping underscores.
## 20/07/2026
### ISim Simulator Freeze & Testbench Architecture
- **ISim Zero-Delay Loop Bug**: Diagnosed a total simulator lockup where Xilinx ISim (14.7) would freeze at exactly 1.28 us and report reaching the iteration limit (zero-delay loop). The cause was a continuous intra-assignment delay (`dq_drive <= #1 16'bz;`) inside a clocked `always` block that drove an `inout` net. Executing this delay on every single clock cycle caused ISim's event scheduler to get trapped in an infinite loop. 
- **Combinational BFM Data Driving**: Fixed the ISim lockup by rewriting the SDRAM Bus Functional Model (BFM) to drive data strictly via continuous combinational assignments (`assign sdram_dq = (read_pipe) ? mem : 16'bz;`), avoiding `#` delays inside clocked blocks entirely. 
- **CAS Latency Synchronization**: Discovered that the previous BFM was mistakenly driving data at CAS Latency 3. Corrected the read pipeline to exactly match CAS Latency 2, which eliminated the `Got zzzz` hold-time errors by perfectly aligning valid data with the SDRAM controller's sample edge.

## 17/07/2026
### FPGA Camera Breakthroughs (XCLK & SDRAM) — First Non-Black Frame Achieved
- **XCLK Architectural Routing Fix**: Discovered why the camera was receiving no stable clock regardless of PLL settings. The design used `assign xclk = clk2;` where `clk2` (pin P9) is a dedicated GCLK input routed through a BUFG by ISE. Xilinx Spartan-3 silicon rules forbid BUFG-driven nets from directly driving output pins — the router silently left pin K5 completely undriven (floating antenna, reading as 60–120mV noise on the DSO). The fix removes `clk2` from the design entirely.
- **Spartan-3 Primitive Limitation**: Initial fix attempted `DCM_SP` + `ODDR2` to generate 24MHz internally and forward it via a DDR output register. ISE reported `NGDBuild:604` — these primitives are Spartan-3E/3A only. The XC3S1000 (basic Spartan-3) does not support them.
- **Counter-Based XCLK (Final Solution)**: Replaced with a 2-bit counter driven by `clk1` (100MHz SDRAM clock). `assign xclk = xclk_cnt[1]` produces a 25MHz, 50% duty-cycle clock from a normal fabric flip-flop, which ISE legally routes to pin K5 without restriction. OV7670 XCLK spec is 10–48MHz; 25MHz is within range.
- **SDRAM Controller INIT/REFRESH Collision**: Identified the root cause of the persistent black frames. The `sdram_controller.v` `busy` signal was only asserted during `READ`/`WRITE` states — not during `INIT` or `REFRESH` cycles. The arbiter therefore issued write commands during these forbidden windows, which the controller silently dropped. Fixed by asserting `busy` on all non-IDLE states (`busy <= (next != IDLE)`).
- **First Non-Black Frame**: After a power cycle and flashing the new bitstream, `grab_frame.py` successfully captured 5 frames back-to-back. `check_status.py` confirmed all counters (`PCLK`, `HREF`, `VSYNC`) are alive. `test_frame.png` shows full-frame noisy/garbled content (magenta banding) — **not black** — confirming the camera is alive and producing real pixel data for the first time on the FPGA path.
- **Remaining XCLK Signal Integrity**: DSO on pin K5 (JP3-41) shows max 1.88V (expected 3.3V LVCMOS33) and ~120mV amplitude at variable frequency. This is consistent with weak I/O drive strength or capacitive loading on the wire. Subsequent runs without a power cycle show intermittent frame timeouts and frozen PCLK counters, directly correlated with the unstable XCLK. Image corruption (garbled pixels, horizontal banding) is also consistent with XCLK instability causing the OV7670 to lose pixel sync.

## 15/07/2026
### Opal Kelly OV7670 FPGA Camera Stabilization & Clocking
- **Camera Blackout & Clock Domain Synchronization**: Diagnosed an issue where `camera_top.v` would lock up completely after reading a single frame. Discovered that the asynchronous software `reset` trigger (from Python) was causing metastability in the 100MHz SDRAM arbiter state machine. Implemented dual-rank flip-flop synchronizers (CDC) on the SDRAM arbiter inputs, and added a safe 10-clock cycle synchronous reset recovery delay before allowing write-enables.
- **PLL Configuration Bug (CY22393)**: The camera crashed consistently after exactly ~1 millisecond (23,172 clocks). Mined the Opal Kelly XEM3010 User's Manual and discovered that the Python script was configuring the 24MHz camera clock on PLL **Output 0**, but the camera's `clk2` (P9) was physically hardwired to PLL **Output 2**. Because Output 2 was unconfigured, the CY22393 defaulted to bypassing the PLL, blasting the raw 48MHz reference crystal into the OV7670. The camera survived for 1ms on a 200% overclock before its internal silicon crashed. Fixed `grab_frame.py` to route the 24MHz clock to Output 2.
- **I2C SCCB Lockup & Hardware Reset Sequencing**: Even with a stable 24MHz clock, the camera failed to output frames (`VSYNC=0`). Realized that `v_sup` (mapped to the camera's physical PWDN pin) had been accidentally deleted from the UCF file during the PLL migration. A previous attempt claimed to fix this by mapping `v_sup = ~reset[0]` in Verilog, but this was logically backward (it would force the camera to sleep during normal operation). Fixed by explicitly restoring `v_sup` to the UCF and hardwiring `v_sup = 1'b0` in Verilog to keep the camera permanently awake. Updated `grab_frame.py` to send a clean 10ms hardware reset pulse (using the dedicated `WI_RESET`) *after* the PLL clock stabilizes, ensuring the SCCB interface cleanly accepts the I2C configuration.

## 15/07/2026
### FPGA Camera Diagnostics & Architecture
- **VirtualBox USB Grab Bug**: Diagnosed why the Opal Kelly XEM3010 device was failing to open on the Windows host. The VirtualBox USB Passthrough driver was actively grabbing the FPGA to forward it to the Linux VM, hiding the hardware serial number from the host OS.
- **I2C Configuration Endpoint Bug**: Discovered a major bug in `camera_top.v` where the Python script's configuration check (`WO_CONF = 0x22`) was mistakenly hardwired to the FIFO's `empty` flag instead of the actual `done` signal. This caused the script to skip camera I2C configuration entirely. Fixed by mapping `done` to `0x20`.
- **USB 2.0 PipeOut FIFO Overflow**: Found that streaming 640x480 RGB565 at 24MHz (30FPS) directly into a tiny 4KB Block RAM FIFO caused immediate overflows and dropped pixels, leading to severe image tearing and color corruption. The USB 2.0 host polling overhead could not drain the FIFO fast enough.
- **Clock Division vs SDRAM Controller**: Evaluated building a complex SDRAM controller to buffer the frame versus simply slowing the camera clock. Prevented the USB overflow by modifying the OV7670's `CLKRC` register to divide the internal pixel clock by 4 (`0x03`), dropping the framerate to ~7.5 FPS. This successfully stabilized the image stream over USB without requiring an SDRAM controller.
- **PLL Clock Physical Mapping Bug**: Diagnosed an issue where the camera produced no pixel clock (PCLK dead) despite successful I2C configuration. Discovered that the XEM3010 physically hardwires its onboard SDRAM clock exclusively to FPGA pin `N9` (driven by CY22393 PLL Output 1), while we had incorrectly assigned the 24MHz camera clock to that output. Swapped the Python PLL configuration so Output 1 (`N9`) outputs 100MHz for the SDRAM, and Output 0 (`P9`) outputs 24MHz for the camera `xclk`. Updated the UCF constraints to explicitly declare both clocks with their correct physical routing and timing specifications (`TS_clk1=100MHz`, `TS_clk2=24MHz`).
- **Clock Generator VCO Range Bug**: Discovered that the CY22393 PLL was completely failing to lock on the 24MHz `xclk` because the Python configuration requested a VCO frequency of 48MHz (which violates the strict 100-400MHz operational bounds of the chip). Recalculated the PLL multipliers in `grab_frame.py` to use a 240MHz VCO divided by 10, perfectly resolving the instability.
- **Asynchronous FIFO Reset CDC Bug**: Diagnosed a major cross-clock domain hazard where the host's asynchronous `reset` signal was driving the synchronous `rst_n` pin of the 100MHz SDRAM state machine. Implemented a dual-rank flip-flop CDC synchronizer in `sdram_arbiter.v` to safely buffer the reset signal into the 100MHz domain, eliminating metastability lockups.
- **OV7670 PWDN Shutdown Cascade**: Uncovered a massive, cascading pipeline failure that caused the Python `ReadFromBlockPipeOut` loop to hang forever. Discovered that the FPGA `v_sup` pin (mapped to the camera's active-high Power Down `PWDN` pin) was hardcoded to `1'b1`. This actively commanded the camera to enter deep sleep immediately upon startup. The camera would output exactly 23,172 clocks (~1 millisecond) before completely dying, meaning it never emitted a single `VSYNC` or `HREF`, which kept the SDRAM arbiter starved and locked up the USB FIFO pipeline. Fixed by setting `v_sup = 1'b0` to wake the camera.
## 13/07/2026
### ML Vision Inference & Architecture
- **Inference Pipeline Framework**: Developed the foundational scripts for real-time inference on the host PC (`host_inference_loop.py`). The pipeline ingests 30FPS compressed UDP frames from the iPhone, instantly decodes them, passes them through a PyTorch model for `(x, y)` inference, calculates positional error based on targets, and pushes packed 16-bit binary targets directly to the STM32 over serial.
- **Color Space Bug Fix**: Identified and resolved a critical bug where OpenCV's `BGR` default decoding would invert the red and blue color channels during real-time inference (since the PyTorch model was trained on `RGB` via PIL). Inserted an instantaneous `cv2.cvtColor` step into the pipeline.
- **Temporal Dataset Restrictions**: Refactored the ML training scripts (`train_expert_tracker.py` and `train_expert_tracker_subset.py`) to enforce strictly temporal train/test splits. Instead of randomized shuffling, the model trains exclusively on earlier chronological sequences (e.g., first 80%) and validates on completely unseen future contiguous sequences to prevent temporal data leakage.
- **Unsupervised Marker Identification Test**: Explored identifying physical control markers via pure Unsupervised Machine Learning (K-Means spatial-color clustering). Developed a multi-masking HSV strategy to isolate Red, Green, Grey, and Black markers. Discovered that preserving the low-saturation Grey/Black markers forced the mask to absorb over 92,000 background shadow pixels per frame, slowing K-Means to a crippling 5 seconds per frame (0.2 FPS). Concluded that purely unsupervised thresholding lacks the spatial context to reliably discard shadows in real-time. Documented this finding in `archived_ideas.md` and pivoted towards Transfer Learning.
- **FPGA Edge Inference Roadmap**: Logged a project goal in the Vision TODO to ultimately synthesize the final ML model weights into logic gates using Vitis HLS/hls4ml for native FPGA execution, eliminating host PC communication latency entirely.

## 10/07/2026 (Part 2)
### ML Vision Data Synchronization Pipeline
- **Phase Stability Gating**: Updated `DataCollectionStateMachine.cpp` to explicitly wait for the ball to become completely stationary (using the EWMA `< 3mm` filter) before transitioning out of the `START` target of each phase. This enforces a strict constraint that we do not change targets until we have stable control, improving the consistency of our dataset.
- **End-of-Run Sequence**: Added a finish sequence to `BallBalancingBot.ino`. When `is_done` triggers after all phases are complete, the controller overrides the setpoints to pitch the platform at a steep 12 degrees (dumping the ball off the table) and indefinitely locks the stepper motors.
- **Hardware-Level Optical Synchronization**: Built `sync_telemetry_video.py` to synchronize 30fps vertical iPhone video (1080x1920) with the 50Hz binary telemetry dataset. The script identifies the first bright 500ms white/gray flash emitted by the laptop screen to anchor the video's start time to `host_timestamp_ms`. It then aligns frames based on closest timestamps (under a 50ms drift limit).
- **Manual Crop Selector**: Developed `select_crop.py` as a manual ROI selection tool for the 1080p dataset. Because raw 1080p vertical video doesn't natively fit on standard laptop monitors during `cv2.selectROI`, the script intelligently downscales the display frame by 60% (scale=0.4) for easy user selection, then seamlessly multiplies the coordinates back up to return a perfect 1:1 original crop boundary.
- **Automated Pipeline Execution**: Processed over 30,000+ frames from `video1` and `video2`. The `sync_telemetry_video.py` script ingests the manual crop bounds, perfectly isolates the touch platform, downscales the ROI to `640x480` for ML training efficiency, and outputs the labeled dataset to `02_silver`.

#### Pipeline Usage Documentation
To synchronize a new raw video dataset:

1. **Find your Crop Box**: Run the helper script on the raw video. Drag a bounding box over the platform and press ENTER. It will print your crop coordinates.
   ```bash
   conda run -n ball_balance_env python host_software/ml_vision/scripts/select_crop.py --video host_software/ml_vision/data/01_bronze/video1/20260710_054604000_iOS.MOV
   ```
2. **Process and Sync Dataset**: Run the main sync script, feeding it the raw video, raw telemetry CSV, output directory, and the exact `--crop` string you received from step 1 (wrapped in quotes to avoid PowerShell parsing issues).
   ```bash
   conda run -n ball_balance_env python host_software/ml_vision/scripts/sync_telemetry_video.py --video host_software/ml_vision/data/01_bronze/video1/20260710_054604000_iOS.MOV --telemetry ml_vision/data/bronze/iphone_telemetry.csv --output host_software/ml_vision/data/02_silver --crop "82,435,915,762"
   ```## 10/07/2026
### Control Systems Overhaul & Data Collection Robustness
- **Virtual Wall Oscillation Fix**: Discovered that the emergency "Virtual Wall" was causing the ball to aggressively ping-pong off the edges. The wall was teleporting the setpoint to `(0,0)`, which created a massive 71mm error and catapulted the ball at the maximum 12.5-degree tilt. Softened the wall to only push the target 15mm inwards (`56mm`), providing a firm but controlled restorative tilt.
- **Slew Rate Limiter**: Implemented a Setpoint Slew Rate Limiter in `PIDControllers.cpp`. The state machine now instantly outputs discrete targets, but the PID controller internally ramps the setpoint at a maximum of `80mm/s`. This prevents sudden massive target jumps from generating violent error spikes.
- **Derivative Kick Elimination**: Diagnosed severe control loop fighting caused by the new Slew Rate Limiter. Because the target was actively moving, taking the derivative of the Error (`Target - Ball`) caused the D-term to think the ball was flying at 80mm/s. Rewrote the D-term to calculate Derivative on Measurement (raw ball velocity) instead of Error, perfectly smoothing the movement.
- **EWMA Settling Filter**: Removed the unreliable "3-second timer" for detecting when the ball reached a target. Replaced it with an Exponentially Weighted Moving Average (EWMA) filter on the X and Y errors. Adjusted the alpha weight to `0.015` (requiring ~8 seconds of continuous deadband stability) to mathematically guarantee the ball is at rest before generating the next target.
- **Phase Start Synchronization**: Discovered that Phase 2 (Patterns) and Phase 3 (Sweeps) were blindly tracing their trajectories without waiting for the ball to arrive at the starting points. Added a `waiting_at_start` boolean to force the state machine to wait for EWMA stability at the start of every pattern and sweep, drastically improving the cleanliness of the ML dataset.
- **Touchscreen ADC Debouncing**: Resistive touchscreens occasionally drop readings for 1-2 milliseconds due to ADC noise or the ball slightly bouncing. Added a `last_ball_detected_ms` tracker to gracefully debounce signal drops. The state machine now gives the ball a 1.5-second grace period before triggering an emergency Phase 0 recovery.
- **End-of-Run Finish Sequence**: Modified the main `BallBalancingBot.ino` loop to capture the `is_done` flag. When all data collection phases are complete, the robot now automatically tilts to a steep 12-degree pitch to roll the ball completely off the platform, and permanently locks the stepper motors.
- **Telemetry Upgrades**: Updated the Python `iphone_data_logger.py` and real-time `plot_log.py` scripts to dynamically parse an expanded binary struct. 
### Motor Calibration & Touchscreen Inverse Kinematics Fixes
- **Motor Initialization**: Updated `MotorControl.cpp` to use the correct user-calibrated raw steps (`STEPS_TO_ORIGIN` 475, 425, 505) instead of approximate angles to guarantee a perfectly flat horizontal plane upon startup. Fixed the `ENA` pin mapping on the STM32 to `PD0` to correctly power on the drivers.
- **Removed Blocking PID Delay**: Removed an erroneous `delay(10)` from the `pid_balance()` timeout condition. This delay was starving the non-blocking `AccelStepper` `run()` function of CPU cycles, forcing the motors to crawl back to horizontal at a sluggish 100 steps/sec (which appeared as "jittering/locking"). The motors now return to perfectly horizontal instantly.
- **PID Speed Limits & Jitter Fix**: Drastically increased `AccelStepper` limits (Max Speed 6000, Accel 25000) for instant, rapid flicking in response to PID outputs. Uncommented the `deriv[i]` constraint in `PIDControllers.cpp` to heavily filter out touchscreen ADC noise and eliminate derivative motor buzz when the ball is stationary.
- **Touchscreen 180-Degree Coordinate Alignment**: Diagnosed a severe Inverse Kinematics runaway positive feedback loop where pressing the Top Left corner of the screen caused the plate to tilt *towards* the stylus. Discovered the physical touchscreen is mounted 180 degrees rotated relative to the mathematical model (Motor C is physically Top Left, but mathematically Bottom Right). Fixed by digitally inverting the `x_mm` and `y_mm` mappings in `Screen.cpp` by `*-1`.
- **Motor Homing Directionality**: Discovered that physically flipping the A and B motor wires had inverted the mathematical definition of a "Positive" step direction to mean DOWN. Fixed the startup grinding issue by commanding the motors to move in the negative direction (`-STEPS_TO_ORIGIN`) during `home_motors()`, successfully driving them UP away from the physical hardstops.
- **PID Derivative Uncapping**: Identified a critical bug preventing the ball from stopping: the `deriv` term was hard-capped at `55`. This neutered the D-term's ability to brake fast-moving balls (since a typical roll speed is 150+ mm/s). Expanded the constraint to `[-800, 800]` to restore full shock-absorbing power.
- **Live Telemetry Visualisation**: Completely overhauled `plot_log.py` using `pyserial` threading and `matplotlib` `FuncAnimation` to stream and plot real-time PID errors directly from the COM port, greatly improving the tuning feedback loop.
- **Diagnosed Asymmetric Steady-State Error**: Utilized the new live plotter to definitively prove the ball was trapped exclusively in the `+X, +Y` quadrant, confirming a severe physical unlevel calibration. Concluded that an active Integral (`ki = 0.25`) term is absolutely mandatory to automatically wind up and overcome this gravity slope.
## 16/07/2026
### FPGA Camera Stability Verification
- **USB 2.0 `okBTPipeOut` Incompatibility**: Diagnosed that `ReadFromBlockPipeOut` is fundamentally incompatible with the Cypress FX2 hardware on the XEM3010 FPGA. Attempting to use a block-throttled pipe (`okBTPipeOut`) caused `grab_frame.py` to immediately return 614,400 bytes of empty zeros, resulting in a completely black image despite the camera successfully capturing and the FPGA counters (PCLK, HREF, VSYNC) continuously ticking. 
- **Unthrottled SDRAM Buffering**: Resolved the silent failure by switching back to the standard unthrottled `okPipeOut`. To handle potential USB underruns without throttling, the entire 640x480 frame is buffered in the 100MHz SDRAM arbiter. The Python host script now polls the FPGA state machine via `WO_FRAME` and only initiates the unthrottled USB pipe read once a full frame is guaranteed to be sitting in SDRAM. This successfully produced continuous, uncorrupted frame captures.
### YOLO-Pose Augmentation & Geometry Reconciliation
- **YOLO Flipping Bug**: Discovered a critical issue where default YOLOv8 augmentations (`fliplr=0.5`) were silently corrupting our dataset. Because our keypoints had strict spatial semantics (e.g., Keypoint 0 = Top-Left), horizontal flips essentially mirrored the image without mirroring the semantic labels, severely penalizing the model during training. Explicitly disabled `fliplr=0.0` and `flipud=0.0` in `train_yolo.py`.
- **CAD Plate vs. Resistive Touchpad Dimensions**: Solved an elusive homography projection bug that was "shrinking" our targets and ball mapping inward. Reconciled the fact that the 4 YOLO-Pose keypoints visually track the outer boundaries of the purple acrylic plate (`200.0 x 146.93 mm`), while the telemetry data (`touch_x`, `touch_y`) and target coordinates strictly exist within the inner resistive touchpad (`187.5 x 142.0 mm`).
- **Homography Coordinate Shifting**: Adjusted `generate_unified_pose_dataset.py` to use the true `200.0 x 146.93 mm` boundaries for the homography matrix calculation. Shifted the internal Target coordinates into this Plate Space by adding half the difference (`PAD_OFFSET_X`, `PAD_OFFSET_Y`) and properly mapping the ball by adding half the Plate dimensions. This flawlessly aligned the telemetry with the visual bounding box.
- **360-Degree Rotation Invariance**: Realized that restricting YOLO to a single viewing angle was limiting. Rewrote the dataset generation pipeline to apply random arbitrary rotations (0 to 360 degrees) to the raw 02_silver dataset images.
- **Physical Keypoint Anchoring**: To ensure the semantic meaning of the keypoints survived 360-degree rotations, we physically anchored Keypoint 0 to the corner anti-clockwise from the motor lip. By applying OpenCV's affine rotation matrix to both the image pixels and the 4 physical keypoint coordinates simultaneously, the model is trained to track the physical geometry of the board regardless of the camera's orientation.
- **Movable Target Detection (YOLO)**: Reconciled that the 4 colored control targets (Green, Red, Black, Grey) are not fixed corners, but rather physically movable markers placed anywhere on the board for the ball to balance towards. During synthetic dataset generation (`generate_unified_pose_dataset.py`), we use their *known* fixed locations from the `02_silver` data collection to automatically generate independent bounding boxes for them. Because they are trained as independent object classes (not rigid pose keypoints), the trained YOLO model will successfully track them even when they are moved to new locations in the real world.
- **Intrinsic Coordinate Invariance (ResNet)**: We originally thought applying PyTorch `RandomAffine` or `RandomPerspective` to the ResNet Expert Tracker without modifying the target labels was a bug. However, we realized that the labels (`touch_x`, `touch_y`) are *intrinsic* to the physical board! If the camera translates, zooms, or rotates (extrinsic changes), the physical position of the ball on the board NEVER changes. Therefore, applying these geometric augmentations *while keeping the labels identical* is mathematically perfect! It brilliantly forces the CNN to learn camera-invariance by locating the purple shape of the platform's outline to calculate relative position, rather than memorizing absolute pixel locations.
- **The Only Forbidden Augmentation**: `RandomHorizontalFlip` remains strictly forbidden for both models. Flipping the image mirrors the board (e.g. swapping the left/right targets), creating a physically impossible hardware layout that destroys the intrinsic coordinate system.
## 07/07/2026
### Architecture Refactor: Offloading Control to Teensy
- **Control Logic Migration**: Migrated the `DataCollectionStateMachine`, PID controller execution, and Inverse Kinematics entirely to the Teensy firmware, offloading the Python host script.
- **Fixed-Rate Control Loop**: Restructured `BallBalancingBot.ino` to run a strict 50Hz (20ms) control loop, guaranteeing stable PID `dt` timings and robust telemetry streaming.
- **Telemetry Enhancements**: Engineered a 68-byte packed binary struct for high-efficiency USB telemetry. Expanded the dataset to log 17 variables, including explicit motor targets (`theta_a`, `theta_b`, `theta_c`) and PID internal states (`integral`, `derivative`), to properly capture expert action-states for future ML Imitation Learning / Behavioral Cloning.
- **Timestamp Synchronization**: Rewrote `collect_training_data.py` to feature a daemon thread that captures the 50Hz Teensy telemetry while the main thread captures 30fps FPGA frames. Immediately timestamps incoming data on the host to create a reliable unified time-domain and perfectly sync ML labels with images.
- **Teensy Camera Removal**: Cleaned up the Teensy codebase by deleting the obsolete `CameraAcquisition` modules, as the Opal Kelly FPGA is now exclusively responsible for all video streaming.
- **Microcontroller Migration**: JMC broke the Teensy 3.6 by omitting a proper star ground on the power supply perf board, leading to a catastrophic ground loop/voltage spike. The architecture has now been migrated to an **STM32F407G-DISC1**. Firmware and hardware documentation updated to reflect STM32 compatibility (e.g., removing Teensy-specific `Serial.send_now()`).

## 03/07/2026
### FPGA Architecture & Motor Control Debugging (Opal Kelly XEM3010)

- **Single Motor Test Sequence**: Created `single_motor_test_top.v` and `single_motor_sequence.py` to isolate motor testing. This test perfectly replicates the legacy Arduino diagnostic sequence (commanding +90, +180, +270, +360, and 0 degree rotations) using the new hardware P-controller.
- **Solved "10-20 Degree" Stalling Bug**: Diagnosed a critical physical bug where commanded 90-degree rotations were only resulting in 10-20 degree physical movements. Discovered that the P-controller was instantly accelerating the TMC2208 to a 93kHz step rate (1750 RPM), causing the physical rotor to stall due to inertia. The motor was only catching grip during the final deceleration phase.
- **Motor Speed Clamping**: Patched `stepper_motor_controller.v` by firmly clamping the maximum P-controller speed to `700`, which strictly limits the step rate to a perfectly safe `~2 kHz`. This guarantees the physical motors never stall and successfully track all generated steps.

## 01/07/2026
### Camera Synchronization & Data Collection (OV7670 & Teensy)
- **Data Collection Robustness**: Updated `ml_vision/scripts/collect_training_data.py` to use random uniform target generation (exploring the full `-70 to 70` X and `-55 to 55` Y safe bounds) to maximize the state-space exploration for the vision model. Added serial exception handling to gracefully recover from Teensy disconnects.
- **XCLK Stabilization**: Fixed a critical clock issue in `test_ov7670.ino`. Generating a 12MHz PWM clock on the 60MHz Teensy bus created an asymmetrical 40% duty cycle, causing camera logic lockups. Changed the XCLK frequency to a perfectly symmetrical 10MHz (50% duty cycle).
- **VSYNC Pin Flexibility**: Refactored the VSYNC polling mechanism from reading hardcoded `GPIOA_PDIR` registers to using `digitalReadFast(VSYNC_PIN)`. This allows immediate software remapping of the VSYNC pin if the physical hardware pin is bent or damaged, without losing read speed.
- **Image Decoding Fix**: Discovered and patched a `uint8` integer overflow bug in `stream_viewer.py` where the numpy multiplication operations wrapped around, rendering the RGB565 images as pitch black. Switched to fast bitwise shifting `(r << 3) | (r >> 2)` which avoids overflow entirely.
- **Sync Header Desync ("Rolling Film")**: Resolved a mathematical edge-case where the camera occasionally captured a physical color that exactly matched the 4-byte serial sync header (`\xAA\xBB\xCC\xDD`), causing the Python script to prematurely slice the frame in half. Expanded the header to 8 bytes (`\xAA\xBB\xCC\xDD\xEE\xFF\x99\x88`) to mathematically eliminate false positives.
- **Framerate & Quality Enhancements**: Doubled the OV7670 internal frame rate by changing the `CLKRC` prescaler to `/1` (`0x00`). Improved raw visual clarity by activating the internal Edge Enhancement and De-noise DSP filters via the `COM16` register (`0x38`).

## Spatial Softmax Geometric Scaling Bug (July 30, 2026)
- **Issue:** The arbitrary MAX_BOUND = 200.0 constant used across all datasets and evaluation scripts correctly functioned as a symmetric scaler for the old Dense-layer models, but catastrophically broke the new Spatial Softmax models.
- **Root Cause:** Dense layers are mathematically agnostic to geometric constraints and simply memorized the scaled value (e.g. 0.468). However, Spatial Softmax maps the absolute edge of the warped camera image to precisely 1.0. By dividing the 93.75mm physical plate edge by 200.0, the target label was artificially compressed to 0.468. This forced the Softmax to predict the ball was near the center of the image when it was physically at the extreme edge, resulting in a training paradox.
- **Resolution:** Replaced the arbitrary 200.0 constant system-wide with decoupled, physically accurate bounds corresponding to the Homography-warped plate edges (MAX_X_BOUND = 93.75, MAX_Y_BOUND = 71.0). Note that this obsoletes all previous Dense-layer model checkpoints.

## (Archived from ml_vision/docs/logbook.md)

# Implementation Logbook

## 2026-06-24
- **12:50** - Initiated execution phase for the ball position vision model.
- **12:51** - Created task list and this logbook document.
- **12:51** - Started implementing Data Processing Pipeline (`video_sync.py`, `camera_calibration.py`).
- **12:52** - Implemented `preprocessor.py` for ArUco and perspective transforms.
- **12:53** - Implemented Models Benchmarking suite (`classical_cv_model.py`, `ml_model_benchmarks.py`).
- **12:53** - Implemented Evaluation & Output (`evaluator.py`, `output_formatter.py`).
- **12:54** - Running syntax verification on all implemented python scripts.
- **12:54** - Syntax verification passed successfully.
- **12:55** - Completed execution of all tasks. Walkthrough generated.

## 2026-06-25
- **10:50** - Approved implementation plan for real-time webcam testing of the vision pipeline.
- **10:50** - Decision: We will support both GUI rendering and headless execution in the test scripts so we can prioritize testing model accuracy/reliability first, and then measure raw latency.
- **10:50** - Decision: For the Edge Detection fallback (if Canny fails to find the platform), we will implement both options (Skip Inference entirely vs. Run YOLO on unwarped raw frame) so we can back-test which option yields better results when we collect more data.

## 2026-06-26 - 2026-06-28
- **13:30 (Jun 26)** - Implemented first pass of `marker_tracker.py` to identify dynamic target destinations via HSV color filtering.
- **13:50 (Jun 26)** - **Algorithm Pivot**: Rewrote marker tracking to a "Shape-First, Color-Second" methodology (`cv2.adaptiveThreshold` + `cv2.findContours` Circularity filter) to fix critical tracking failures on low-brightness (Black/Grey) physical targets.
- **14:50 (Jun 26)** - Commenced major Medallion Architecture dataset overhaul.
- **22:50 (Jun 27)** - Concluded data module refactor. Created `01_bronze`, `02_silver`, and `03_gold` lakes. Migrated all HEIC, MP4, and synthetic dataset files.
- **22:52 (Jun 27)** - Updated `augment_dataset.py`, `convert_heic.py`, and all YOLO config YAML files to route properly through the new Medallion pipeline.
- **23:59 (Jun 27)** - Updated the root `.gitignore` to mask the new massive dataset directories from version control, saving the git repository from bloating.
