Jack0468/ball_balance_video_controlled/fpga/hls_hardware/TODO.md

# FPGA Hardware TODOs

- [ ] Write an encoding platform/module for the output bins of `ml_audio` to integrate with the FPGA architecture via the ZedBoard/Zynq interface. (Corrected 2026-08-13 — previously said "Opal Kelly," which was superseded 21/07/2026; see `docs/PROJECT_LOGBOOK.md`.)
