Jack0468/ball_balance_video_controlled/host_software/ml_multimodal/evaluations/run_eval_expert.py

import cv2
import time
import struct
import numpy as np
import os
import torch
import serial
import argparse
import csv

from ml_vision.core.coordinate_math import HomographyProjector
from ml_audio.audio_receiver_pytorch import AudioCommandReceiver

from src.receivers import USBReceiver
from src.utils import find_stm32_port
from src.models import (
    load_yolo_model,
    load_mlp_corrector_iphone_v1_model,
    process_vision_frame,
)
from src.state_machine import TargetStateMachine

# --- Configuration ---
SERIAL_PORT = "COM3"
SERIAL_BAUD = 2000000
EVAL_DURATION = 120  # Total seconds
# ---------------------

COLOR_CANONICAL_MAP = {
    "pink": "red",
    "red": "red",
    "cyan": "blue",
    "blue": "blue",
}


def canonicalize_color(name):
    return COLOR_CANONICAL_MAP.get(name, name)


def canonicalize_command(command):
    if command is None or not command.startswith("go_"):
        return command
    color = command.split("_", 1)[1]
    color = canonicalize_color(color)
    return f"go_{color}"


def canonicalize_marker_coords(marker_coords):
    if not marker_coords:
        return marker_coords

    grouped = {}
    counts = {}

    for name, coords in marker_coords.items():
        canonical_name = canonicalize_color(name)
        if canonical_name not in grouped:
            grouped[canonical_name] = [0.0, 0.0]
            counts[canonical_name] = 0

        grouped[canonical_name][0] += float(coords[0])
        grouped[canonical_name][1] += float(coords[1])
        counts[canonical_name] += 1

    averaged = {}
    for name, total in grouped.items():
        count = counts[name]
        averaged[name] = (total[0] / count, total[1] / count)

    return averaged


def main():
    parser = argparse.ArgumentParser()
    parser.add_argument("--cam_id", type=int, default=0, help="Camera ID")
    parser.add_argument("--port", type=str, default="auto", help="STM32 serial port")
    args = parser.parse_args()

    if args.port == "auto":
        detected_port = find_stm32_port()
        args.port = detected_port if detected_port else SERIAL_PORT

    device = torch.device("cuda:0" if torch.cuda.is_available() else "cpu")
    script_dir = os.path.dirname(os.path.abspath(__file__))

    # Paths
    yolo_path = os.path.abspath(
        os.path.join(
            script_dir,
            "ml_vision/models/yolov8_platform_pose_markers_iphone_v1/weights/best.pt",
        )
    )
    mlp_corrector_iphone_v1_path = os.path.abspath(
        os.path.join(script_dir, "ml_vision/models/mlp_corrector_iphone_v1/best_corrector.pth")
    )
    audio_model_path = os.path.abspath(
        os.path.join(
            script_dir,
            "ml_audio/synthetic/models/pytorch/audio_weights_with_synthetic.pth",
        )
    )
    master_audio_path = os.path.abspath(
        os.path.join(
            script_dir, "ml_audio", "data", "02_silver", "master_evaluation_audio.wav"
        )
    )

    if not os.path.exists(master_audio_path):
        print(f"ERROR: {master_audio_path} not found!")
        print(
            "Please run `python ml_audio/create_master_audio.py` first to generate the streaming sequence."
        )
        return

    # Output CSV
    out_dir = os.path.join(
        os.path.dirname(os.path.dirname(os.path.dirname(os.path.abspath(__file__)))),
        "data",
        "04_evaluation",
    )
    os.makedirs(out_dir, exist_ok=True)
    timestamp = time.strftime("%Y%m%d_%H%M%S")
    csv_path = os.path.join(out_dir, f"expert_evaluation_run_{timestamp}.csv")
    csv_file = open(csv_path, "w", newline="")
    csv_writer = csv.writer(csv_file)
    csv_writer.writerow(
        [
            "host_command_sent_ms",
            "host_packet_received_ms",
            "packet_seq",
            "mcu_micros_sample",
            "mcu_micros_send",
            "target_x",
            "target_y",
            "touch_x",
            "touch_y",
            "error_x",
            "error_y",
            "pitch",
            "roll",
            "theta_a",
            "theta_b",
            "theta_c",
            "integral_x",
            "integral_y",
            "deriv_x",
            "deriv_y",
        ]
    )
    host_command_sent_ms = int(time.time() * 1000)

    # Load Models
    yolo_model = load_yolo_model(yolo_path, device)
    mlp_corrector_iphone_v1_model = load_mlp_corrector_iphone_v1_model(mlp_corrector_iphone_v1_path, device)

    dst_pts = np.array([[-70, 55], [70, 55], [70, -55], [-70, -55]], dtype=np.float32)
    projector = HomographyProjector(dst_pts)
    state_machine = TargetStateMachine()

    try:
        ser = serial.Serial(args.port, SERIAL_BAUD, timeout=0.01)
        print(f"Connected to STM32 on {args.port} at {SERIAL_BAUD} baud.")
    except Exception as e:
        print(
            f"Serial port {args.port} unavailable. Evaluation requires physical hardware!"
        )
        return

    receiver = USBReceiver(camera_id=args.cam_id)
    audio_receiver = None

    try:
        print("\nWaiting for camera feed...")
        while receiver.get_latest_frame() is None:
            time.sleep(0.1)

        print("\nWaiting for ball to be placed and balanced in the center...")
        balanced_start_time = None

        while True:
            frame = receiver.get_latest_frame()
            if frame is None:
                continue

            cam_x, cam_y, marker_coords = process_vision_frame(
                frame, yolo_model, mlp_corrector_iphone_v1_model, projector, device
            )
            if cam_x is None:
                balanced_start_time = None
                continue

            # Send center target to STM32 (ASCII)
            payload = f"{cam_x:.2f},{cam_y:.2f},0.0,0.0\n".encode("ascii")
            host_command_sent_ms = int(time.time() * 1000)
            ser.write(payload)

            # Check if balanced (within 20mm radius)
            dist = np.sqrt(cam_x**2 + cam_y**2)
            if dist < 20.0:
                if balanced_start_time is None:
                    balanced_start_time = time.time()
                elif time.time() - balanced_start_time > 2.0:
                    print("\nBall successfully balanced in the center!")
                    break
            else:
                balanced_start_time = None

            # Drain serial buffer so we don't back up while waiting
            while ser.in_waiting > 0:
                ser.read(ser.in_waiting)

        # Initialize the audio receiver in FILE STREAMING mode ONLY AFTER ball is placed!
        audio_receiver = AudioCommandReceiver(
            audio_model_path, source_file=master_audio_path
        )

        print("\n===========================================")
        print("STARTING TRUE STREAMING EXPERT EVALUATION!")
        print("===========================================\n")

        start_time = time.time()

        # Binary struct format from ExpertEvaluationFirmware
        struct_format = "<IIIfffffffffffffff"
        expected_size = struct.calcsize(struct_format) + 4  # +4 for sync header
        sync_buf = bytearray()

        while True:
            elapsed = time.time() - start_time
            if elapsed > EVAL_DURATION:
                print("Evaluation sequence complete! Stream finished.")
                break

            # Pop commands from the streaming audio model exactly like live mode
            command = audio_receiver.get_latest_command()
            if command:
                command = canonicalize_command(command)
                print(f"[{elapsed:.1f}s] STREAM DETECTED COMMAND: {command}")
                state_machine.process_command(command)

            frame = receiver.get_latest_frame()
            if frame is None:
                continue

            # 1. Vision Inference
            cam_x, cam_y, marker_coords = process_vision_frame(
                frame, yolo_model, mlp_corrector_iphone_v1_model, projector, device
            )
            if cam_x is None:
                continue

            marker_coords = canonicalize_marker_coords(marker_coords)

            # Target Calculation
            state_machine.update_markers(marker_coords)
            target_x, target_y = state_machine.get_target_coords(marker_coords)

            # Send Target to STM32 (ASCII)
            payload = f"{cam_x:.2f},{cam_y:.2f},{target_x:.2f},{target_y:.2f}\n".encode(
                "ascii"
            )
            host_command_sent_ms = int(time.time() * 1000)
            ser.write(payload)

            # 2. Read Binary Telemetry from STM32
            while ser.in_waiting > 0:
                b = ser.read(1)
                sync_buf.append(b[0])
                if len(sync_buf) > 4:
                    sync_buf.pop(0)

                if bytes(sync_buf) == b"\xaa\xbb\xcc\xdd":
                    data = ser.read(expected_size - 4)
                    if len(data) == expected_size - 4:
                        host_packet_received_ms = int(time.time() * 1000)
                        unpacked = struct.unpack(struct_format, data)
                        csv_writer.writerow(
                            [host_command_sent_ms, host_packet_received_ms]
                            + list(unpacked)
                        )
                    sync_buf.clear()

    except KeyboardInterrupt:
        print("\nEvaluation aborted by user.")
    finally:
        if audio_receiver:
            audio_receiver.stop()
        if receiver:
            receiver.stop()
        if ser:
            ser.close()
        csv_file.close()
        cv2.destroyAllWindows()
        print(f"Data saved to {csv_path}")


if __name__ == "__main__":
    main()
