Jack0468/ball_balance_video_controlled/firmware/BallBalancingBot/DataCollectionStateMachine.h

#ifndef DATA_COLLECTION_STATE_MACHINE_H
#define DATA_COLLECTION_STATE_MACHINE_H

#include <Arduino.h>

enum DataCollectionState {
    PHASE_0_CENTERING,
    PHASE_1_RANDOM,
    PHASE_2_PATTERNS,
    PHASE_3_SWEEPS,
    PHASE_4_EDGES,
    PHASE_5_BROWNIAN,
    PHASE_DONE
};

struct Point2D {
    double x;
    double y;
};

class DataCollectionStateMachine {
public:
    DataCollectionStateMachine();
    void getNextTarget(double &out_x, double &out_y, bool &is_done);

private:
    DataCollectionState state;
    unsigned long state_start_time_ms;
    unsigned long phase0_duration_ms;
    unsigned long phase1_duration_ms;
    unsigned long phase2_duration_per_pattern_ms;
    unsigned long phase5_duration_ms;
    
    double ewma_err_x;
    double ewma_err_y;
    
    bool in_recovery;
    DataCollectionState state_before_recovery;
    
    int current_pattern_idx;
    
    Point2D start_points[9];
    int current_start_idx;
    
    Point2D directions[8];
    int current_dir_idx;
    double sweep_distance;
    int current_edge_idx;
    
    double target_x;
    double target_y;
    
    unsigned long last_random_update_ms;
    unsigned long last_sweep_update_ms;
    unsigned long last_brownian_update_ms;
    unsigned long last_ball_detected_ms;
    
    bool waiting_at_start;
};

#endif
