Jack0468/ball_balance_video_controlled/fpga/vitis/src/platform.c

/*
 * Copyright (C) 2009 - 2022 Xilinx, Inc.
 * Copyright (C) 2022 - 2025 Advanced Micro Devices, Inc.
 * All rights reserved.
 *
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
 */
#if defined(SDT) || __MICROBLAZE__ || __PPC__
#include "arch/cc.h"
#include "platform.h"
#include "platform_config.h"
#include "xil_cache.h"
#include "xparameters.h"
#include "xil_exception.h"
#include "lwip/tcp.h"
#include "netif/xadapter.h"

#ifdef STDOUT_IS_16550
#include "xuartns550_l.h"
#endif

#include "lwip/tcp.h"

#ifdef SDT
#include "xiltimer.h"
#include "xinterrupt_wrap.h"
#else
#include "xintc.h"
#endif

#if LWIP_DHCP_DOES_ACD_CHECK
#include "lwip/acd.h"
#endif

#if LWIP_DHCP==1
volatile int dhcp_timoutcntr = 240;
void dhcp_fine_tmr();
void dhcp_coarse_tmr();
#endif

volatile int TcpFastTmrFlag = 0;
volatile int TcpSlowTmrFlag = 0;


/*
Recommended Intervals by lwip stack:
tcp_fasttmr()     - 250ms
tcp_slowtmr()     - 500ms

dhcp_fine_tmr()   - 500ms
dhcp_coarse_tmr() - 60sec
acd_tmr()         - 100ms

eth_link_detect() - 1 second
dhcp timeout()    - 12 secs
*/

void
timer_callback()
{
	static int DetectEthLinkStatus = 0;
	/* we need to call tcp_fasttmr & tcp_slowtmr at intervals specified by lwIP.
	 * It is not important that the timing is absoluetly accurate.
	 */

	static int Tcp_Fasttimer = 0;
	static int Tcp_Slowtimer = 0;

#if LWIP_DHCP==1
        static int dhcp_timer = 0;
        static int dhcp_finetimer = 0;
#if LWIP_DHCP_DOES_ACD_CHECK == 1
        static int acd_timer = 0;
#endif
#endif

	DetectEthLinkStatus++;
	Tcp_Fasttimer++;
	Tcp_Slowtimer++;

#if LWIP_DHCP==1
        dhcp_timer++;
        dhcp_finetimer++;
        dhcp_timoutcntr--;
#if LWIP_DHCP_DOES_ACD_CHECK == 1
        acd_timer++;
#endif
#endif

	if(Tcp_Fasttimer % 5 == 0)
	{
		TcpFastTmrFlag = 1;
	}

	if(Tcp_Slowtimer % 10 == 0)
	{
		TcpSlowTmrFlag = 1;
	}

#if LWIP_DHCP==1
	if(dhcp_finetimer % 10 == 0)
	{
		dhcp_fine_tmr();
	}
	if (dhcp_timer >= 1200)
	{
		dhcp_coarse_tmr();
		dhcp_timer = 0;
	}

#if LWIP_DHCP_DOES_ACD_CHECK == 1
        if(acd_timer % 2 == 0)
        {
                acd_tmr();
        }
#endif /* LWIP_DHCP_DOES_ACD_CHECK */

#endif /*LWIP_DHCP */

    // Removed eth_link_detect to fix link error
}

#ifndef SDT
static XIntc intc;

void platform_setup_interrupts()
{
	XIntc *intcp;
	intcp = &intc;

	XIntc_Initialize(intcp, XPAR_INTC_0_DEVICE_ID);
	XIntc_Start(intcp, XIN_REAL_MODE);

	/* Start the interrupt controller */
	XIntc_MasterEnable(XPAR_INTC_0_BASEADDR);

#ifdef __PPC__
	Xil_ExceptionInit();
	Xil_ExceptionRegisterHandler(XIL_EXCEPTION_ID_INT,
			(XExceptionHandler)XIntc_DeviceInterruptHandler,
			(void*) XPAR_INTC_0_DEVICE_ID);
#elif __MICROBLAZE__
	microblaze_register_handler((XInterruptHandler)XIntc_InterruptHandler, intcp);
#endif

	platform_setup_timer();

#ifdef XPAR_ETHERNET_MAC_IP2INTC_IRPT_MASK
	/* Enable timer and EMAC interrupts in the interrupt controller */
	XIntc_EnableIntr(XPAR_INTC_0_BASEADDR,
#ifdef __MICROBLAZE__
			PLATFORM_TIMER_INTERRUPT_MASK |
#endif
			XPAR_ETHERNET_MAC_IP2INTC_IRPT_MASK);
#endif


#ifdef XPAR_INTC_0_LLTEMAC_0_VEC_ID
#ifdef __MICROBLAZE__
	XIntc_Enable(intcp, PLATFORM_TIMER_INTERRUPT_INTR);
#endif
	XIntc_Enable(intcp, XPAR_INTC_0_LLTEMAC_0_VEC_ID);
#endif


#ifdef XPAR_INTC_0_AXIETHERNET_0_VEC_ID
	XIntc_Enable(intcp, PLATFORM_TIMER_INTERRUPT_INTR);
	XIntc_Enable(intcp, XPAR_INTC_0_AXIETHERNET_0_VEC_ID);
#endif


#ifdef XPAR_INTC_0_EMACLITE_0_VEC_ID
#ifdef __MICROBLAZE__
	XIntc_Enable(intcp, PLATFORM_TIMER_INTERRUPT_INTR);
#endif
	XIntc_Enable(intcp, XPAR_INTC_0_EMACLITE_0_VEC_ID);
#endif


}
#endif

void
enable_caches()
{
#ifdef __PPC__
	Xil_ICacheEnableRegion(CACHEABLE_REGION_MASK);
	Xil_DCacheEnableRegion(CACHEABLE_REGION_MASK);
#elif __MICROBLAZE__
#ifdef XPAR_MICROBLAZE_USE_ICACHE
	Xil_ICacheEnable();
#endif
#ifdef XPAR_MICROBLAZE_USE_DCACHE
	Xil_DCacheEnable();
#endif
#endif
}

void
disable_caches()
{
	Xil_DCacheDisable();
	Xil_ICacheDisable();
}

void init_platform()
{
	enable_caches();

#ifdef STDOUT_IS_16550
	XUartNs550_SetBaud(STDOUT_BASEADDR, XPAR_XUARTNS550_CLOCK_HZ, 9600);
	XUartNs550_SetLineControlReg(STDOUT_BASEADDR, XUN_LCR_8_DATA_BITS);
#endif

#ifndef SDT
	platform_setup_interrupts();
#else
	init_timer();
#endif

}

#ifdef SDT
void TimerCounterHandler(void *CallBackRef __attribute__((unused)), u32 TmrCtrNumber __attribute__((unused)))
{
	timer_callback();
}

void init_timer()
{
	/* Calibrate the platform timer for 50 ms */
	XTimer_SetInterval(50);
	XTimer_SetHandler(TimerCounterHandler, 0, XINTERRUPT_DEFAULT_PRIORITY);
}
#endif

void cleanup_platform()
{
	disable_caches();
}
#endif
