Jack0468/ball_balance_video_controlled/(commit log)

2026-06-24 feat: implement ML vision pipeline, FPGA bridge, and HLS inverse kinematics hardware modules
2026-06-25 feat: add augmented dataset samples, video frames, and realtime pipeline script
2026-06-26 Update ball-balancing-bot submodule with new CAD files
2026-07-01 feat: implement inverse kinematics solver and OV7670 camera acquisition drivers for data collection bot
2026-07-01 feat: optimize OV7670 camera pipeline with 10MHz XCLK, flexible VSYNC polling, 8-byte sync headers, and overflow-safe image decoding
2026-07-02 feat: import training dataset, model weights, and hardware documentation assets
    [LowerLimb.STL, MotorPlate.STL, Robot Full Assem.SLDASM, RobotBase.STL, RobotBaseNew.stl, ScreenPlate.STL, ShaftSpacer.STL, UpperLimb.STL]
2026-07-02 feat: integrate AccelStepper library and implement motor control modules with FPGA testing support
2026-07-02 feat: implement core FPGA controller modules for camera interface, stepper motor control, and data streaming.
2026-07-03 feat: add FPGA motor controller implementation and host-side testing sequence
2026-07-03 refactor: migrate FPGA architecture to robust PLL clocking and implement speed-clamped PID motor control
2026-07-07 feat: initialize Xilinx ISE motor test project and add environment configuration documentation
2026-07-07 feat: implement core motor control logic, PID balancing firmware, and high-frequency binary telemetry streaming
2026-07-09 feat: implement motor calibration utility and foundational robot control firmware for the ball balancing bot
2026-07-09 feat: implement ball balancing motor control, PID logic, and log analysis utilities
2026-07-10 feat: add live serial PID plotting, implement core motor and PID control classes, and document tuning procedures. BEST PARAMS SO FAR
2026-07-13 feat: add CAD assembly parts, update TODO with vision pipeline plan, and implement data synchronization scripts for ML vision processing.
    [6627T91_Stepper Motor.SLDPRT, BreadboardPlaceholder.SLDPRT, LCD Screen.SLDPRT, LowerLimb.SLDPRT, LowerLimbNew.SLDPRT, M3 Spacer.SLDPRT, MotorPlate.SLDPRT, NormalVector.SLDPRT]
2026-07-13 feat: initialize ml_vision project with core vision pipelines, data processing tools, and comprehensive testing framework
2026-07-13 feat: implement vision-based serial control for ball balancing bot using YOLO inference and PID telemetry
2026-07-14 ml control via stm32
2026-07-14 feat: add UDP-based iPhone camera streaming support for remote ML inference
2026-07-14 feat: implement motor control logic and motion functions for BallBalancingBot
2026-07-14 camera i2c fpga, files
2026-07-14 feat: implement MotorControl logic and add YOLOv8 model training artifacts
2026-07-15 feat: implement camera I2C control and modular SDRAM controller architecture
2026-07-15 feat: implement PID balance logic and host-side audio/vision inference scripts
2026-07-15 feat: implement data collection state machine and serial command handling for motor control firmware
2026-07-16 feat: implement OV7670 camera initialization and SDRAM-buffered image acquisition pipeline with USB pipe migration and supporting ML evaluation tools.
2026-07-16 feat: implement automated data collection state machine and PID control logic for the ball balancing bot, alongside initial FPGA camera integration and vision processing utilities.
2026-07-17 feat: implement SDRAM arbiter, camera configuration, and spatial data normalization pipeline for ML vision training
2026-07-17 feat: add FPGA camera interface, SDRAM arbitration, MCP agent tools, and machine learning training pipelines
2026-07-17 feat: implement FPGA camera clock stabilization and add ML training pipelines for YOLO and temporal tracking.
2026-07-20 Update FPGA camera, ML vision integration, and ResNet optimizations
2026-07-21 feat: implement OV7670 SCCB master controller and establish machine learning vision evaluation framework
2026-07-22 feat: implement ML vision pipeline, expert tracker evaluation, corrector training, and FPGA UDP streaming support
    [coordinate_math.py, host_inference_cascade.py, main.c, receive_udp_video.py]
2026-07-23 feat: implement UDP camera streaming for FPGA, add YOLO feature extraction tools, and establish project documentation.
2026-07-23 feat: implement SCCB master controller and support infrastructure for FPGA camera interface
2026-07-23 vison and control machine learning via stm32
2026-07-23 feat: implement RL control framework with YOLO-based vision processing and STM32 deployment utilities
2026-07-23 WIP before pulling teammates changes
    [audio_model.obj, main.obj]
2026-07-24 pytorch file
    [audio_model.obj, main.obj]
2026-07-25 refactor: modernize architecture by transitioning to STM32 firmware and restructuring host software for modular ML inference and data pipelines.
2026-07-26 Harden audio command gating and fix marker target selection with auto-hold latch
    [main_yolo_marker.py, openvino_dispatcher.py, state_machine.py]
2026-07-26 feat: implement comprehensive ML vision framework and reorganize project structure for model management and inference
2026-07-27 Refactor evaluation scripts and add touch probe functionality
    - Removed obsolete clustering output image file.
    - Enhanced `run_eval_expert.py` with color canonicalization and command processing.
    - Introduced `TouchProbe` class in new `TouchProbe.cpp` and `TouchProbe.h` files for touchscreen data collection.
    - Updated firmware readme to reflect new files and compilation adjustments for STM32.
    - Added `benchmark_model_inference_times.py` for benchmarking YOLO, ResNet, and MLP models.
    - Created `inference_time_summary.json` to store benchmark results.
2026-07-28 feat: update model paths, enhance dataset handling, and improve training scripts for YOLOv8 and MLP corrector
    [main.py, models.py]
2026-07-29 feat: implement main vision-to-serial inference pipeline and ground truth extraction utility
2026-07-29 feat: add ML model training/evaluation scripts, hardware test utilities, and project documentation while cleaning up temporary files and logs.
    [audio_model.obj, main.obj]
2026-07-30 feat: implement inverse kinematics solver and PID host controller software for ML-vision platform
2026-07-30 feat: implement serial communication, motor/aruco testing utilities, and reorganize model directories with boundary updates.
2026-08-01 feat: implement comprehensive ML vision pipeline for ArUco-based tracking, including dataset verification, MLP correction, and ONNX model export tools.
    [audio_receiver_onnx.py, main_onnx_aruco.py, main_onnx_aruco_audio.py, main_pytorch_aruco.py]
2026-08-01 feat: implement host software framework for ML-based vision, audio, and multimodal control systems with comprehensive tooling.
2026-08-04 feat: add ONNX-based ArUco tracking pipeline with platform homography calibration and marker assets
2026-08-11 feat: add experimental vision/audio modules, firmware state machines, and ArUco marker calibration templates
2026-08-18 feat: implement vision-language-action infrastructure, including STM32 firmware controls, multi-model evaluation pipelines, and agent-based project management.
2026-08-20 feat: implement Kalman filter with refined noise parameters and fix telemetry data logging for improved motion control
    [BallBalancingBot.ino, MotorControl.cpp, MotorControl.h, RemoteStepControl.cpp, RemoteStepControl.h, Screen.h]
2026-08-23 feat: implement Kalman filter with Savitzky-Golay noise estimation and add raw sensor telemetry logging
    [state_machine.py]
2026-08-24 update to have full info for linux jetson flash
2026-09-12 feat: add Jetson track 1 software packages, hardware flash scripts, documentation, and Claude agents and skills
2026-09-13 feat: wire up DVC against the home_server MinIO remote for gold-tier data + model weights
    Adopts DVC (dvc[s3]) pointed at the home server's MinIO S3-compatible remote
    (reachable over Tailscale) for the reproducible-artifact tiers: 03_gold,
    03_synthetic_yolo, ml_audio/data, and all current model weight directories
    (ml_vision/models, ml_audio/models, ml_multimodal/models). 01_bronze/02_silver
    deliberately stay outside DVC per the existing tar/zip-per-session policy.
    Also untracks a handful of real model weight/audio files that were previously
    committed directly to git (ml_audio/models, ml_audio/data) instead of following
    the intended gitignore policy, moving them to DVC tracking instead.
    Fix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
    [audio_model.obj, main.obj]
2026-09-15 feat: add Jetson track1 package with marker classifier, runtime scripts, and evaluation utilities
2026-09-15 feat: add Jetson VLA runtime modules, marker classifier, audio fine-tuning notebook, and project logbook
2026-09-15 feat: dvc-track Track 4 Jetson bronze sessions + Qwen2.5-VL-3B checkpoint
    Adds a scoped exception to the bronze-tier DVC exclusion: the 10 Track 4
    session_jetson_track4_* directories (telemetry.csv + rgb_video.mp4 each, 20
    files total) are small and DVC-tracked individually, unlike the ~1M-file bulk
    legacy bronze data the blanket exclusion is otherwise for.
    Also fixes a real .gitignore bug this surfaced: unignoring a file nested
    inside an already directory-excluded path (host_software/data/01_bronze/,
    itself matched by the broader host_software/data/* glob) requires
    un-excluding every ancestor directory on the path, not just the final file --
    git will not descend into an excluded directory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
2026-09-15 docs: document the Track 4 DVC exception, resolve data_collection/data open item
    Closes a real doc-drift gap: docs/DATA_STORAGE.md still said 01_bronze stays
    outside DVC unconditionally, which a fresh dataset audit correctly flagged as
    inconsistent with the Track 4 session .dvc files added this session. Also
    resolves the "host_software/data_collection/data/ never audited" open item --
    that same audit confirmed the directory doesn't exist on this machine.
2026-09-16 Add experimental scripts for marker classification and target evaluation
    - Introduced `marker_classifier_green_fallback_sweep.py` for comparative trials on green S-floor sweep and nearest-hue fallback in marker classification.
    - Added `marker_target_jump_gate_eval.py` to validate the new marker-target jump-gate functionality in `_MarkerPositionFilter`, analyzing target trajectory data.
    - Created `motor_geometry.py` to port step-to-angle conversions from firmware for telemetry processing.
    - Implemented `session_recorder.py` for Track 4 data collection, capturing telemetry and video in a structured format for training purposes.
2026-09-21 Remove obsolete modules and refactor codebase
    - Deleted `receivers.py`, `state_machine.py`, `touch_logger.py`, `utils.py`, and `requirements-jetson-track1.txt` as they are no longer needed.
    - Cleaned up the codebase to improve maintainability and reduce complexity.
    [audio_receiver_onnx.py, receivers.py, run_jetson_standalone.py, session_recorder.py, state_machine.py, touch_logger.py]
2026-09-21 Enhance Jetson environment setup and telemetry logging
    - Updated JETSON_ENV_SETUP.md to clarify the separation of Arm 2 environments from Track 1.
    - Added inference timing to telemetry logging in run_jetson_standalone.py and session_recorder.py for better performance analysis.
    - Introduced a new script, audit_touch_ground_truth_spikes.py, to audit touch-plate telemetry for Dataset 8, including visualizations and summary reporting.
    - Implemented touch_ground_truth_filter.py to detect corrupted touch-plate readings, improving data integrity for both live evaluations and training sessions.
    - Enhanced touch_logger.py to include additional telemetry fields for inference timing and target error ca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
    [AngleStepControl.cpp, AngleStepControl.h, BallBalancingBot.ino, MotorControl.cpp, MotorControl.h, Screen.h]
2026-09-22 Add Jetson AGX Orin environment requirements and coordinate space probe tests
    - Created requirements-jetson-arm2-common.txt for common packages across Arm 2 environments.
    - Added requirements-jetson-arm2-fallback-transformers5.txt for fallback environment with transformers 5.17.0.
    - Established requirements-jetson-arm2.txt for the main environment, pinning transformers to <5 for compatibility.
    - Introduced test_coord_space_probe_mock.py to validate coordinate-space calibration probe functionality using mock backends.
2026-09-22 Add Dockerfiles for Jetson AGX Orin with transformers support
    - Created Dockerfile.arm2-transformers4 for secondary container image using transformers<5, supporting InternVL2.5-4B and Moondream2.
    - Created Dockerfile.arm2-transformers5 for primary container image using transformers==5.17.0, supporting Qwen2.5-VL and PaliGemma2.
    - Added requirements_jetson.txt to specify dependencies for both Docker images.
    - Documented dependency installation process and notes in dependency_on_jetson_notes.md.
